lincvv/kicad_space/Projects/Design/nti/Pi-Zero_Relay/README.md

**Board with relay for Raspberry PI Zero. There is an installation place for the Arduino shield RS-485**

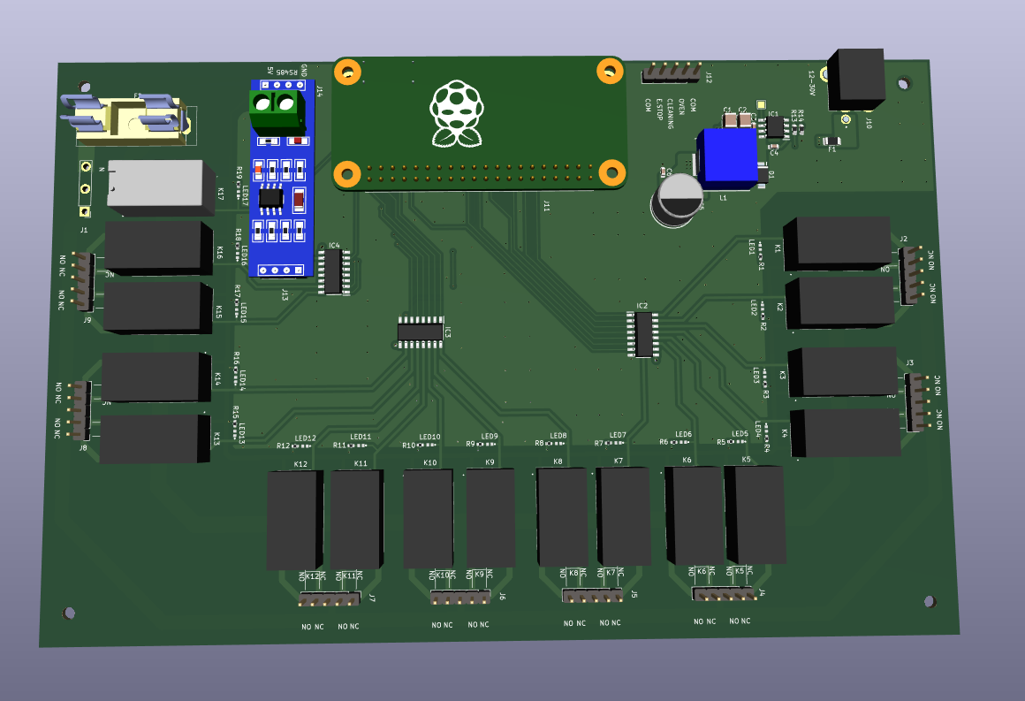
[picture p1: Projects/Design/nti/Pi-Zero_Relay/img/brd.bmp]
image info
