lincvv/kicad_space/Projects/Design/nti/dock_rs232/cfg_sel.png

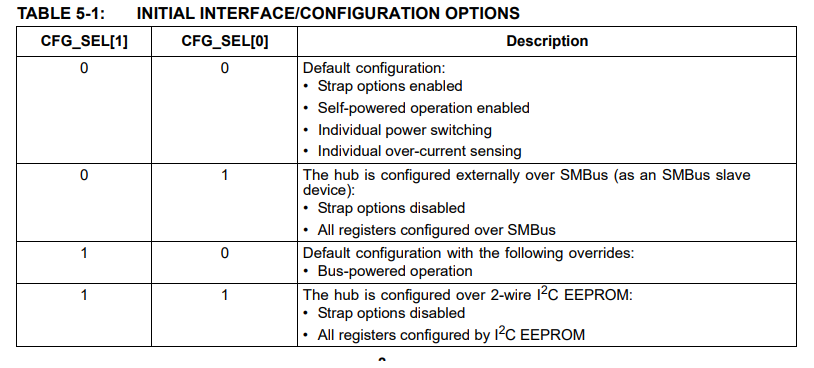
Projects/Design/nti/dock_rs232/cfg_sel.png
