lincvv/kicad_space/Projects/Design/nti/dock_rs232/3D/LAN9500AI-ABZJ.stp

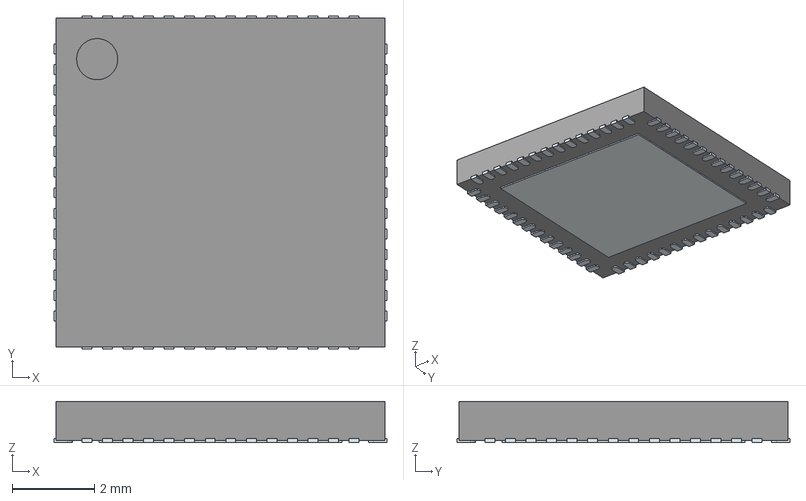
[picture p3: CAD file, 2024-06-23]
Projects/Design/nti/dock_rs232/3D/LAN9500AI-ABZJ.stp
8.10 x 8.10 x 1.00 mm
ThermalPin
PinsArrayLR
PinsArrayTB
