lincvv/kicad_space/Projects/Design/nti/dock_rs232/dock_rs232_v2.step

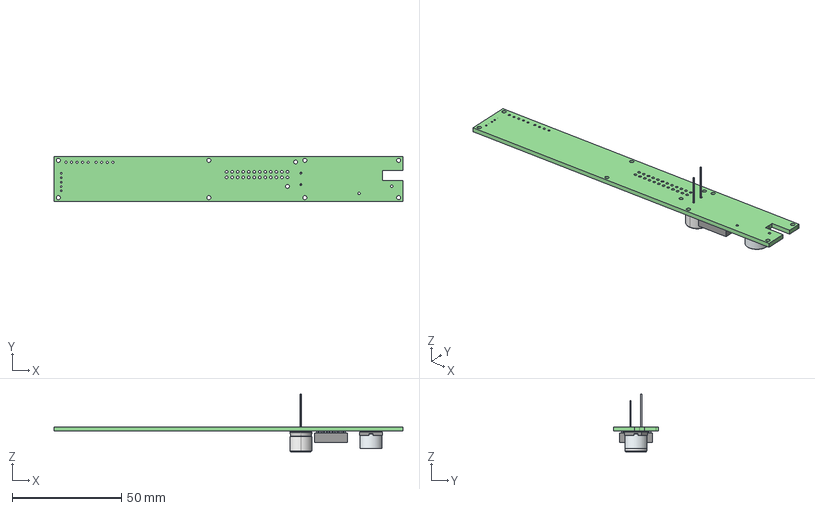
[picture p4: CAD file, 2024-06-23]
Projects/Design/nti/dock_rs232/dock_rs232_v2.step
160.0 x 20.7 x 26.5 mm
dock_rs232 PCB
