lincvv/kicad_space/Resources/lib_kicad/150R_0402_2-1879208-9/2-1879208-9 (# Name clash 2023-07-30 uy7o5mC #).step

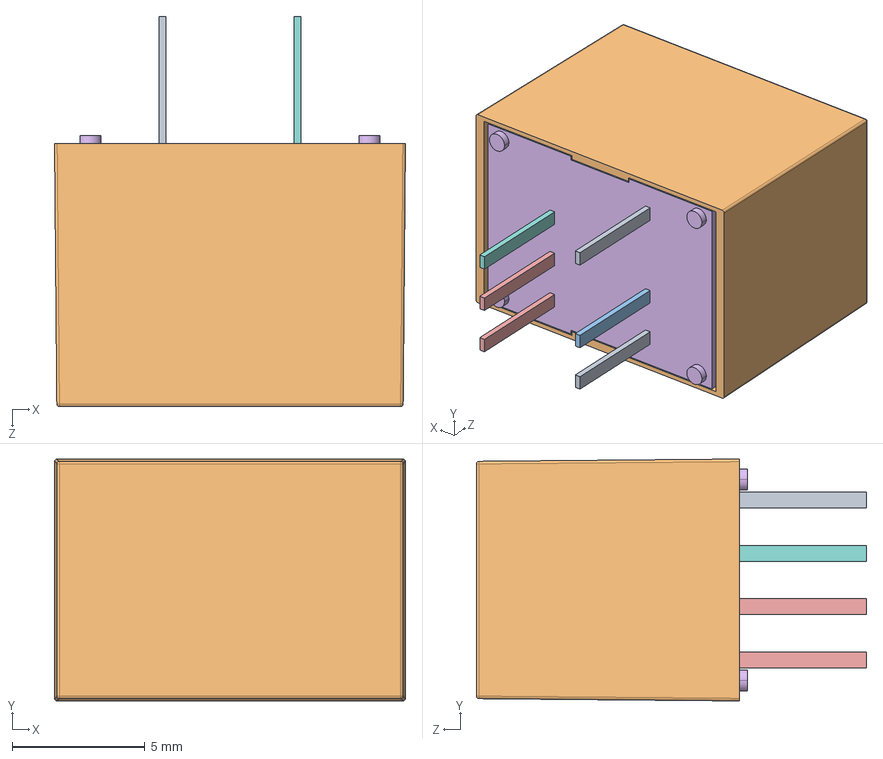
[picture p5: CAD file, 2024-06-23]
Resources/lib_kicad/150R_0402_2-1879208-9/2-1879208-9 (# Name clash 2023-07-30 uy7o5mC #).step
13.2 x 9.10 x 14.7 mm
