lincvv/kicad_space/Resources/lib_kicad/1K_0603_RP73PF1J1K0BTDF/RP73PF1J1K0BTDF (# Name clash 2023-07-30 4vshooC #).step

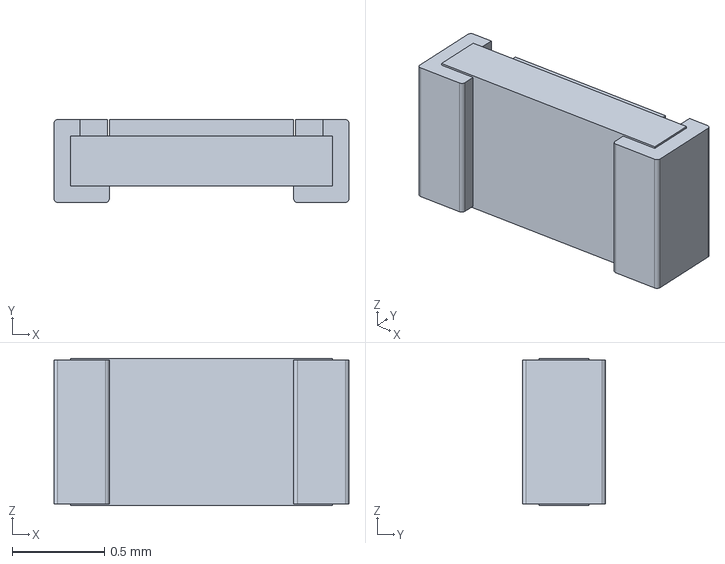
[picture p6: CAD file, 2024-06-23]
Resources/lib_kicad/1K_0603_RP73PF1J1K0BTDF/RP73PF1J1K0BTDF (# Name clash 2023-07-30 4vshooC #).step
1.60 x 0.45 x 0.8 mm
