lincvv/kicad_space/Resources/lib_kicad/3D/115864226-659-atmega328p-au/atmega328p-au (# Name clash 2023-07-30 7z2uxiC #).stp

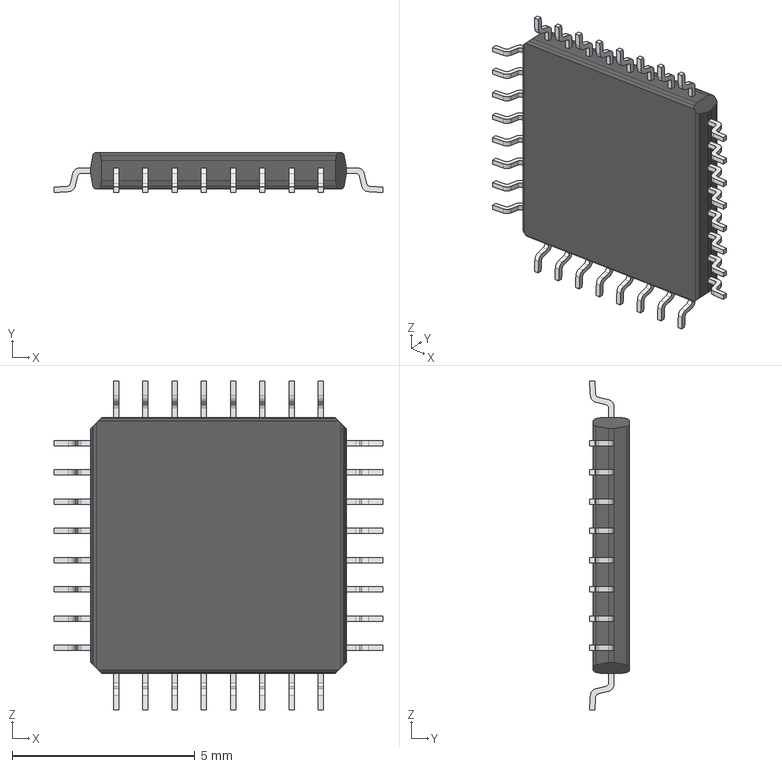
[picture p7: CAD file, 2024-06-23]
Resources/lib_kicad/3D/115864226-659-atmega328p-au/atmega328p-au (# Name clash 2023-07-30 7z2uxiC #).stp
9.00 x 1.10 x 9.00 mm
