lincvv/kicad_space/Resources/lib_kicad/3D/16MHz (# Name clash 2023-07-30 u8vxkbC #).STEP

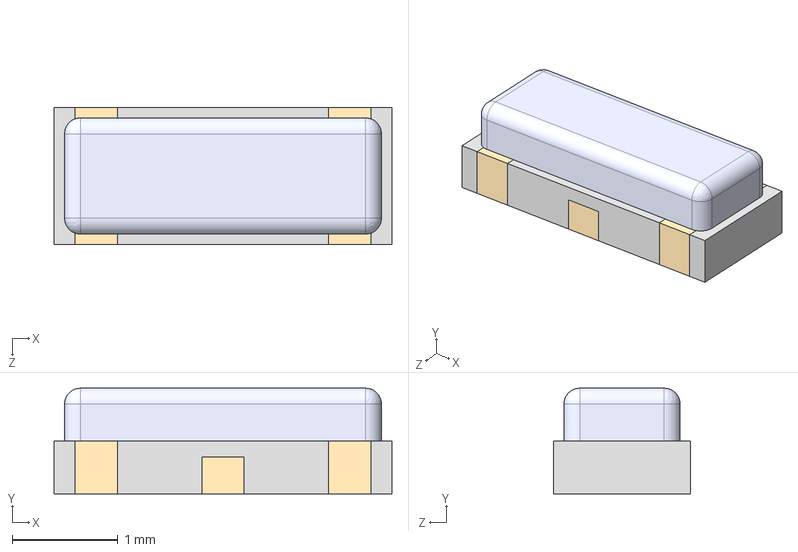
[picture p8: CAD file, 2024-06-23]
Resources/lib_kicad/3D/16MHz (# Name clash 2023-07-30 u8vxkbC #).STEP
3.20 x 1.00 x 1.30 mm
