lincvv/kicad_space/Resources/lib_kicad/3D/DC_POWER_CUI_DEVICES_PJ-079BH/CUI_DEVICES_PJ-079BH (# Name clash 2023-07-30 wrly1wC #).step

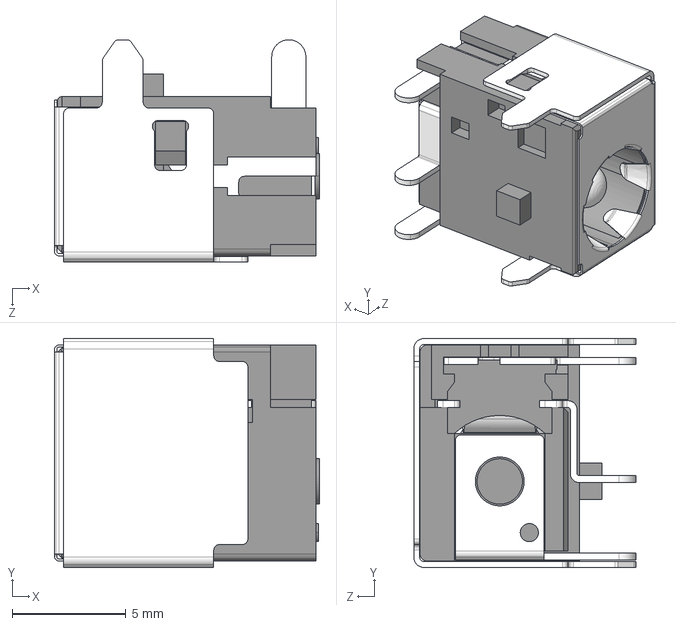
[picture p9: CAD file, 2024-06-23]
Resources/lib_kicad/3D/DC_POWER_CUI_DEVICES_PJ-079BH/CUI_DEVICES_PJ-079BH (# Name clash 2023-07-30 wrly1wC #).step
11.6 x 10.1 x 9.78 mm
