lincvv/kicad_space/Resources/lib_kicad/3D/ISP_6P/2-1761603-1 (# Name clash 2023-07-30 458dh9C #).stp

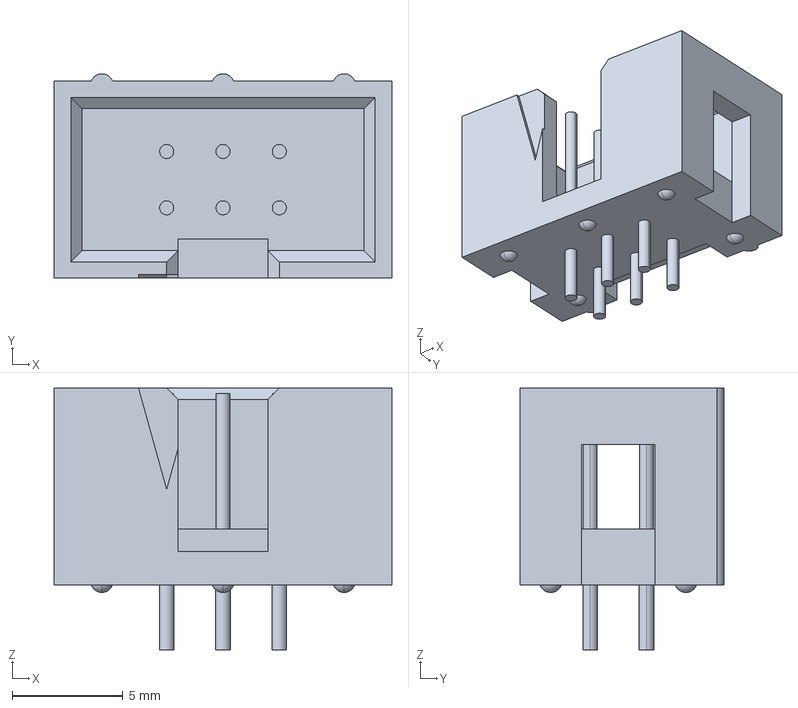
[picture p10: CAD file, 2024-06-23]
Resources/lib_kicad/3D/ISP_6P/2-1761603-1 (# Name clash 2023-07-30 458dh9C #).stp
15.2 x 9.22 x 11.8 mm
