lincvv/kicad_space/Resources/lib_kicad/62R_0402_RC0402FR-0762RL/RC0402FR-0762RL (# Name clash 2023-07-30 fygttrC #).step

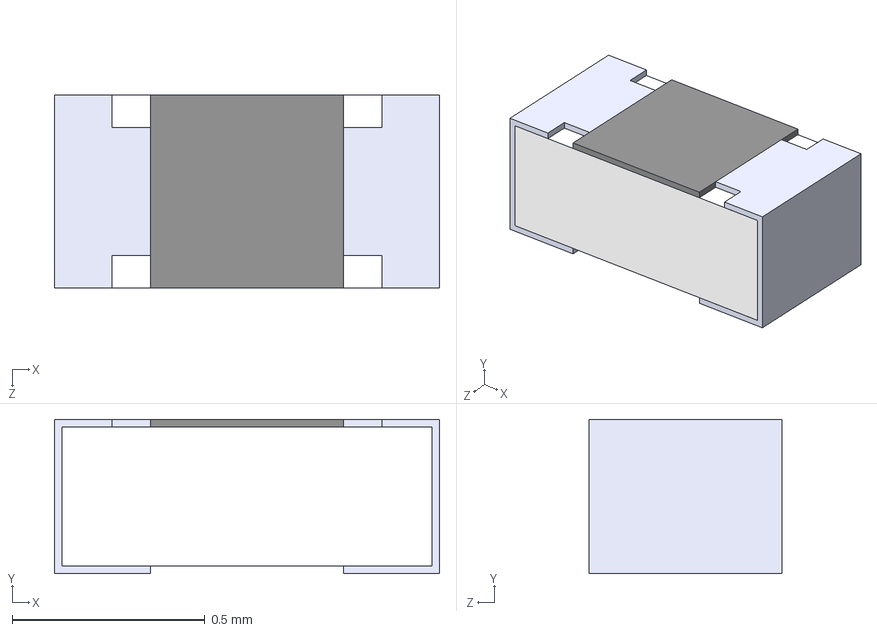
[picture p11: CAD file, 2024-06-23]
Resources/lib_kicad/62R_0402_RC0402FR-0762RL/RC0402FR-0762RL (# Name clash 2023-07-30 fygttrC #).step
1 x 0.4 x 0.5 mm
