lincvv/kicad_space/Resources/lib_kicad/FERRITE/FBead_Murata_BLM21PG221SN1D/eec.models/Murata_-_BLM21PG221SN1D (# Name clash 2023-07-30 t4pligC #).step

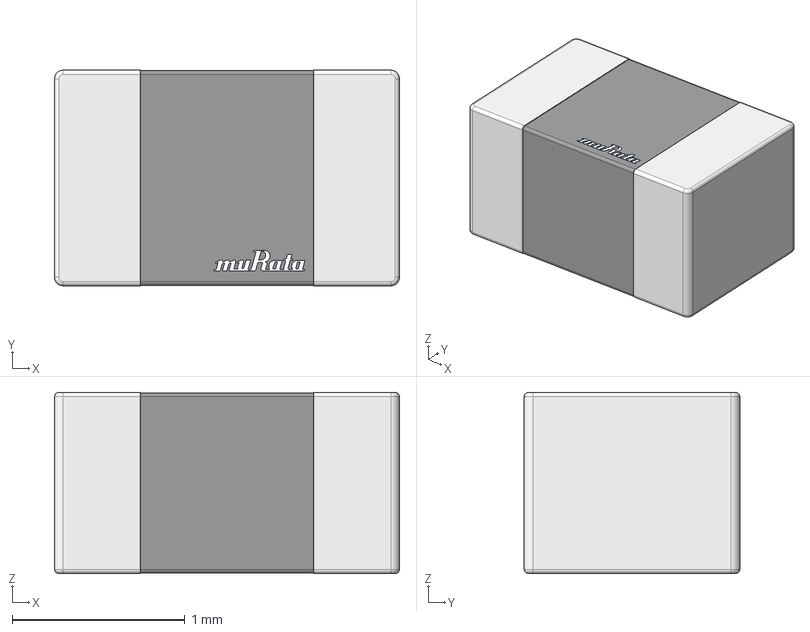
[picture p12: CAD file, 2024-06-23]
Resources/lib_kicad/FERRITE/FBead_Murata_BLM21PG221SN1D/eec.models/Murata_-_BLM21PG221SN1D (# Name clash 2023-07-30 t4pligC #).step
2.00 x 1.25 x 1.05 mm
Electrodes
Dielectric
Murata
