lincvv/kicad_space/Resources/lib_kicad/HJR-4102-L-05V/HJR-4102-L-05V (# Name clash 2023-07-30 9vtmwmC #).step

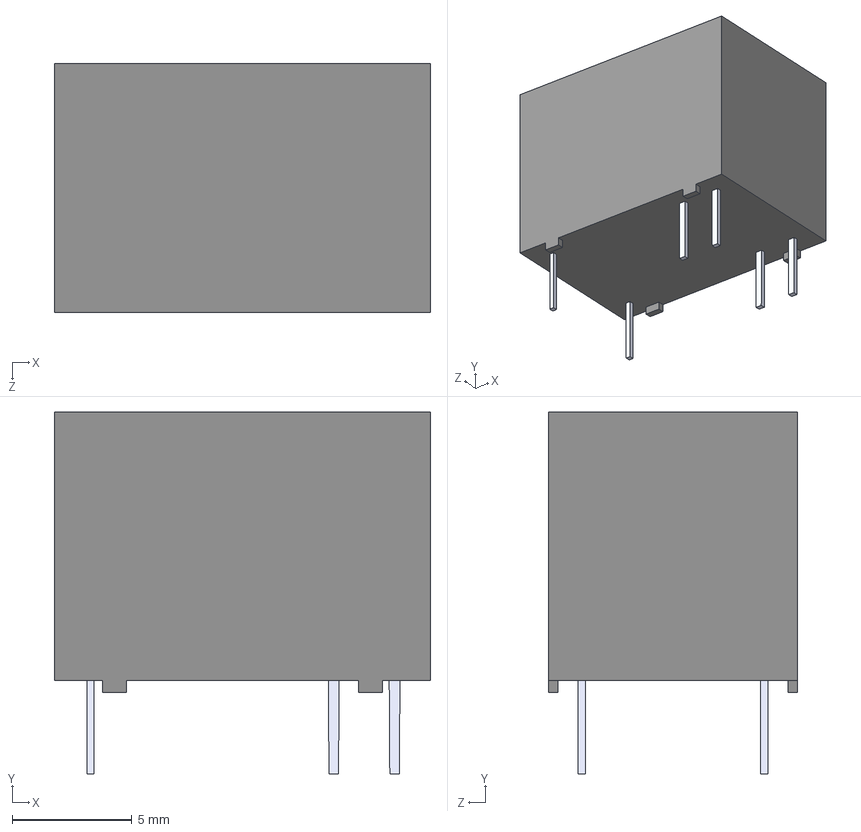
[picture p13: CAD file, 2024-06-23]
Resources/lib_kicad/HJR-4102-L-05V/HJR-4102-L-05V (# Name clash 2023-07-30 9vtmwmC #).step
15.7 x 15.1 x 10.4 mm
