lincvv/kicad_space/Resources/lib_kicad/LED/ul_IN-S42BT5G/LED_IN-S42_INL (# Name clash 2023-07-30 bcv8teC #).step

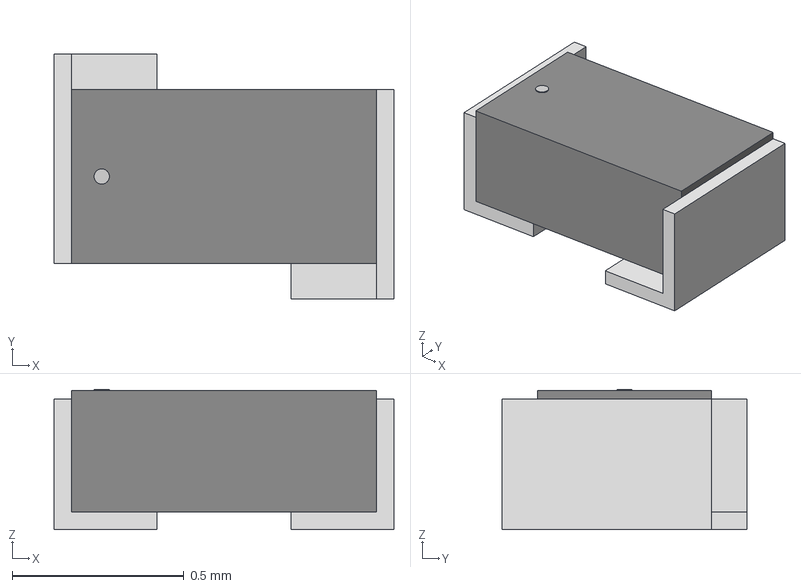
[picture p14: CAD file, 2024-06-23]
Resources/lib_kicad/LED/ul_IN-S42BT5G/LED_IN-S42_INL (# Name clash 2023-07-30 bcv8teC #).step
0.99 x 0.712 x 0.409 mm
