lincvv/kicad_space/Resources/lib_kicad/OSCIL/ABM8G-25.000MHZ-4Y-T3--3DModel-STEP-400430 (# Name clash 2023-07-30 odzbttC #).STEP

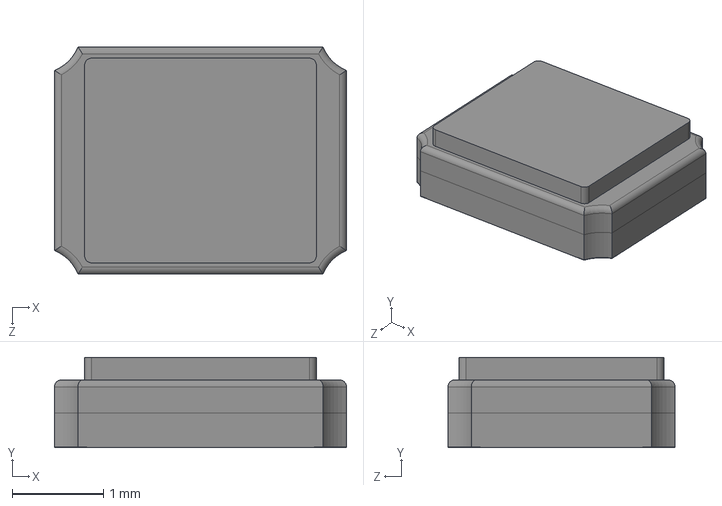
[picture p15: CAD file, 2024-06-23]
Resources/lib_kicad/OSCIL/ABM8G-25.000MHZ-4Y-T3--3DModel-STEP-400430 (# Name clash 2023-07-30 odzbttC #).STEP
3.20 x 0.991 x 2.49 mm
