lincvv/kicad_space/Resources/lib_kicad/RLS-126/RLS-126 (# Name clash 2023-07-30 chmixkC #).step

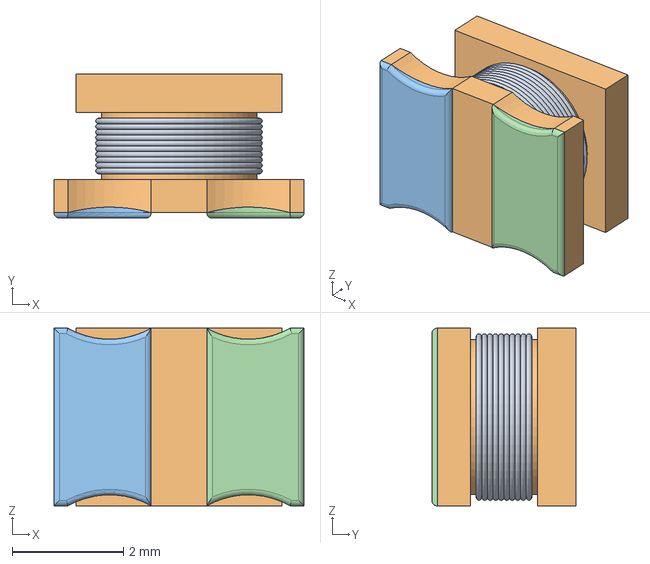
[picture p16: CAD file, 2024-06-23]
Resources/lib_kicad/RLS-126/RLS-126 (# Name clash 2023-07-30 chmixkC #).step
4.50 x 2.60 x 3.20 mm
