lincvv/kicad_space/Projects/Design/nti/dock_rs232/3D/EG1247.stp

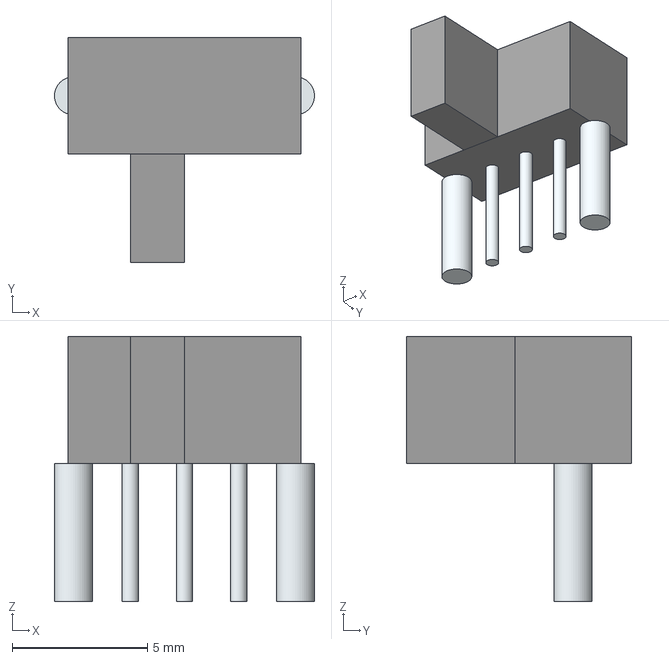
[picture p17: CAD file, 2024-06-23]
Projects/Design/nti/dock_rs232/3D/EG1247.stp
9.60 x 8.30 x 9.80 mm
Leads x 5
