lincvv/kicad_space/Projects/Design/nti/dock_rs232/dock_usb2.step

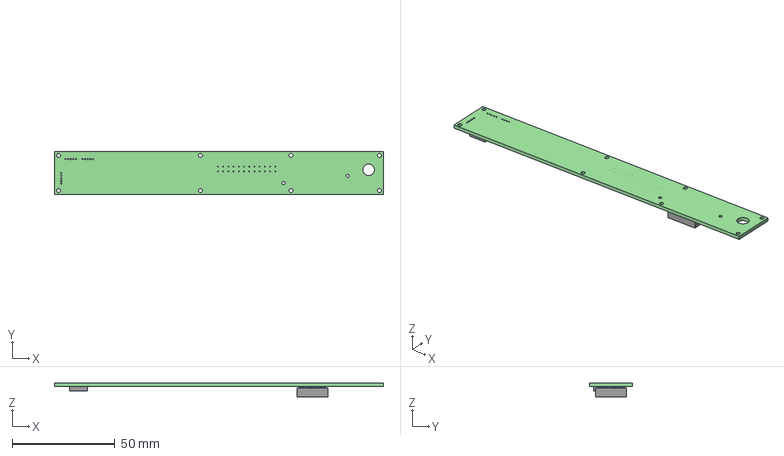
[picture p18: CAD file, 2024-06-23]
Projects/Design/nti/dock_rs232/dock_usb2.step
160.0 x 20.7 x 6.77 mm
dock_rs232 PCB
