lincvv/kicad_space/Projects/Design/nti/dock_rs232/3D/HX0068ANL.stp

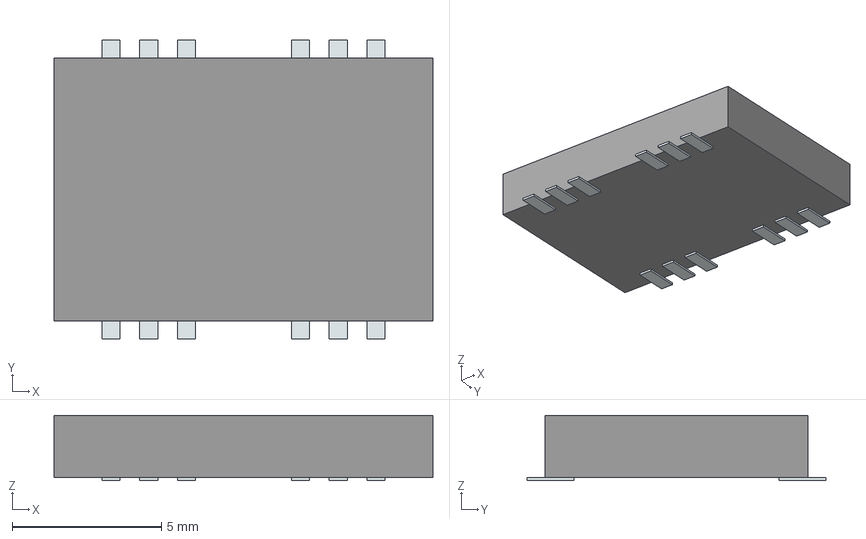
[picture p19: CAD file, 2024-06-23]
Projects/Design/nti/dock_rs232/3D/HX0068ANL.stp
12.7 x 10.0 x 2.18 mm
Pins
