lincvv/kicad_space/Projects/Design/nti/dock_rs232/dock_rs232.step

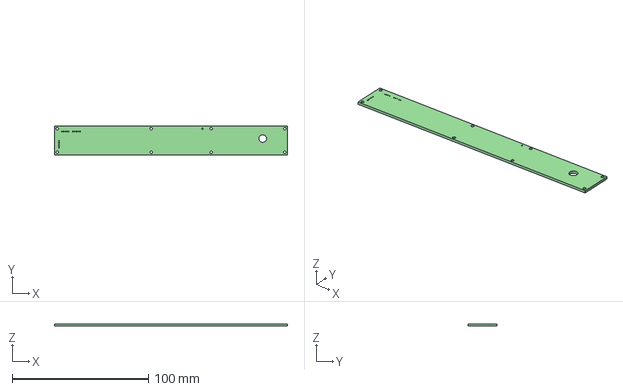
[picture p20: CAD file, 2024-06-23]
Projects/Design/nti/dock_rs232/dock_rs232.step
171.0 x 21.0 x 1.60 mm
