lincvv/kicad_space/Resources/lib_kicad/3D/C_1206_22uF (# Name clash 2023-07-30 kaz8xrC #).STEP

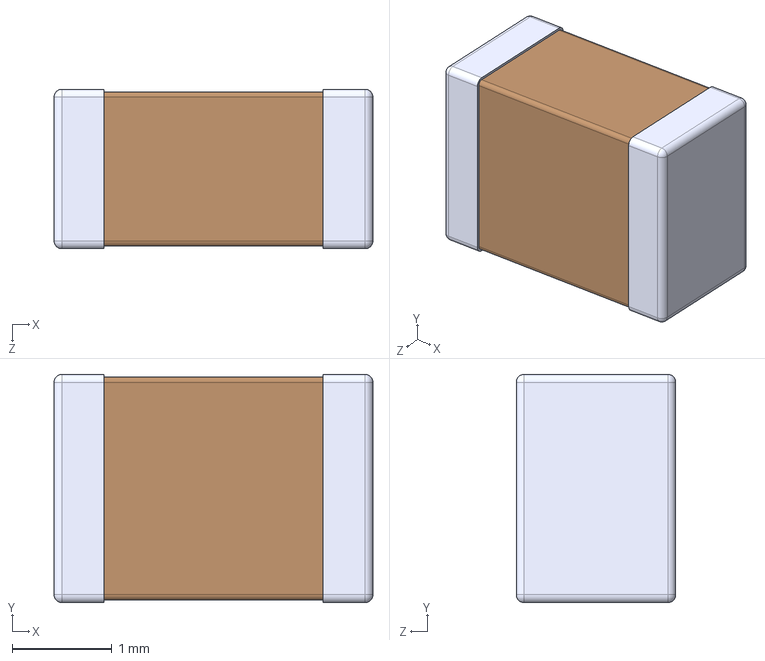
[picture p21: CAD file, 2024-06-23]
Resources/lib_kicad/3D/C_1206_22uF (# Name clash 2023-07-30 kaz8xrC #).STEP
3.20 x 2.29 x 1.60 mm
