lincvv/kicad_space/Projects/Design/nti/dock_rs232/3D/ECMF02-2AMX6.stp

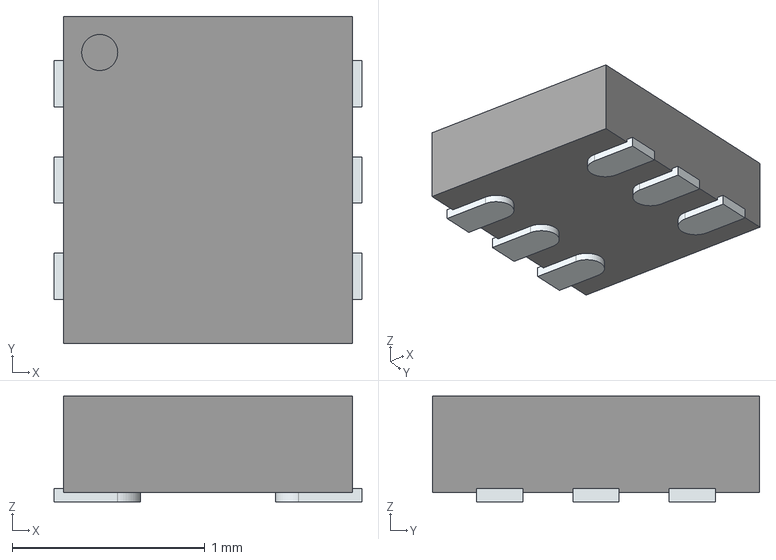
[picture p22: CAD file, 2024-06-23]
Projects/Design/nti/dock_rs232/3D/ECMF02-2AMX6.stp
1.60 x 1.70 x 0.55 mm
PinsArrayLR
