lincvv/kicad_space/Projects/Design/nti/dock_rs232/dock_rs232_fix.step

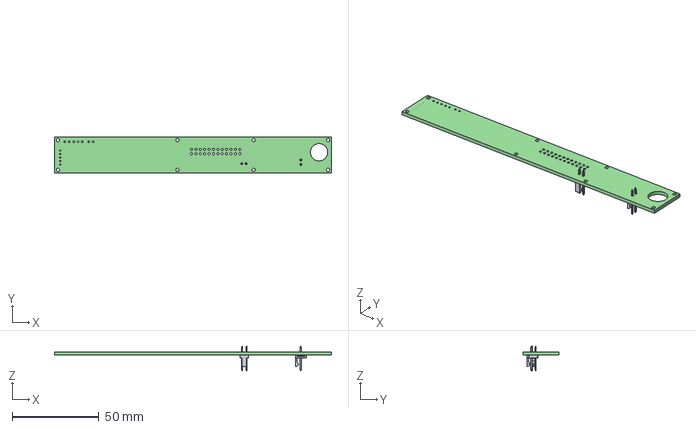
[picture p23: CAD file, 2024-06-23]
Projects/Design/nti/dock_rs232/dock_rs232_fix.step
160.0 x 20.7 x 14.2 mm
dock_rs232 PCB
