lincvv/kicad_space/Resources/lib_kicad/3D/10pF_+-1%_0603N100F101CT (# Name clash 2023-07-30 6atzm4C #).stp

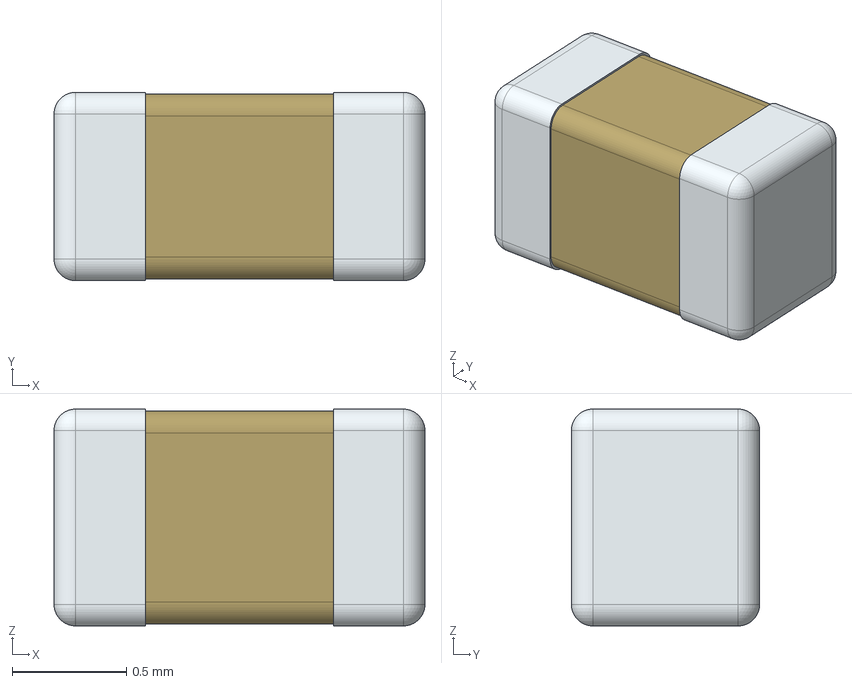
[picture p24: CAD file, 2024-06-23]
Resources/lib_kicad/3D/10pF_+-1%_0603N100F101CT (# Name clash 2023-07-30 6atzm4C #).stp
1.62 x 0.825 x 0.95 mm
