lincvv/kicad_space/Projects/Design/nti/dock_rs232/3D/CP2102N-A02-GQFN20.stp

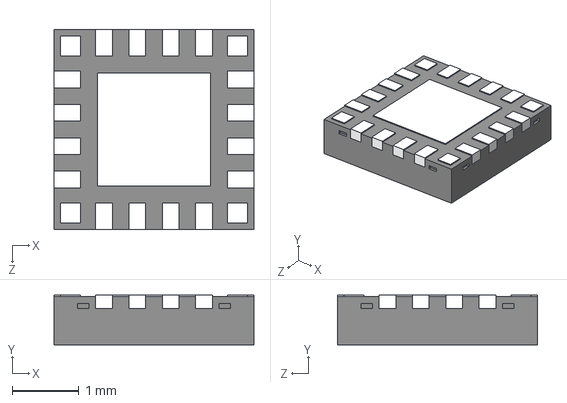
[picture p25: CAD file, 2024-06-23]
Projects/Design/nti/dock_rs232/3D/CP2102N-A02-GQFN20.stp
3.00 x 0.75 x 3.00 mm
