lincvv/kicad_space/Resources/lib_kicad/3D/ADUM1311ARWZ (# Name clash 2023-07-30 m2vc11C #).stp

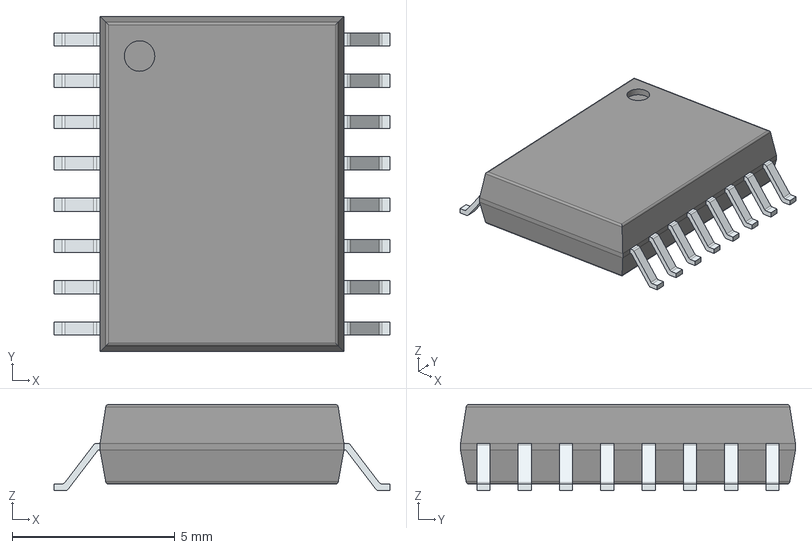
[picture p26: CAD file, 2024-06-23]
Resources/lib_kicad/3D/ADUM1311ARWZ (# Name clash 2023-07-30 m2vc11C #).stp
10.3 x 10.3 x 2.65 mm
PinsArrayLR
