lincvv/kicad_space/Projects/Design/nti/dock_rs232/3D/AP3441SHE-7B.stp

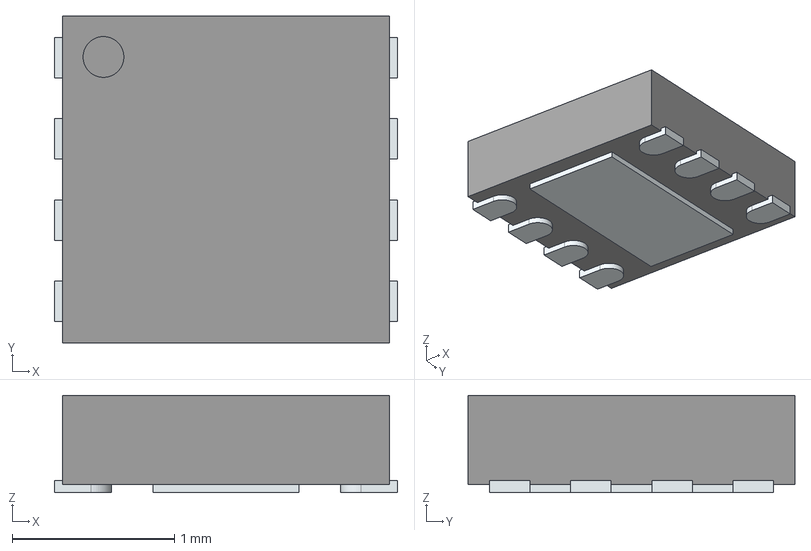
[picture p27: CAD file, 2024-06-23]
Projects/Design/nti/dock_rs232/3D/AP3441SHE-7B.stp
2.11 x 2.01 x 0.6 mm
ThermalPin
PinsArrayLR
