lincvv/kicad_space/Resources/lib_kicad/3D/10pF_+-0.25_CL10C100CB8NNNC (# Name clash 2023-07-30 huij25C #).stp

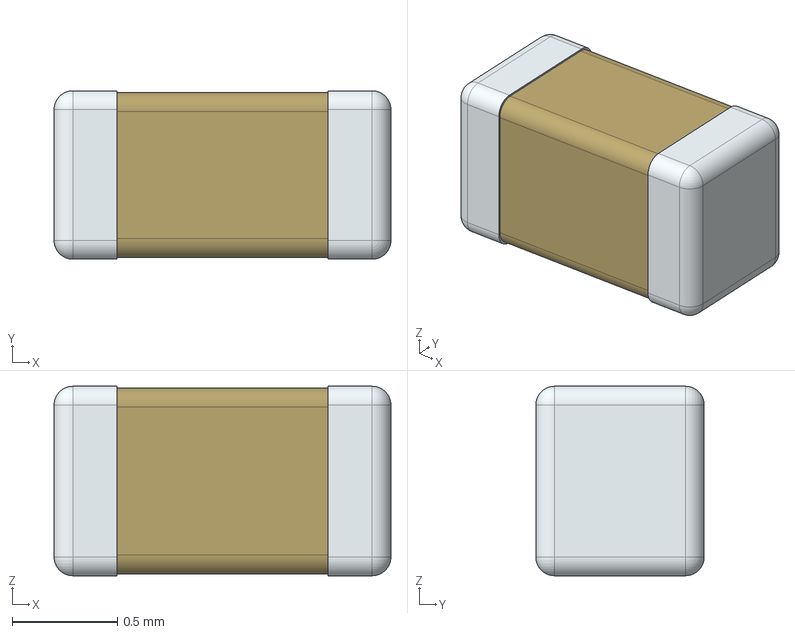
[picture p28: CAD file, 2024-06-23]
Resources/lib_kicad/3D/10pF_+-0.25_CL10C100CB8NNNC (# Name clash 2023-07-30 huij25C #).stp
1.60 x 0.8 x 0.9 mm
