lincvv/kicad_space/Projects/Design/nti/dock_rs232/3D/USB2514B_M2.stp

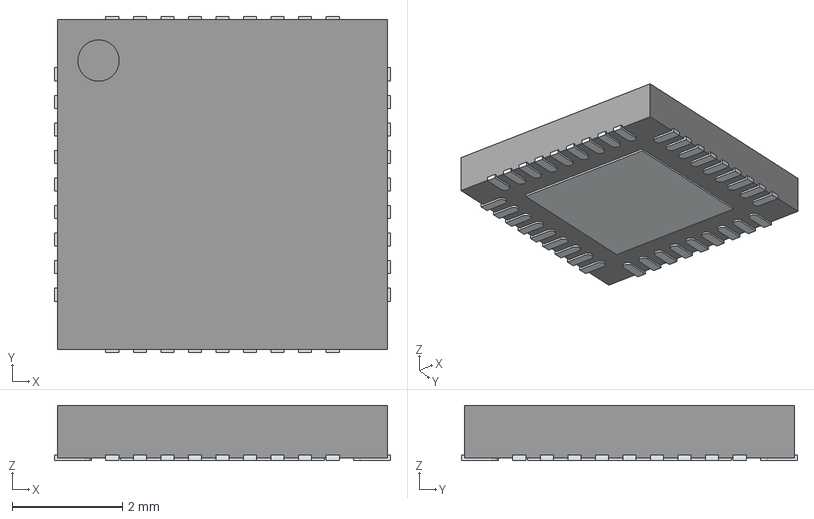
[picture p29: CAD file, 2024-06-23]
Projects/Design/nti/dock_rs232/3D/USB2514B_M2.stp
6.10 x 6.10 x 1.00 mm
ThermalPin
PinsArrayLR
PinsArrayTB
