lincvv/kicad_space/Resources/lib_kicad/3D/ENC28J60_SS (# Name clash 2023-07-30 c231e3C #).stp

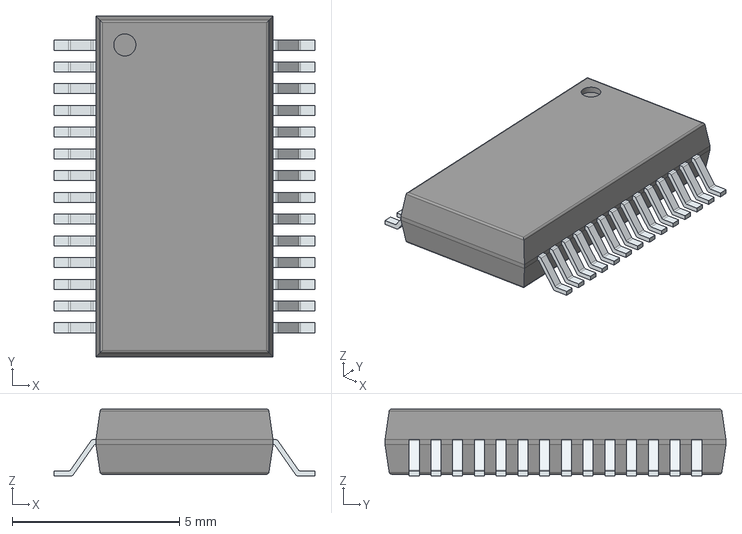
[picture p30: CAD file, 2024-06-23]
Resources/lib_kicad/3D/ENC28J60_SS (# Name clash 2023-07-30 c231e3C #).stp
7.80 x 10.2 x 2.00 mm
PinsArrayLR
