lincvv/kicad_space/Projects/Design/nti/dock_rs232/3D/XF2M-5015-1A.stp

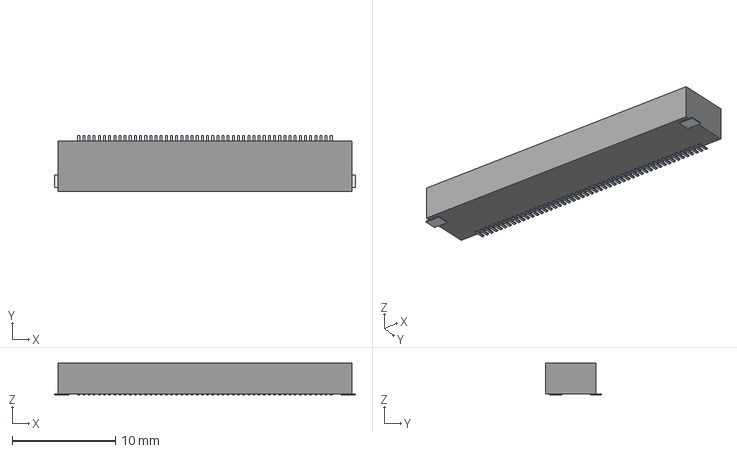
[picture p31: CAD file, 2024-06-23]
Projects/Design/nti/dock_rs232/3D/XF2M-5015-1A.stp
29.2 x 5.41 x 3.10 mm
Pins
