lincvv/kicad_space/Resources/lib_kicad/3D/RJ45_HR911105A (# Name clash 2023-07-30 cutkd2C #).stp

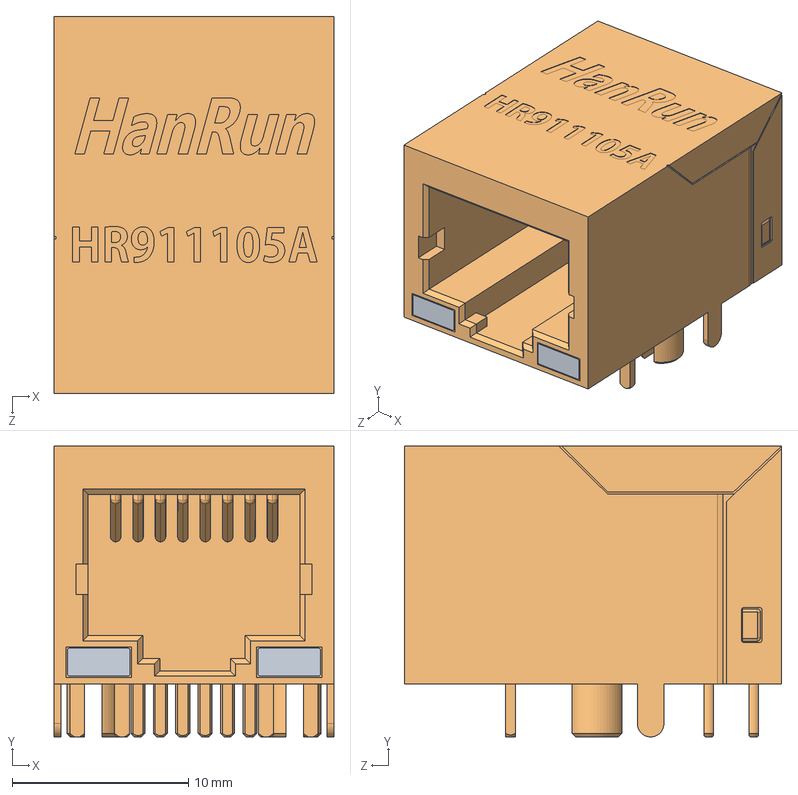
[picture p32: CAD file, 2024-06-23]
Resources/lib_kicad/3D/RJ45_HR911105A (# Name clash 2023-07-30 cutkd2C #).stp
15.9 x 16.5 x 21.4 mm
