lincvv/kicad_space/Projects/Design/nti/dock_rs232/3D/FFC2B29-50-G.stp

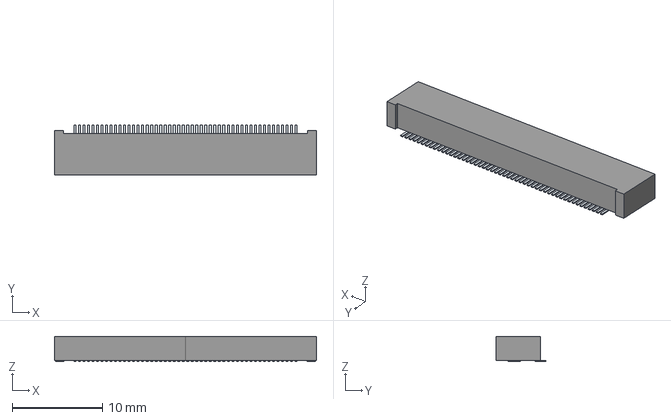
[picture p33: CAD file, 2024-06-23]
Projects/Design/nti/dock_rs232/3D/FFC2B29-50-G.stp
29.1 x 5.52 x 2.80 mm
Pins
