lincvv/kicad_space/Resources/lib_kicad/3D/10pF_0402_GCQ1555C1H100FB01D (# Name clash 2023-07-30 53fqluC #).stp

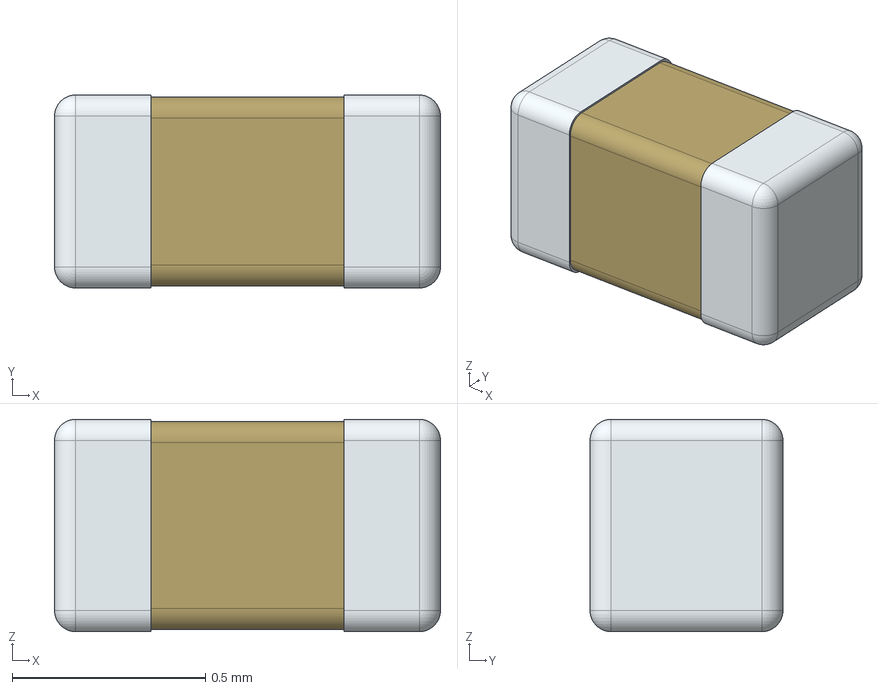
[picture p34: CAD file, 2024-06-23]
Resources/lib_kicad/3D/10pF_0402_GCQ1555C1H100FB01D (# Name clash 2023-07-30 53fqluC #).stp
1.00 x 0.5 x 0.55 mm
