lincvv/kicad_space/Resources/lib_kicad/3D/ADUM5241ARZ (# Name clash 2023-07-30 sx27uvC #).stp

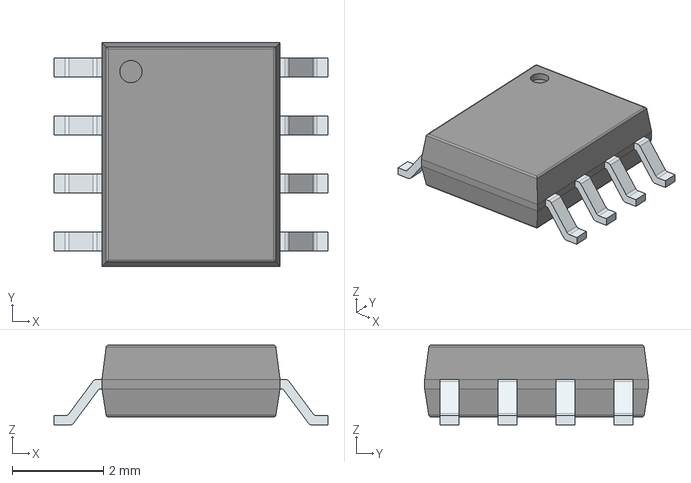
[picture p35: CAD file, 2024-06-23]
Resources/lib_kicad/3D/ADUM5241ARZ (# Name clash 2023-07-30 sx27uvC #).stp
6.00 x 4.90 x 1.75 mm
PinsArrayLR
