lincvv/kicad_space/Resources/lib_kicad/3D/L_1812 (# Name clash 2023-07-30 ckcu9pC #).STEP

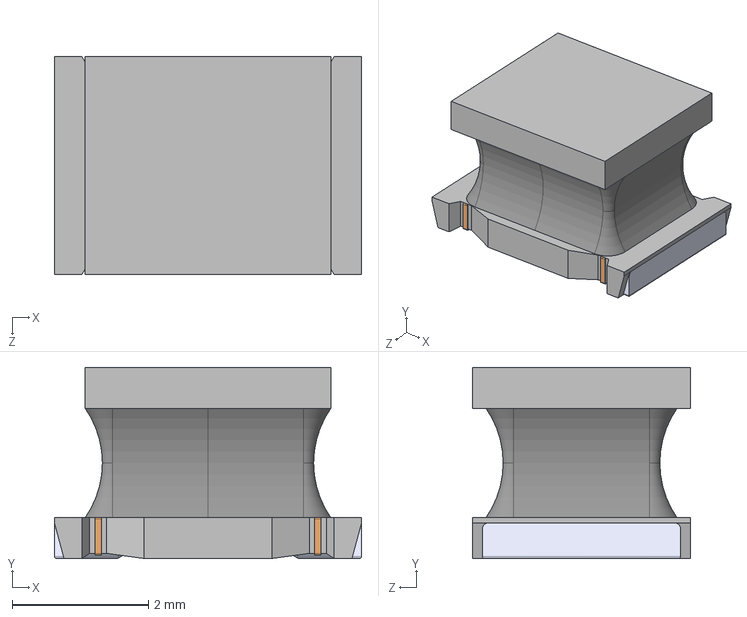
[picture p36: CAD file, 2024-06-23]
Resources/lib_kicad/3D/L_1812 (# Name clash 2023-07-30 ckcu9pC #).STEP
4.50 x 2.80 x 3.20 mm
