lincvv/kicad_space/Resources/lib_kicad/3D/10uF_1206 (# Name clash 2023-07-30 c13143C #).STEP

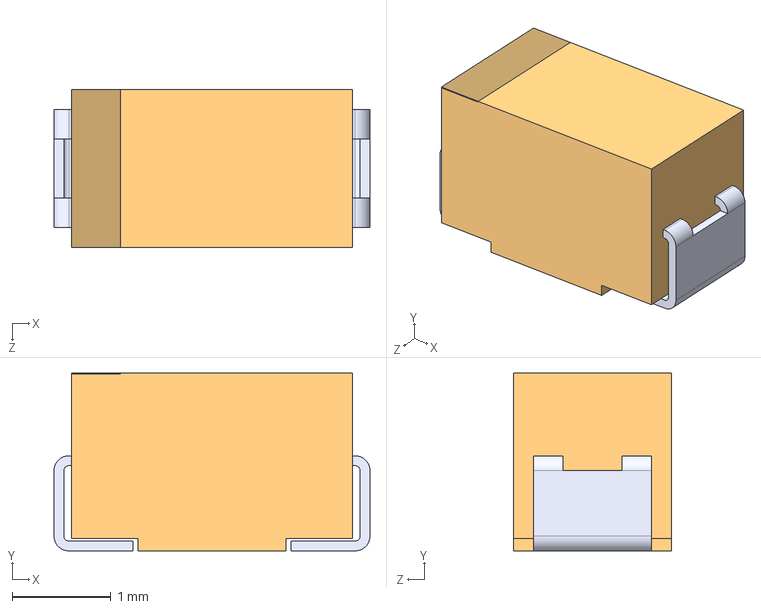
[picture p37: CAD file, 2024-06-23]
Resources/lib_kicad/3D/10uF_1206 (# Name clash 2023-07-30 c13143C #).STEP
3.20 x 1.80 x 1.60 mm
