lincvv/kicad_space/Resources/lib_kicad/3D/LM1086IS-5.0 (# Name clash 2023-07-30 idh75aC #).STEP

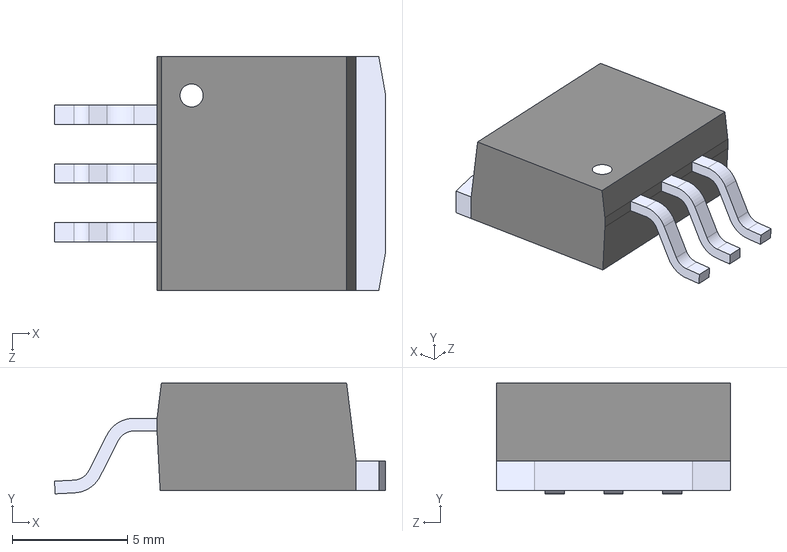
[picture p38: CAD file, 2024-06-23]
Resources/lib_kicad/3D/LM1086IS-5.0 (# Name clash 2023-07-30 idh75aC #).STEP
14.4 x 4.80 x 10.2 mm
