lincvv/kicad_space/Resources/lib_kicad/3D/25MHZ_ABM8G-25.000MHZ-B4Y-T (# Name clash 2023-07-30 5p8k1hC #).stp

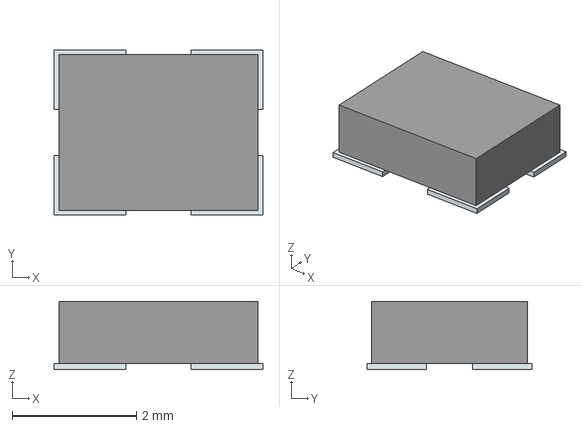
[picture p39: CAD file, 2024-06-23]
Resources/lib_kicad/3D/25MHZ_ABM8G-25.000MHZ-B4Y-T (# Name clash 2023-07-30 5p8k1hC #).stp
3.36 x 2.66 x 1.10 mm
Pins
