lincvv/kicad_space/Resources/lib_kicad/3D/10uF_25V_tantal (# Name clash 2023-07-30 8dxuweC #).STEP

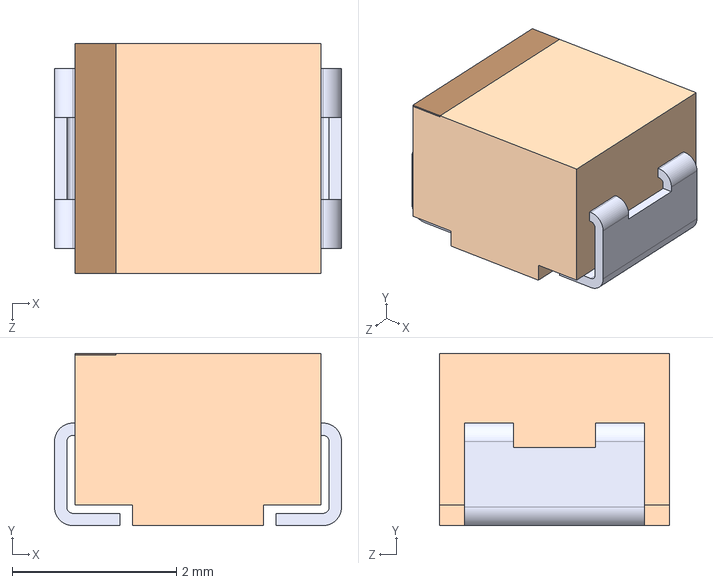
[picture p40: CAD file, 2024-06-23]
Resources/lib_kicad/3D/10uF_25V_tantal (# Name clash 2023-07-30 8dxuweC #).STEP
3.50 x 2.10 x 2.80 mm
