lincvv/kicad_space/Resources/lib_kicad/3D/R2_0805 (# Name clash 2023-07-30 clio78C #).STEP

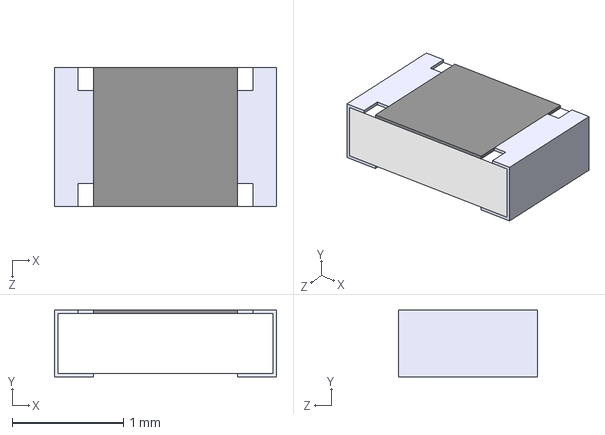
[picture p41: CAD file, 2024-06-23]
Resources/lib_kicad/3D/R2_0805 (# Name clash 2023-07-30 clio78C #).STEP
2.00 x 0.6 x 1.25 mm
