lincvv/kicad_space/Resources/lib_kicad/3D/C_0805 (# Name clash 2023-07-30 3z65rbC #).STEP

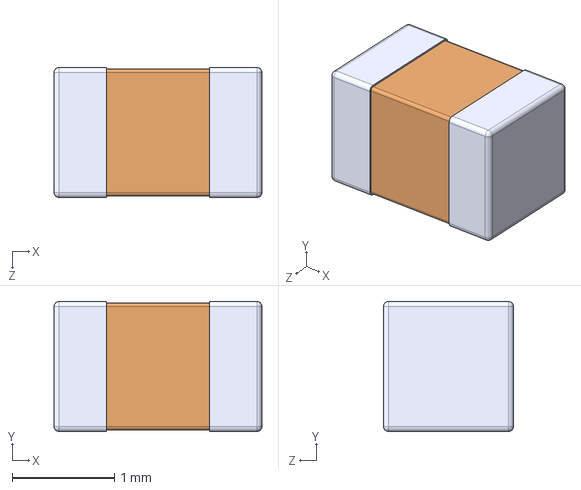
[picture p42: CAD file, 2024-06-23]
Resources/lib_kicad/3D/C_0805 (# Name clash 2023-07-30 3z65rbC #).STEP
2.03 x 1.27 x 1.27 mm
