lincvv/kicad_space/Resources/lib_kicad/3D/Optoisolator_PC81713NIP0X (# Name clash 2023-07-30 beo58lC #).STEP

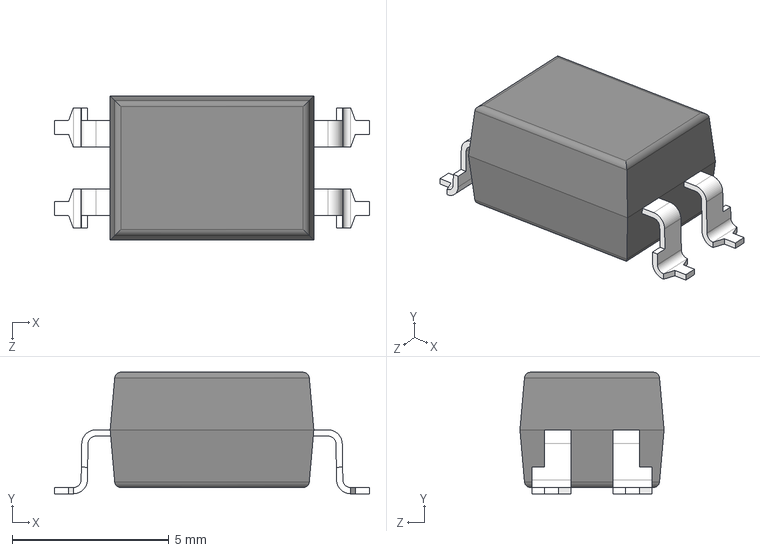
[picture p43: CAD file, 2024-06-23]
Resources/lib_kicad/3D/Optoisolator_PC81713NIP0X (# Name clash 2023-07-30 beo58lC #).STEP
10.1 x 3.88 x 4.60 mm
