lincvv/kicad_space/Resources/lib_kicad/3D/100nF_0402 (# Name clash 2023-07-30 k8wrhxC #).STEP

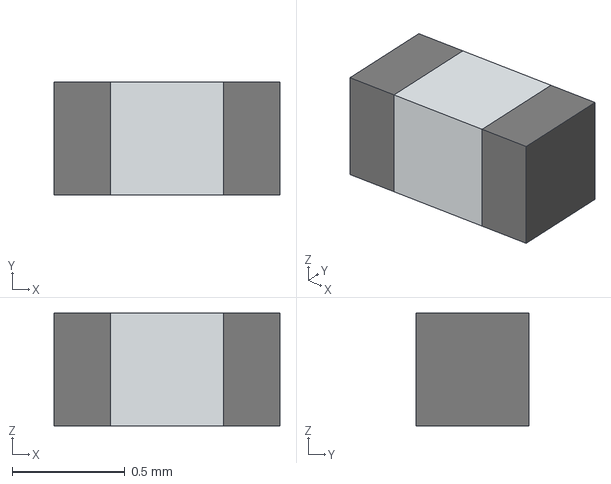
[picture p44: CAD file, 2024-06-23]
Resources/lib_kicad/3D/100nF_0402 (# Name clash 2023-07-30 k8wrhxC #).STEP
1.00 x 0.5 x 0.5 mm
Body_1.0x0.5x0.5x0.25
Contact_0.5x0.5x0.25 x 2
