lincvv/kicad_space/Resources/lib_kicad/3D/LED_0603--3DModel-STEP-56544 (# Name clash 2023-07-30 e95iosC #).STEP

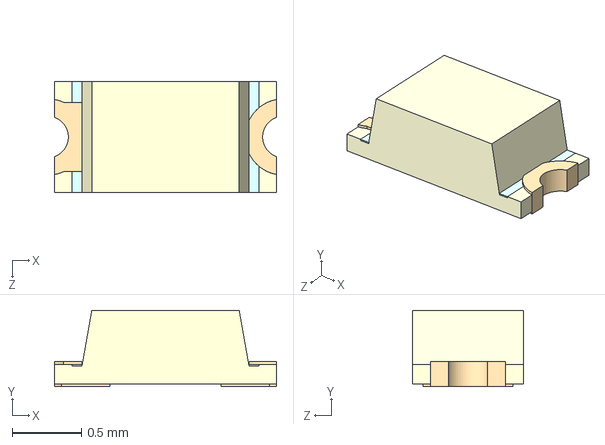
[picture p45: CAD file, 2024-06-23]
Resources/lib_kicad/3D/LED_0603--3DModel-STEP-56544 (# Name clash 2023-07-30 e95iosC #).STEP
1.60 x 0.55 x 0.8 mm
