lincvv/kicad_space/Resources/lib_kicad/3D/L_3131 (# Name clash 2023-07-30 mwrzmkC #).STEP

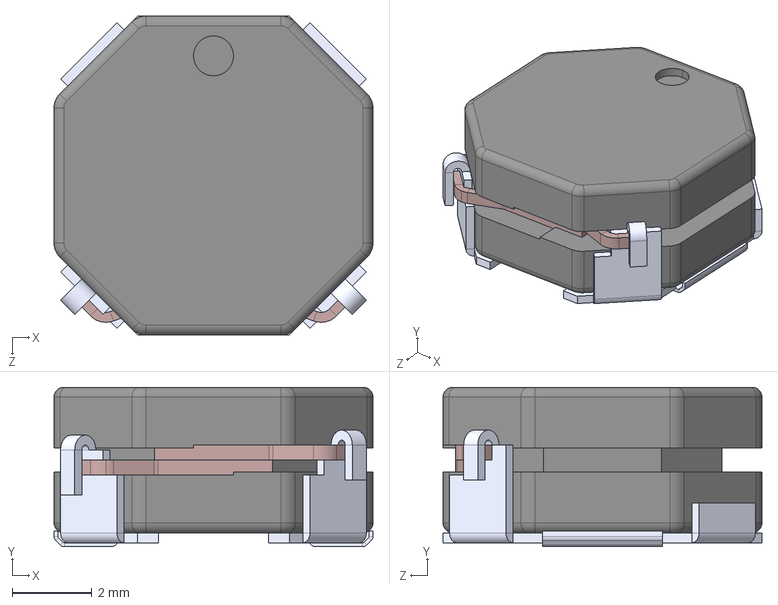
[picture p46: CAD file, 2024-06-23]
Resources/lib_kicad/3D/L_3131 (# Name clash 2023-07-30 mwrzmkC #).STEP
8.00 x 4.00 x 8.00 mm
