lincvv/kicad_space/Resources/lib_kicad/3D/R1SE-0505-R (# Name clash 2023-07-30 m4vhj5C #).STEP

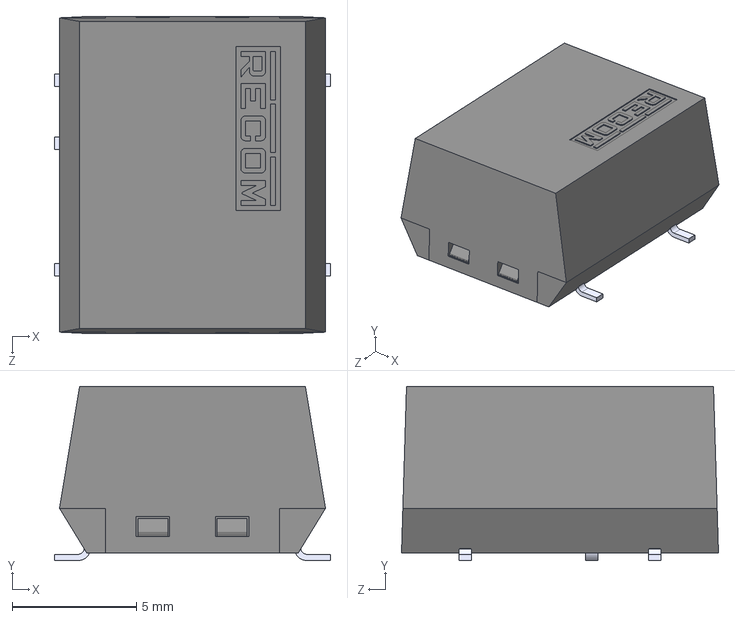
[picture p47: CAD file, 2024-06-23]
Resources/lib_kicad/3D/R1SE-0505-R (# Name clash 2023-07-30 m4vhj5C #).STEP
11.1 x 7.00 x 12.8 mm
