lincvv/kicad_space/Resources/lib_kicad/3D/FTSH-105-01-F-DV-K-A-TR (# Name clash 2023-07-30 jrbe6kC #).stp

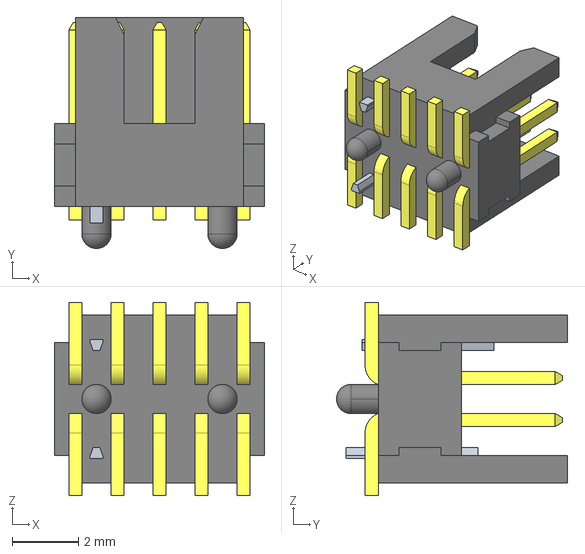
[picture p48: CAD file, 2024-06-23]
Resources/lib_kicad/3D/FTSH-105-01-F-DV-K-A-TR (# Name clash 2023-07-30 jrbe6kC #).stp
6.35 x 6.98 x 5.84 mm
