lincvv/kicad_space/Resources/lib_kicad/3D/MAX485ESA (# Name clash 2023-07-30 55kb8pC #).STEP

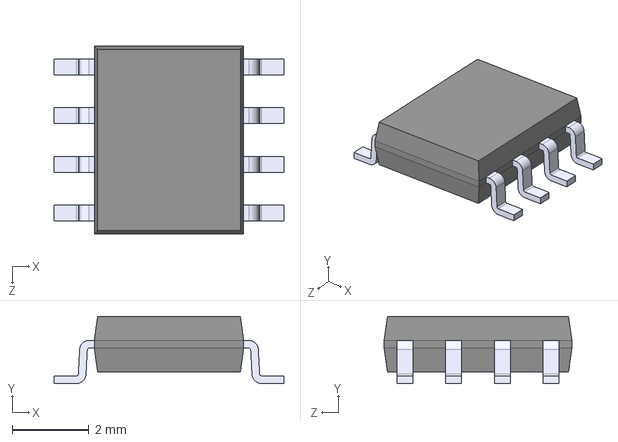
[picture p49: CAD file, 2024-06-23]
Resources/lib_kicad/3D/MAX485ESA (# Name clash 2023-07-30 55kb8pC #).STEP
6.00 x 1.75 x 4.90 mm
