lincvv/kicad_space/Resources/lib_kicad/3D/10pF_50V_GQM1885C1H100RB01D (# Name clash 2023-07-30 hl0d0eC #).STEP

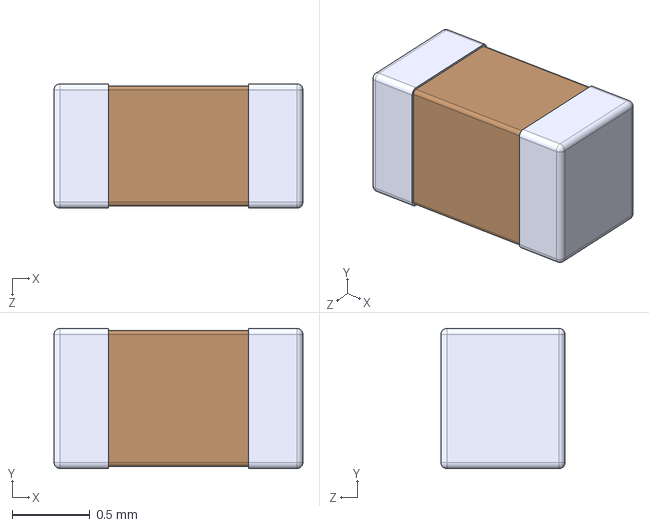
[picture p50: CAD file, 2024-06-23]
Resources/lib_kicad/3D/10pF_50V_GQM1885C1H100RB01D (# Name clash 2023-07-30 hl0d0eC #).STEP
1.60 x 0.9 x 0.8 mm
