lincvv/kicad_space/(list of files, cad)

Other CAD files:
Resources/lib_kicad/3D/RJE601885401T--3DModel-STEP-533217 (# Name clash 2023-07-30 bf1rx4C #).STEP
Resources/lib_kicad/3D/R_0805/1676371-2 (# Name clash 2023-07-30 ao7tsyC #).stp
Resources/lib_kicad/3D/SW_2P/147873-1 (# Name clash 2023-07-30 5tdch4C #).stp
Resources/lib_kicad/3D/terminal_2P/691210910002 (# Name clash 2023-07-30 d97wnkC #).stp
