lincvv/kicad_space/Projects/Design/nti/dock_rs232/Board2Pdf/dock_rs232-Assembly.pdf

1 | 2 | 3 | 4 | 5 | 6 | 7 | 8 | 9 | 10 | 11

A

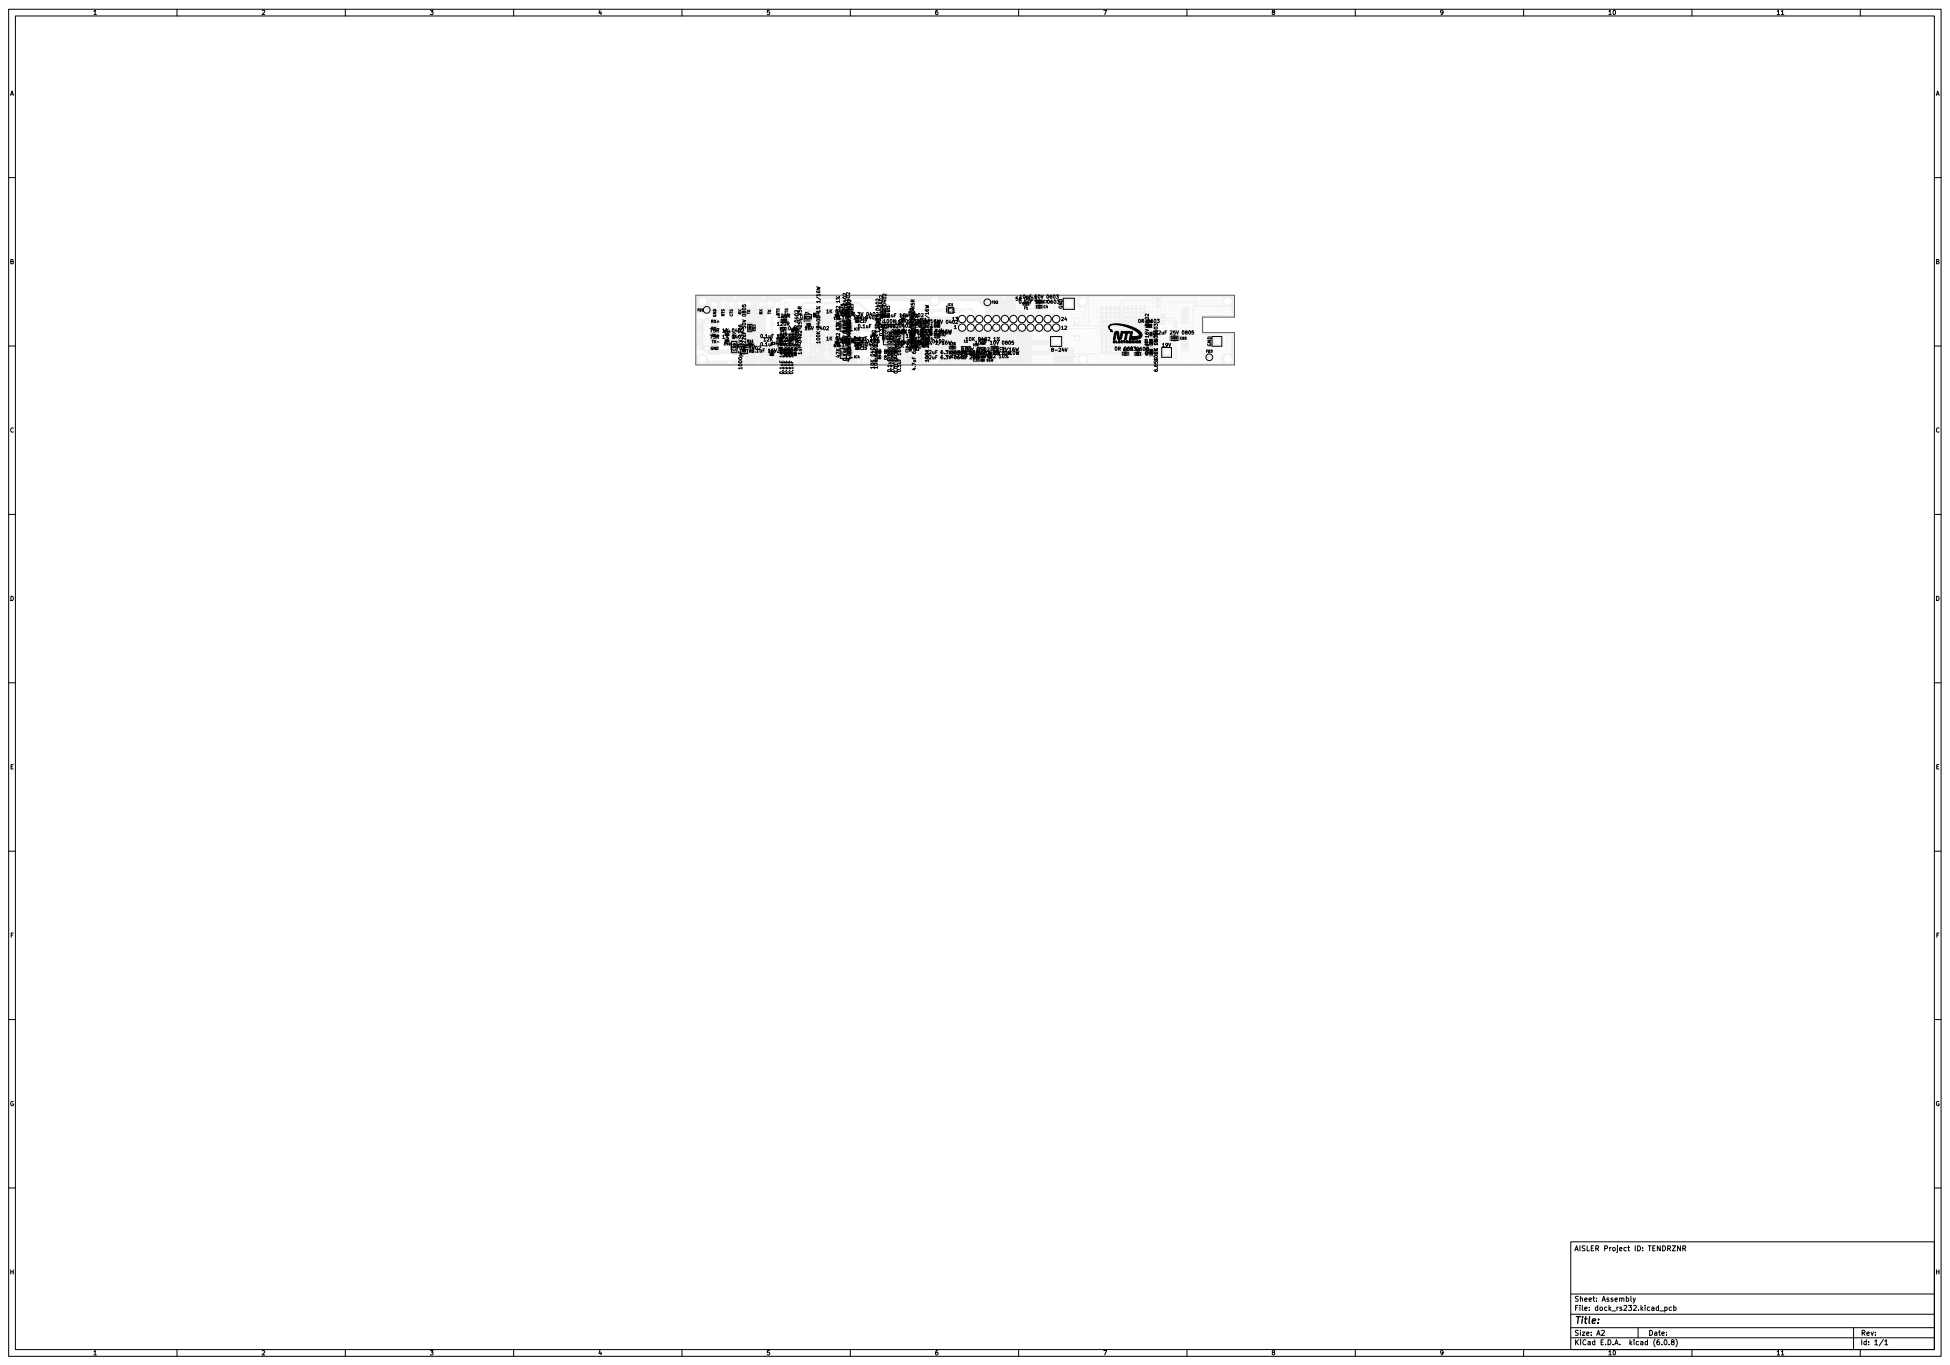
[picture p51: page 1]

C5 100K ⁰⁴⁰² ¹% ¹/16W R⁸ 0.1uF 16V ⁰⁴⁰² C⁸ 4.7uF 6.3V 0402

1 | 2 | 3 | 4 | 5 | 6 | 7 | 8 | 9 | 10 | 11

A

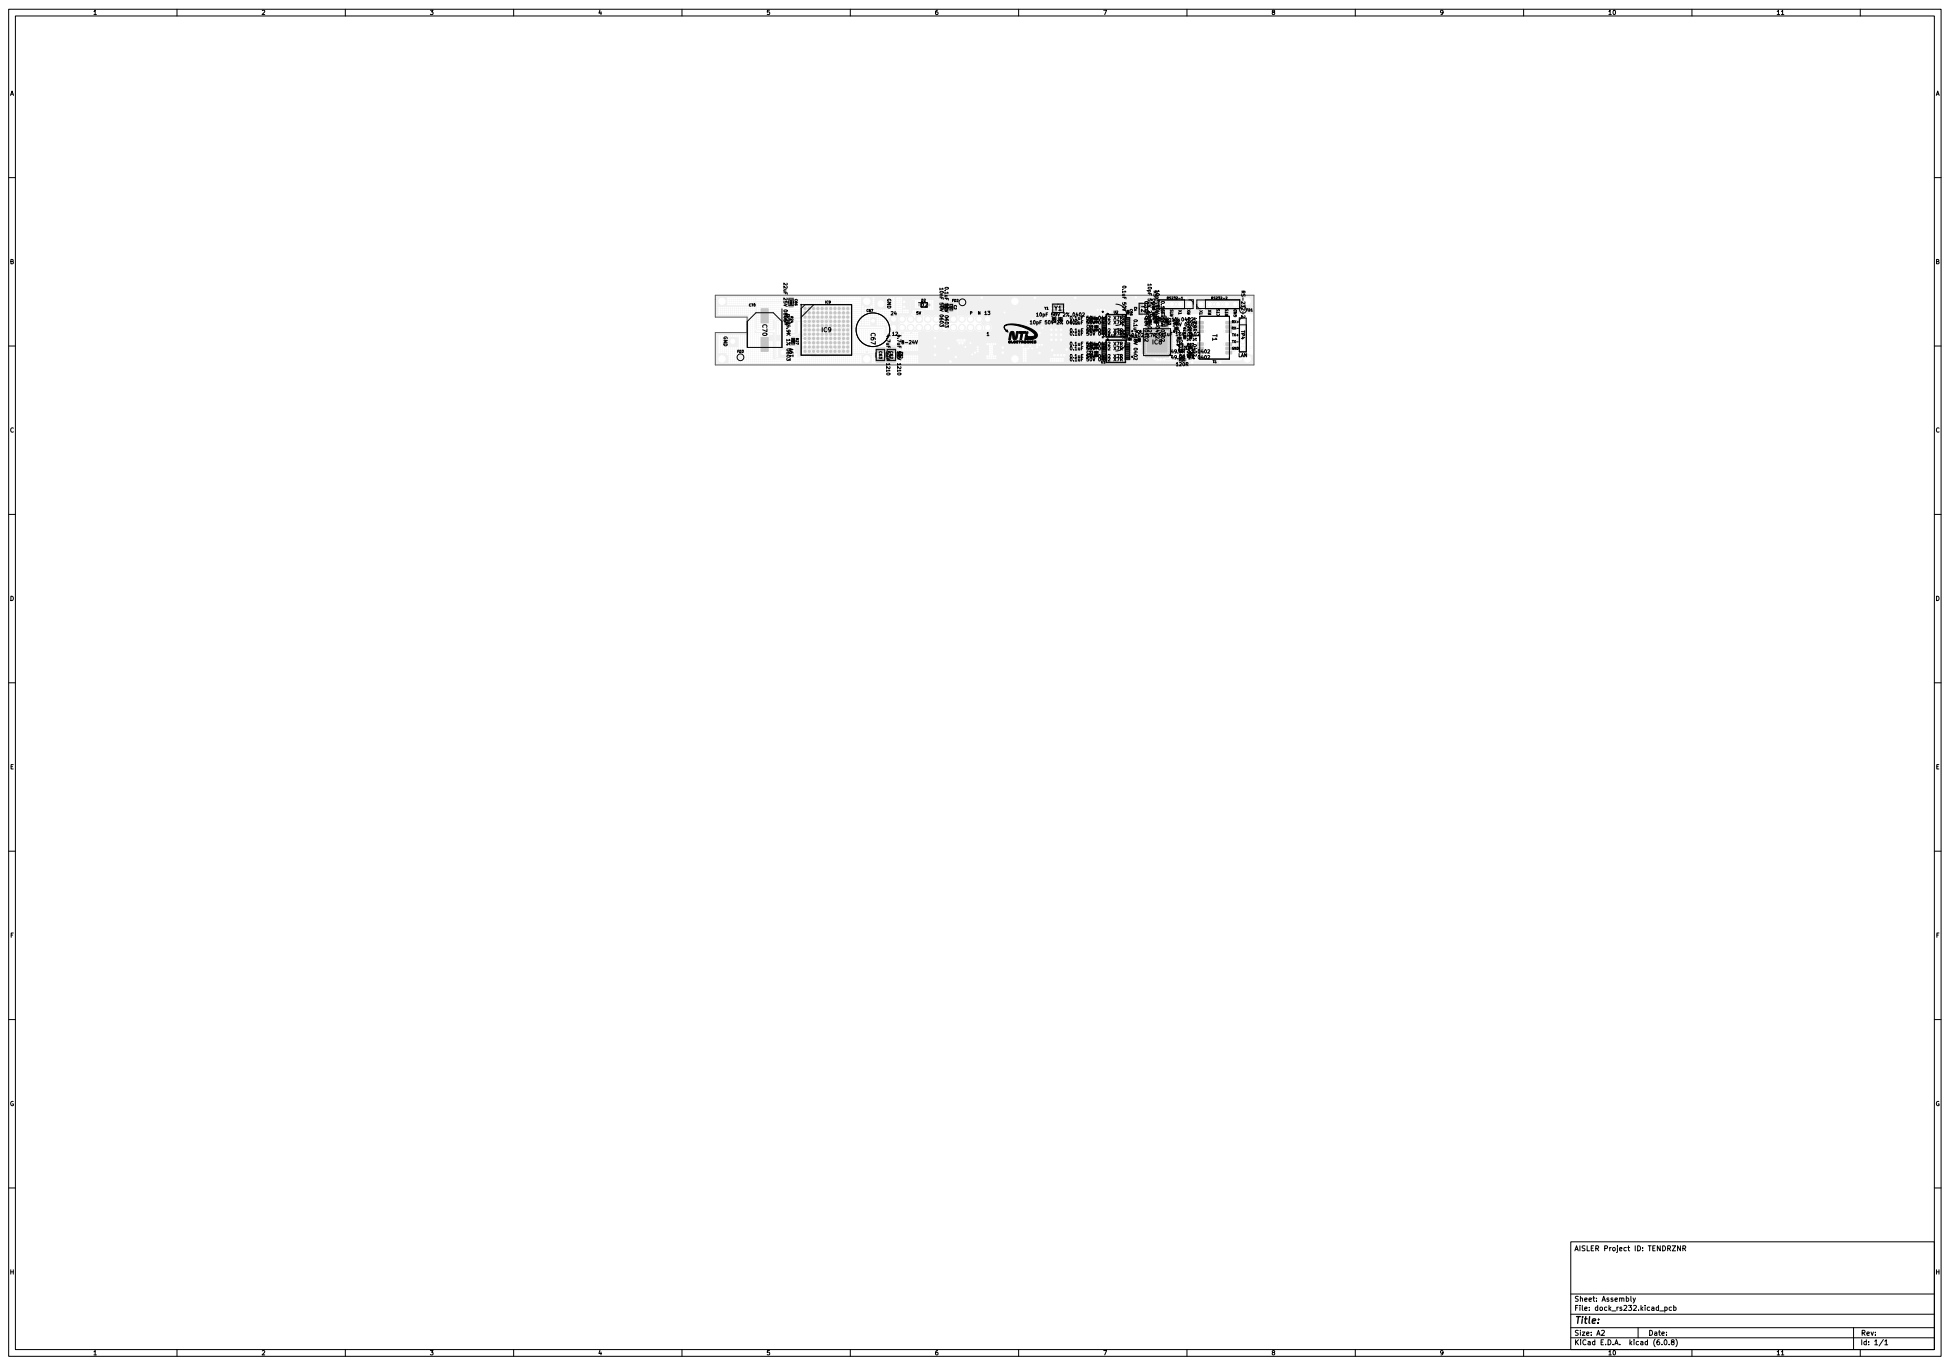
[picture p52: page 2]

CTS RTSP 13 RX GND

AISLER Project ID: TENDRZNR
