lincvv/kicad_space/Projects/Design/nti/dock_rs232/Board2Pdf/temp/dock_rs232-BlackAndWhiteBottom.pdf

N | TX | GND
5V 12


CTS RTSP 13 RX GND

AISLER Project ID: TENDRZNR
