lincvv/kicad_space/Projects/Design/nti/dock_rs232/Board2Pdf/temp/dock_rs232-BlackAndWhiteTop.pdf

1 | 2 | 3 | 4 | 5 | 6 | 7 | 8 | 9 | 10 | 11

A

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
