lincvv/kicad_space/Projects/Design/nti/dock_rs232/Board2Pdf/temp/dock_rs232-B_Fab.pdf

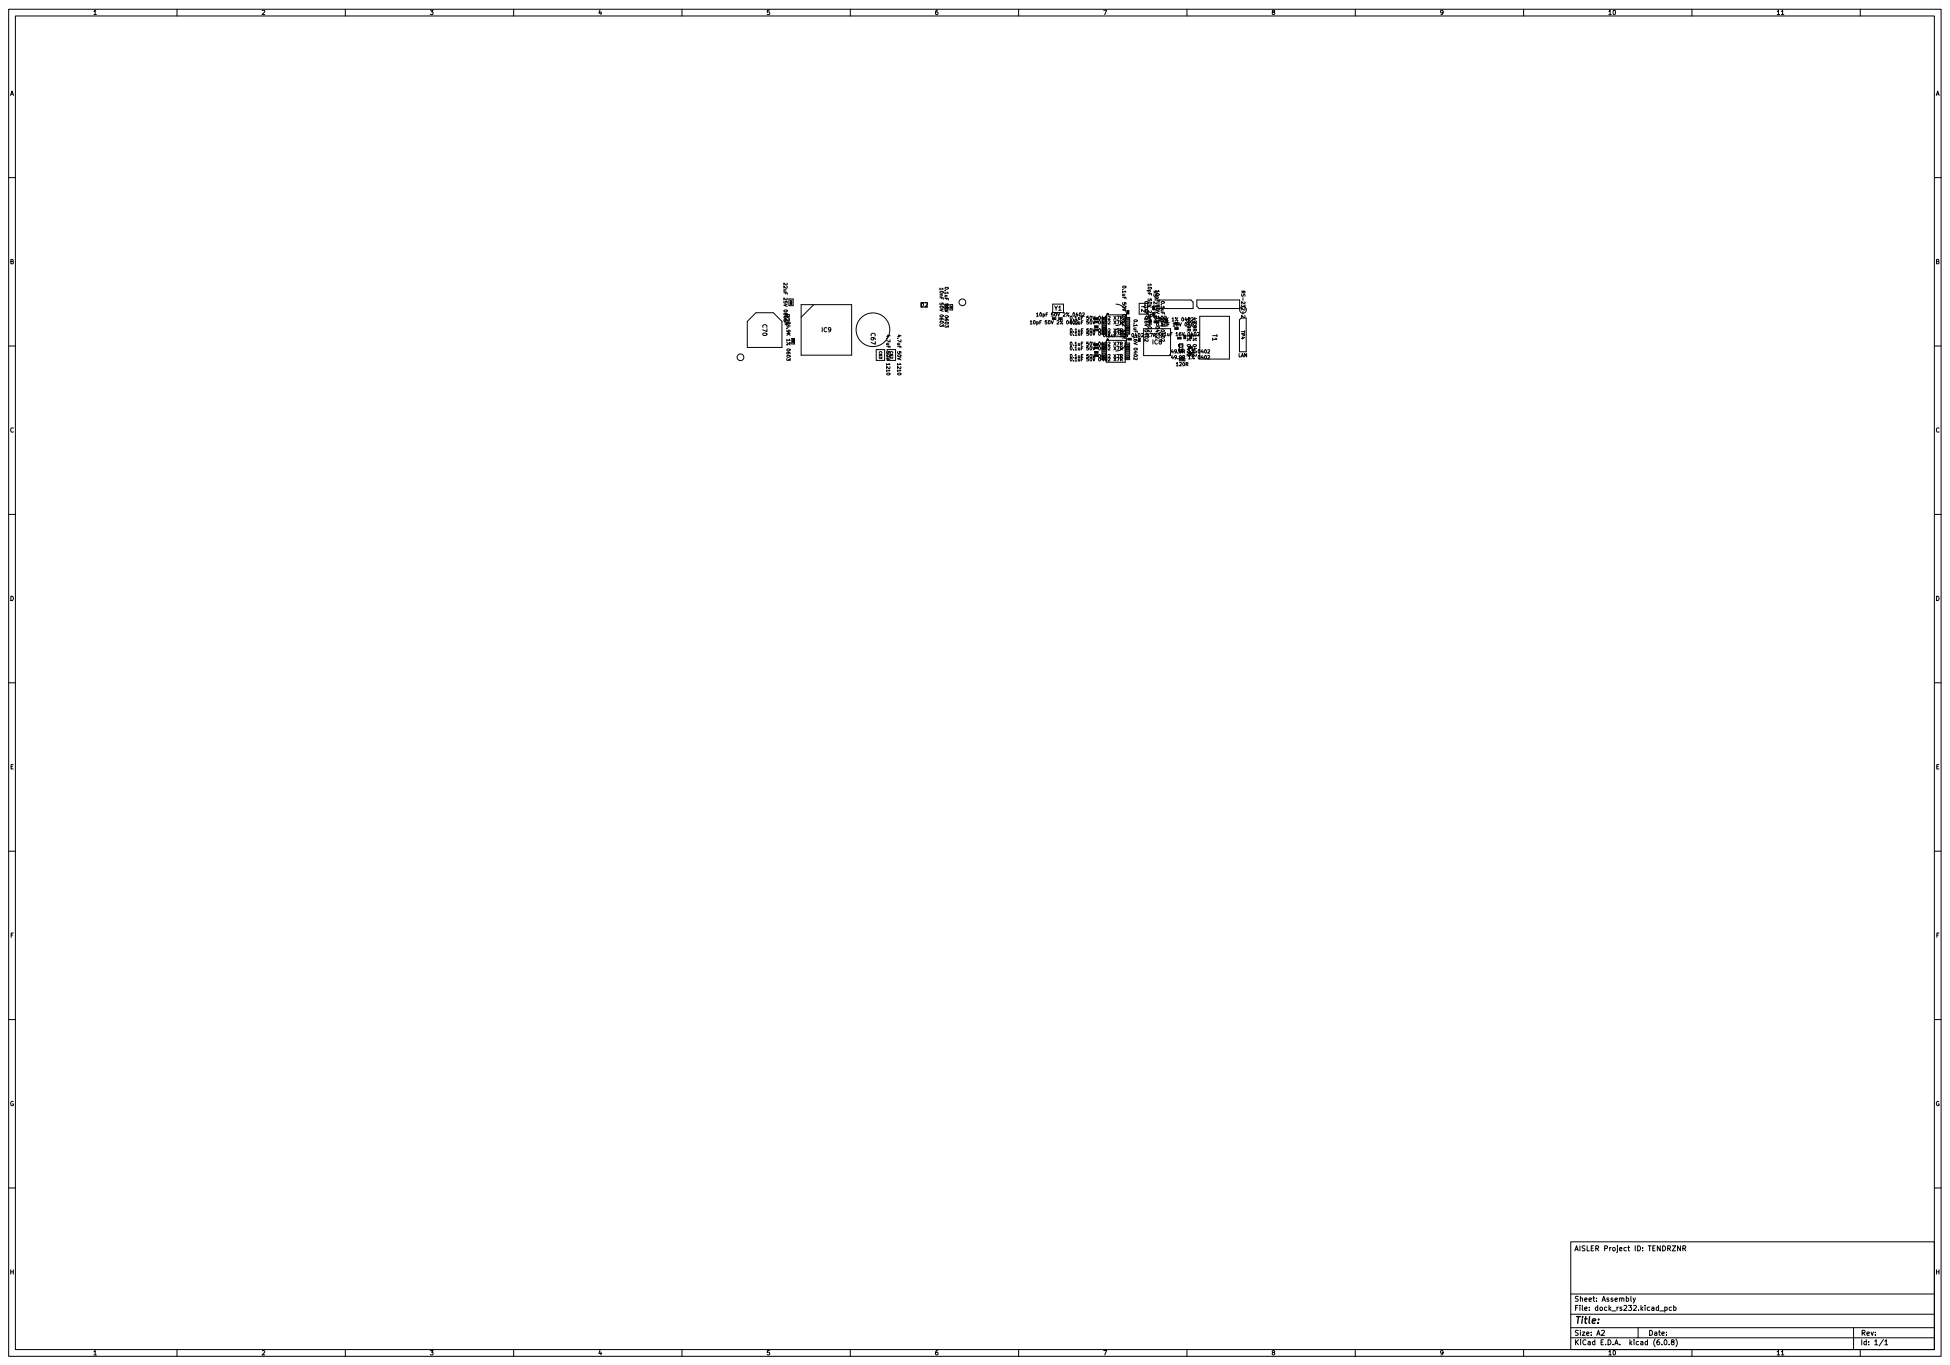
[picture p53: page 1]

AISLER Project ID: TENDRZNR
