lincvv/kicad_space/Projects/Design/nti/dock_rs232/Board2Pdf/temp/dock_rs232-F_Silkscreen.pdf

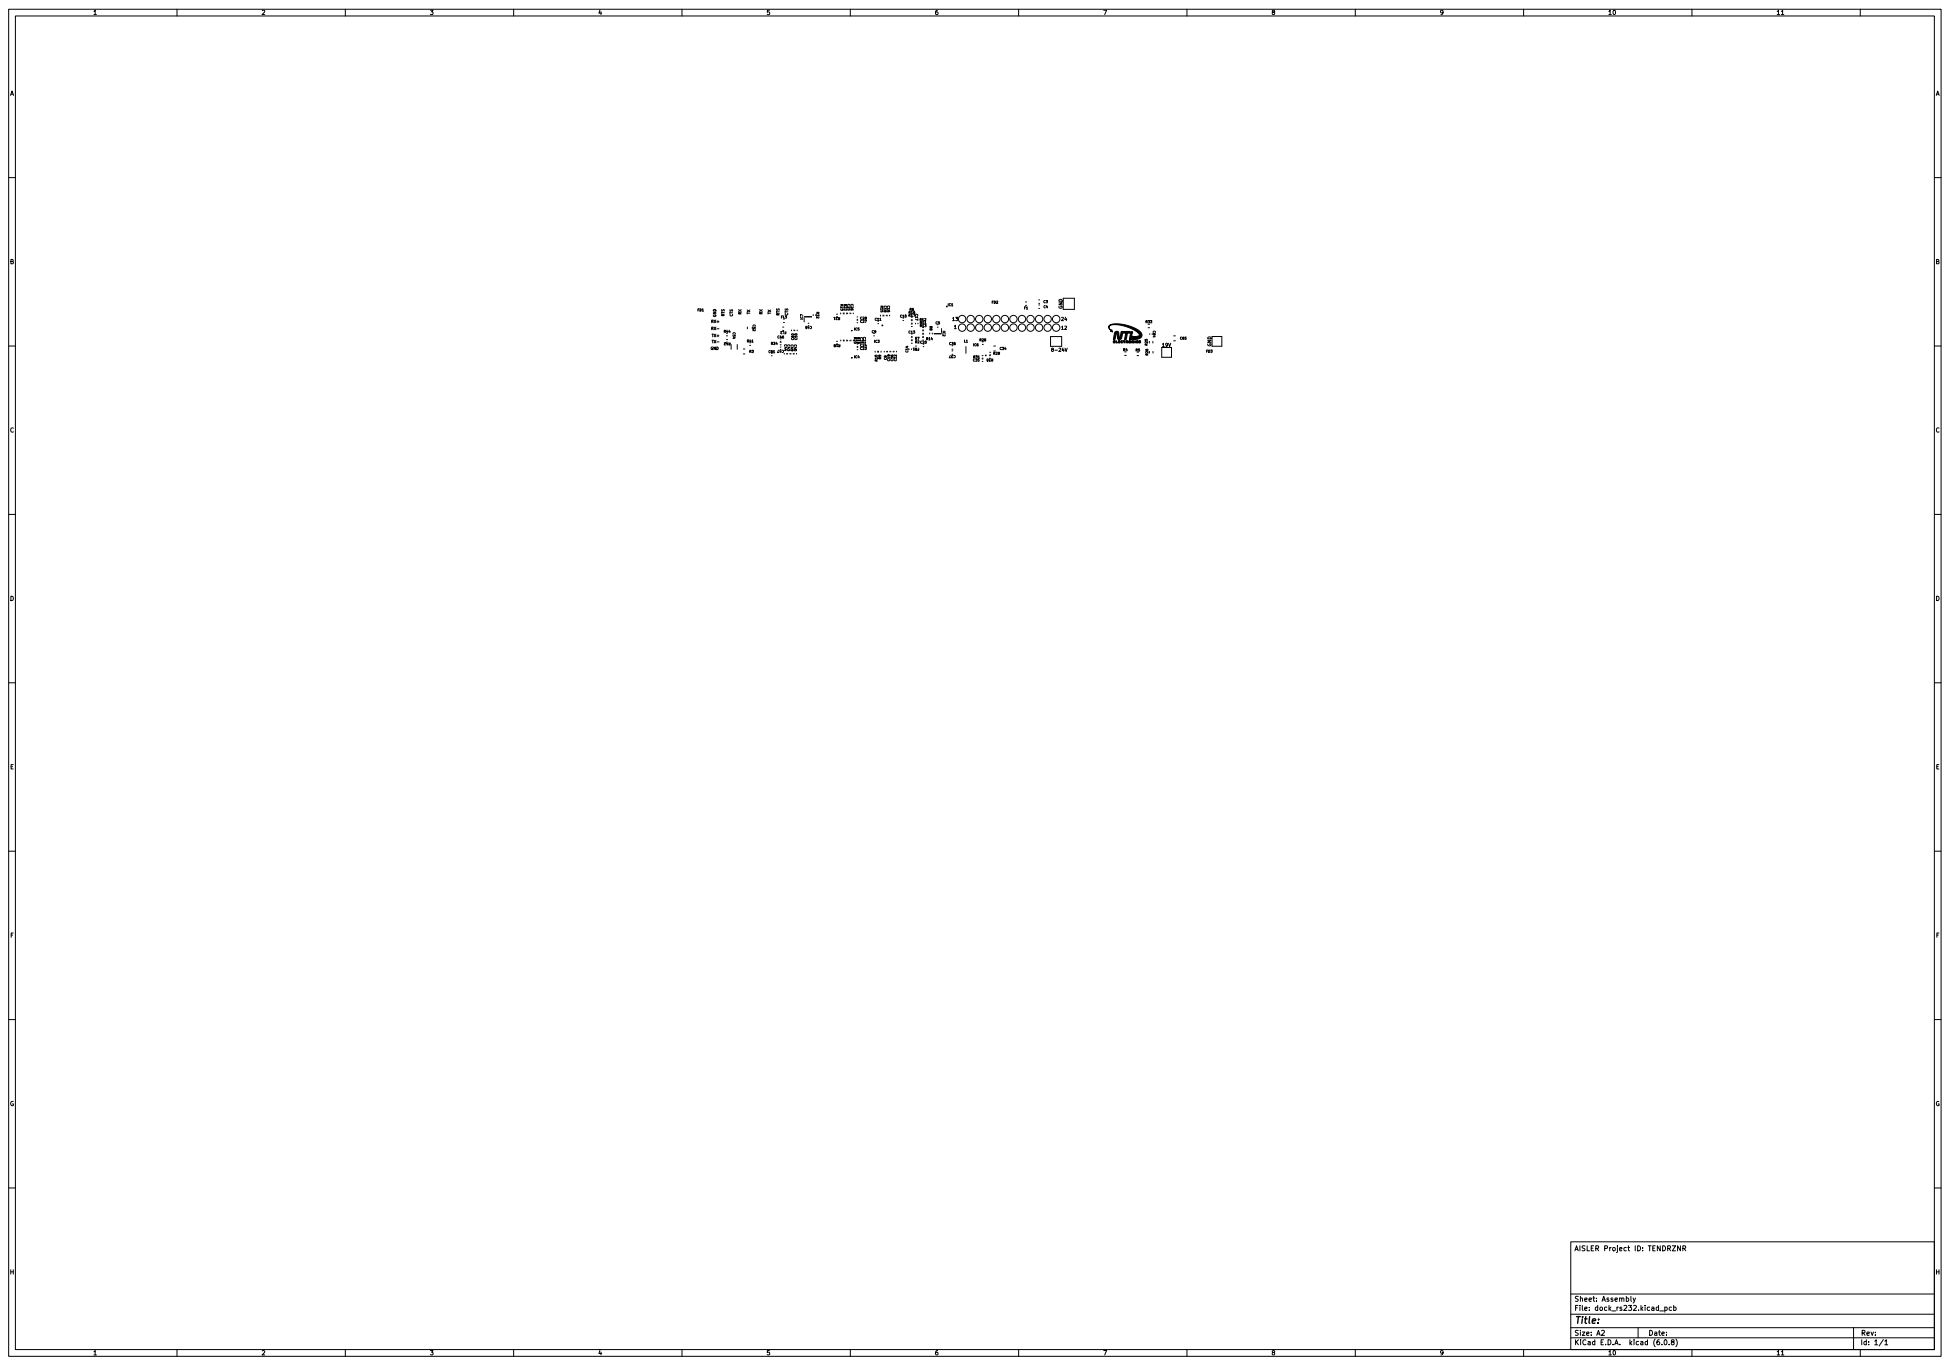
[picture p54: page 1]
