lincvv/kicad_space/Projects/Work/cti/A2D.pdf

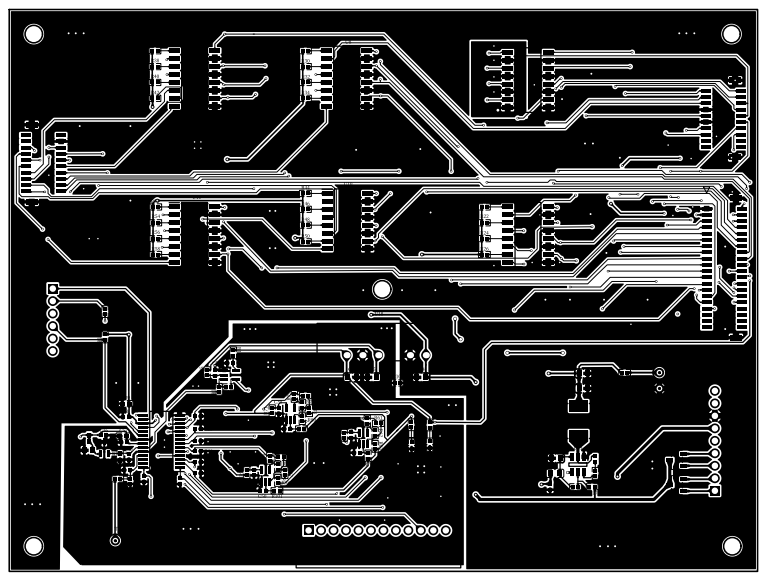
[picture p55: page 1]

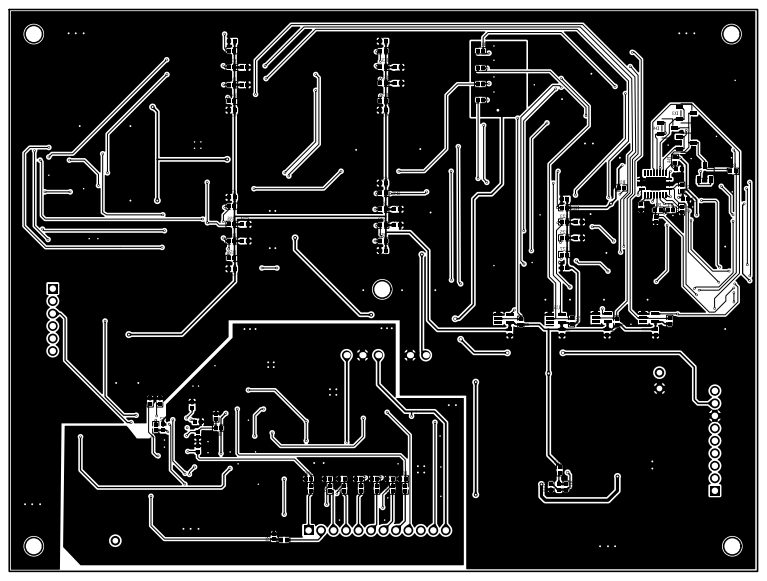
[picture p56: page 2]

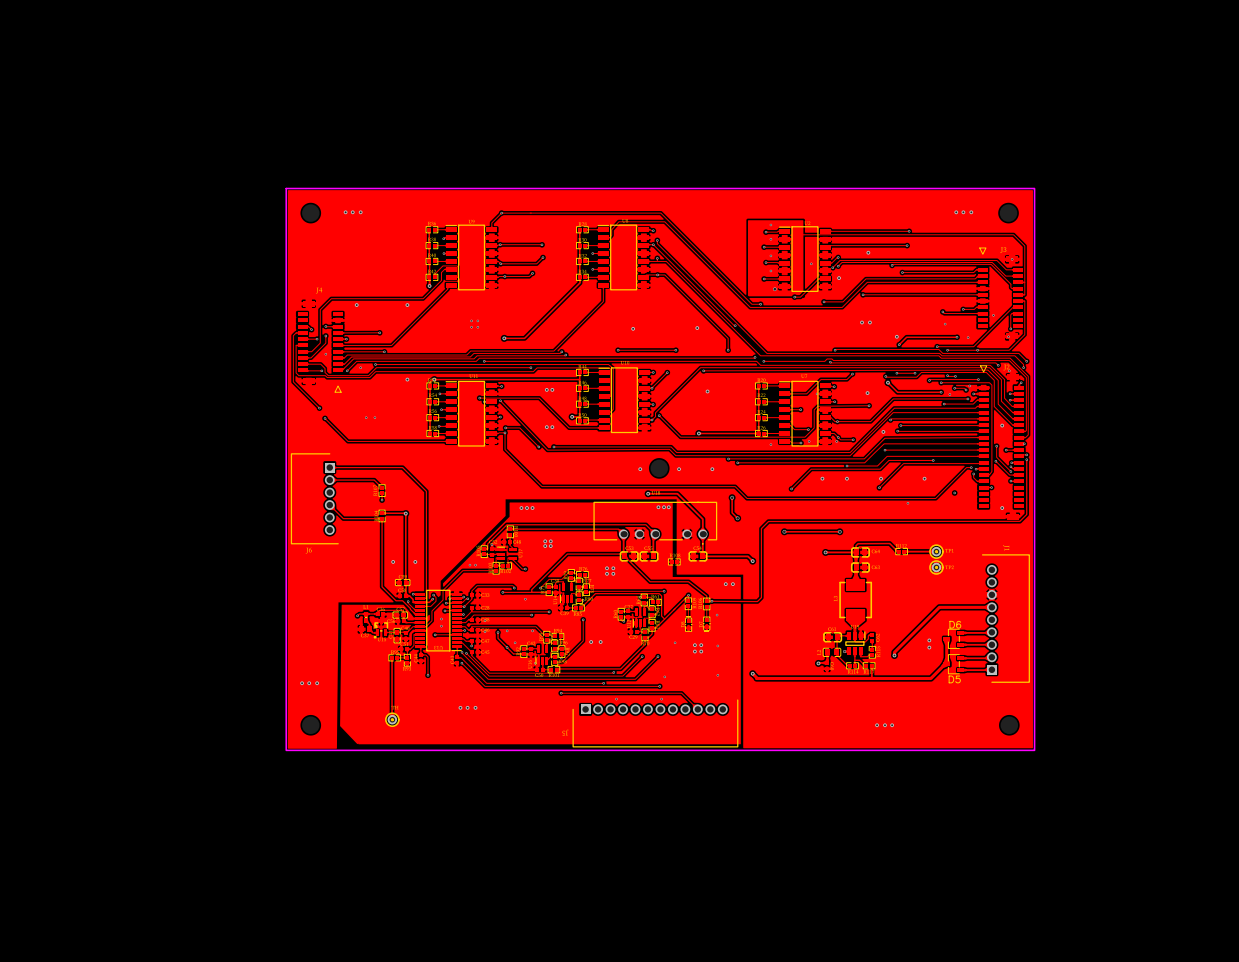
[picture p57: page 3]

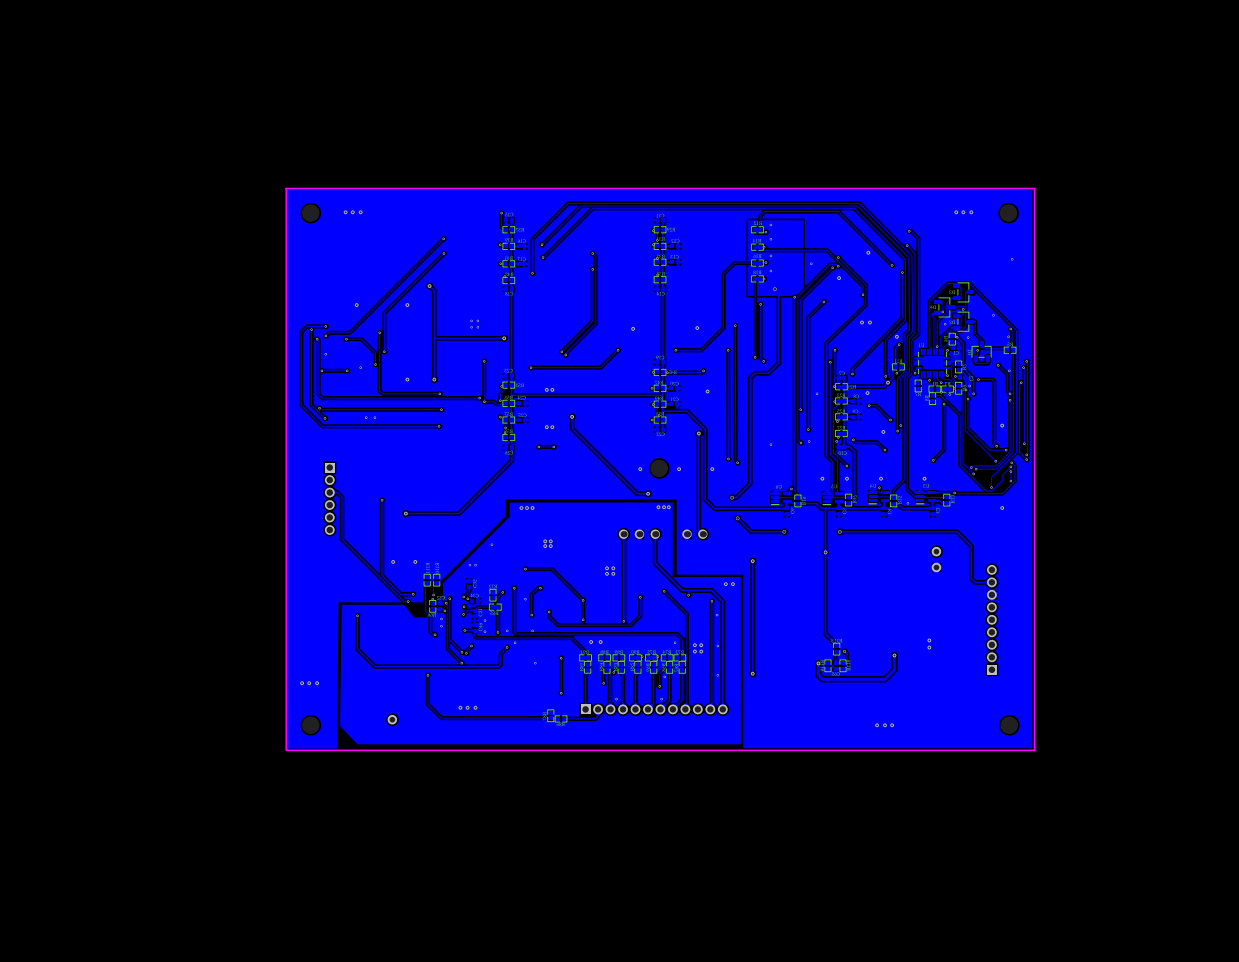
[picture p58: page 4]
