lincvv/kicad_space/Projects/Work/cti/PCB_PCB_A2D_v1.0_bottom.pdf

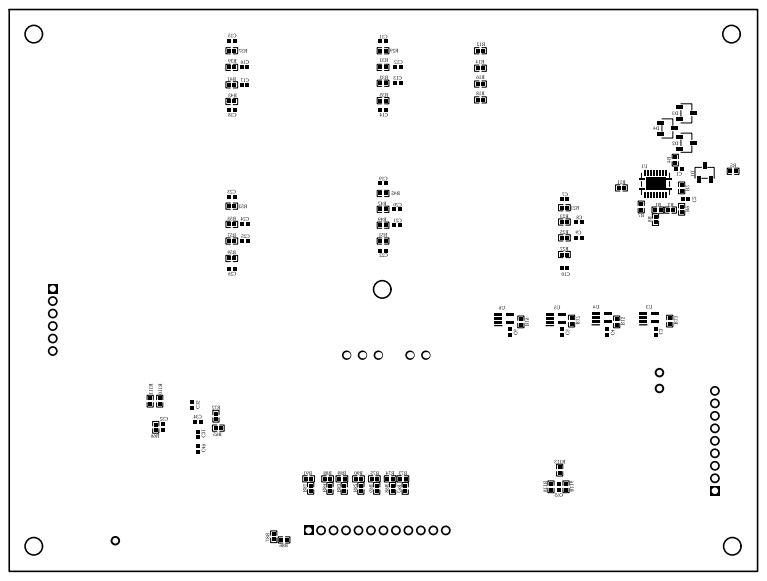
[picture p59: page 1]
