lincvv/kicad_space/Projects/Work/cti/PCB_PCB_A2D_v1.0_top.pdf

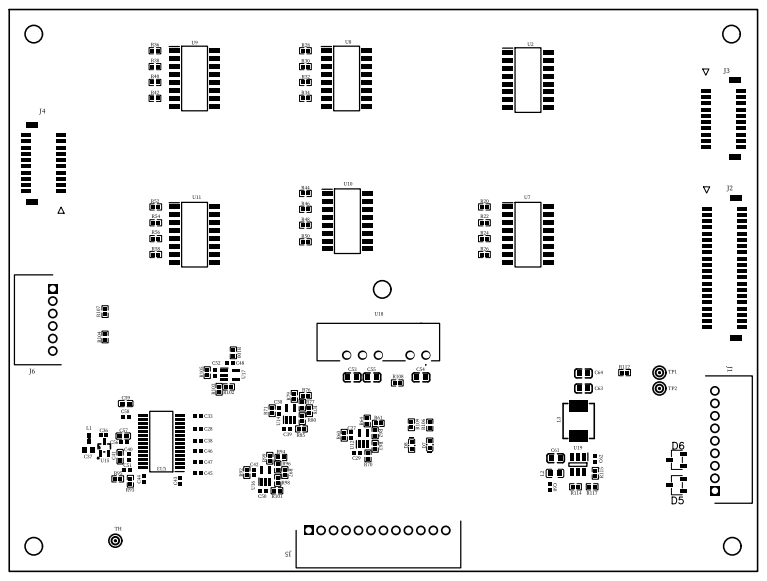
[picture p60: page 1]
