lincvv/kicad_space/(list of files, drawings)

Other design files:
Projects/Work/cti/A2D_ascii.SchDoc_2021-05-28/A2D.schdoc
Projects/Work/cti/A2D_ascii.SchDoc_2021-05-28/Main.schdoc
Projects/Work/cti/A2D_ascii.SchDoc_2021-05-28/Power.schdoc
Projects/Work/cti/A2D_ascii.SchDoc_2021-05-28/QuadOPTO.schdoc
Projects/Work/cti/Imported PROTOTYPE.PrjPcb/A2D.SchDoc
Projects/Work/cti/Imported PROTOTYPE.PrjPcb/A2D_ascii.SchDoc
Projects/Work/cti/Imported PROTOTYPE.PrjPcb/Main.SchDoc
Projects/Work/cti/Imported PROTOTYPE.PrjPcb/Main_ascii.SchDoc
Projects/Work/cti/Imported PROTOTYPE.PrjPcb/Power.SchDoc
Projects/Work/cti/Imported PROTOTYPE.PrjPcb/Power_ascii.SchDoc
Projects/Work/cti/Imported PROTOTYPE.PrjPcb/PROTOTYPE.PrjPcb
Projects/Work/cti/Imported PROTOTYPE.PrjPcb/PROTOTYPE_Library.SchLib
Projects/Work/cti/Imported PROTOTYPE.PrjPcb/QuadOPTO.SchDoc
Projects/Work/cti/Imported PROTOTYPE.PrjPcb/QuadOPTOascii.SchDoc
