lincvv/kicad_space/Projects/Design/vng/SoilSensor_cad_ki/esp32_moisture.kicad_pcb

## KiCad design Projects/Design/vng/SoilSensor_cad_ki/esp32_moisture.kicad_pcb (2024-06-23)

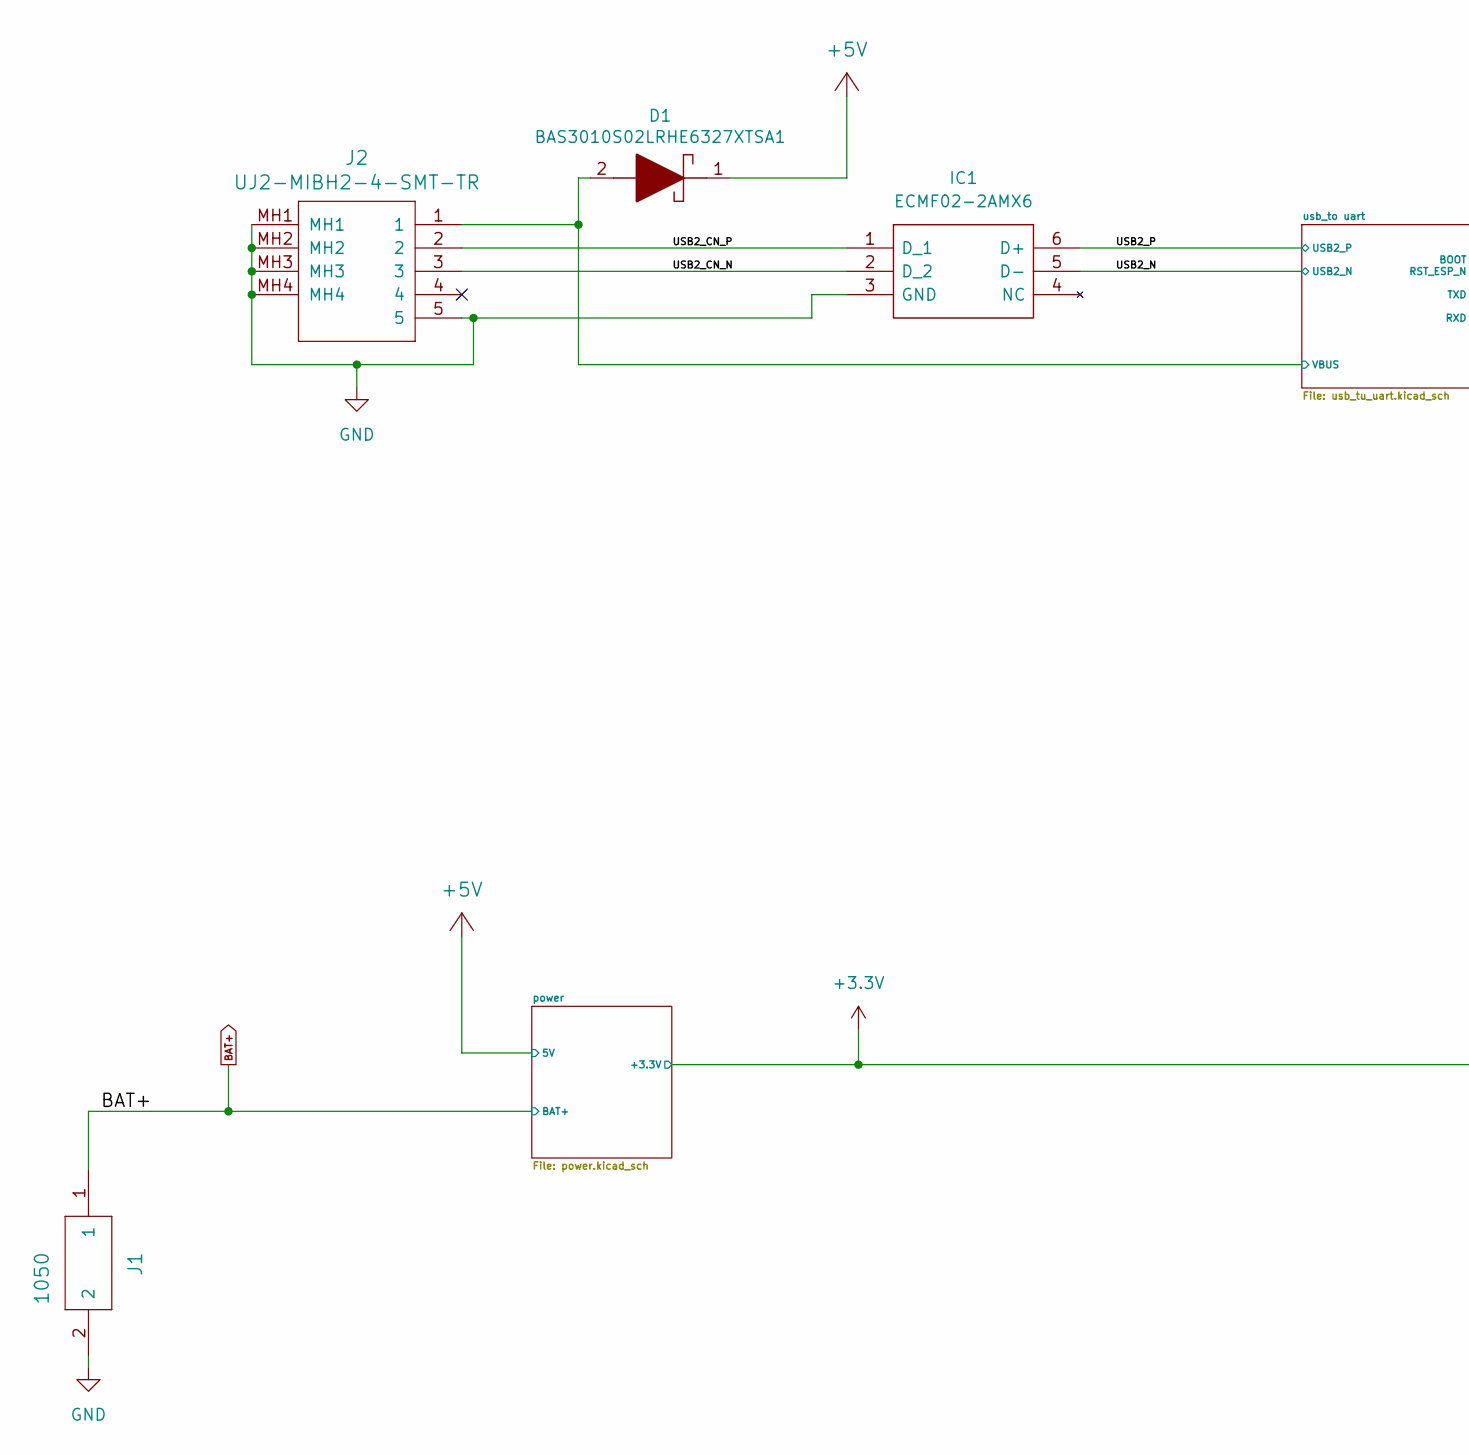
[picture p61: schematic esp32_moisture.kicad_sch, main, part in row 1, column 1]

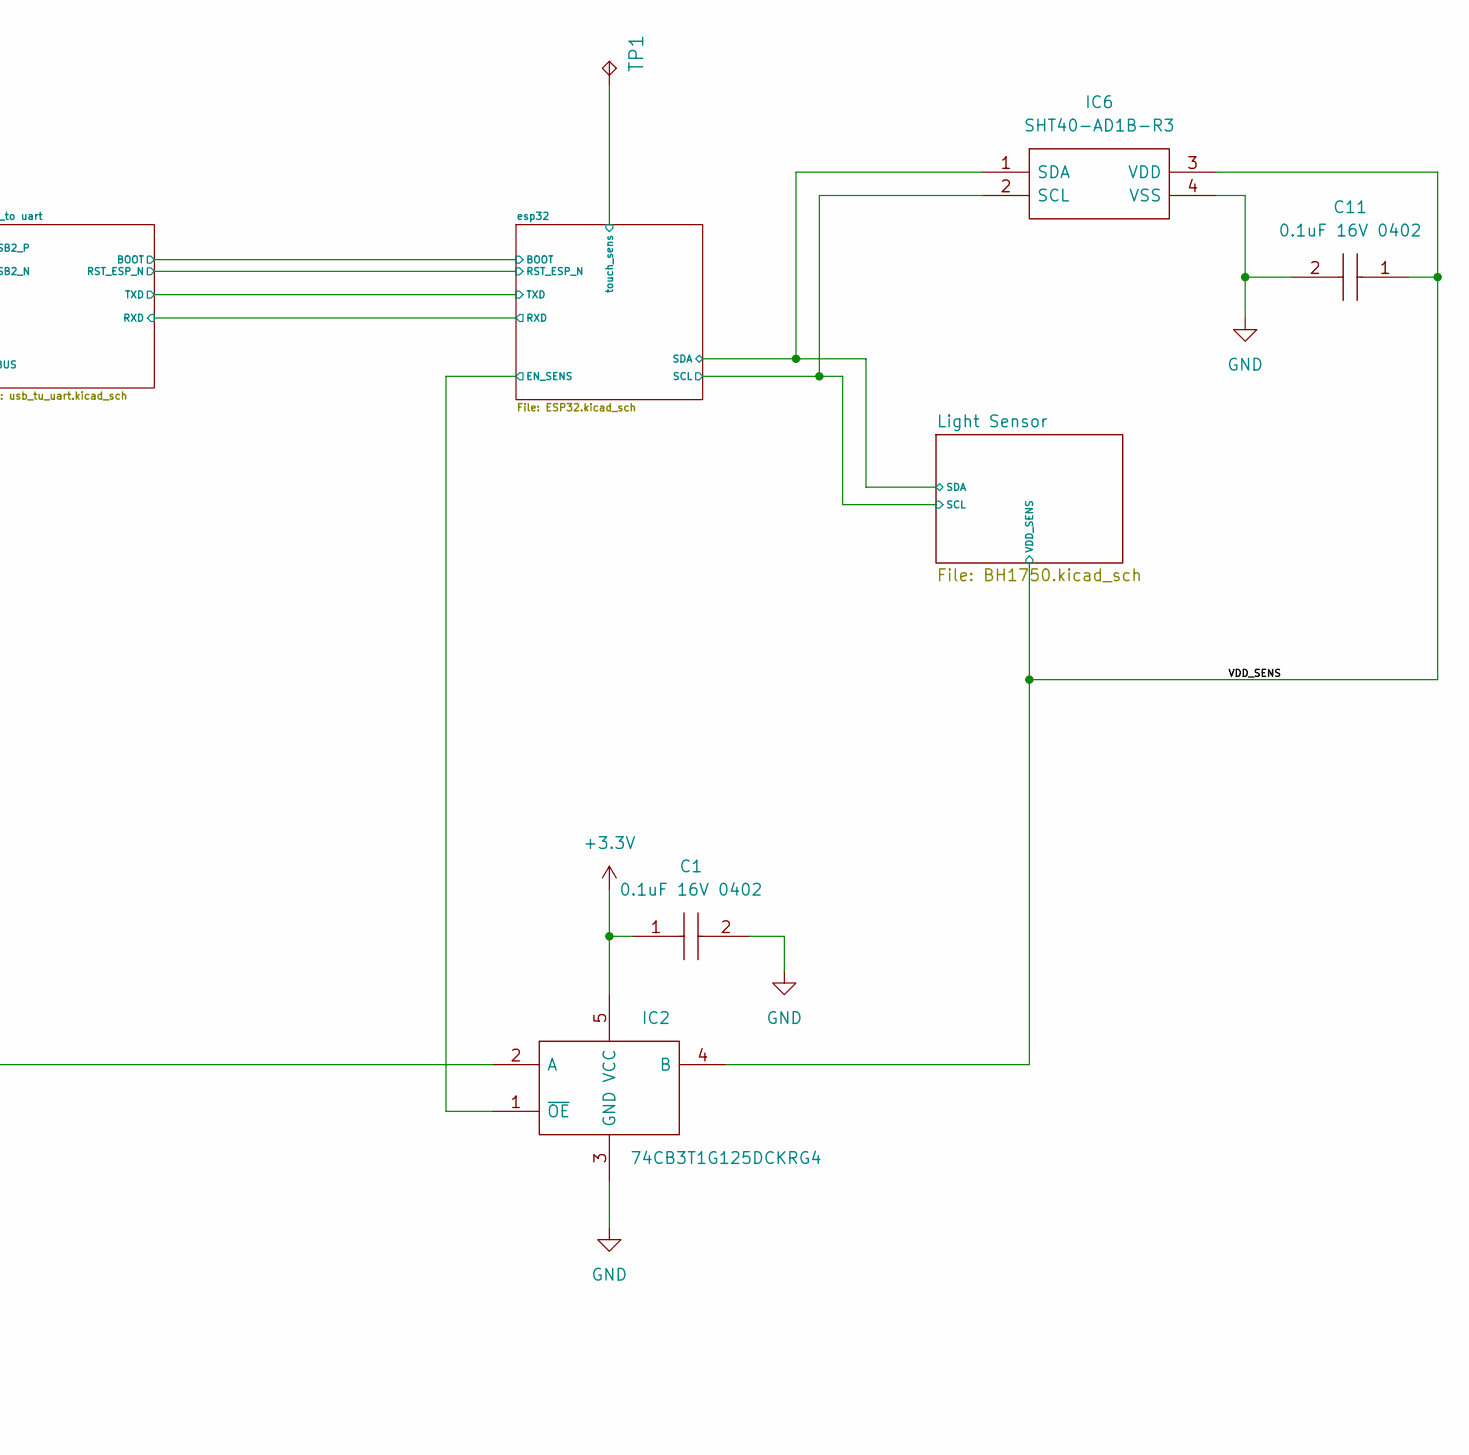
[picture p62: schematic esp32_moisture.kicad_sch, main, part in row 1, column 2]

Parts:
C1, C11: 0.1uF 16V 0402; C_0402_1005Metric; Manufacturer_Part_Number GRM155R71C104KA88D; Mouser Part Number N/A
D1: BAS3010S02LRHE6327XTSA1; Manufacturer_Part_Number BAS3010S02LRHE6327XTSA1; Mouser Part Number 726-3010S02LRHXTSA1
IC1: ECMF02-2AMX6; SON50P150X170X55-6N-D; Manufacturer_Part_Number ECMF02-2AMX6; Mouser Part Number 511-ECMF02-2AMX6
IC2: 74CB3T1G125DCKRG4; SOT65P210X110-5N; Manufacturer_Part_Number 74CB3T1G125DCKRG4; Mouser Part Number 595-CB3T1G125DCKRG4
IC6: SHT40-AD1B-R3; SHT40AD1BR3; Manufacturer_Part_Number SHT40-AD1B-R3; Mouser Part Number 403-SHT40-AD1B-R3
J1: 1050
J2: UJ2-MIBH2-4-SMT-TR; UJ2MIBH24SMTTR
TP1: TPTP15R; TP15R

Connections:
+3.3V: C1.1, IC2.2 (A), IC2.5 (VCC); also elsewhere on the board
+5V: D1.1; also elsewhere on the board
/USB2_CN_N: IC1.2 (D_2), J2.3
/USB2_CN_P: IC1.1 (D_1), J2.2
/USB2_N: IC1.5 (D-); also elsewhere on the board
/USB2_P: IC1.6 (D+); also elsewhere on the board
/VDD_SENS: C11.1, IC2.4 (B), IC6.3 (VDD); also elsewhere on the board
/esp32/EN_SENS: IC2.1 (~OE); also elsewhere on the board
/esp32/SCL: IC6.2 (SCL); also elsewhere on the board
/esp32/SDA: IC6.1 (SDA); also elsewhere on the board
/esp32/touch_sens: TP1.TP; also elsewhere on the board
/usb_to uart/VBUS: D1.2, J2.1; also elsewhere on the board
BAT+: J1.1; also elsewhere on the board
GND: C1.2, C11.2, IC1.3 (GND), IC2.3 (GND), IC6.4 (VSS), J1.2, J2.5, J2.MH1, J2.MH2, J2.MH3, J2.MH4; also elsewhere on the board

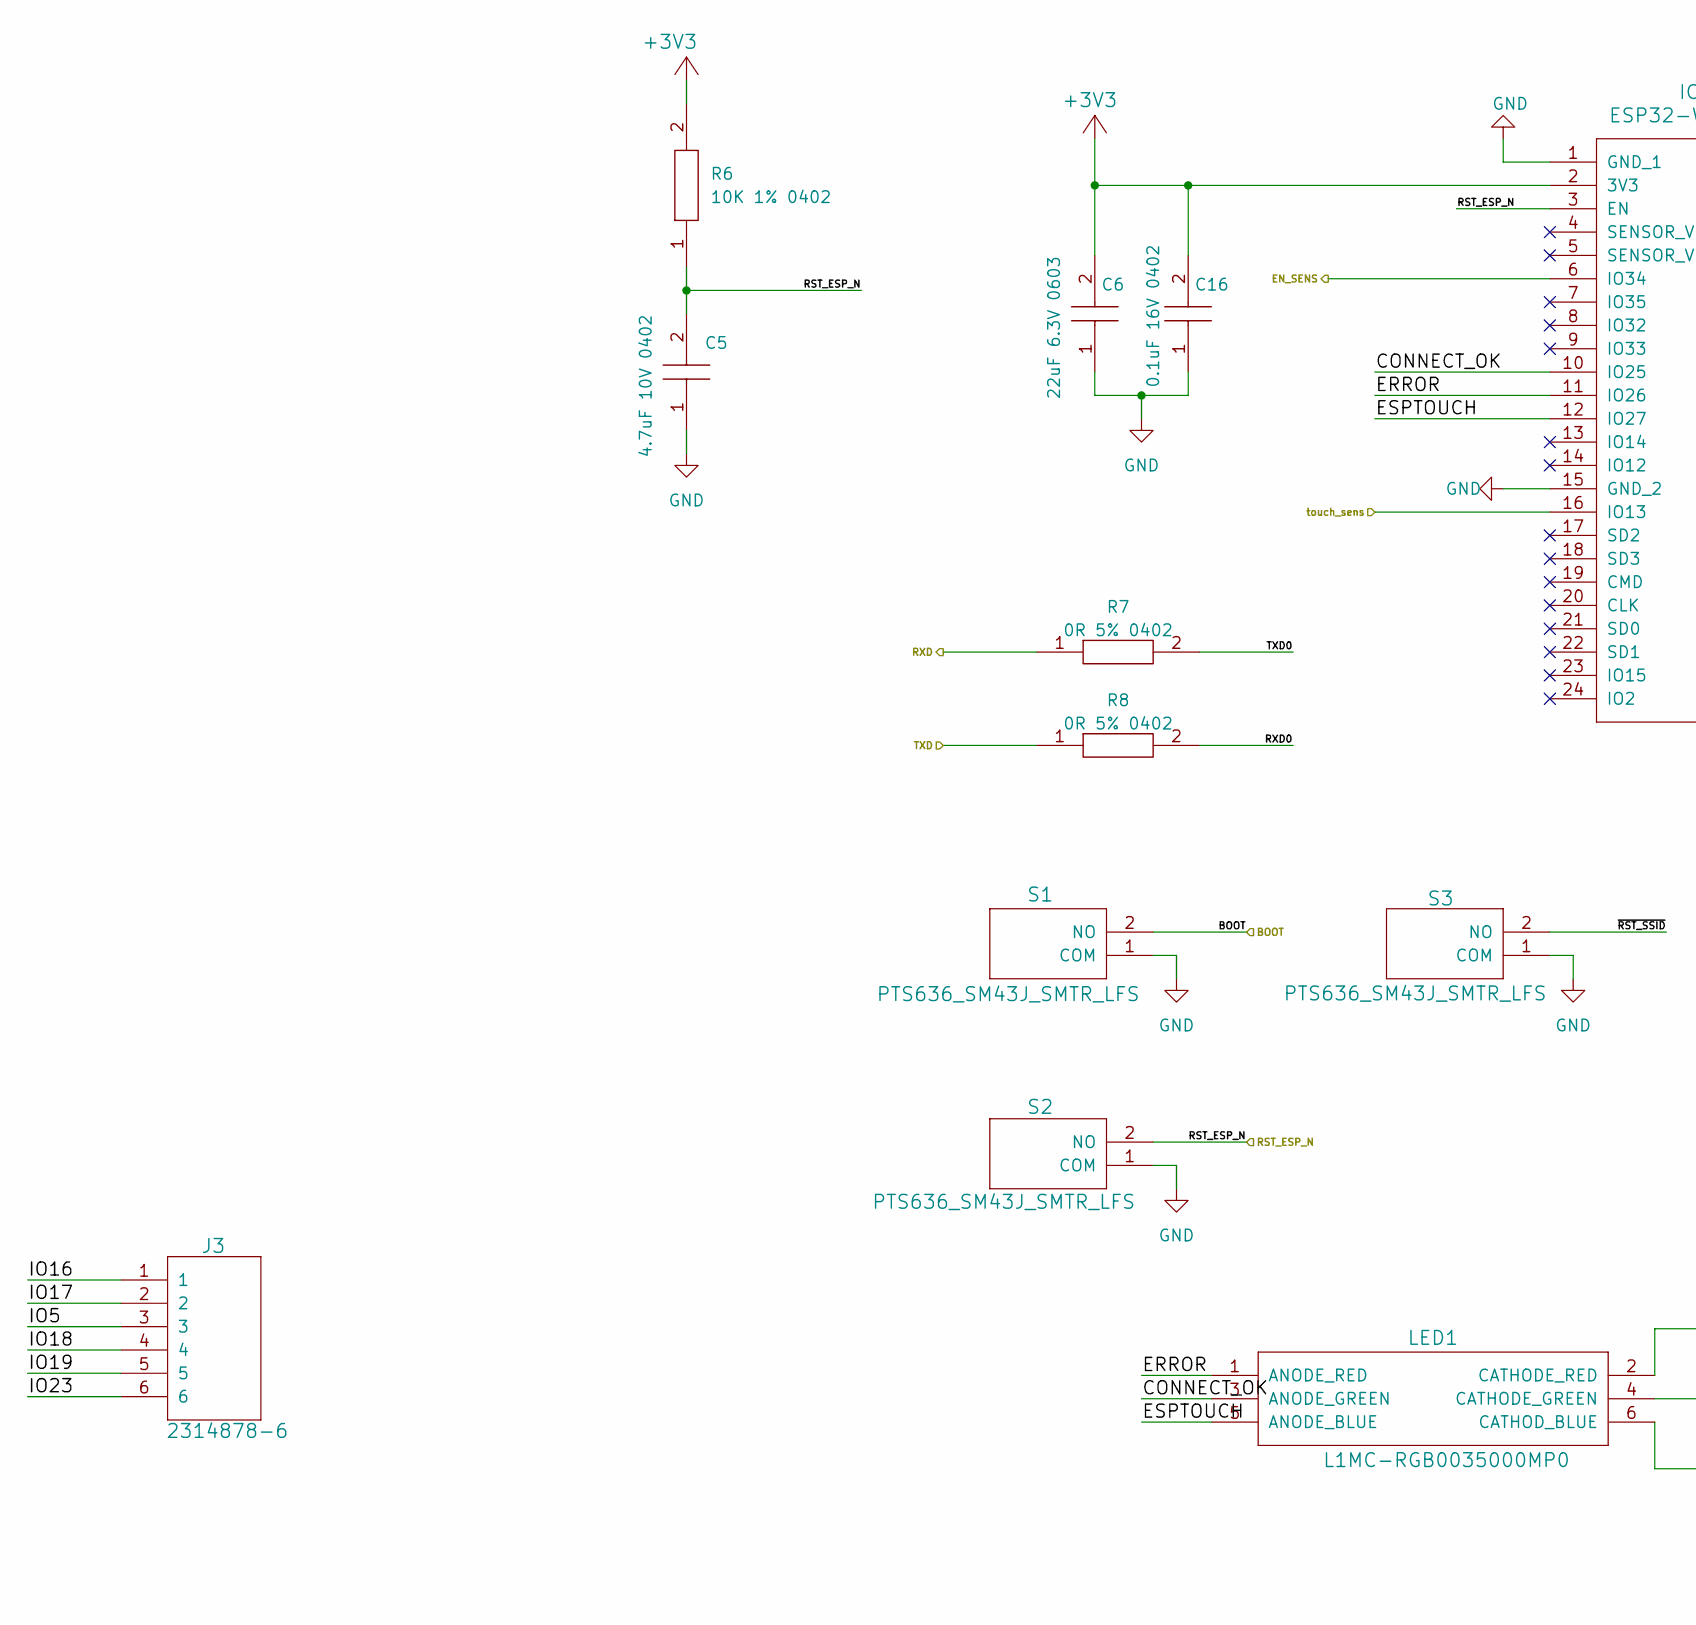
[picture p63: schematic ESP32.kicad_sch, part in row 1, column 1]

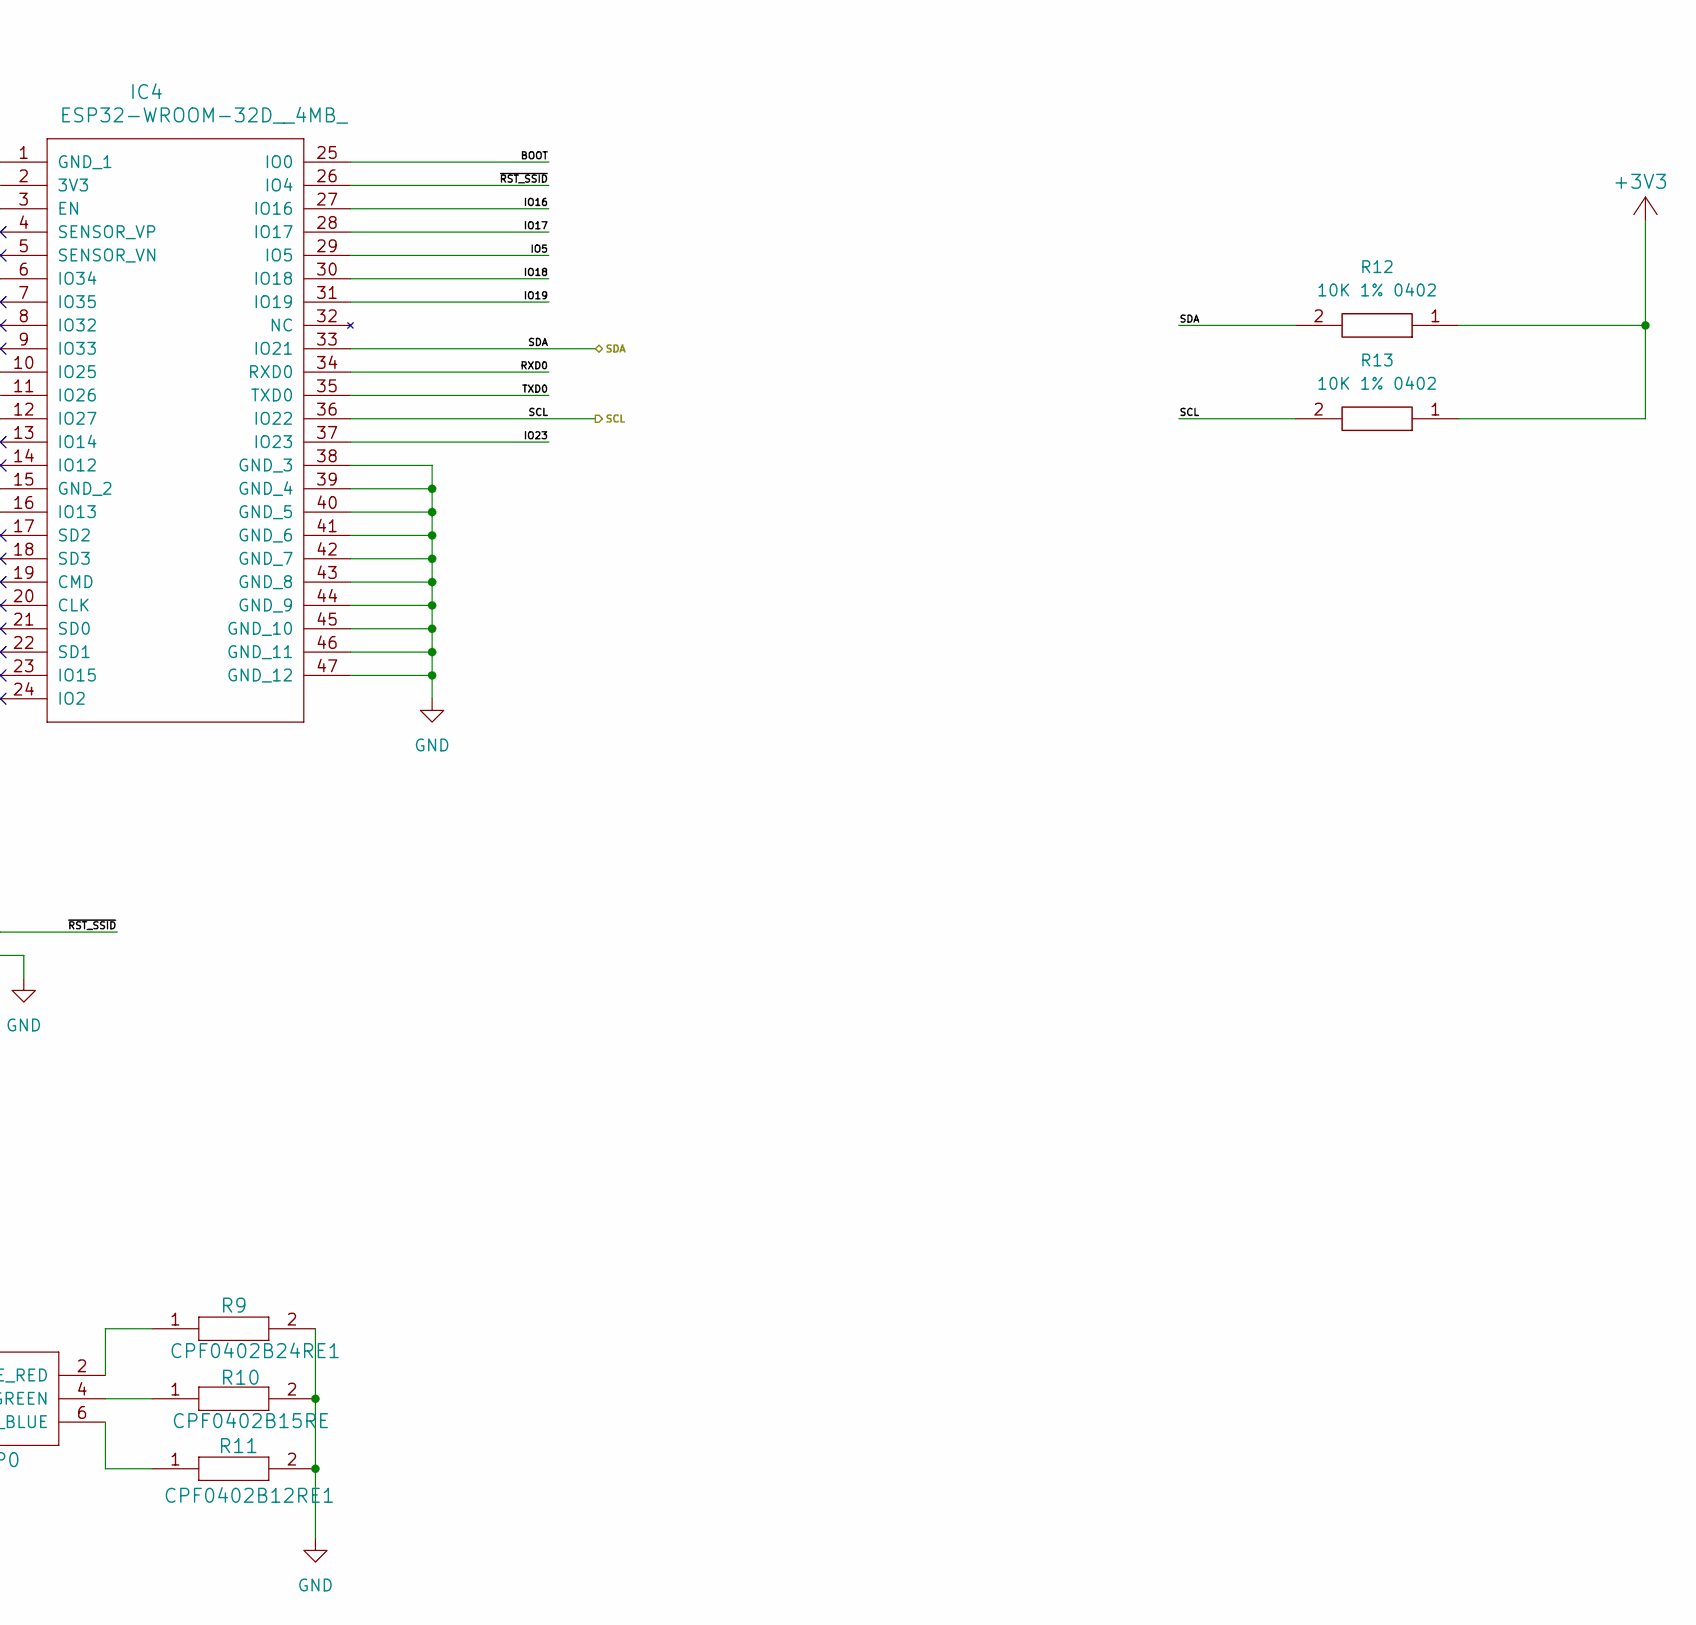
[picture p64: schematic ESP32.kicad_sch, part in row 1, column 2]

Parts:
C5: 4.7uF 10V 0402; C_0402_1005Metric; Manufacturer_Part_Number C1005X5R1A475K050BC; Mouser Part Number 810-C1005X5R1A475KBC
C6: 22uF 6.3V 0603; C_0603_1608Metric; Manufacturer_Part_Number GRM188R60J226MEA0D; Mouser Part Number 81-GRM188R60J226ME0D
C16: 0.1uF 16V 0402; C_0402_1005Metric; Manufacturer_Part_Number GRM155R71C104KA88D; Mouser Part Number N/A
IC4: ESP32-WROOM-32D__4MB_; ESP32WROOM32D4MB
J3: 2314878-6; RHDR6W40P0X200_1X6_1200X210X45
LED1: L1MC-RGB0035000MP0; L1MCRGB0035000MP0
R6, R12, R13: 10K 1% 0402; R_0402_1005Metric; Manufacturer_Part_Number AC0402FR-0710KL; Mouser Part Number 603-AC0402FR-0710KL
R7, R8: 0R 5% 0402; R_0402_1005Metric; Manufacturer_Part_Number CR0402-J/-000GLF; Mouser Part Number 652-CR0402-J/-000GLF
R9: CPF0402B24RE1; RESC1005X35N
R10: CPF0402B15RE; RESC1005X35N
R11: CPF0402B12RE1; RESC1005X35N
S1, S2, S3: PTS636_SM43J_SMTR_LFS; PTS636SM43JSMTRLFS

Connections:
+3V3: C6.2, C16.2, IC4.2 (3V3), R6.2, R12.1, R13.1
/esp32/BOOT: IC4.25 (IO0), S1.2 (NO); also elsewhere on the board
/esp32/CONNECT_OK: IC4.10 (IO25), LED1.3 (ANODE_GREEN)
/esp32/EN_SENS: IC4.6 (IO34); also elsewhere on the board
/esp32/ERROR: IC4.11 (IO26), LED1.1 (ANODE_RED)
/esp32/ESPTOUCH: IC4.12 (IO27), LED1.5 (ANODE_BLUE)
/esp32/IO5: IC4.29 (IO5), J3.3
/esp32/IO16: IC4.27 (IO16), J3.1
/esp32/IO17: IC4.28 (IO17), J3.2
/esp32/IO18: IC4.30 (IO18), J3.4
/esp32/IO19: IC4.31 (IO19), J3.5
/esp32/IO23: IC4.37 (IO23), J3.6
/esp32/RST_ESP_N: C5.2, IC4.3 (EN), R6.1, S2.2 (NO); also elsewhere on the board
/esp32/RXD: R7.1; also elsewhere on the board
/esp32/RXD0: IC4.34 (RXD0), R8.2
/esp32/SCL: IC4.36 (IO22), R13.2; also elsewhere on the board
/esp32/SDA: IC4.33 (IO21), R12.2; also elsewhere on the board
/esp32/TXD: R8.1; also elsewhere on the board
/esp32/TXD0: IC4.35 (TXD0), R7.2
/esp32/touch_sens: IC4.16 (IO13); also elsewhere on the board
/esp32/~RST_SSID: IC4.26 (IO4), S3.2 (NO)
GND: C5.1, C6.1, C16.1, IC4.1 (GND_1), IC4.15 (GND_2), IC4.38 (GND_3), IC4.39 (GND_4), IC4.40 (GND_5), IC4.41 (GND_6), IC4.42 (GND_7), IC4.43 (GND_8), IC4.44 (GND_9), IC4.45 (GND_10), IC4.46 (GND_11), IC4.47 (GND_12), R9.2, R10.2, R11.2, S1.1 (COM), S2.1 (COM), S3.1 (COM); also elsewhere on the board
unnamed: LED1.2 (CATHODE_RED), R9.1
unnamed: LED1.4 (CATHODE_GREEN), R10.1
unnamed: LED1.6 (CATHOD_BLUE), R11.1

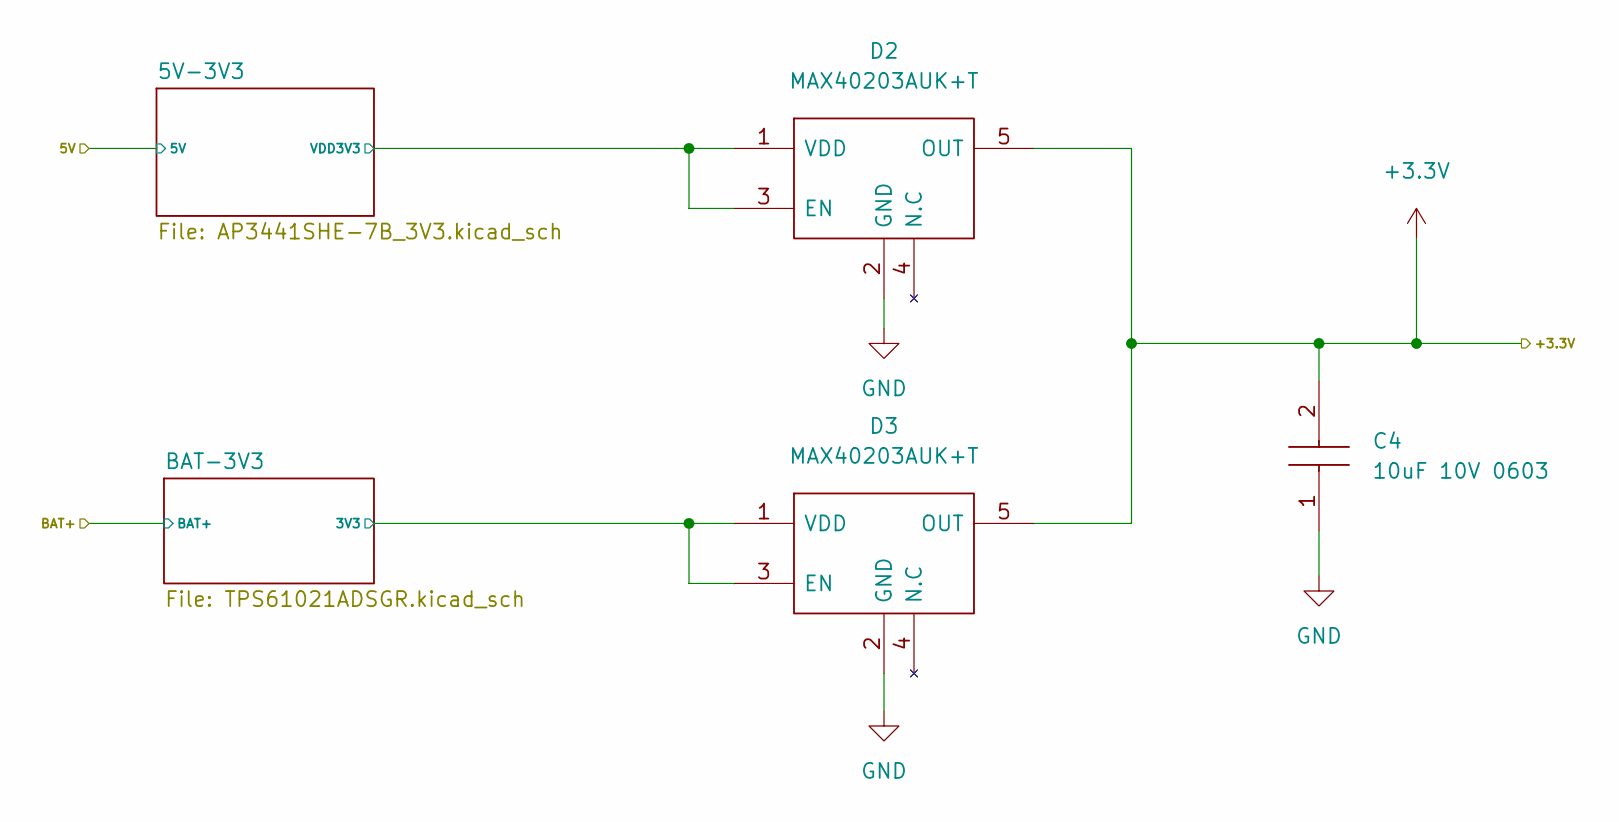
[picture p65: schematic power.kicad_sch]

Parts:
C4: 10uF 10V 0603; C_0603_1608Metric; Manufacturer_Part_Number GRM188Z71A106KA73D; Mouser Part Number 81-GRM188Z71A106KA3D
D2, D3: MAX40203AUK+T; SOT95P280X145-5N; Manufacturer_Part_Number MAX40203AUK+T; Mouser Part Number 700-MAX40203AUK+T

Connections:
+3.3V: C4.2, D2.5 (OUT), D3.5 (OUT); also elsewhere on the board
/power/5V-3V3/VDD3V3: D2.1 (VDD), D2.3 (EN); also elsewhere on the board
/power/BAT-3V3/VOUT_3V3: D3.1 (VDD), D3.3 (EN); also elsewhere on the board
GND: C4.1, D2.2 (GND), D3.2 (GND); also elsewhere on the board

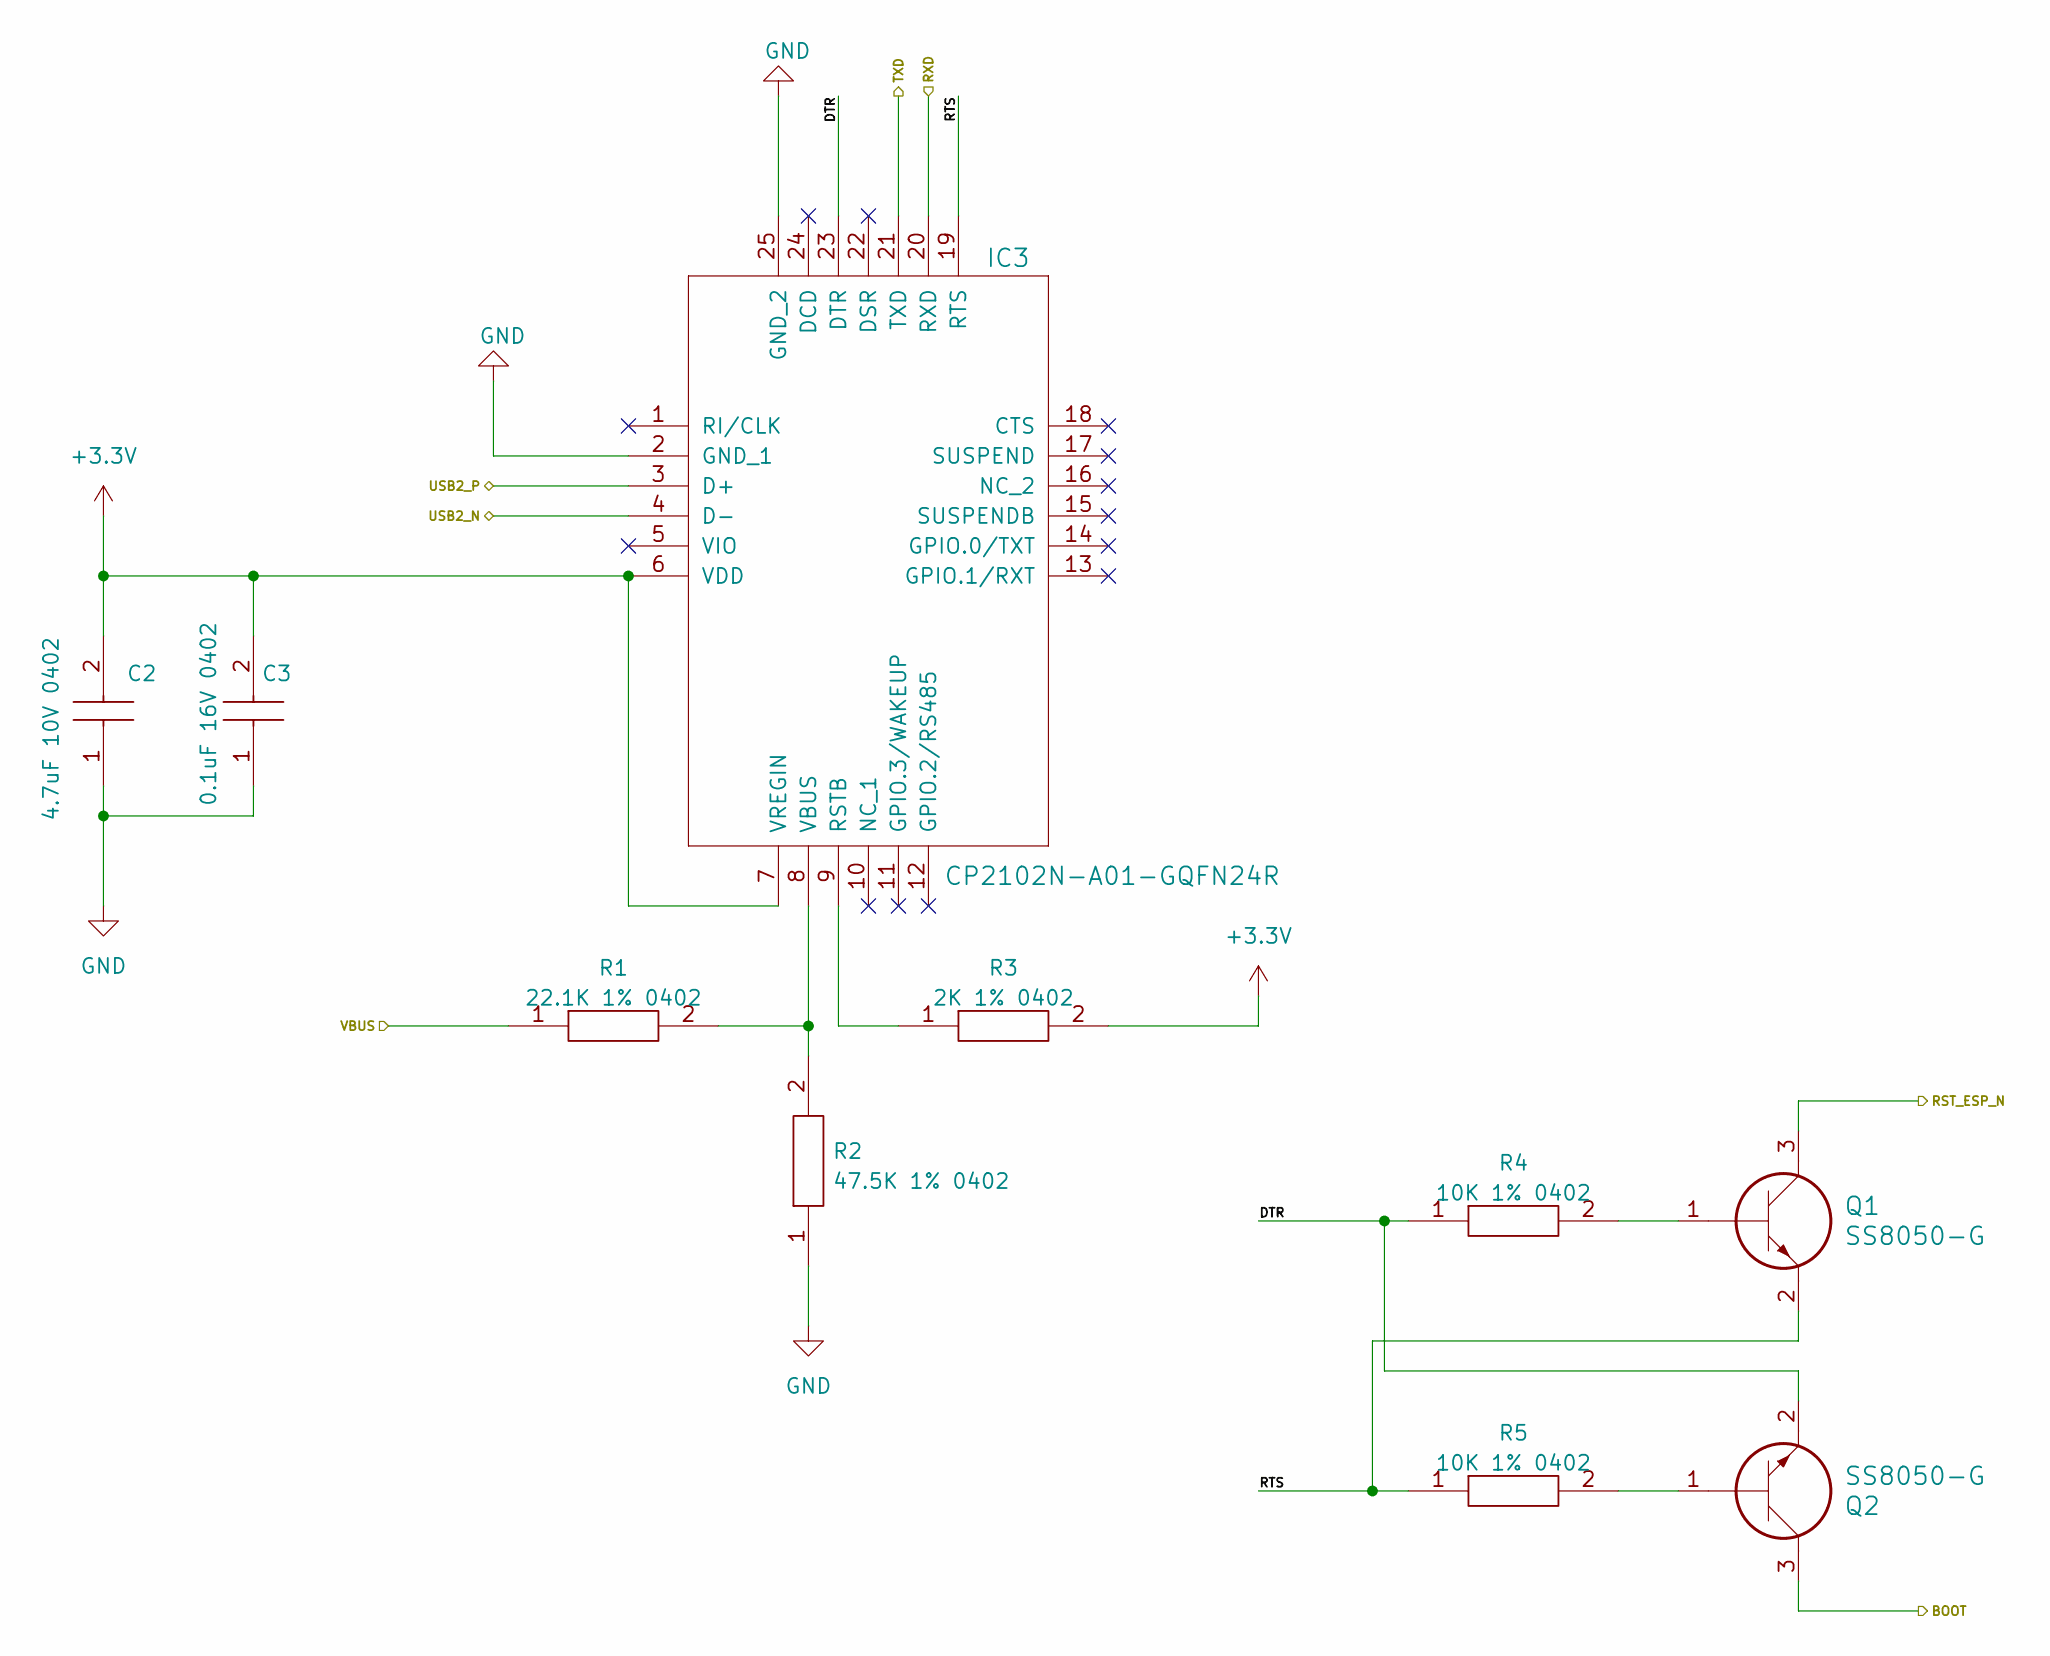
[picture p66: schematic usb_tu_uart.kicad_sch]

Parts:
C2: 4.7uF 10V 0402; C_0402_1005Metric; Manufacturer_Part_Number C1005X5R1A475K050BC; Mouser Part Number 810-C1005X5R1A475KBC
C3: 0.1uF 16V 0402; C_0402_1005Metric; Manufacturer_Part_Number GRM155R71C104KA88D; Mouser Part Number N/A
IC3: CP2102N-A01-GQFN24R; QFN50P400X400X80-25N
Q1, Q2: SS8050-G; SOT95P240X115-3N
R1: 22.1K 1% 0402; R_0402_1005Metric; Manufacturer_Part_Number CRCW040222K1FKED; Mouser Part Number 71-CRCW0402-22.1K-E3
R2: 47.5K 1% 0402; R_0402_1005Metric; Manufacturer_Part_Number RC0402FR-0747K5L; Mouser Part Number 603-RC0402FR-0747K5L
R3: 2K 1% 0402; R_0402_1005Metric; Manufacturer_Part_Number CR0402-FX-2001GLF; Mouser Part Number 652-CR0402FX-2001GLF
R4, R5: 10K 1% 0402; R_0402_1005Metric; Manufacturer_Part_Number AC0402FR-0710KL; Mouser Part Number 603-AC0402FR-0710KL

Connections:
+3.3V: C2.2, C3.2, IC3.6 (VDD), IC3.7 (VREGIN), R3.2; also elsewhere on the board
/USB2_N: IC3.4 (D-); also elsewhere on the board
/USB2_P: IC3.3 (D+); also elsewhere on the board
/esp32/BOOT: Q2.3 (C); also elsewhere on the board
/esp32/RST_ESP_N: Q1.3 (C); also elsewhere on the board
/esp32/RXD: IC3.20 (RXD); also elsewhere on the board
/esp32/TXD: IC3.21 (TXD); also elsewhere on the board
/usb_to uart/DTR: IC3.23 (DTR), Q2.2 (E), R4.1
/usb_to uart/RTS: IC3.19 (RTS), Q1.2 (E), R5.1
/usb_to uart/VBUS: R1.1; also elsewhere on the board
GND: C2.1, C3.1, IC3.2 (GND_1), IC3.25 (GND_2), R2.1; also elsewhere on the board
unnamed: IC3.8 (VBUS), R1.2, R2.2
unnamed: IC3.9 (RSTB), R3.1
unnamed: Q1.1 (B), R4.2
unnamed: Q2.1 (B), R5.2

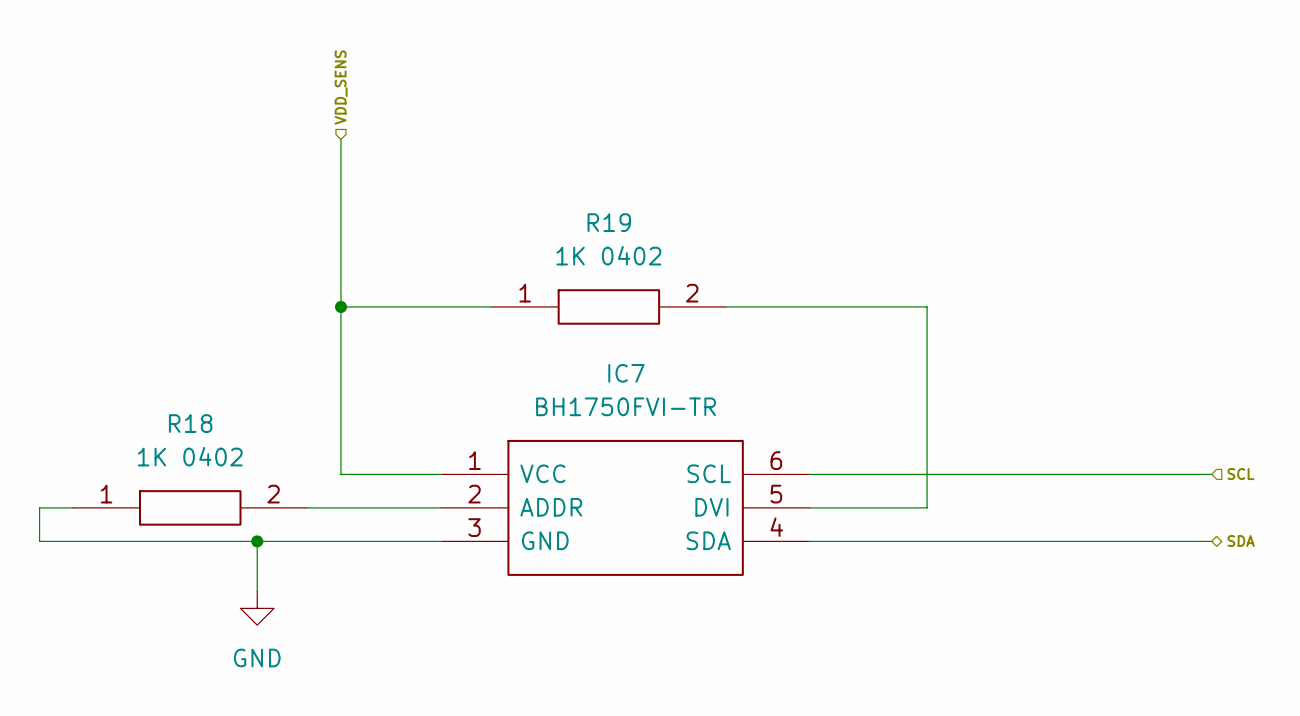
[picture p67: schematic BH1750.kicad_sch]

Parts:
IC7: BH1750FVI-TR; WSOF6; Manufacturer_Part_Number BH1750FVI-TR; Mouser Part Number 755-BH1750FVI-TR
R18, R19: 1K 0402; R_0402_1005Metric; Manufacturer_Part_Number RT0402FRE071KL; Mouser Part Number 603-RT0402FRE071KL

Connections:
/VDD_SENS: IC7.1 (VCC), R19.1; also elsewhere on the board
/esp32/SCL: IC7.6 (SCL); also elsewhere on the board
/esp32/SDA: IC7.4 (SDA); also elsewhere on the board
GND: IC7.3 (GND), R18.1; also elsewhere on the board
unnamed: IC7.2 (ADDR), R18.2
unnamed: IC7.5 (DVI), R19.2

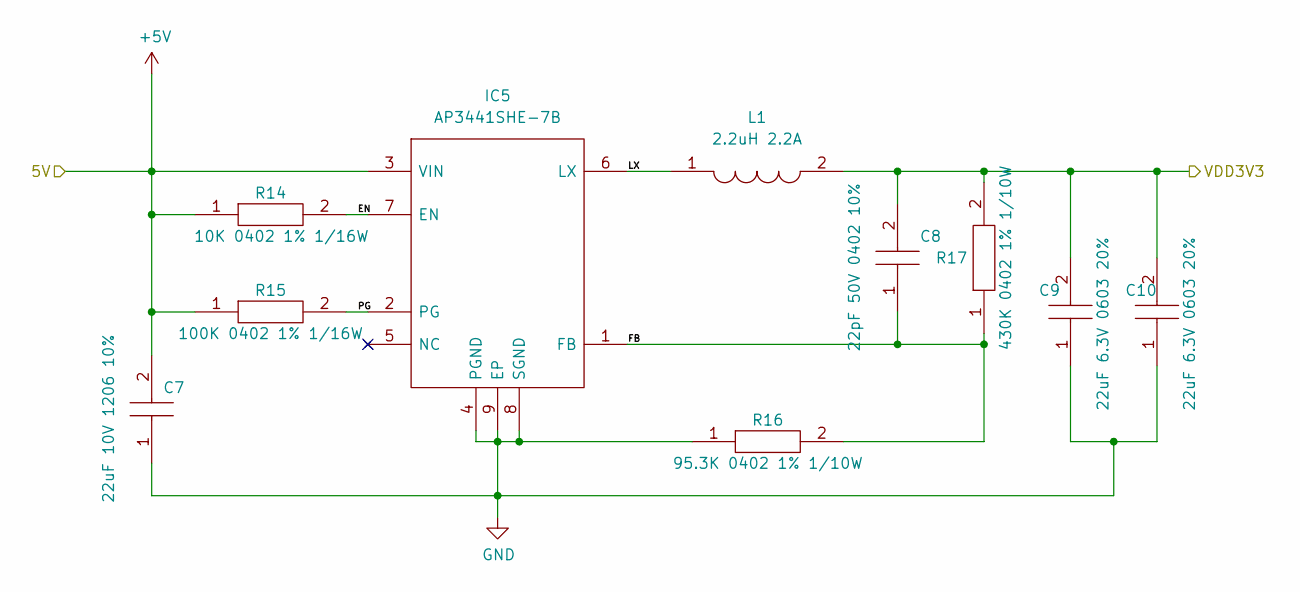
[picture p68: schematic AP3441SHE-7B_3V3.kicad_sch]

Parts:
C7: 22uF 10V 1206 10%; C_1206_3216Metric; Manufacturer_Part_Number GRM31CR71A226KE15L; Mouser Part Number 81-GRM31CR71A226K15L
C8: 22pF 50V 0402 10%; C_0402_1005Metric; Manufacturer_Part_Number C0402C220K5RACTU; Mouser Part Number 80-C0402C220K5RACTU
C9, C10: 22uF 6.3V 0603 20%; C_0603_1608Metric; Manufacturer_Part_Number GRM188R60J226MEA0D; Mouser Part Number 81-GRM188R60J226ME0D
IC5: AP3441SHE-7B; SON50P201X201X60-9N-D; Manufacturer_Part_Number AP3441SHE-7B; Mouser Part Number 621-AP3441SHE-7B
L1: 2.2uH 2.2A; DFE2HCAH1R0MJ0L; Manufacturer_Part_Number 1239AS-H-2R2M=P2; Mouser Part Number 81-1239AS-H-2R2MP2
R14: 10K 0402 1% 1/16W; R_0402_1005Metric; Manufacturer_Part_Number AC0402FR-0710KL; Mouser Part Number 603-AC0402FR-0710KL
R15: 100K 0402 1% 1/16W; R_0402_1005Metric; Manufacturer_Part_Number SFR01MZPF1003; Mouser Part Number 755-SFR01MZPF1003
R16: 95.3K 0402 1% 1/10W; R_0402_1005Metric; Manufacturer_Part_Number ERJ-U02F9532X; Mouser Part Number 667-ERJ-U02F9532X
R17: 430K 0402 1% 1/10W; R_0402_1005Metric; Manufacturer_Part_Number ERJ-U02F4303X

Connections:
+5V: C7.2, IC5.3 (VIN), R14.1, R15.1; also elsewhere on the board
/power/5V-3V3/EN: IC5.7 (EN), R14.2
/power/5V-3V3/FB: C8.1, IC5.1 (FB), R16.2, R17.1
/power/5V-3V3/LX: IC5.6 (LX), L1.1
/power/5V-3V3/PG: IC5.2 (PG), R15.2
/power/5V-3V3/VDD3V3: C8.2, C9.2, C10.2, L1.2, R17.2; also elsewhere on the board
GND: C7.1, C9.1, C10.1, IC5.4 (PGND), IC5.8 (SGND), IC5.9 (EP), R16.1; also elsewhere on the board

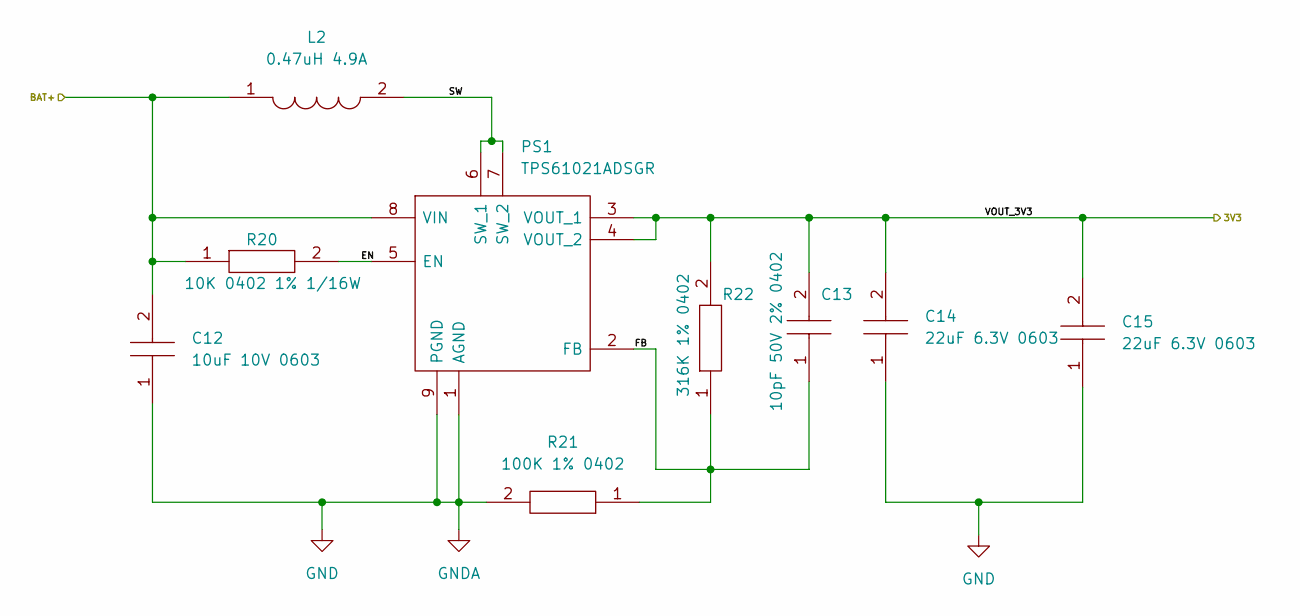
[picture p69: schematic TPS61021ADSGR.kicad_sch]

Parts:
C12: 10uF 10V 0603; C_0603_1608Metric; Manufacturer_Part_Number GRM188Z71A106KA73D; Mouser Part Number 81-GRM188Z71A106KA3D
C13: 10pF 50V 2% 0402; C_0402_1005Metric; Manufacturer_Part_Number GJM1555C1H100GB01D; Mouser Part Number 81-GJM1555C1H100GB01
C14, C15: 22uF 6.3V 0603; C_0603_1608Metric; Manufacturer_Part_Number GRM188R60J226MEA0D; Mouser Part Number 81-GRM188R60J226ME0D
L2: 0.47uH 4.9A; INDC2016X80N; Manufacturer_Part_Number TFM201610ALC-R47MTAA; Mouser Part Number 810-TFM201610ALCR47M
PS1: TPS61021ADSGR; SON50P200X200X80-9N; Manufacturer_Part_Number TPS61021ADSGR; Mouser Part Number 595-TPS61021ADSGR
R20: 10K 0402 1% 1/16W; R_0402_1005Metric; Manufacturer_Part_Number AC0402FR-0710KL; Mouser Part Number 603-AC0402FR-0710KL
R21: 100K 1% 0402; R_0402_1005Metric; Manufacturer_Part_Number SFR01MZPF1003; Mouser Part Number 755-SFR01MZPF1003
R22: 316K 1% 0402; R_0402_1005Metric; Manufacturer_Part_Number CR0402-FX-3163GLF; Mouser Part Number 652-CR0402FX3163GLF

Connections:
/power/BAT-3V3/EN: PS1.5 (EN), R20.2
/power/BAT-3V3/FB: C13.1, PS1.2 (FB), R21.1, R22.1
/power/BAT-3V3/SW: L2.2, PS1.6 (SW_1), PS1.7 (SW_2)
/power/BAT-3V3/VOUT_3V3: C13.2, C14.2, C15.2, PS1.3 (VOUT_1), PS1.4 (VOUT_2), R22.2; also elsewhere on the board
BAT+: C12.2, L2.1, PS1.8 (VIN), R20.1; also elsewhere on the board
GND: C12.1, C14.1, C15.1, PS1.1 (AGND), PS1.9 (PGND), R21.2; also elsewhere on the board
