lincvv/kicad_space/Projects/Design/vng/SoilSensor_cad_ki/esp32_moisture.kicad_pcb

## KiCad design Projects/Design/vng/SoilSensor_cad_ki/esp32_moisture.kicad_pcb (continued)

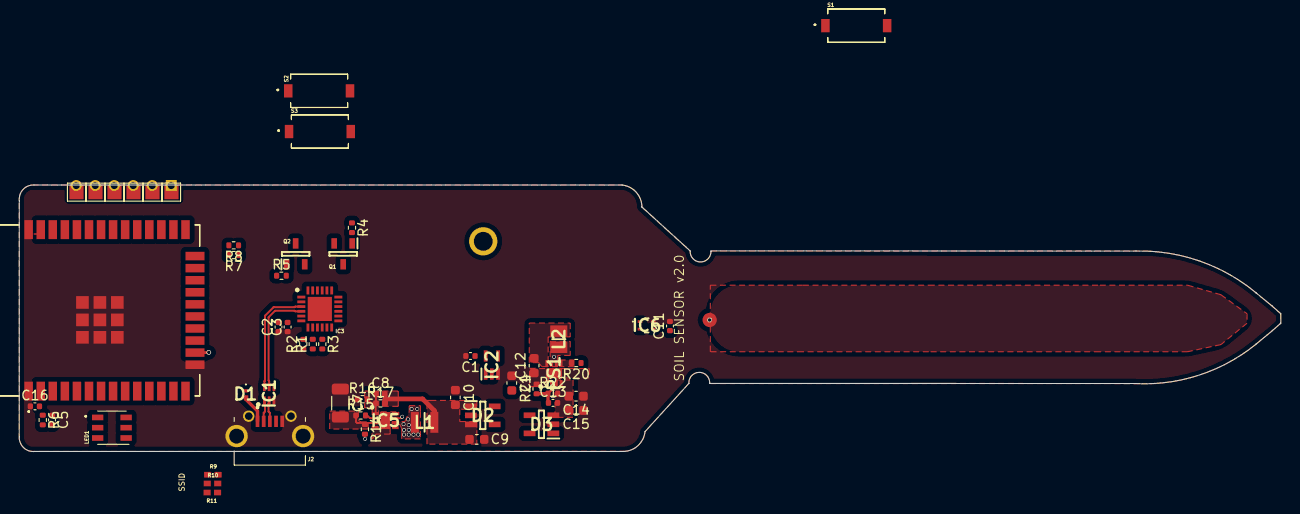
[picture p70: board esp32_moisture.kicad_pcb from above]

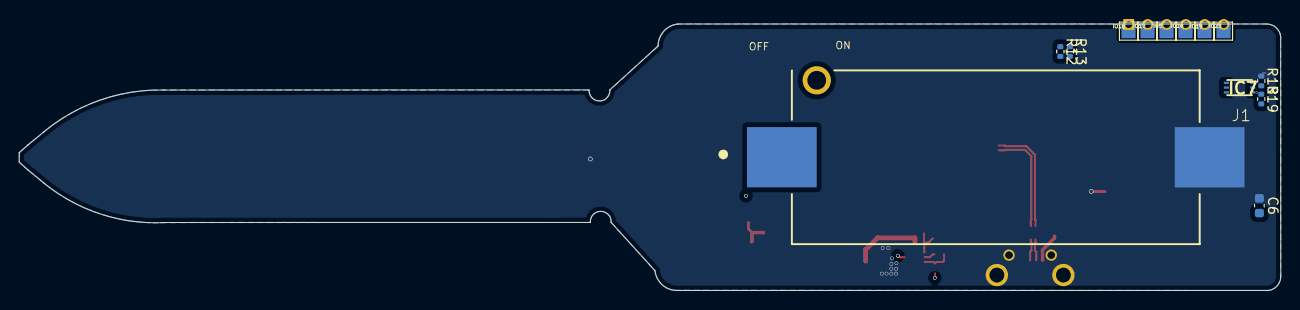
[picture p71: board esp32_moisture.kicad_pcb from below]

Board: 4 copper layers, 132.8 x 28.1 mm, 61 parts (7 on the bottom side), 51 nets.
