lincvv/kicad_space/Projects/Design/nti/dock_rs232/dock_rs232.kicad_pcb

## KiCad design Projects/Design/nti/dock_rs232/dock_rs232.kicad_pcb (2024-06-23)

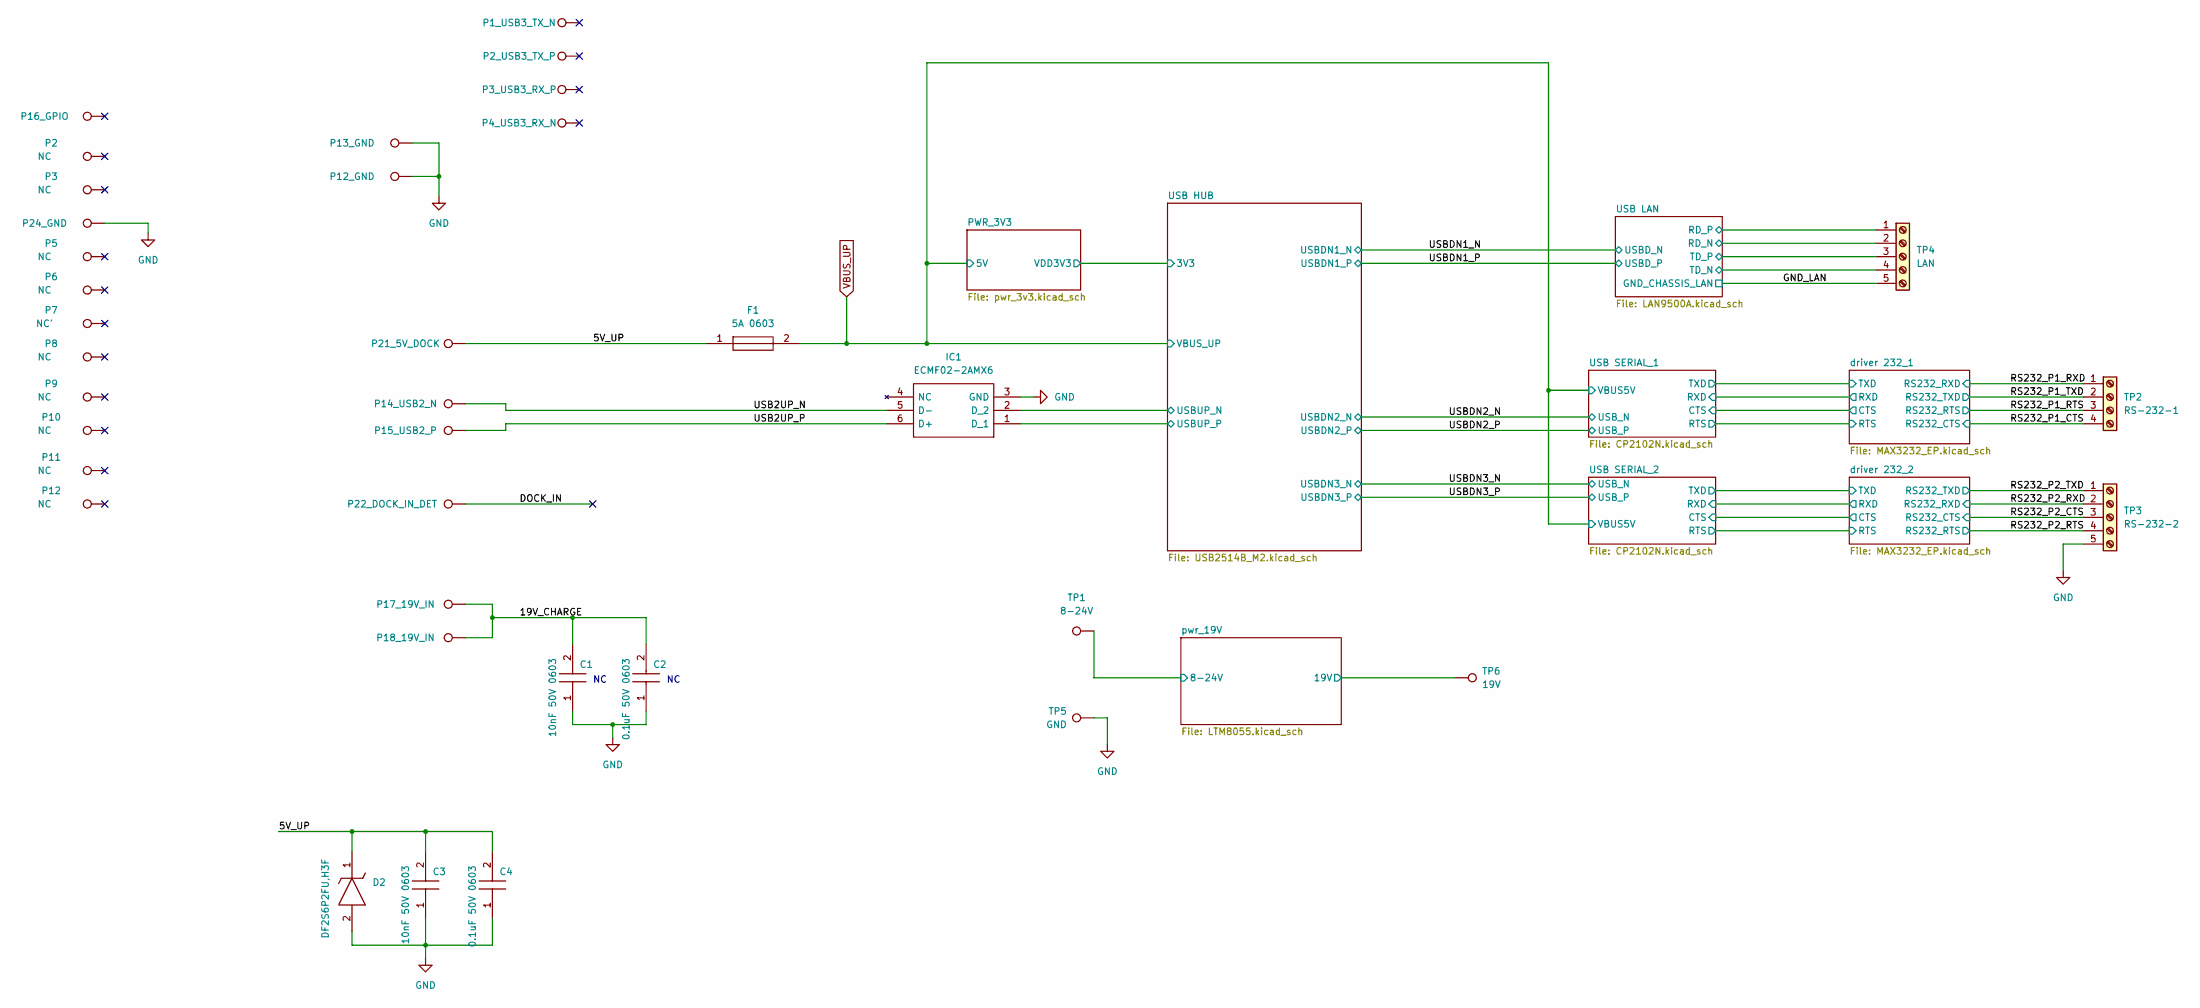
[picture p72: schematic dock_rs232.kicad_sch, DOCK USB]

Parts:
C1, C3: 10nF 50V 0603; C_0603_1608Metric; Manufacturer_Part_Number 885012206089; Mouser Part Number 710-885012206089
C2, C4: 0.1uF 50V 0603; C_0603_1608Metric; Manufacturer_Part_Number 06035C104MAT2A; Mouser Part Number 581-06035C104MAT2A
D2: DF2S6P2FU,H3F; SOD2513X115N; Mouser Part Number 757-DF2S6P2FUH3F
F1: 5A 0603; Fuse_0603_1608Metric; Manufacturer_Part_Number 0ABB-5000-TM; Mouser Part Number 530-0ABB-5000-TM
IC1: ECMF02-2AMX6; SON50P150X170X55-6N-D; Manufacturer_Part_Number ECMF02-2AMX6; Mouser Part Number 511-ECMF02-2AMX6
P1: P16_GPIO; TestPoint_THTPad_D1.0mm_Drill0.5mm
P2, P3, P5, P6, P8, P9, P10, P11, P12: NC; TestPoint_THTPad_D1.0mm_Drill0.5mm
P4: P24_GND; TestPoint_THTPad_D1.0mm_Drill0.5mm
P7: NC'; TestPoint_THTPad_D1.0mm_Drill0.5mm
P13: P13_GND; TestPoint_THTPad_D1.0mm_Drill0.5mm
P14: P12_GND; TestPoint_THTPad_D1.0mm_Drill0.5mm
P15: P21_5V_DOCK; TestPoint_THTPad_D1.0mm_Drill0.5mm
P16: P14_USB2_N; TestPoint_THTPad_D1.0mm_Drill0.5mm
P17: P15_USB2_P; TestPoint_THTPad_D1.0mm_Drill0.5mm
P18: P22_DOCK_IN_DET; TestPoint_THTPad_D1.0mm_Drill0.5mm
P19: P17_19V_IN; TestPoint_THTPad_D1.0mm_Drill0.5mm
P20: P18_19V_IN; TestPoint_THTPad_D1.0mm_Drill0.5mm
P21: P1_USB3_TX_N; TestPoint_THTPad_D1.0mm_Drill0.5mm
P22: P2_USB3_TX_P; TestPoint_THTPad_D1.0mm_Drill0.5mm
P23: P3_USB3_RX_P; TestPoint_THTPad_D1.0mm_Drill0.5mm
P24: P4_USB3_RX_N; TestPoint_THTPad_D1.0mm_Drill0.5mm
TP1: 8-24V; TestPoint_THTPad_2.5x2.5mm_Drill1.2mm
TP2: RS-232-1; PinHeader_1x04_P2.54mm_Vertical
TP3: RS-232-2; PinHeader_1x05_P2.54mm_Vertical
TP4: LAN; PinHeader_1x05_P2.00mm_Vertical
TP5: GND; TestPoint_THTPad_2.5x2.5mm_Drill1.2mm
TP6: 19V; TestPoint_THTPad_2.5x2.5mm_Drill1.2mm

Connections:
/5V_UP: C3.2, C4.2, D2.1, F1.1, P15.1
/19V_CHARGE: C1.2, C2.2, P19.1, P20.1
/DOCK_IN: P18.1
/RS232_P1_CTS: TP2.4; also elsewhere on the board
/RS232_P1_RTS: TP2.3; also elsewhere on the board
/RS232_P1_RXD: TP2.1; also elsewhere on the board
/RS232_P1_TXD: TP2.2; also elsewhere on the board
/RS232_P2_CTS: TP3.3; also elsewhere on the board
/RS232_P2_RTS: TP3.4; also elsewhere on the board
/RS232_P2_RXD: TP3.2; also elsewhere on the board
/RS232_P2_TXD: TP3.1; also elsewhere on the board
/USB2UP_N: IC1.5 (D-), P16.1
/USB2UP_P: IC1.6 (D+), P17.1
/USB HUB/USBUP_N: IC1.2 (D_2); also elsewhere on the board
/USB HUB/USBUP_P: IC1.1 (D_1); also elsewhere on the board
/USB LAN/RD_N: TP4.2; also elsewhere on the board
/USB LAN/RD_P: TP4.1; also elsewhere on the board
/USB LAN/TD_N: TP4.4; also elsewhere on the board
/USB LAN/TD_P: TP4.3; also elsewhere on the board
/pwr_19V/8-24V: TP1.1; also elsewhere on the board
/pwr_19V/19V: TP6.1; also elsewhere on the board
GND: C1.1, C2.1, C3.1, C4.1, D2.2, IC1.3 (GND), P4.1, P13.1, P14.1, TP3.5, TP5.1; also elsewhere on the board
GNDPWR: TP4.5; also elsewhere on the board
VBUS_UP: F1.2; also elsewhere on the board

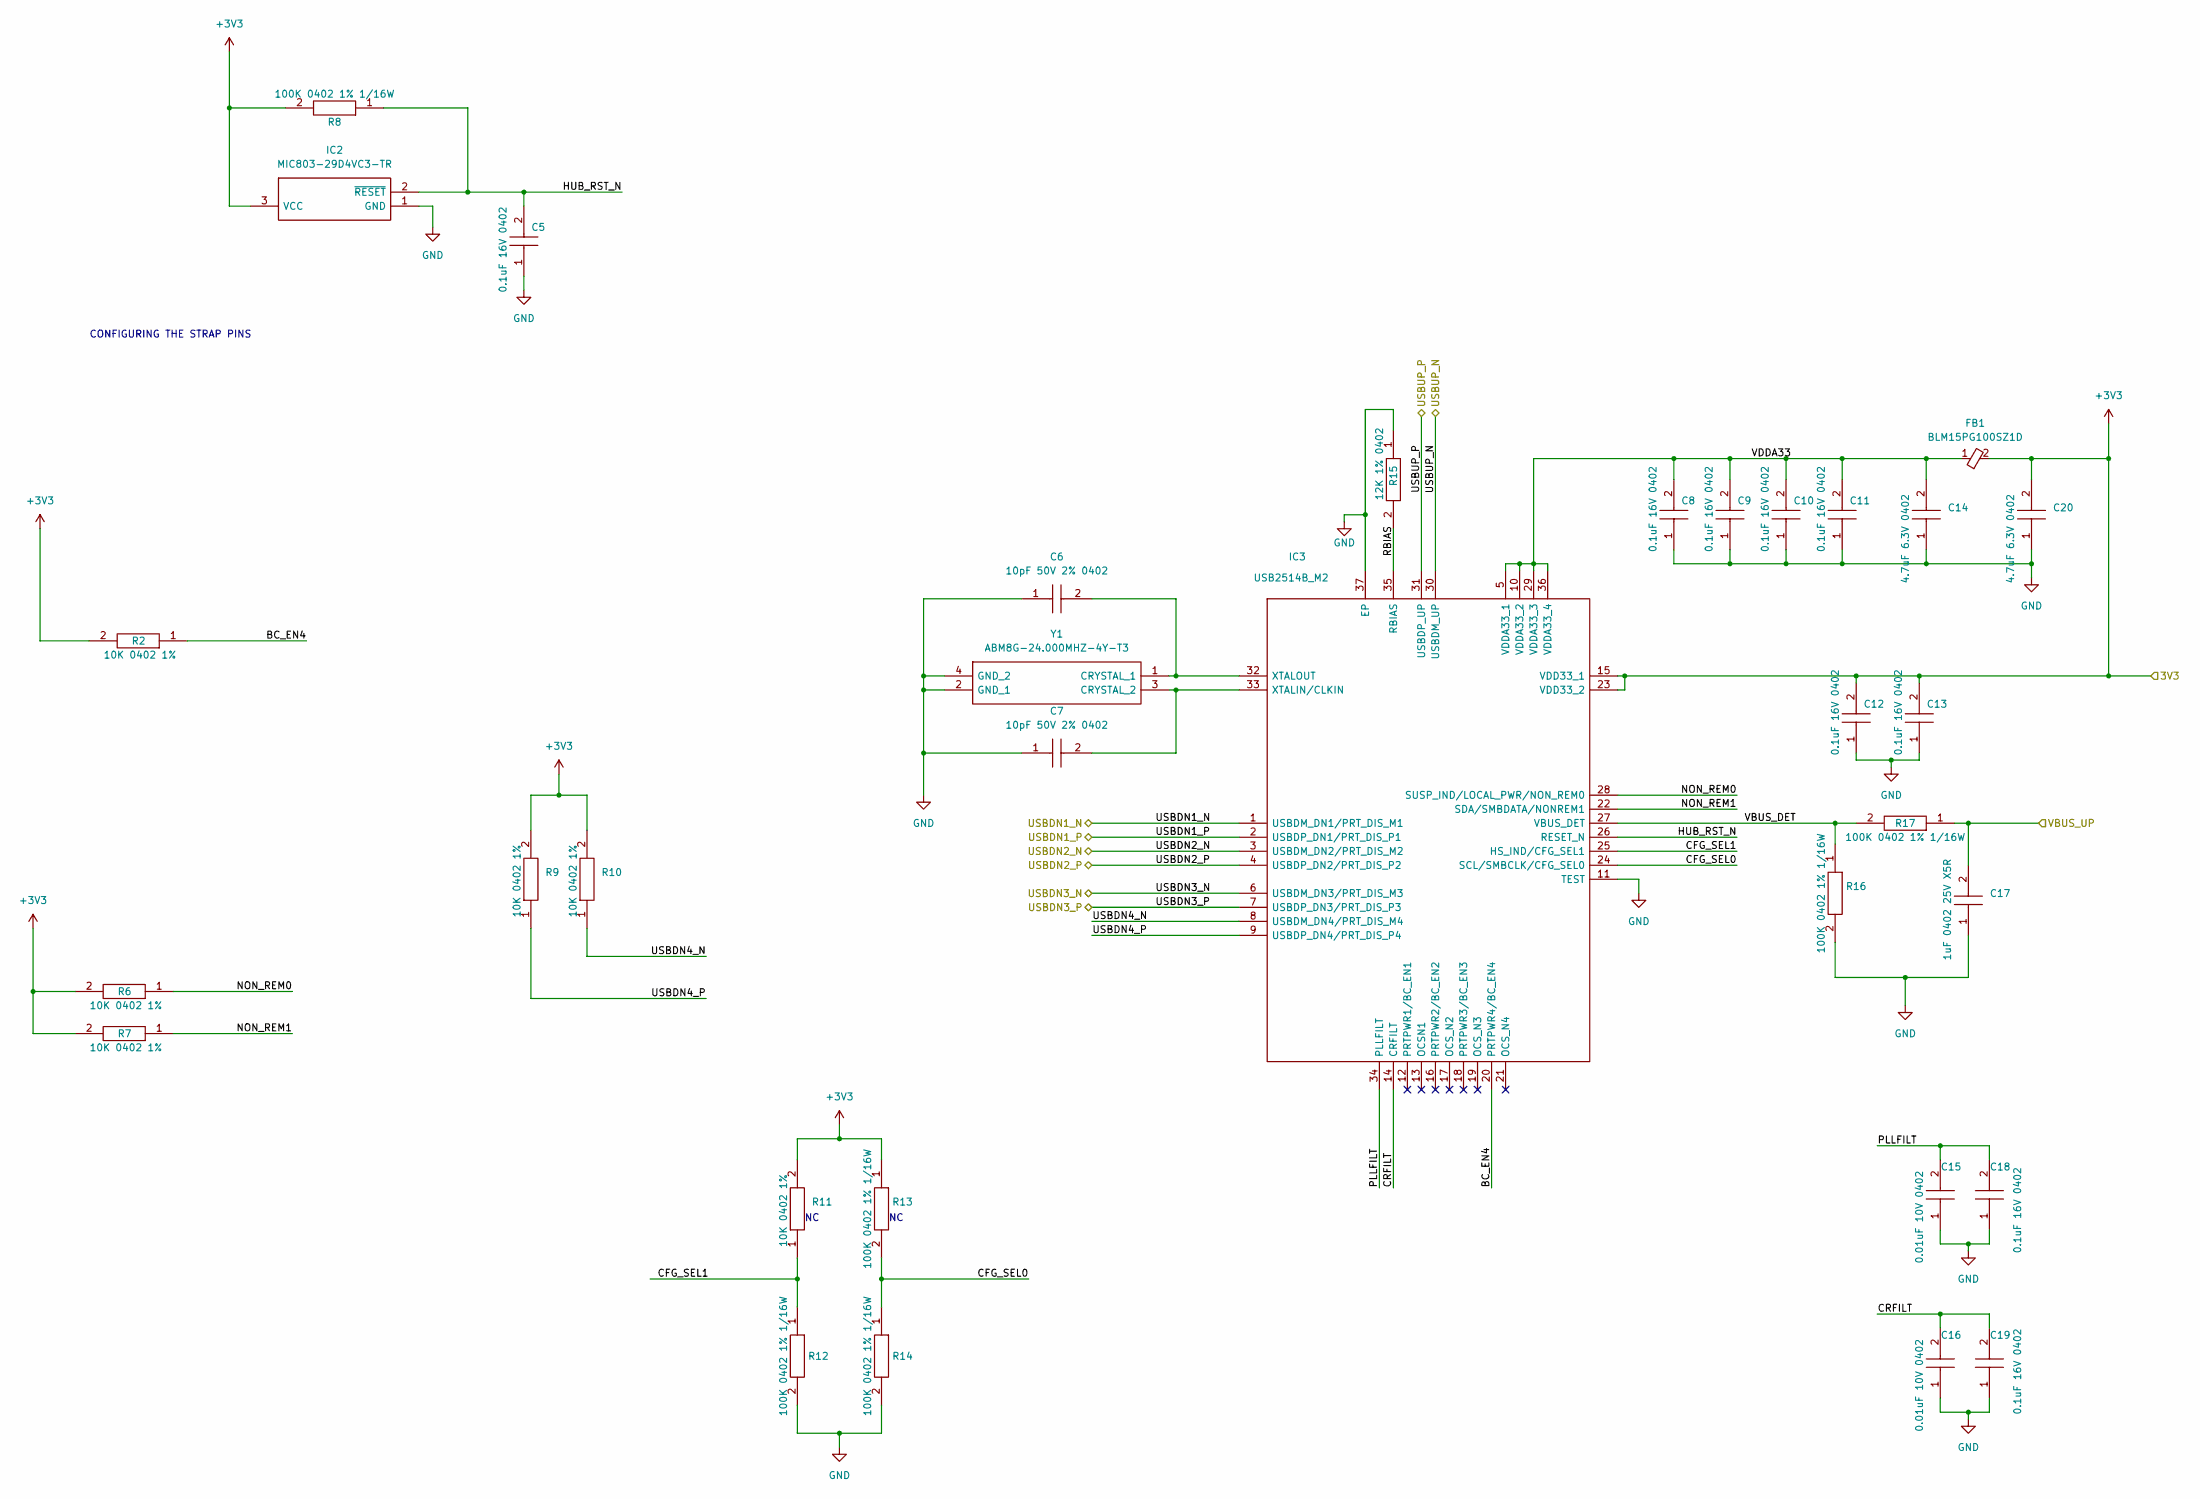
[picture p73: schematic USB2514B_M2.kicad_sch, HUB]

Parts:
C5, C8, C9, C10, C11, C12, C13, C18, C19: 0.1uF 16V 0402; C_0402_1005Metric; Manufacturer_Part_Number GRM155R71C104KA88D; Mouser Part Number N/A
C6, C7: 10pF 50V 2% 0402; C_0402_1005Metric; Manufacturer_Part_Number GJM1555C1H100GB01D; Mouser Part Number 81-GJM1555C1H100GB01
C14, C20: 4.7uF 6.3V 0402; C_0402_1005Metric; Manufacturer_Part_Number GRM155R60J475ME47D; Mouser Part Number 81-GRM155R60J475ME7D
C15, C16: 0.01uF 10V 0402; C_0402_1005Metric; Manufacturer_Part_Number 0402ZC103MAT2A; Mouser Part Number 581-0402ZC103MAT2A
C17: 1uF 0402 25V X5R; C_0402_1005Metric; Manufacturer_Part_Number GRM155R61E105KA12D; Mouser Part Number 81-GRM155R61E105KA2D
FB1: BLM15PG100SZ1D; NFZ15SG152SN10B; Manufacturer_Part_Number BLM15PG100SZ1D; Mouser Part Number 81-BLM15PG100SZ1D
IC2: MIC803-29D4VC3-TR; SOT65P210X100-3N; Manufacturer_Part_Number MIC803-29D4VC3-TR; Mouser Part Number 998-MIC803-29D4VC3TR
IC3: USB2514B_M2; QFN50P600X600X100-37N-D; Manufacturer_Part_Number USB2514B/M2; Mouser Part Number 579-USB2514B/M2
R2, R6, R7, R9, R10, R11: 10K 0402 1%; R_0402_1005Metric; Manufacturer_Part_Number AC0402FR-0710KL; Mouser Part Number 603-AC0402FR-0710KL
R8, R12, R13, R14, R16, R17: 100K 0402 1% 1/16W; R_0402_1005Metric; Manufacturer_Part_Number SFR01MZPF1003; Mouser Part Number 755-SFR01MZPF1003
R15: 12K 1% 0402; R_0402_1005Metric; Manufacturer_Part_Number ERJ-U02F1202X
Y1: ABM8G-24.000MHZ-4Y-T3; ABM8G48000MHZ18D2YT; Manufacturer_Part_Number ABM8G-24.000MHZ-4Y-T3; Mouser Part Number 815-ABM8G-24-4YT3

Connections:
+3V3: C12.2, C13.2, C20.2, FB1.2, IC2.3 (VCC), IC3.15 (VDD33_1), IC3.23 (VDD33_2), R2.2, R6.2, R7.2, R8.2, R9.2, R10.2, R11.2, R13.1; also elsewhere on the board
/USB HUB/BC_EN4: IC3.20 (PRTPWR4/BC_EN4), R2.1
/USB HUB/CFG_SEL0: IC3.24 (SCL/SMBCLK/CFG_SEL0), R13.2, R14.1
/USB HUB/CFG_SEL1: IC3.25 (HS_IND/CFG_SEL1), R11.1, R12.1
/USB HUB/CRFILT: C16.2, C19.2, IC3.14 (CRFILT)
/USB HUB/HUB_RST_N: C5.2, IC2.2 (~RESET), IC3.26 (RESET_N), R8.1
/USB HUB/NON_REM0: IC3.28 (SUSP_IND/LOCAL_PWR/NON_REM0), R6.1
/USB HUB/NON_REM1: IC3.22 (SDA/SMBDATA/NONREM1), R7.1
/USB HUB/PLLFILT: C15.2, C18.2, IC3.34 (PLLFILT)
/USB HUB/RBIAS: IC3.35 (RBIAS), R15.2
/USB HUB/USBDN4_N: IC3.8 (USBDM_DN4/PRT_DIS_M4), R10.1
/USB HUB/USBDN4_P: IC3.9 (USBDP_DN4/PRT_DIS_P4), R9.1
/USB HUB/USBUP_N: IC3.30 (USBDM_UP); also elsewhere on the board
/USB HUB/USBUP_P: IC3.31 (USBDP_UP); also elsewhere on the board
/USB HUB/VBUS_DET: IC3.27 (VBUS_DET), R16.1, R17.2
/USB HUB/VDDA33: C8.2, C9.2, C10.2, C11.2, C14.2, FB1.1, IC3.5 (VDDA33_1), IC3.10 (VDDA33_2), IC3.29 (VDDA33_3), IC3.36 (VDDA33_4)
/USBDN1_N: IC3.1 (USBDM_DN1/PRT_DIS_M1); also elsewhere on the board
/USBDN1_P: IC3.2 (USBDP_DN1/PRT_DIS_P1); also elsewhere on the board
/USBDN2_N: IC3.3 (USBDM_DN2/PRT_DIS_M2); also elsewhere on the board
/USBDN2_P: IC3.4 (USBDP_DN2/PRT_DIS_P2); also elsewhere on the board
/USBDN3_N: IC3.6 (USBDM_DN3/PRT_DIS_M3); also elsewhere on the board
/USBDN3_P: IC3.7 (USBDP_DN3/PRT_DIS_P3); also elsewhere on the board
GND: C5.1, C6.1, C7.1, C8.1, C9.1, C10.1, C11.1, C12.1, C13.1, C14.1, C15.1, C16.1, C17.1, C18.1, C19.1, C20.1, IC2.1 (GND), IC3.11 (TEST), IC3.37 (EP), R12.2, R14.2, R15.1, R16.2, Y1.2 (GND_1), Y1.4 (GND_2); also elsewhere on the board
unnamed: C6.2, IC3.32 (XTALOUT), Y1.1 (CRYSTAL_1)
unnamed: C7.2, IC3.33 (XTALIN/CLKIN), Y1.3 (CRYSTAL_2)
VBUS_UP: C17.2, R17.1; also elsewhere on the board

Notes on the sheet:
CONFIGURING THE STRAP PINS

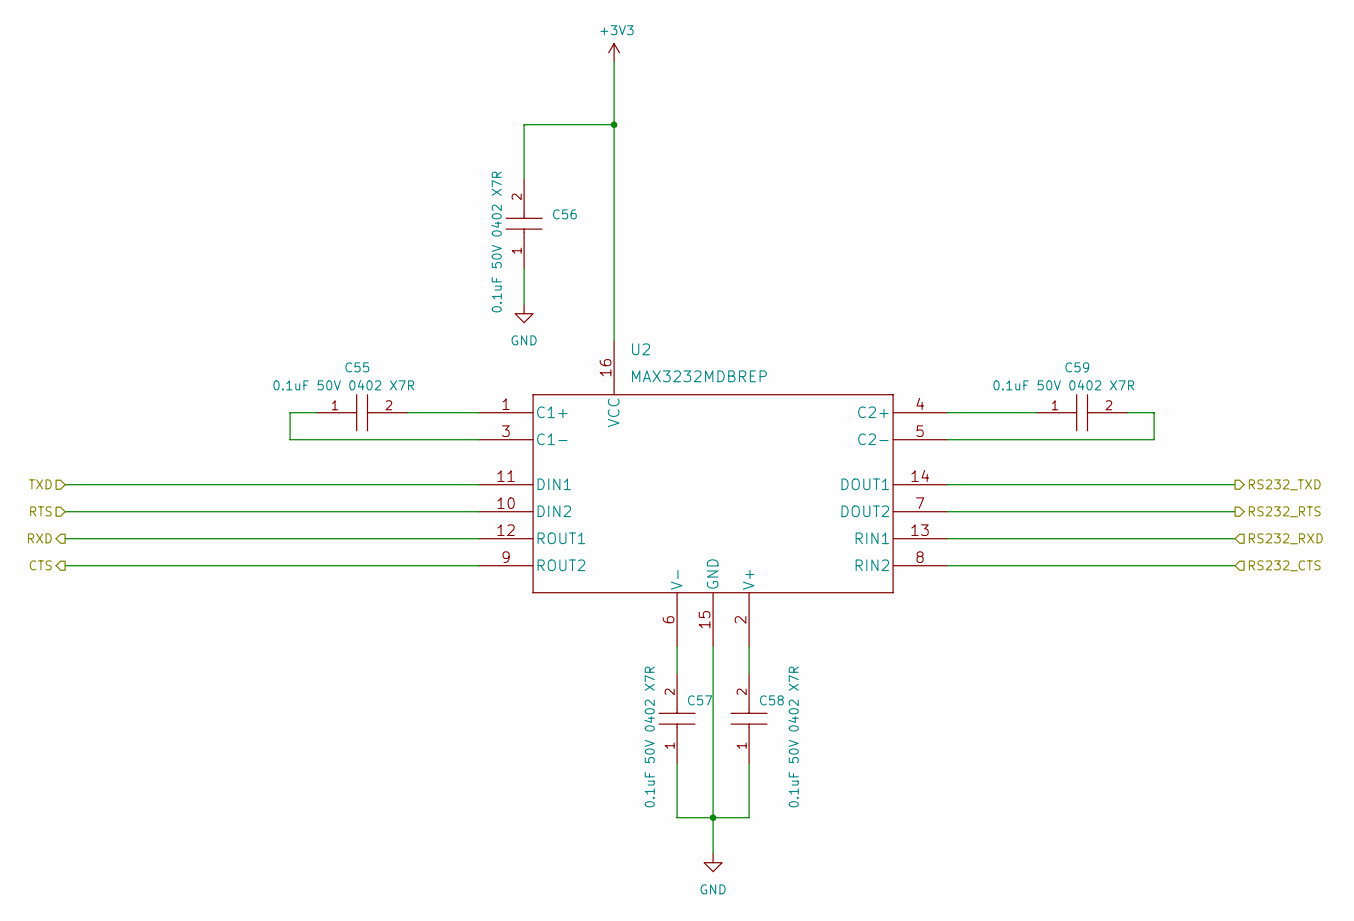
[picture p74: schematic MAX3232_EP.kicad_sch]

Parts:
C55, C56, C57, C58, C59: 0.1uF 50V 0402 X7R; C_0402_1005Metric; Manufacturer_Part_Number GRM155R71H104KE14D; Mouser Part Number 81-GRM155R71H104KE4D
U2: MAX3232MDBREP

Connections:
+3V3: C56.2, U2.16 (VCC); also elsewhere on the board
/RS232_P1_CTS: U2.8 (RIN2); also elsewhere on the board
/RS232_P1_RTS: U2.7 (DOUT2); also elsewhere on the board
/RS232_P1_RXD: U2.13 (RIN1); also elsewhere on the board
/RS232_P1_TXD: U2.14 (DOUT1); also elsewhere on the board
/USB SERIAL_1/CTS: U2.9 (ROUT2); also elsewhere on the board
/USB SERIAL_1/RTS: U2.10 (DIN2); also elsewhere on the board
/USB SERIAL_1/RXD: U2.12 (ROUT1); also elsewhere on the board
/USB SERIAL_1/TXD: U2.11 (DIN1); also elsewhere on the board
GND: C56.1, C57.1, C58.1, U2.15 (GND); also elsewhere on the board
unnamed: C55.1, U2.3 (C1-)
unnamed: C55.2, U2.1 (C1+)
unnamed: C57.2, U2.6 (V-)
unnamed: C58.2, U2.2 (V+)
unnamed: C59.1, U2.4 (C2+)
unnamed: C59.2, U2.5 (C2-)

Parts of its further copies:
C29, C30, C31, C32, C33: 0.1uF 50V 0402 X7R; C_0402_1005Metric; Manufacturer_Part_Number GRM155R71H104KE14D; Mouser Part Number 81-GRM155R71H104KE4D
U1: MAX3232MDBREP

Connections of its further copies:
+3V3: C30.2, U1.16 (VCC); also elsewhere on the board
/RS232_P2_CTS: U1.8 (RIN2); also elsewhere on the board
/RS232_P2_RTS: U1.7 (DOUT2); also elsewhere on the board
/RS232_P2_RXD: U1.13 (RIN1); also elsewhere on the board
/RS232_P2_TXD: U1.14 (DOUT1); also elsewhere on the board
/USB SERIAL_2/CTS: U1.9 (ROUT2); also elsewhere on the board
/USB SERIAL_2/RTS: U1.10 (DIN2); also elsewhere on the board
/USB SERIAL_2/RXD: U1.12 (ROUT1); also elsewhere on the board
/USB SERIAL_2/TXD: U1.11 (DIN1); also elsewhere on the board
GND: C30.1, C31.1, C32.1, U1.15 (GND); also elsewhere on the board
unnamed: C29.1, U1.3 (C1-)
unnamed: C29.2, U1.1 (C1+)
unnamed: C31.2, U1.6 (V-)
unnamed: C32.2, U1.2 (V+)
unnamed: C33.1, U1.4 (C2+)
unnamed: C33.2, U1.5 (C2-)

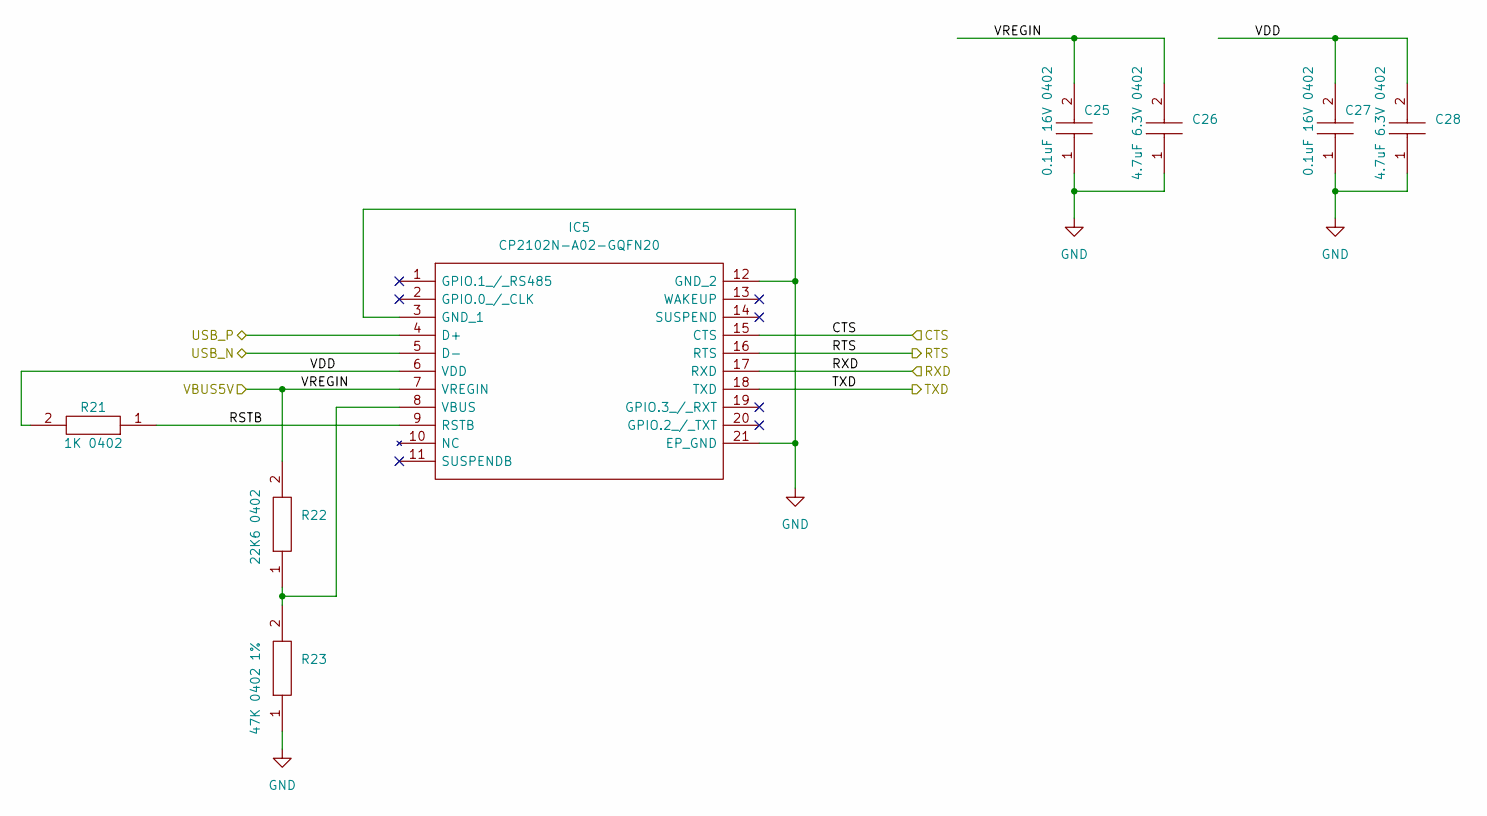
[picture p75: schematic CP2102N.kicad_sch, USB SERIAL]

Parts:
C25, C27: 0.1uF 16V 0402; C_0402_1005Metric; Manufacturer_Part_Number GRM155R71C104KA88D; Mouser Part Number N/A
C26, C28: 4.7uF 6.3V 0402; C_0402_1005Metric; Manufacturer_Part_Number GRM155R60J475ME47D; Mouser Part Number 81-GRM155R60J475ME7D
IC5: CP2102N-A02-GQFN20; CP2102NA02GQFN20; Manufacturer_Part_Number CP2102N-A02-GQFN20; Mouser Part Number 634-CP2102NA02GQFN20
R21: 1K 0402; R_0402_1005Metric; Manufacturer_Part_Number RT0402FRE071KL; Mouser Part Number 603-RT0402FRE071KL
R22: 22K6 0402; R_0402_1005Metric; Manufacturer_Part_Number CPF0402B22K6E1; Mouser Part Number 279-CPF0402B22K6E1
R23: 47K 0402 1%; R_0402_1005Metric; Manufacturer_Part_Number AT0402FRE0747KL

Connections:
/USB SERIAL_1/CTS: IC5.15 (CTS); also elsewhere on the board
/USB SERIAL_1/RSTB: IC5.9 (RSTB), R21.1
/USB SERIAL_1/RTS: IC5.16 (RTS); also elsewhere on the board
/USB SERIAL_1/RXD: IC5.17 (RXD); also elsewhere on the board
/USB SERIAL_1/TXD: IC5.18 (TXD); also elsewhere on the board
/USB SERIAL_1/VDD: C27.2, C28.2, IC5.6 (VDD), R21.2
/USBDN2_N: IC5.5 (D-); also elsewhere on the board
/USBDN2_P: IC5.4 (D+); also elsewhere on the board
GND: C25.1, C26.1, C27.1, C28.1, IC5.3 (GND_1), IC5.12 (GND_2), IC5.21 (EP_GND), R23.1; also elsewhere on the board
unnamed: IC5.8 (VBUS), R22.1, R23.2
VBUS_UP: C25.2, C26.2, IC5.7 (VREGIN), R22.2; also elsewhere on the board

Parts of its further copies:
C21, C23: 0.1uF 16V 0402; C_0402_1005Metric; Manufacturer_Part_Number GRM155R71C104KA88D; Mouser Part Number N/A
C22, C24: 4.7uF 6.3V 0402; C_0402_1005Metric; Manufacturer_Part_Number GRM155R60J475ME47D; Mouser Part Number 81-GRM155R60J475ME7D
IC4: CP2102N-A02-GQFN20; CP2102NA02GQFN20; Manufacturer_Part_Number CP2102N-A02-GQFN20; Mouser Part Number 634-CP2102NA02GQFN20
R18: 1K 0402; R_0402_1005Metric; Manufacturer_Part_Number RT0402FRE071KL; Mouser Part Number 603-RT0402FRE071KL
R19: 22K6 0402; R_0402_1005Metric; Manufacturer_Part_Number CPF0402B22K6E1; Mouser Part Number 279-CPF0402B22K6E1
R20: 47K 0402 1%; R_0402_1005Metric; Manufacturer_Part_Number AT0402FRE0747KL

Connections of its further copies:
/USB SERIAL_2/CTS: IC4.15 (CTS); also elsewhere on the board
/USB SERIAL_2/RSTB: IC4.9 (RSTB), R18.1
/USB SERIAL_2/RTS: IC4.16 (RTS); also elsewhere on the board
/USB SERIAL_2/RXD: IC4.17 (RXD); also elsewhere on the board
/USB SERIAL_2/TXD: IC4.18 (TXD); also elsewhere on the board
/USB SERIAL_2/VDD: C23.2, C24.2, IC4.6 (VDD), R18.2
/USBDN3_N: IC4.5 (D-); also elsewhere on the board
/USBDN3_P: IC4.4 (D+); also elsewhere on the board
GND: C21.1, C22.1, C23.1, C24.1, IC4.3 (GND_1), IC4.12 (GND_2), IC4.21 (EP_GND), R20.1; also elsewhere on the board
unnamed: IC4.8 (VBUS), R19.1, R20.2
VBUS_UP: C21.2, C22.2, IC4.7 (VREGIN), R19.2; also elsewhere on the board

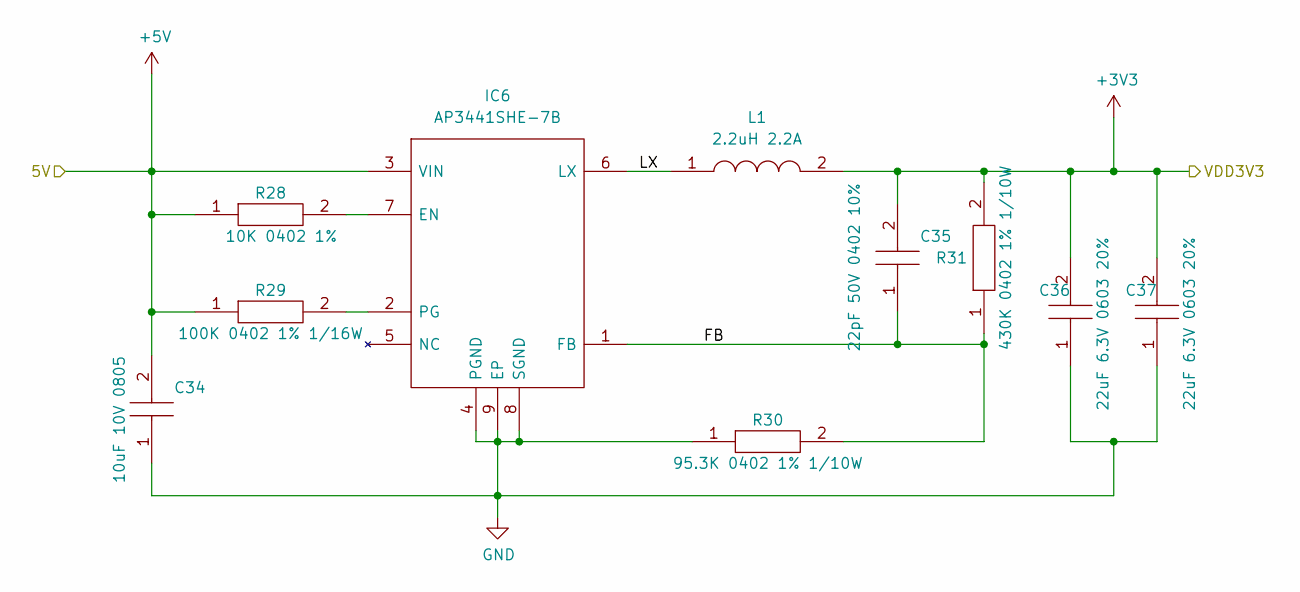
[picture p76: schematic pwr_3v3.kicad_sch]

Parts:
C34: 10uF 10V 0805; C_0805_2012Metric; Manufacturer_Part_Number LMK212ABJ106KG8T; Mouser Part Number 963-LMK212ABJ106KG8T
C35: 22pF 50V 0402 10%; C_0402_1005Metric; Manufacturer_Part_Number C0402C220K5RACTU; Mouser Part Number 80-C0402C220K5RACTU
C36, C37: 22uF 6.3V 0603 20%; C_0603_1608Metric; Manufacturer_Part_Number GRM188R60J226MEA0D; Mouser Part Number 81-GRM188R60J226ME0D
IC6: AP3441SHE-7B; SON50P201X201X60-9N-D; Manufacturer_Part_Number AP3441SHE-7B; Mouser Part Number 621-AP3441SHE-7B
L1: 2.2uH 2.2A; DFE2HCAH1R0MJ0L; Manufacturer_Part_Number 1239AS-H-2R2M=P2; Mouser Part Number 81-1239AS-H-2R2MP2
R28: 10K 0402 1%; R_0402_1005Metric; Manufacturer_Part_Number AC0402FR-0710KL; Mouser Part Number 603-AC0402FR-0710KL
R29: 100K 0402 1% 1/16W; R_0402_1005Metric; Manufacturer_Part_Number SFR01MZPF1003; Mouser Part Number 755-SFR01MZPF1003
R30: 95.3K 0402 1% 1/10W; R_0402_1005Metric; Manufacturer_Part_Number ERJ-U02F9532X; Mouser Part Number 667-ERJ-U02F9532X
R31: 430K 0402 1% 1/10W; R_0402_1005Metric; Manufacturer_Part_Number ERJ-U02F4303X

Connections:
+3V3: C35.2, C36.2, C37.2, L1.2, R31.2; also elsewhere on the board
/PWR_3V3/FB: C35.1, IC6.1 (FB), R30.2, R31.1
/PWR_3V3/LX: IC6.6 (LX), L1.1
GND: C34.1, C36.1, C37.1, IC6.4 (PGND), IC6.8 (SGND), IC6.9 (EP), R30.1; also elsewhere on the board
unnamed: IC6.2 (PG), R29.2
unnamed: IC6.7 (EN), R28.2
VBUS_UP: C34.2, IC6.3 (VIN), R28.1, R29.1; also elsewhere on the board

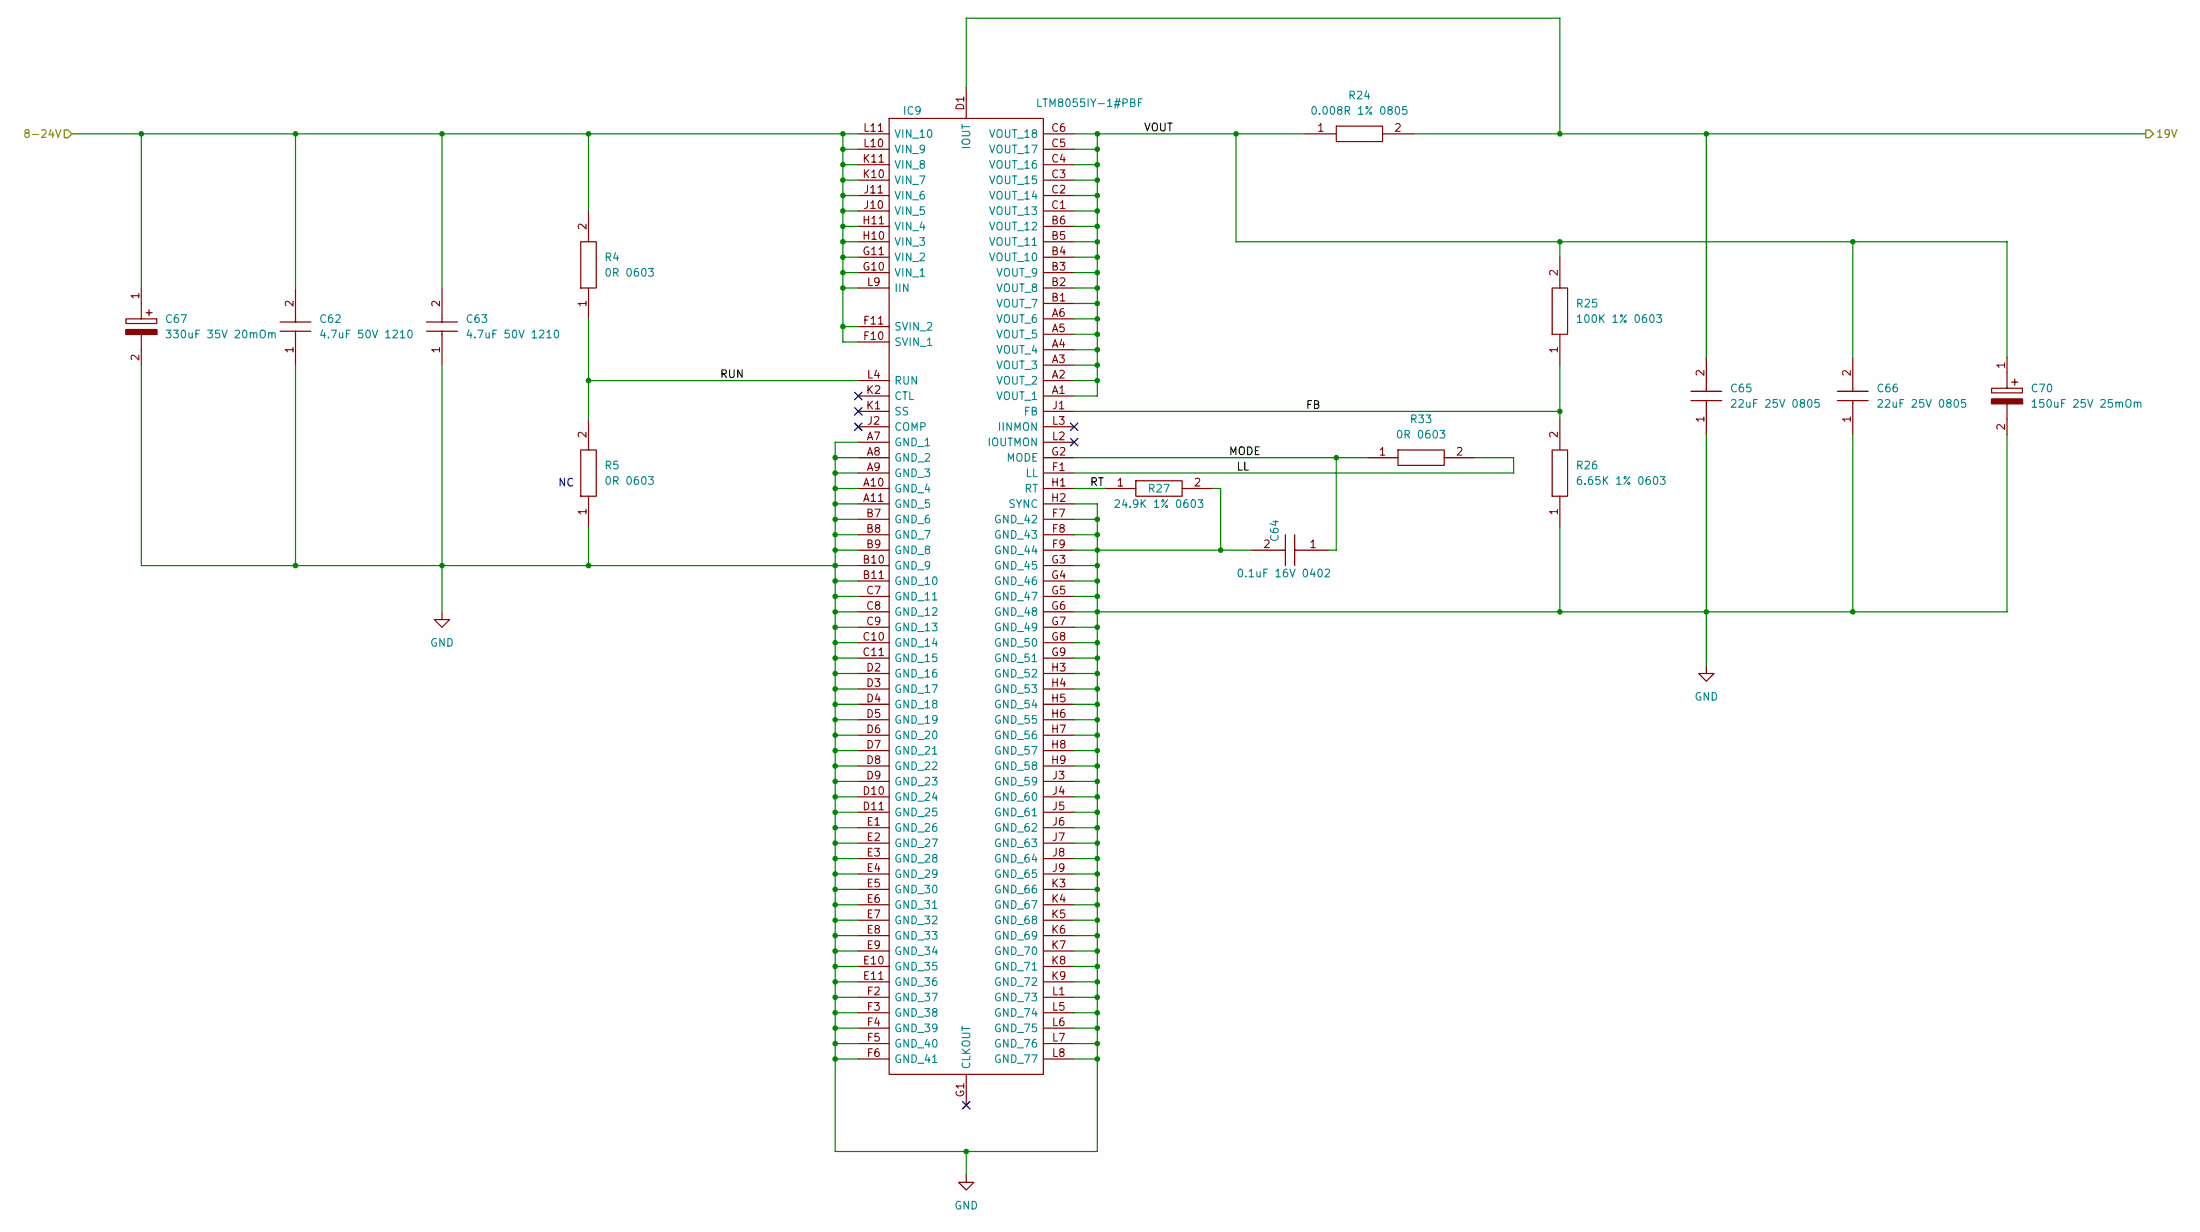
[picture p77: schematic LTM8055.kicad_sch]

Parts:
C62, C63: 4.7uF 50V 1210; C_1210_3225Metric; Manufacturer_Part_Number CC1210KFX7R9BB475; Mouser Part Number 603-CC1210KFX7R9B475
C64: 0.1uF 16V 0402; C_0402_1005Metric; Manufacturer_Part_Number GRM155R71C104KA88D; Mouser Part Number N/A
C65, C66: 22uF 25V 0805; C_0805_2012Metric; Manufacturer_Part_Number GRT21BR61E226ME13L; Mouser Part Number 81-GRT21BR61E226ME3L
C67: 330uF 35V 20mOm; CAPPRD530W65D1000H1050; Manufacturer_Part_Number EEH-AZK1V331B; Mouser Part Number 667-EEH-AZK1V331B
C70: 150uF 25V 25mOm; CAPAE1030X800N; Mouser Part Number 661-APXG250A151MJ80G
IC9: LTM8055IY-1#PBF; BGA121C127P11X11_1500X1500X512; Manufacturer_Part_Number LTM8055IY-1#PBF; Mouser Part Number 584-LTM8055IY-1#PBF
R4, R5, R33: 0R 0603; R_0603_1608Metric; Manufacturer_Part_Number ERJ-U030R00V; Mouser Part Number 667-ERJ-U030R00V
R24: 0.008R 1% 0805; RESC2012X47N; Manufacturer_Part_Number PMR10EZPFU8L00; Mouser Part Number 755-PMR10EZPFU8L00
R25: 100K 1% 0603; R_0603_1608Metric; Manufacturer_Part_Number ERJ-PA3F1003V; Mouser Part Number 667-ERJ-PA3F1003V
R26: 6.65K 1% 0603; R_0603_1608Metric; Manufacturer_Part_Number ERJ-PA3F6651V
R27: 24.9K 1% 0603; R_0603_1608Metric; Manufacturer_Part_Number CR0603-FX-2492ELF; Mouser Part Number 652-CR0603FX-2492ELF

Connections:
/pwr_19V/8-24V: C62.2, C63.2, C67.1, IC9.F10 (SVIN_1), IC9.F11 (SVIN_2), IC9.G10 (VIN_1), IC9.G11 (VIN_2), IC9.H10 (VIN_3), IC9.H11 (VIN_4), IC9.J10 (VIN_5), IC9.J11 (VIN_6), IC9.K10 (VIN_7), IC9.K11 (VIN_8), IC9.L9 (IIN), IC9.L10 (VIN_9), IC9.L11 (VIN_10), R4.2; also elsewhere on the board
/pwr_19V/19V: C65.2, IC9.D1 (IOUT), R24.2; also elsewhere on the board
/pwr_19V/FB: IC9.J1 (FB), R25.1, R26.2
/pwr_19V/LL: IC9.F1 (LL), R33.2
/pwr_19V/MODE: C64.1, IC9.G2 (MODE), R33.1
/pwr_19V/RT: IC9.H1 (RT), R27.1
/pwr_19V/RUN: IC9.L4 (RUN), R4.1, R5.2
/pwr_19V/VOUT: C66.2, C70.1, IC9.A1 (VOUT_1), IC9.A2 (VOUT_2), IC9.A3 (VOUT_3), IC9.A4 (VOUT_4), IC9.A5 (VOUT_5), IC9.A6 (VOUT_6), IC9.B1 (VOUT_7), IC9.B2 (VOUT_8), IC9.B3 (VOUT_9), IC9.B4 (VOUT_10), IC9.B5 (VOUT_11), IC9.B6 (VOUT_12), IC9.C1 (VOUT_13), IC9.C2 (VOUT_14), IC9.C3 (VOUT_15), IC9.C4 (VOUT_16), IC9.C5 (VOUT_17), IC9.C6 (VOUT_18), R24.1, R25.2
GND: C62.1, C63.1, C64.2, C65.1, C66.1, C67.2, C70.2, IC9.A7 (GND_1), IC9.A8 (GND_2), IC9.A9 (GND_3), IC9.A10 (GND_4), IC9.A11 (GND_5), IC9.B7 (GND_6), IC9.B8 (GND_7), IC9.B9 (GND_8), IC9.B10 (GND_9), IC9.B11 (GND_10), IC9.C7 (GND_11), IC9.C8 (GND_12), IC9.C9 (GND_13), IC9.C10 (GND_14), IC9.C11 (GND_15), IC9.D2 (GND_16), IC9.D3 (GND_17), IC9.D4 (GND_18), IC9.D5 (GND_19), IC9.D6 (GND_20), IC9.D7 (GND_21), IC9.D8 (GND_22), IC9.D9 (GND_23), IC9.D10 (GND_24), IC9.D11 (GND_25), IC9.E1 (GND_26), IC9.E2 (GND_27), IC9.E3 (GND_28), IC9.E4 (GND_29), IC9.E5 (GND_30), IC9.E6 (GND_31), IC9.E7 (GND_32), IC9.E8 (GND_33), IC9.E9 (GND_34), IC9.E10 (GND_35), IC9.E11 (GND_36), IC9.F2 (GND_37), IC9.F3 (GND_38), IC9.F4 (GND_39), IC9.F5 (GND_40), IC9.F6 (GND_41), IC9.F7 (GND_42), IC9.F8 (GND_43), IC9.F9 (GND_44), IC9.G3 (GND_45), IC9.G4 (GND_46), IC9.G5 (GND_47), IC9.G6 (GND_48), IC9.G7 (GND_49), IC9.G8 (GND_50), IC9.G9 (GND_51), IC9.H2 (SYNC), IC9.H3 (GND_52), IC9.H4 (GND_53), IC9.H5 (GND_54), IC9.H6 (GND_55), IC9.H7 (GND_56), IC9.H8 (GND_57), IC9.H9 (GND_58), IC9.J3 (GND_59), IC9.J4 (GND_60), IC9.J5 (GND_61), IC9.J6 (GND_62), IC9.J7 (GND_63), IC9.J8 (GND_64), IC9.J9 (GND_65), IC9.K3 (GND_66), IC9.K4 (GND_67), IC9.K5 (GND_68), IC9.K6 (GND_69), IC9.K7 (GND_70), IC9.K8 (GND_71), IC9.K9 (GND_72), IC9.L1 (GND_73), IC9.L5 (GND_74), IC9.L6 (GND_75), IC9.L7 (GND_76), IC9.L8 (GND_77), R5.1, R26.1, R27.2; also elsewhere on the board
