lincvv/kicad_space/Projects/Design/nti/dock_rs232/dock_rs232_prt.kicad_pcb

## KiCad design Projects/Design/nti/dock_rs232/dock_rs232_prt.kicad_pcb (2024-06-23)

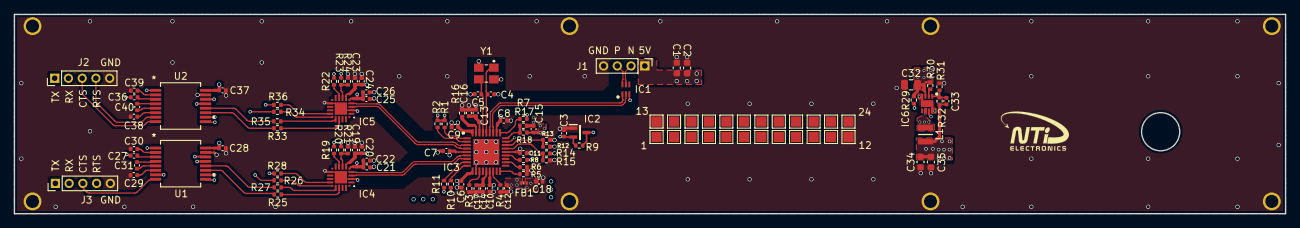
[picture p81: board dock_rs232_prt.kicad_pcb from above]

Board: 4 copper layers, 185.0 x 29.0 mm, 114 parts (0 on the bottom side), 77 nets.

Parts:
C1: 10nF 50V; C_0603_1608Metric
C2: 0.1uF 50V; C_0603_1608Metric
C3, C6, C7, C8, C9, C10, C11, C19, C21, C23, C25: 0.1uF 16V 0402; C_0402_1005Metric
C4, C5: 10pF 2%; C_0402_1005Metric
C12, C18: 4.7uF 6.3V; C_0402_1005Metric
C13, C14: 0.01uF 10V; C_0402_1005Metric
C15: 1uF 0402 25V X5R; C_0402_1005Metric
C16, C17: 0.1uF 16V; C_0402_1005Metric
C20, C22, C24, C26: 4.7uF 6V3 0402; C_0402_1005Metric
C27, C28, C29, C30, C31, C36, C37, C38, C39, C40: 0.1uF 0402 X7R; C_0402_1005Metric
C32: 10uF 10V 0805; C_0805_2012Metric
C33: 22pF 50V 0402 10%; C_0402_1005Metric
C34, C35: 22uF 6.3V 0603 20%; C_0603_1608Metric
FB1: BLM15PG100SZ1D; NFZ15SG152SN10B
IC1: ECMF02-2AMX6; SON50P150X170X55-6N-D
IC2: MIC803-29D2VC3-TR; SOT65P210X100-3N
IC3: USB2514B_M2; QFN50P600X600X100-37N-D
IC4, IC5: CP2102N-A02-GQFN20; CP2102NA02GQFN20
IC6: AP3441SHE-7B; SON50P201X201X60-9N-D
J1: Screw_Terminal_01x04; PinHeader_1x04_P2.00mm_Vertical
J2, J3: Screw_Terminal_01x05; PinHeader_1x05_P2.00mm_Vertical
L1: 2.2uH 2.2A; DFE2HCAH1R0MJ0L
P1, P2, P3, P4, P5, P6, P7, P8, P9, P11: NC; TestPoint_Pad_1.5x1.5mm
P10: NC'; TestPoint_Pad_1.5x1.5mm
P12: GPIO; TestPoint_Pad_1.5x1.5mm
P13: USB3_TX_N; TestPoint_Pad_1.5x1.5mm
P14: USB3_TX_P; TestPoint_Pad_1.5x1.5mm
P15: USB3_RX_P; TestPoint_Pad_1.5x1.5mm
P16: USB3_RX_N; TestPoint_Pad_1.5x1.5mm
P17, P18: GND; TestPoint_Pad_1.5x1.5mm
P19, P20: GHARGE_19V; TestPoint_Pad_1.5x1.5mm
P21: +5V_DOCK; TestPoint_Pad_1.5x1.5mm
P22: USB2__N; TestPoint_Pad_1.5x1.5mm
P23: USB2_P; TestPoint_Pad_1.5x1.5mm
P24: DOCK_IN_DET; TestPoint_Pad_1.5x1.5mm
R1, R2, R7, R8, R10, R11, R12: 10K 0402 1%; R_0402_1005Metric
R3, R4, R5, R6, R9, R13, R14, R15, R17, R18, R30: 100K 0402 1% 1/16W; R_0402_1005Metric
R16: 12K 1%; R_0402_1005Metric
R19, R22: 1K 0402; R_0402_1005Metric
R20, R23: 22K6 0402; R_0402_1005Metric
R21, R24: 47K 0402; R_0402_1005Metric
R25, R26, R27, R28, R33, R34, R35, R36: 0R 0402; R_0402_1005Metric
R29: 10K 0402 1% 1/16W; R_0402_1005Metric
R31: 95.3K 0402 1% 1/10W; R_0402_1005Metric
R32: 430K 0402 1% 1/10W; R_0402_1005Metric
U1, U2: MAX3232MDBREP
Y1: ABM8G-24.000MHZ-4Y-T3; ABM8G48000MHZ18D2YT

Connections:
+3V3: C10.2, C11.2, C18.2, C28.2, C33.2, C34.2, C35.2, C37.2, FB1.2, IC2.3 (VCC), IC3.15 (VDD33_1), IC3.23 (VDD33_2), L1.2, R1.2, R2.2, R7.2, R8.2, R9.2, R10.2, R11.2, R12.2, R14.1, R32.2, U1.16 (VCC), U2.16 (VCC)
/PWR_3V3/FB: C33.1, IC6.1 (FB), R31.2, R32.1
/PWR_3V3/LX: IC6.6 (LX), L1.1
/RS232_P1_CTS: J2.3, U2.8 (RIN2)
/RS232_P1_RTS: J2.4, U2.7 (DOUT2)
/RS232_P1_RXD: J2.2, U2.13 (RIN1)
/RS232_P1_TXD: J2.1, U2.14 (DOUT1)
/RS232_P2_CTS: J3.3, U1.8 (RIN2)
/RS232_P2_RTS: J3.4, U1.7 (DOUT2)
/RS232_P2_RXD: J3.2, U1.13 (RIN1)
/RS232_P2_TXD: J3.1, U1.14 (DOUT1)
/USB2UP_N: IC1.5 (D-), J1.2
/USB2UP_P: IC1.6 (D+), J1.3
/USB HUB/BC_EN1: IC3.12 (PRTPWR1/BC_EN1), R3.2
/USB HUB/BC_EN2: IC3.16 (PRTPWR2/BC_EN2), R4.2
/USB HUB/BC_EN3: IC3.18 (PRTPWR3/BC_EN3), R5.2
/USB HUB/BC_EN4: IC3.20 (PRTPWR4/BC_EN4), R6.2
/USB HUB/CFG_SEL0: IC3.24 (SCL/SMBCLK/CFG_SEL0), R14.2, R15.1
/USB HUB/CFG_SEL1: IC3.25 (HS_IND/CFG_SEL1), R12.1, R13.1
/USB HUB/CRFILT: C14.2, C17.2, IC3.14 (CRFILT)
/USB HUB/HUB_RST_N: C3.2, IC2.2 (~RESET), IC3.26 (RESET_N), R9.1
/USB HUB/NON_REM0: IC3.28 (SUSP_IND/LOCAL_PWR/NON_REM0), R7.1
/USB HUB/NON_REM1: IC3.22 (SDA/SMBDATA/NONREM1), R8.1
/USB HUB/PLLFILT: C13.2, C16.2, IC3.34 (PLLFILT)
/USB HUB/USBDN4_N: IC3.8 (USBDM_DN4/PRT_DIS_M4), R11.1
/USB HUB/USBDN4_P: IC3.9 (USBDP_DN4/PRT_DIS_P4), R10.1
/USB HUB/USBUP_N: IC1.2 (D_2), IC3.30 (USBDM_UP)
/USB HUB/USBUP_P: IC1.1 (D_1), IC3.31 (USBDP_UP)
/USB HUB/VBUS_DET: IC3.27 (VBUS_DET), R17.1, R18.2
/USB HUB/VDDA33: C6.2, C7.2, C8.2, C9.2, C12.2, FB1.1, IC3.5 (VDDA33_1), IC3.10 (VDDA33_2), IC3.29 (VDDA33_3), IC3.36 (VDDA33_4)
/USB SERIAL_1/CTS: IC5.15 (CTS), R36.1
/USB SERIAL_1/RTS: IC5.16 (RTS), R34.1
/USB SERIAL_1/RXD: IC5.17 (RXD), R35.1
/USB SERIAL_1/TXD: IC5.18 (TXD), R33.1
/USB SERIAL_1/VDD: C25.2, C26.2, IC5.6 (VDD), R22.2
/USB SERIAL_2/CTS: IC4.15 (CTS), R28.1
/USB SERIAL_2/RTS: IC4.16 (RTS), R26.1
/USB SERIAL_2/RXD: IC4.17 (RXD), R27.1
/USB SERIAL_2/TXD: IC4.18 (TXD), R25.1
/USB SERIAL_2/VDD: C21.2, C22.2, IC4.6 (VDD), R19.2
/USBDN1_N: IC3.1 (USBDM_DN1/PRT_DIS_M1), R1.1
/USBDN1_P: IC3.2 (USBDP_DN1/PRT_DIS_P1), R2.1
/USBDN2_N: IC3.3 (USBDM_DN2/PRT_DIS_M2), IC5.5 (D-)
/USBDN2_P: IC3.4 (USBDP_DN2/PRT_DIS_P2), IC5.4 (D+)
/USBDN3_N: IC3.6 (USBDM_DN3/PRT_DIS_M3), IC4.5 (D-)
/USBDN3_P: IC3.7 (USBDP_DN3/PRT_DIS_P3), IC4.4 (D+)
/driver 232_1/DIN1: R33.2, U2.11 (DIN1)
/driver 232_1/DIN2: R34.2, U2.10 (DIN2)
/driver 232_1/ROUT1: R35.2, U2.12 (ROUT1)
/driver 232_1/ROUT2: R36.2, U2.9 (ROUT2)
/driver 232_2/DIN1: R25.2, U1.11 (DIN1)
/driver 232_2/DIN2: R26.2, U1.10 (DIN2)
/driver 232_2/ROUT1: R27.2, U1.12 (ROUT1)
/driver 232_2/ROUT2: R28.2, U1.9 (ROUT2)
GND: C1.1, C2.1, C3.1, C4.1, C5.1, C6.1, C7.1, C8.1, C9.1, C10.1, C11.1, C12.1, C13.1, C14.1, C15.1, C16.1, C17.1, C18.1, C19.1, C20.1, C21.1, C22.1, C23.1, C24.1, C25.1, C26.1, C28.1, C29.1, C30.1, C32.1, C34.1, C35.1, C37.1, C38.1, C39.1, IC1.3 (GND), IC2.1 (GND), IC3.11 (TEST), IC3.37 (EP), IC4.3 (GND_1), IC4.12 (GND_2), IC4.21 (EP_GND), IC5.3 (GND_1), IC5.12 (GND_2), IC5.21 (EP_GND), IC6.4 (PGND), IC6.8 (SGND), IC6.9 (EP), J1.4, J2.5, J3.5, P17.1, P18.1, R3.1, R4.1, R5.1, R6.1, R13.2, R15.2, R16.1, R17.2, R21.1, R24.1, R31.1, U1.15 (GND), U2.15 (GND), Y1.2 (GND_1), Y1.4 (GND_2)
unnamed: C4.2, IC3.32 (XTALOUT), Y1.1 (CRYSTAL_1)
unnamed: C5.2, IC3.33 (XTALIN/CLKIN), Y1.3 (CRYSTAL_2)
unnamed: C27.1, U1.3 (C1-)
unnamed: C27.2, U1.1 (C1+)
unnamed: C29.2, U1.6 (V-)
unnamed: C30.2, U1.2 (V+)
unnamed: C31.1, U1.4 (C2+)
unnamed: C31.2, U1.5 (C2-)
unnamed: C36.1, U2.3 (C1-)
unnamed: C36.2, U2.1 (C1+)
unnamed: C38.2, U2.6 (V-)
unnamed: C39.2, U2.2 (V+)
unnamed: C40.1, U2.4 (C2+)
unnamed: C40.2, U2.5 (C2-)
unnamed: IC3.35 (RBIAS), R16.2
unnamed: IC4.8 (VBUS), R20.1, R21.2
unnamed: IC4.9 (RSTB), R19.1
unnamed: IC5.8 (VBUS), R23.1, R24.2
unnamed: IC5.9 (RSTB), R22.1
unnamed: IC6.2 (PG), R30.2
unnamed: IC6.7 (EN), R29.2
VBUS_UP: C1.2, C2.2, C15.2, C19.2, C20.2, C23.2, C24.2, C32.2, IC4.7 (VREGIN), IC5.7 (VREGIN), IC6.3 (VIN), J1.1, R18.1, R20.2, R23.2, R29.1, R30.1
