lincvv/kicad_space/Projects/Design/nti/Pi-Zero_Relay/Pi Zero_Relay.kicad_pcb

## KiCad design Projects/Design/nti/Pi-Zero_Relay/Pi Zero_Relay.kicad_pcb (2024-06-23)

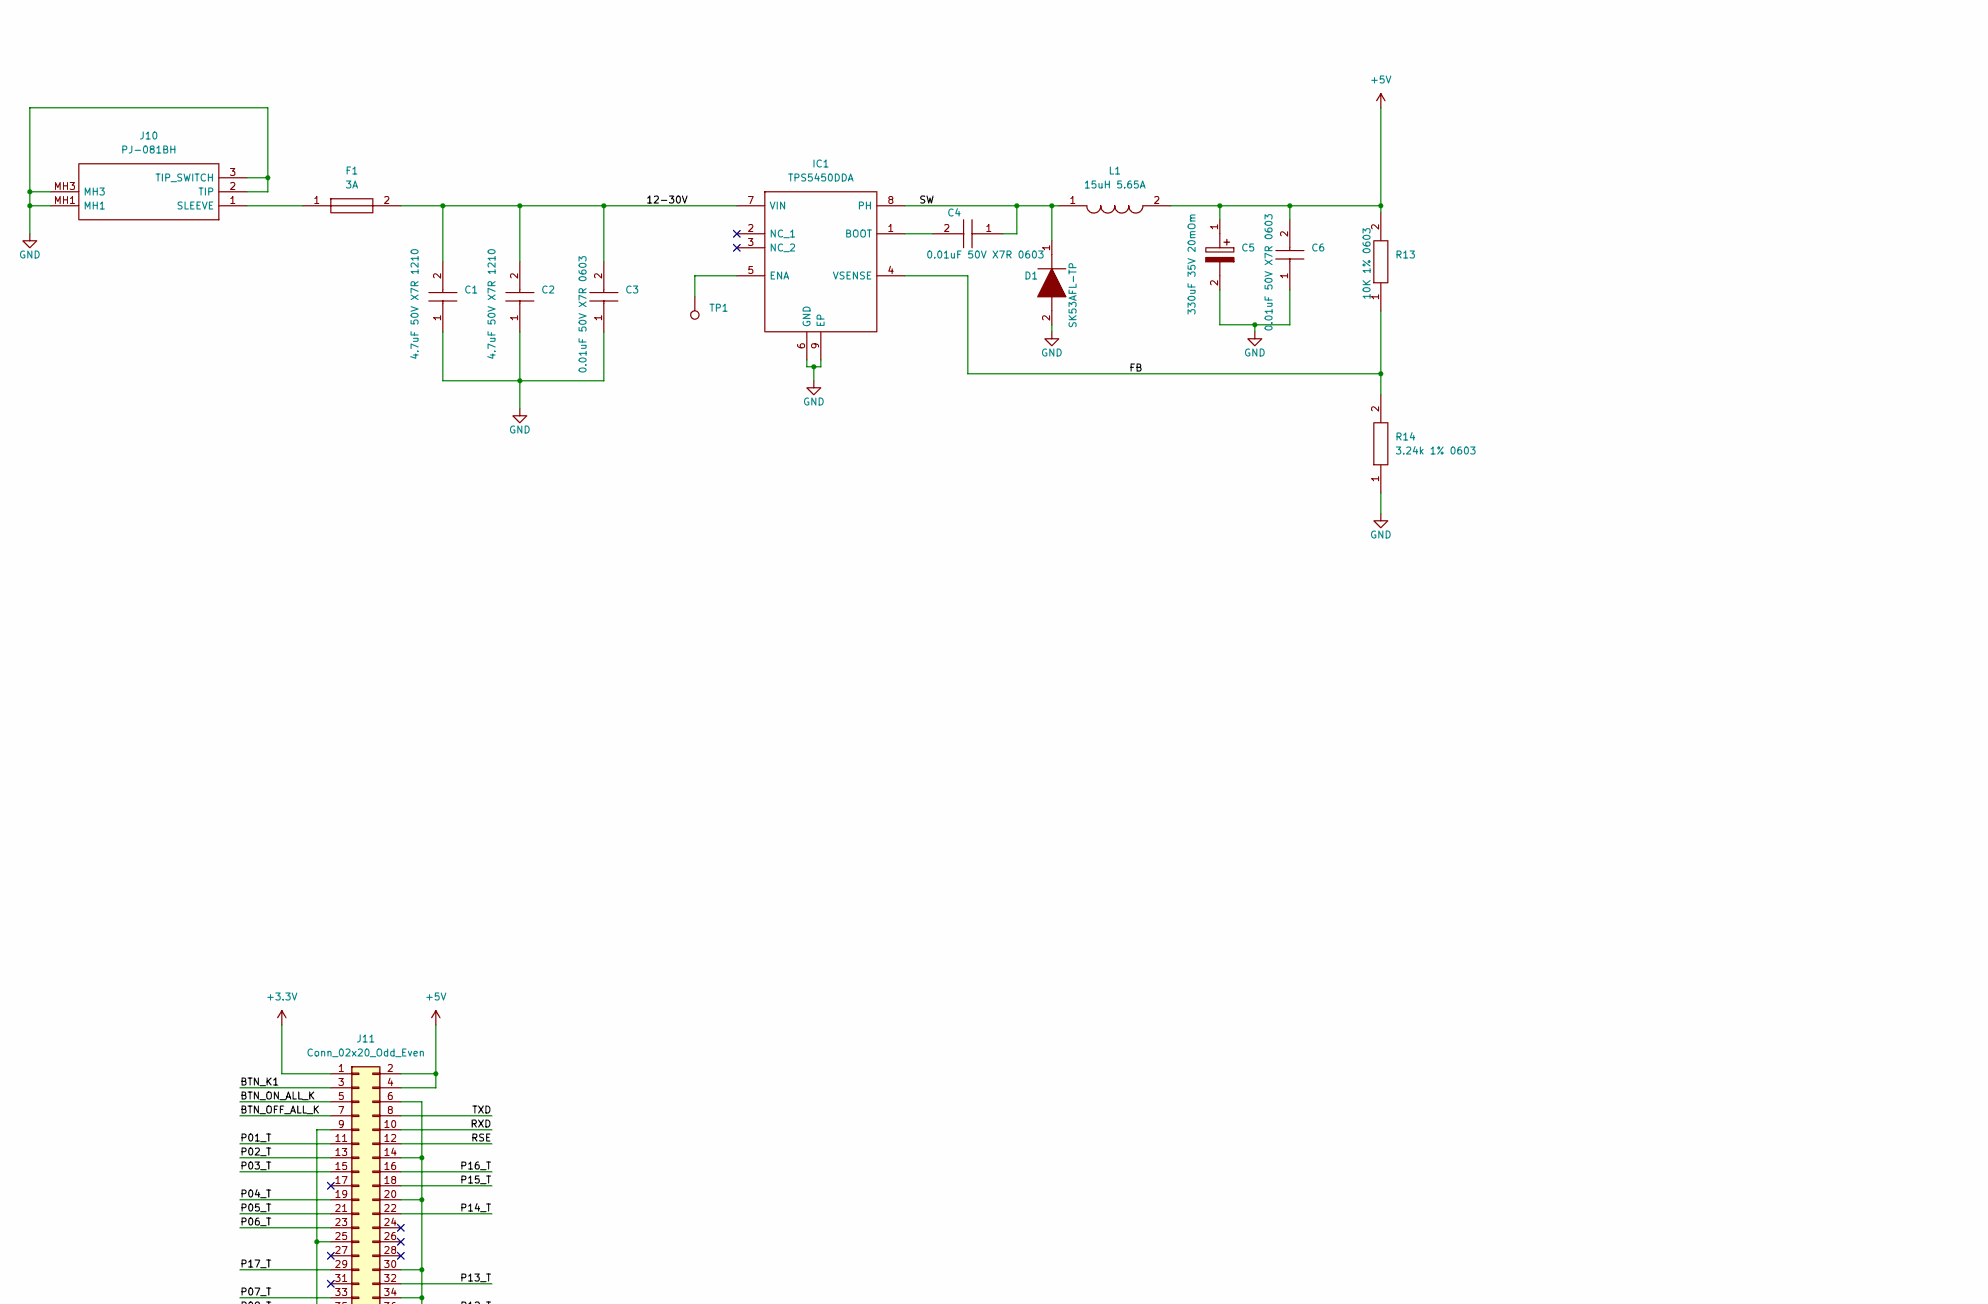
[picture p82: schematic Pi Zero_Relay.kicad_sch, part in row 1, column 1]

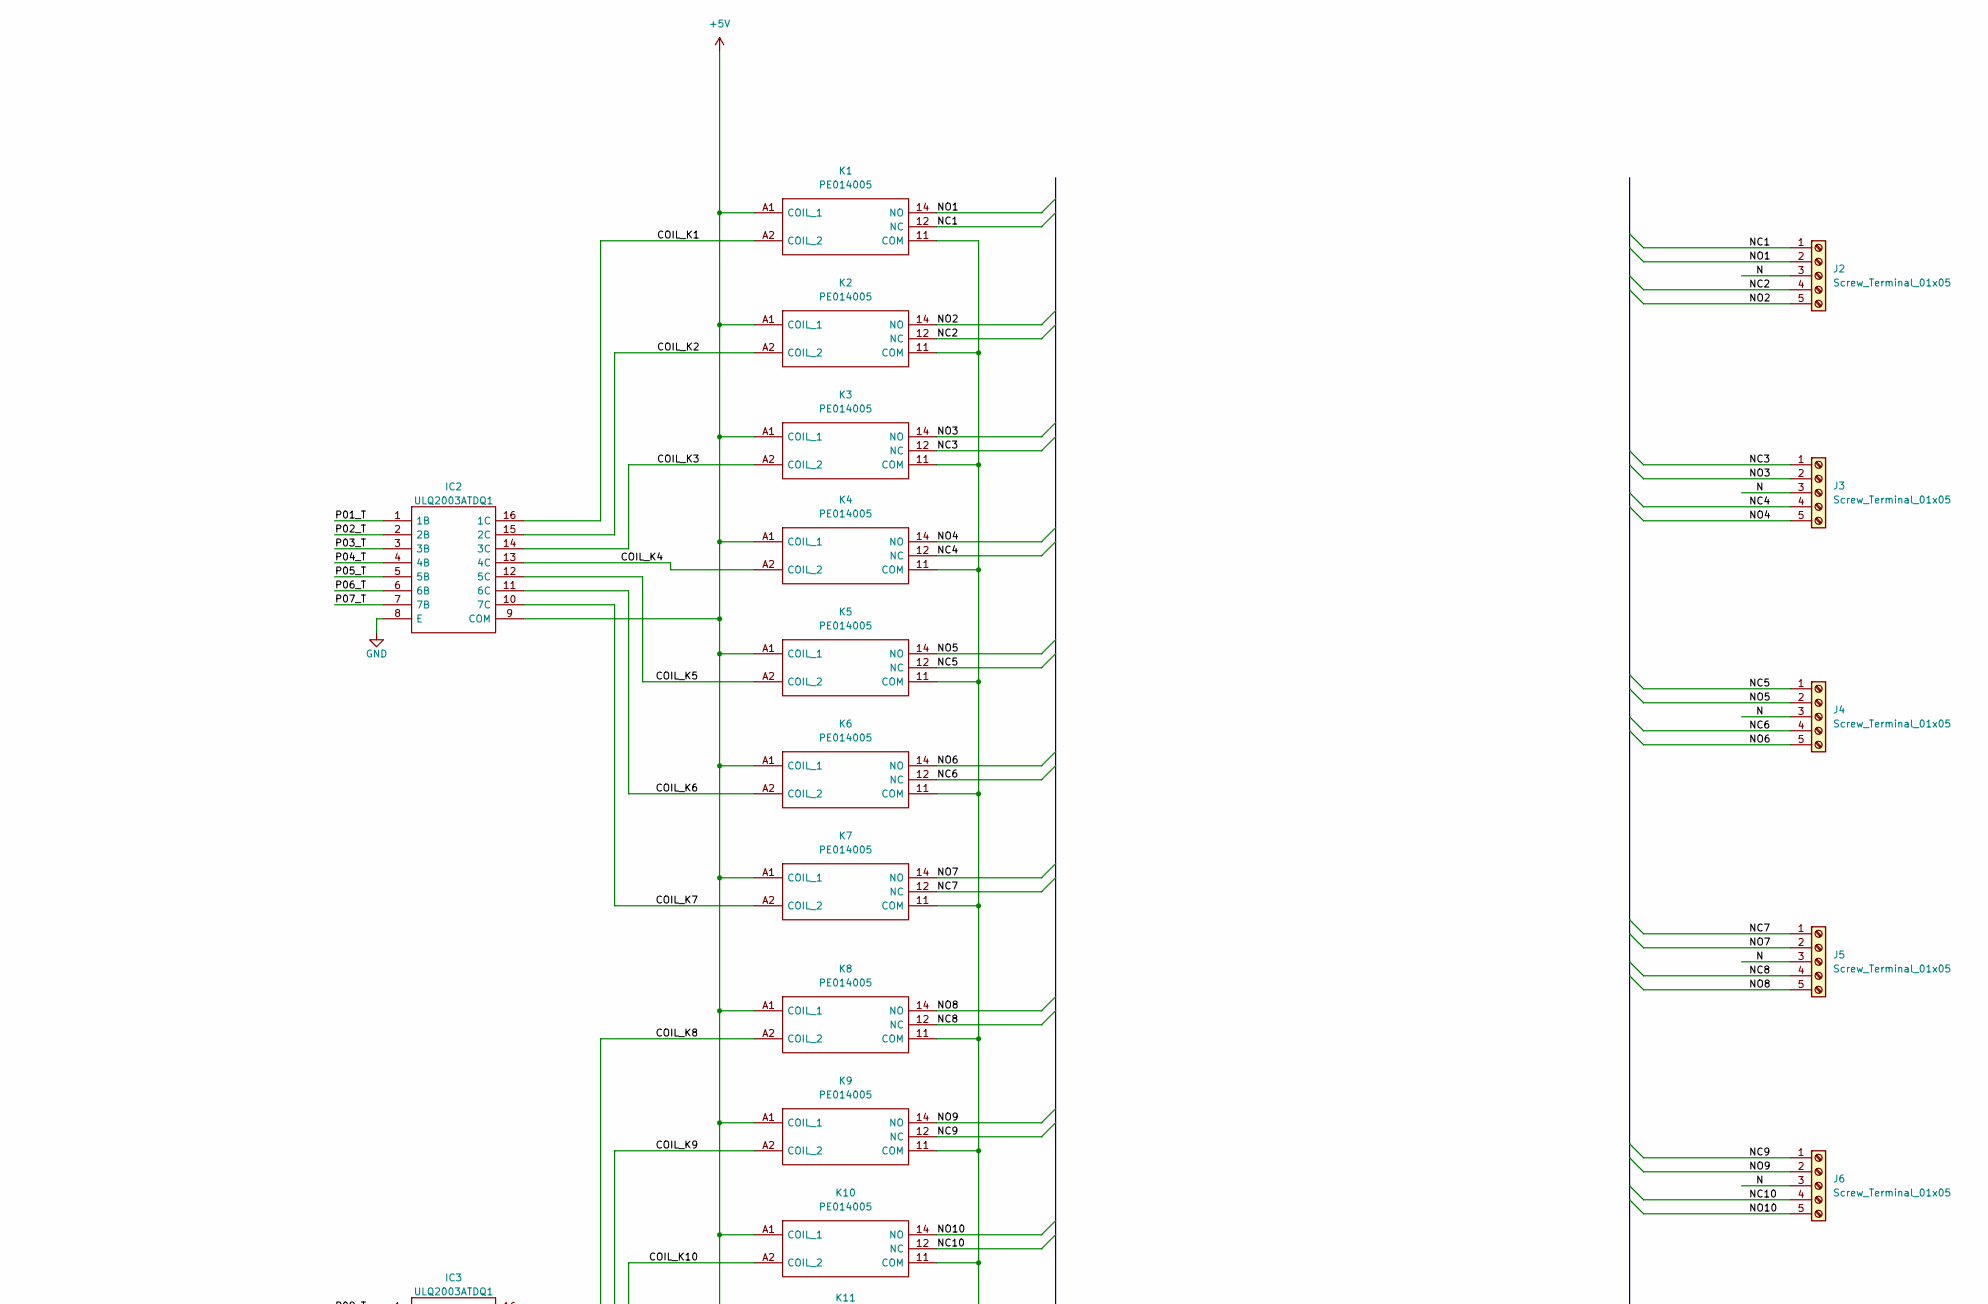
[picture p83: schematic Pi Zero_Relay.kicad_sch, part in row 1, column 2]

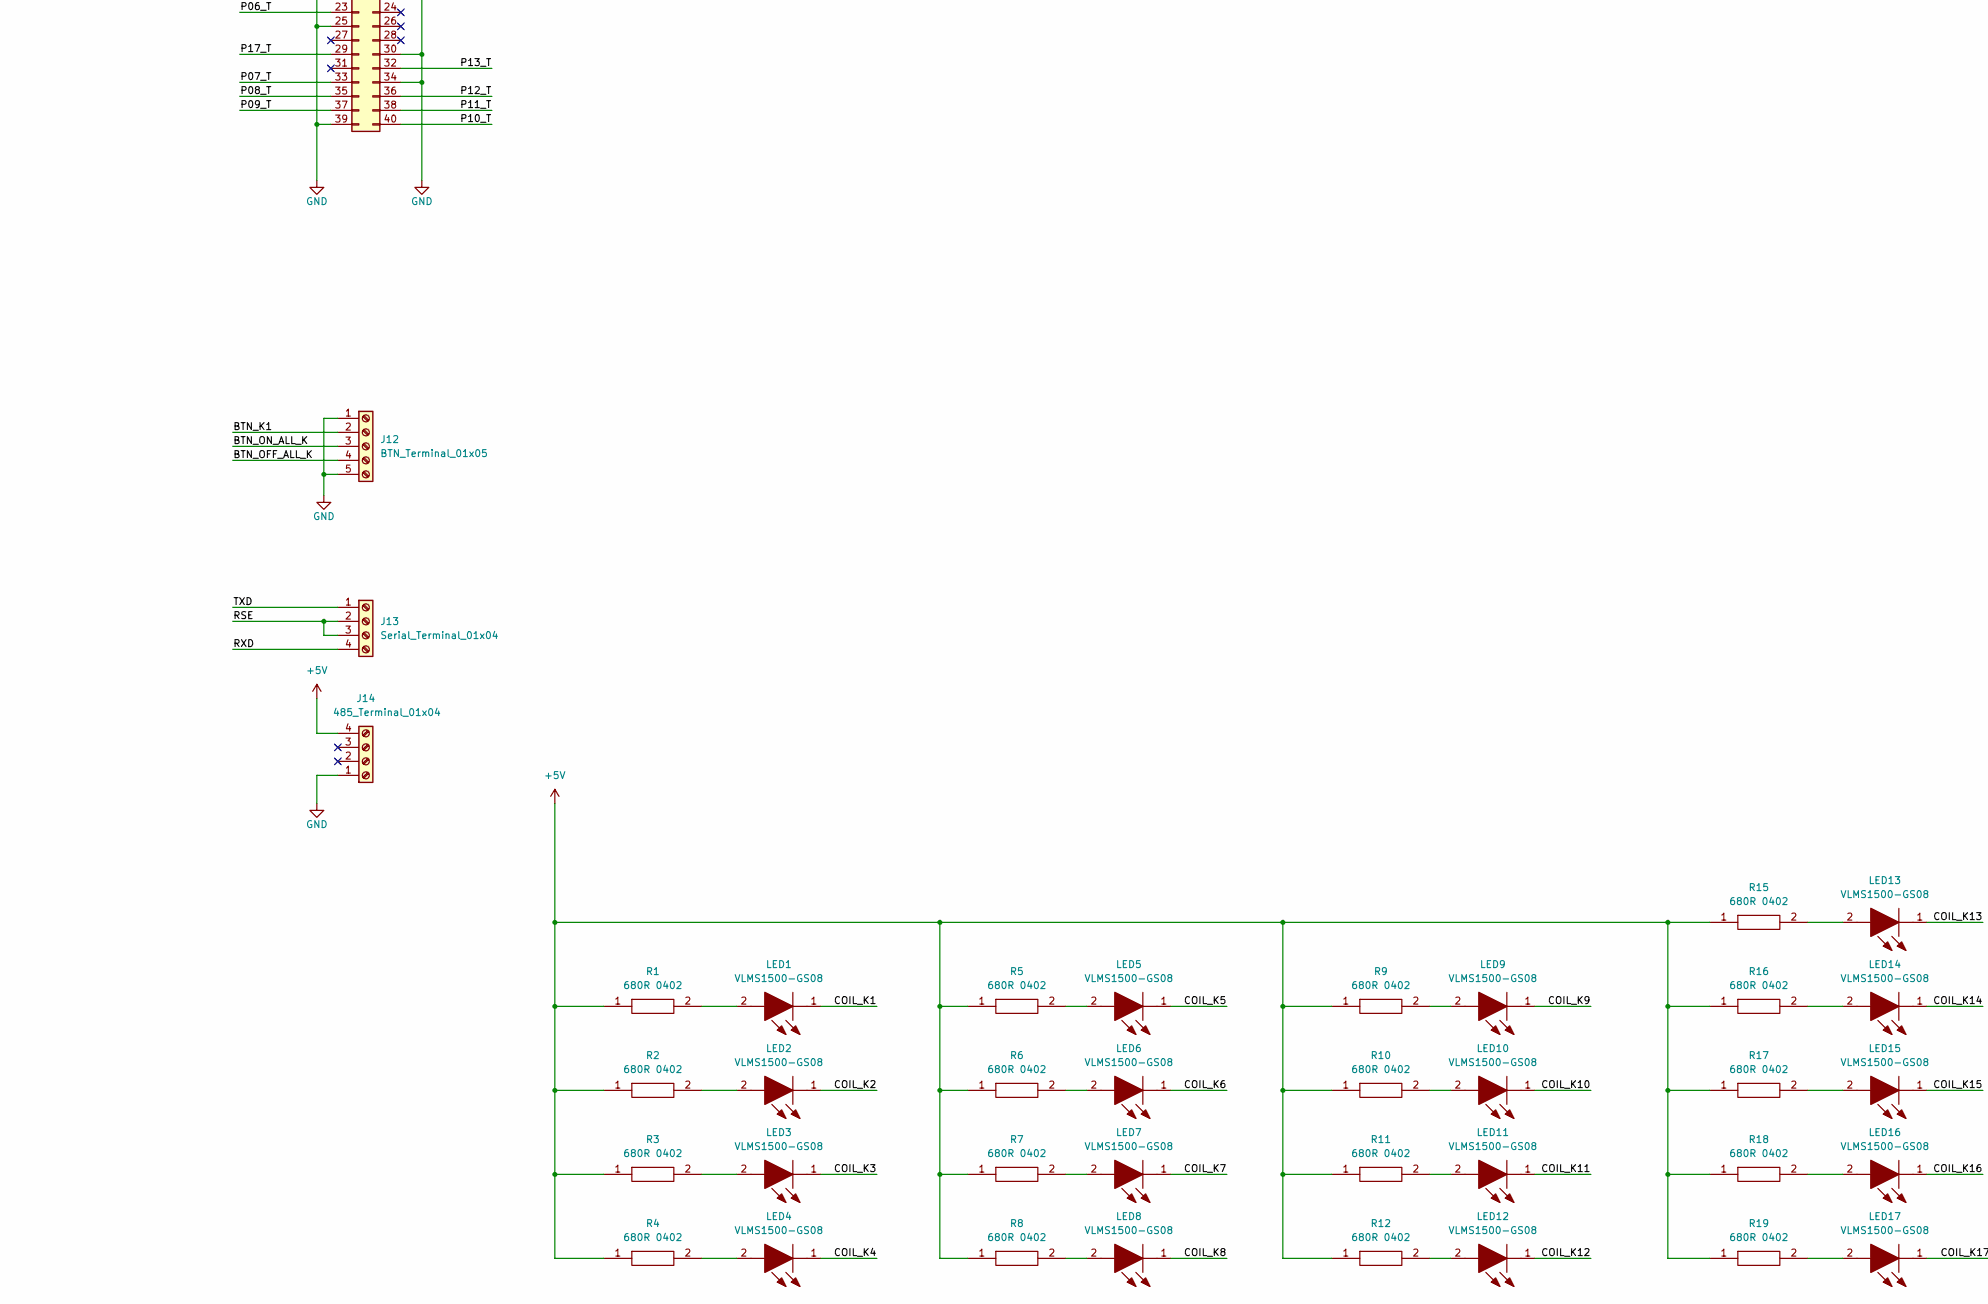
[picture p84: schematic Pi Zero_Relay.kicad_sch, part in row 2, column 1]

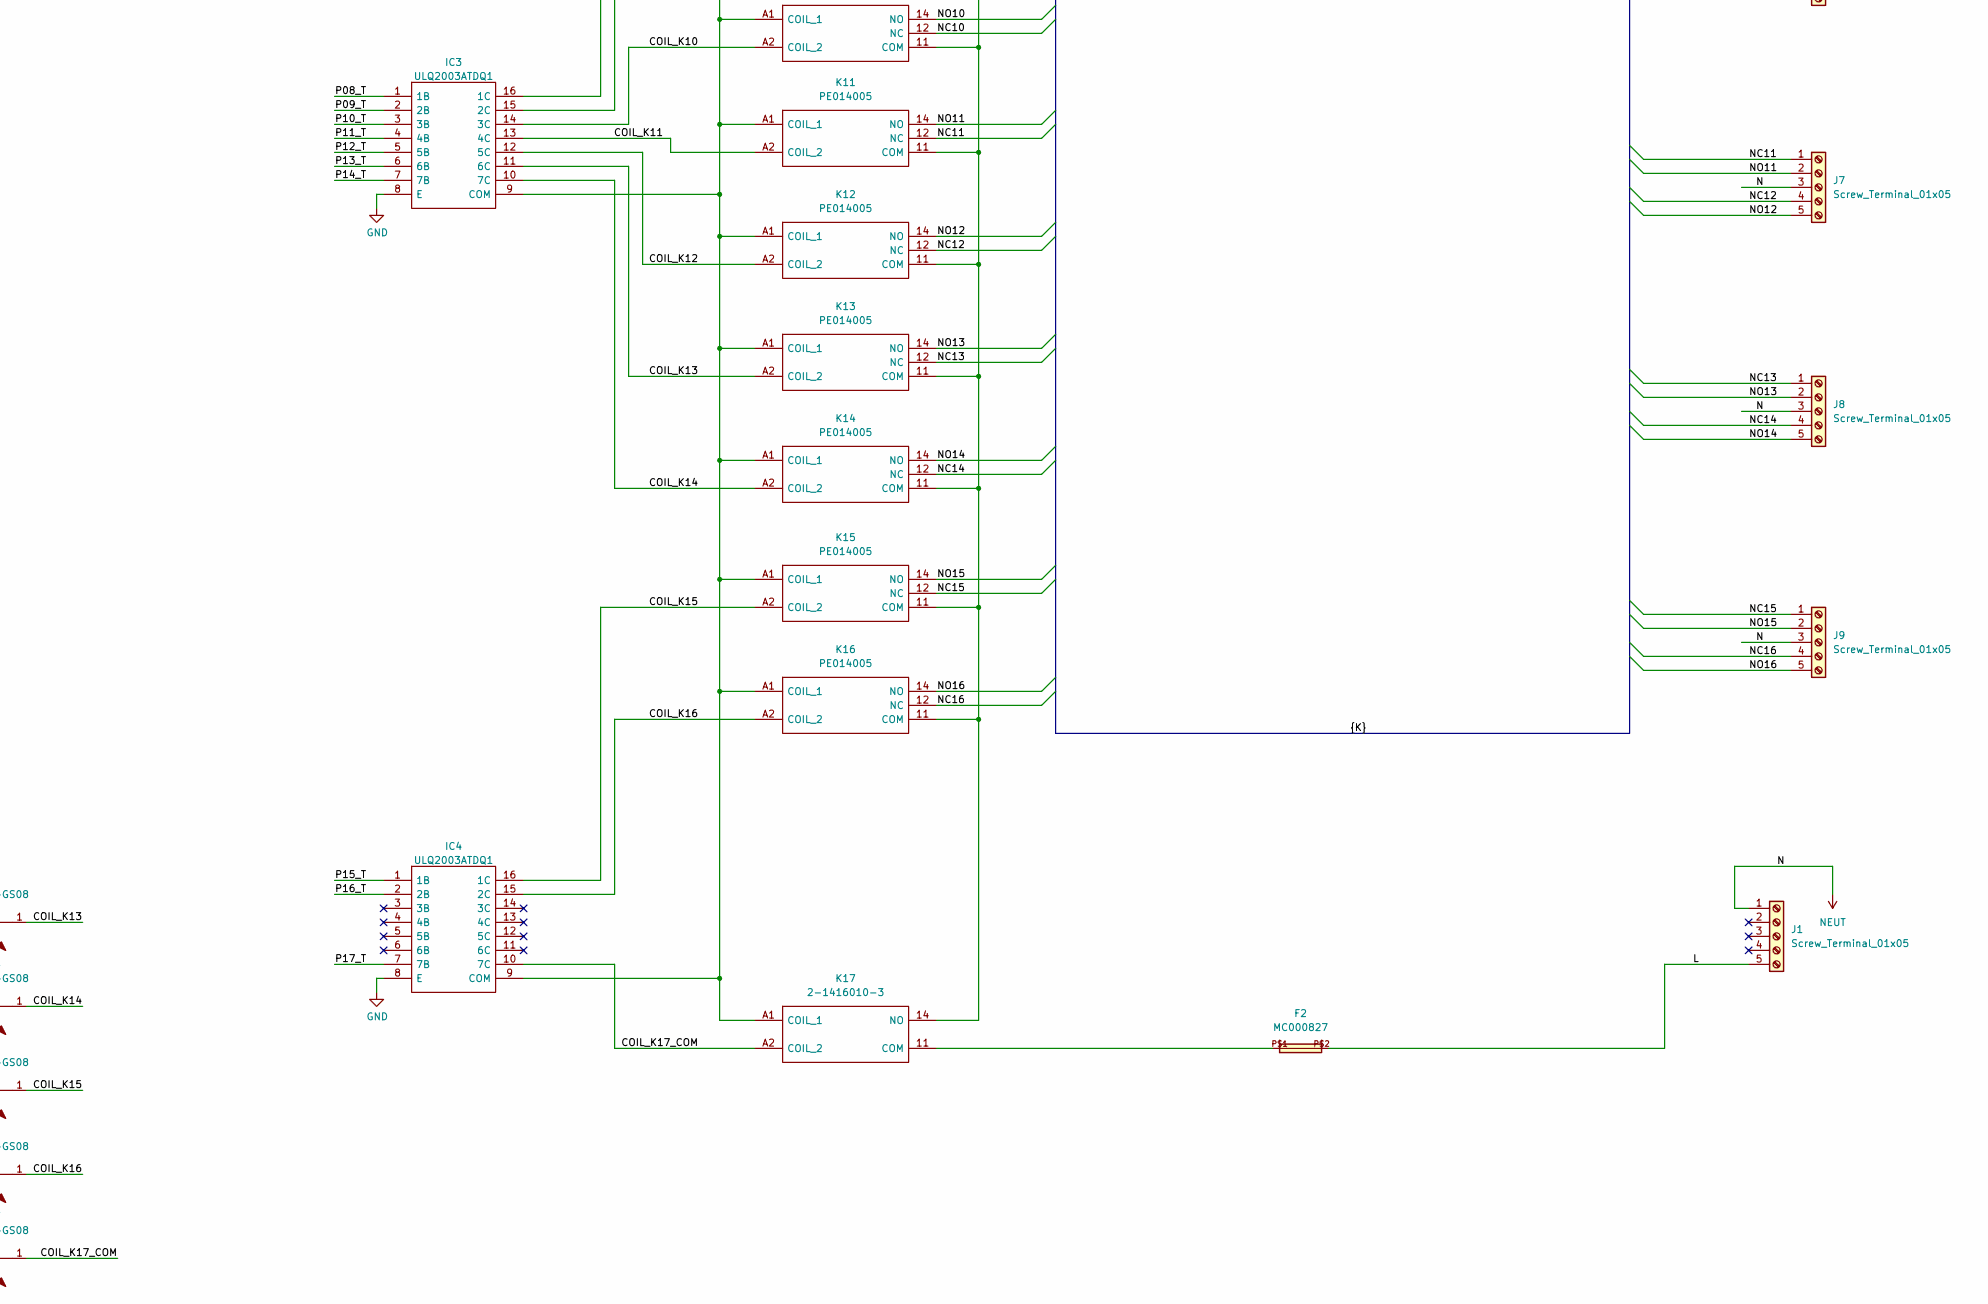
[picture p85: schematic Pi Zero_Relay.kicad_sch, part in row 2, column 2]

Parts:
C1, C2: 4.7uF 50V X7R 1210; C_1210_3225Metric; Manufacturer_Part_Number CC1210KFX7R9BB475; Mouser Part Number 603-CC1210KFX7R9B475
C3, C4, C6: 0.01uF 50V X7R 0603; C_0603_1608Metric; Mouser Part Number 80-C0603C103K5RAUTO
C5: 330uF 35V 20mOm; CAPPRD530W65D1000H1050; Manufacturer_Part_Number EEH-AZK1V331B; Mouser Part Number 667-EEH-AZK1V331B
D1: SK53AFL-TP; SODFL5026X120N; Mouser Part Number 833-SK53AFL-TP
F1: 3A; Fuse_1206_3216Metric; Manufacturer_Part_Number SF-1206F300M-2
F2: MC000827
IC1: TPS5450DDA; SOIC127P600X170-9N; Mouser Part Number 595-TPS5450DDA
IC2, IC3, IC4: ULQ2003ATDQ1; SOIC127P600X175-16N; Mouser Part Number 595-ULQ2003ATDQ1
J1, J2, J3, J4, J5, J6, J7, J8, J9: Screw_Terminal_01x05; PinHeader_1x05_P2.54mm_Vertical
J10: PJ-081BH; PJ081BH; Manufacturer_Part_Number PJ-081BH; Mouser Part Number 490-PJ-081BH
J11: Conn_02x20_Odd_Even; PinHeader_2x20_P2.54mm_Vertical
J12: BTN_Terminal_01x05; PinHeader_1x05_P2.54mm_Vertical
J13: Serial_Terminal_01x04; PinHeader_1x04_P2.54mm_Vertical
J14: 485_Terminal_01x04; PinHeader_1x04_P2.54mm_Vertical
K1, K2, K3, K4, K5, K6, K7, K8, K9, K10, K11, K12, K13, K14, K15, K16: PE014005; Mouser Part Number 655-PE014005
K17: 2-1416010-3; 214160103; Mouser Part Number 655-2-1416010-3
L1: 15uH 5.65A; INDPM120120X800N; Mouser Part Number 851-CDRH127LDNP150MC
LED1, LED2, LED3, LED4, LED5, LED6, LED7, LED8, LED9, LED10, LED11, LED12, LED13, LED14, LED15, LED16, LED17: VLMS1500-GS08; VLMG1500GS08; Mouser Part Number 78-VLMS1500-GS08
R1, R2, R3, R4, R5, R6, R7, R8, R9, R10, R11, R12, R15, R16, R17, R18, R19: 680R 0402; R_0402_1005Metric; Mouser Part Number 667-ERJ-2GEJ621X
R13: 10K 1% 0603; R_0603_1608Metric; Manufacturer_Part_Number CRCW060310K0FKEAC; Mouser Part Number 71-CRCW060310K0FKEAC
R14: 3.24k 1% 0603; R_0603_1608Metric; Manufacturer_Part_Number ERJ-P03F3241V
TP1: TestPoint; TestPoint_Pad_1.5x1.5mm

Connections:
+3.3V: J11.1
+5V: C5.1, C6.2, IC2.9 (COM), IC3.9 (COM), IC4.9 (COM), J11.2, J11.4, J14.4, K1.A1 (COIL_1), K2.A1 (COIL_1), K3.A1 (COIL_1), K4.A1 (COIL_1), K5.A1 (COIL_1), K6.A1 (COIL_1), K7.A1 (COIL_1), K8.A1 (COIL_1), K9.A1 (COIL_1), K10.A1 (COIL_1), K11.A1 (COIL_1), K12.A1 (COIL_1), K13.A1 (COIL_1), K14.A1 (COIL_1), K15.A1 (COIL_1), K16.A1 (COIL_1), K17.A1 (COIL_1), L1.2, R1.1, R2.1, R3.1, R4.1, R5.1, R6.1, R7.1, R8.1, R9.1, R10.1, R11.1, R12.1, R13.2, R15.1, R16.1, R17.1, R18.1, R19.1
/12-30V: C1.2, C2.2, C3.2, F1.2, IC1.7 (VIN)
/BTN_K1: J11.3, J12.2
/BTN_OFF_ALL_K: J11.7, J12.4
/BTN_ON_ALL_K: J11.5, J12.3
/COIL_K1: IC2.16 (1C), K1.A2 (COIL_2), LED1.1
/COIL_K2: IC2.15 (2C), K2.A2 (COIL_2), LED2.1
/COIL_K3: IC2.14 (3C), K3.A2 (COIL_2), LED3.1
/COIL_K4: IC2.13 (4C), K4.A2 (COIL_2), LED4.1
/COIL_K5: IC2.12 (5C), K5.A2 (COIL_2), LED5.1
/COIL_K6: IC2.11 (6C), K6.A2 (COIL_2), LED6.1
/COIL_K7: IC2.10 (7C), K7.A2 (COIL_2), LED7.1
/COIL_K8: IC3.16 (1C), K8.A2 (COIL_2), LED8.1
/COIL_K9: IC3.15 (2C), K9.A2 (COIL_2), LED9.1
/COIL_K10: IC3.14 (3C), K10.A2 (COIL_2), LED10.1
/COIL_K11: IC3.13 (4C), K11.A2 (COIL_2), LED11.1
/COIL_K12: IC3.12 (5C), K12.A2 (COIL_2), LED12.1
/COIL_K13: IC3.11 (6C), K13.A2 (COIL_2), LED13.1
/COIL_K14: IC3.10 (7C), K14.A2 (COIL_2), LED14.1
/COIL_K15: IC4.16 (1C), K15.A2 (COIL_2), LED15.1
/COIL_K16: IC4.15 (2C), K16.A2 (COIL_2), LED16.1
/COIL_K17_COM: IC4.10 (7C), K17.A2 (COIL_2), LED17.1
/FB: IC1.4 (VSENSE), R13.1, R14.2
/L: F2.P$2, J1.5
/NC1: J2.1, K1.12 (NC)
/NC2: J2.4, K2.12 (NC)
/NC3: J3.1, K3.12 (NC)
/NC4: J3.4, K4.12 (NC)
/NC5: J4.1, K5.12 (NC)
/NC6: J4.4, K6.12 (NC)
/NC7: J5.1, K7.12 (NC)
/NC8: J5.4, K8.12 (NC)
/NC9: J6.1, K9.12 (NC)
/NC10: J6.4, K10.12 (NC)
/NC11: J7.1, K11.12 (NC)
/NC12: J7.4, K12.12 (NC)
/NC13: J8.1, K13.12 (NC)
/NC14: J8.4, K14.12 (NC)
/NC15: J9.1, K15.12 (NC)
/NC16: J9.4, K16.12 (NC)
/NO1: J2.2, K1.14 (NO)
/NO2: J2.5, K2.14 (NO)
/NO3: J3.2, K3.14 (NO)
/NO4: J3.5, K4.14 (NO)
/NO5: J4.2, K5.14 (NO)
/NO6: J4.5, K6.14 (NO)
/NO7: J5.2, K7.14 (NO)
/NO8: J5.5, K8.14 (NO)
/NO9: J6.2, K9.14 (NO)
/NO10: J6.5, K10.14 (NO)
/NO11: J7.2, K11.14 (NO)
/NO12: J7.5, K12.14 (NO)
/NO13: J8.2, K13.14 (NO)
/NO14: J8.5, K14.14 (NO)
/NO15: J9.2, K15.14 (NO)
/NO16: J9.5, K16.14 (NO)
/P01_T: IC2.1 (1B), J11.11
/P02_T: IC2.2 (2B), J11.13
/P03_T: IC2.3 (3B), J11.15
/P04_T: IC2.4 (4B), J11.19
/P05_T: IC2.5 (5B), J11.21
/P06_T: IC2.6 (6B), J11.23
/P07_T: IC2.7 (7B), J11.33
/P08_T: IC3.1 (1B), J11.35
/P09_T: IC3.2 (2B), J11.37
/P10_T: IC3.3 (3B), J11.40
/P11_T: IC3.4 (4B), J11.38
/P12_T: IC3.5 (5B), J11.36
/P13_T: IC3.6 (6B), J11.32
/P14_T: IC3.7 (7B), J11.22
/P15_T: IC4.1 (1B), J11.18
/P16_T: IC4.2 (2B), J11.16
/P17_T: IC4.7 (7B), J11.29
/RSE: J11.12, J13.2, J13.3
/RXD: J11.10, J13.4
/SW: C4.1, D1.1, IC1.8 (PH), L1.1
/TXD: J11.8, J13.1
GND: C1.1, C2.1, C3.1, C5.2, C6.1, D1.2, IC1.6 (GND), IC1.9 (EP), IC2.8 (E), IC3.8 (E), IC4.8 (E), J10.2 (TIP), J10.3 (TIP_SWITCH), J10.MH1, J10.MH3, J11.6, J11.9, J11.14, J11.20, J11.25, J11.30, J11.34, J11.39, J12.1, J12.5, J14.1, R14.1
NEUT: J1.1, J2.3, J3.3, J4.3, J5.3, J6.3, J7.3, J8.3, J9.3
unnamed: C4.2, IC1.1 (BOOT)
unnamed: F1.1, J10.1 (SLEEVE)
unnamed: IC1.5 (ENA), TP1.1
unnamed: K1.11 (COM), K2.11 (COM), K3.11 (COM), K4.11 (COM), K5.11 (COM), K6.11 (COM), K7.11 (COM), K8.11 (COM), K9.11 (COM), K10.11 (COM), K11.11 (COM), K12.11 (COM), K13.11 (COM), K14.11 (COM), K15.11 (COM), K16.11 (COM), K17.14 (NO)
unnamed: F2.P$1, K17.11 (COM)
unnamed: LED1.2, R1.2
unnamed: LED2.2, R2.2
unnamed: LED3.2, R3.2
unnamed: LED4.2, R4.2
unnamed: LED5.2, R5.2
unnamed: LED6.2, R6.2
unnamed: LED7.2, R7.2
unnamed: LED8.2, R8.2
unnamed: LED9.2, R9.2
unnamed: LED10.2, R10.2
unnamed: LED11.2, R11.2
unnamed: LED12.2, R12.2
unnamed: LED13.2, R15.2
unnamed: LED14.2, R16.2
unnamed: LED15.2, R17.2
unnamed: LED16.2, R18.2
unnamed: LED17.2, R19.2

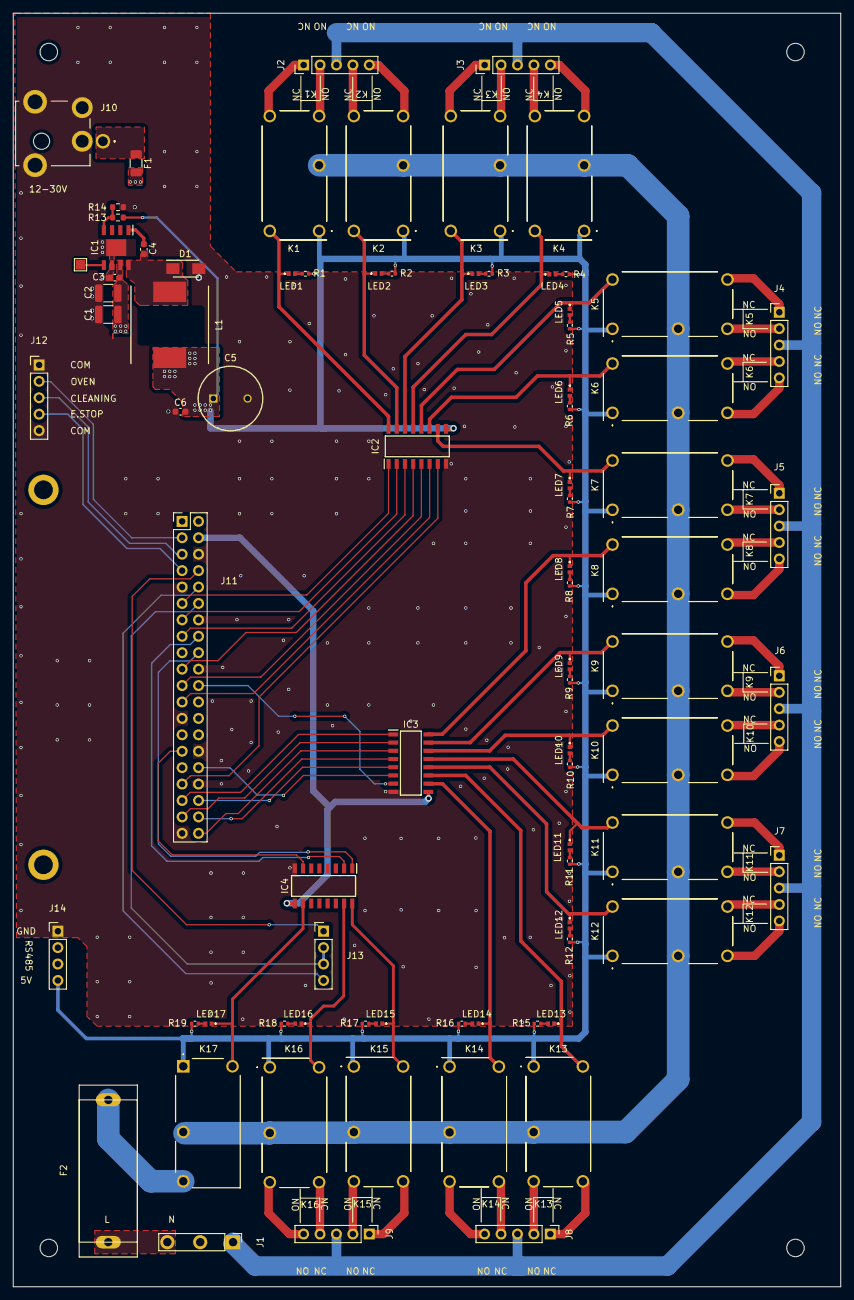
[picture p86: board Pi Zero_Relay.kicad_pcb from above]

Board: 2 copper layers, 128.0 x 197.0 mm, 88 parts (0 on the bottom side), 101 nets.

Other parts of the board:
5, 6: MountingHole_2.7mm_M2.5_DIN965_Pad
M1, M2, M3, M4: MountingHole_2.7mm_M2.5
