lincvv/kicad_space/Projects/Design/vng/esp_mini_open_brd/esp_mini_open_brd.kicad_pcb

## KiCad design Projects/Design/vng/esp_mini_open_brd/esp_mini_open_brd.kicad_pcb (2024-06-23)

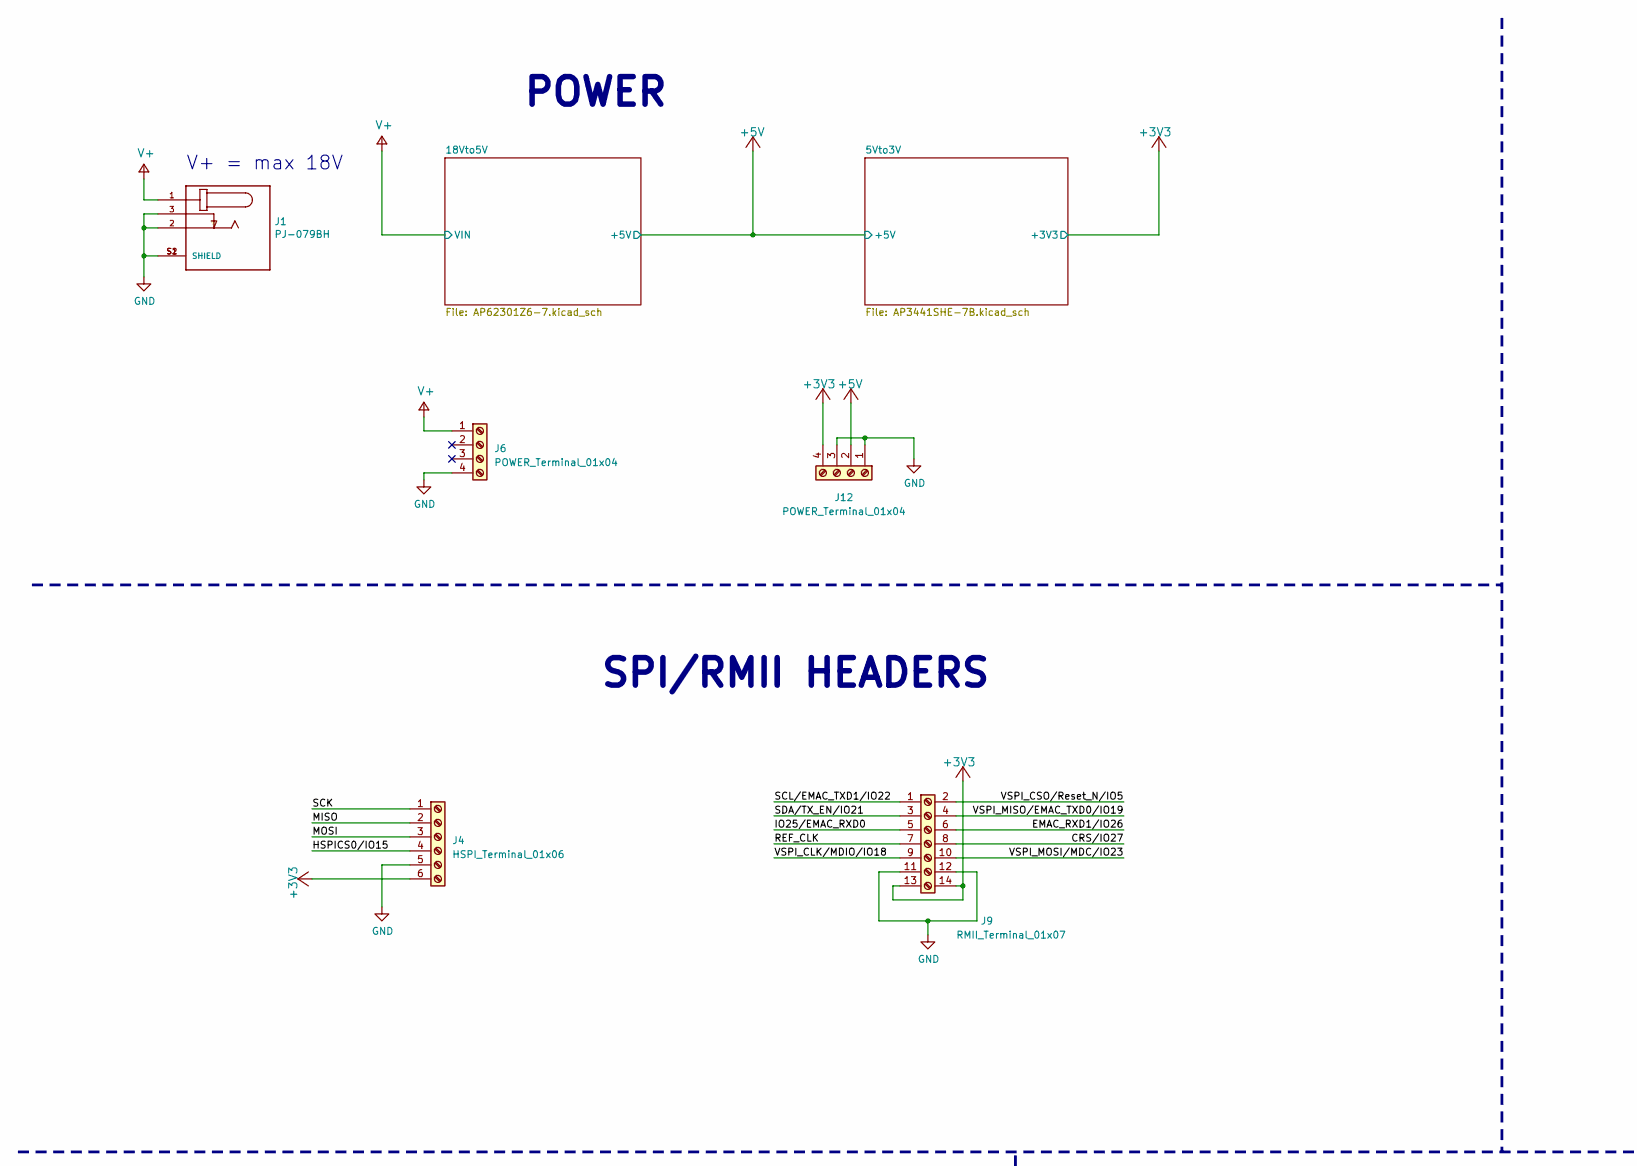
[picture p87: schematic esp_mini_open_brd.kicad_sch, ESP Open Board, part in row 1, column 1]

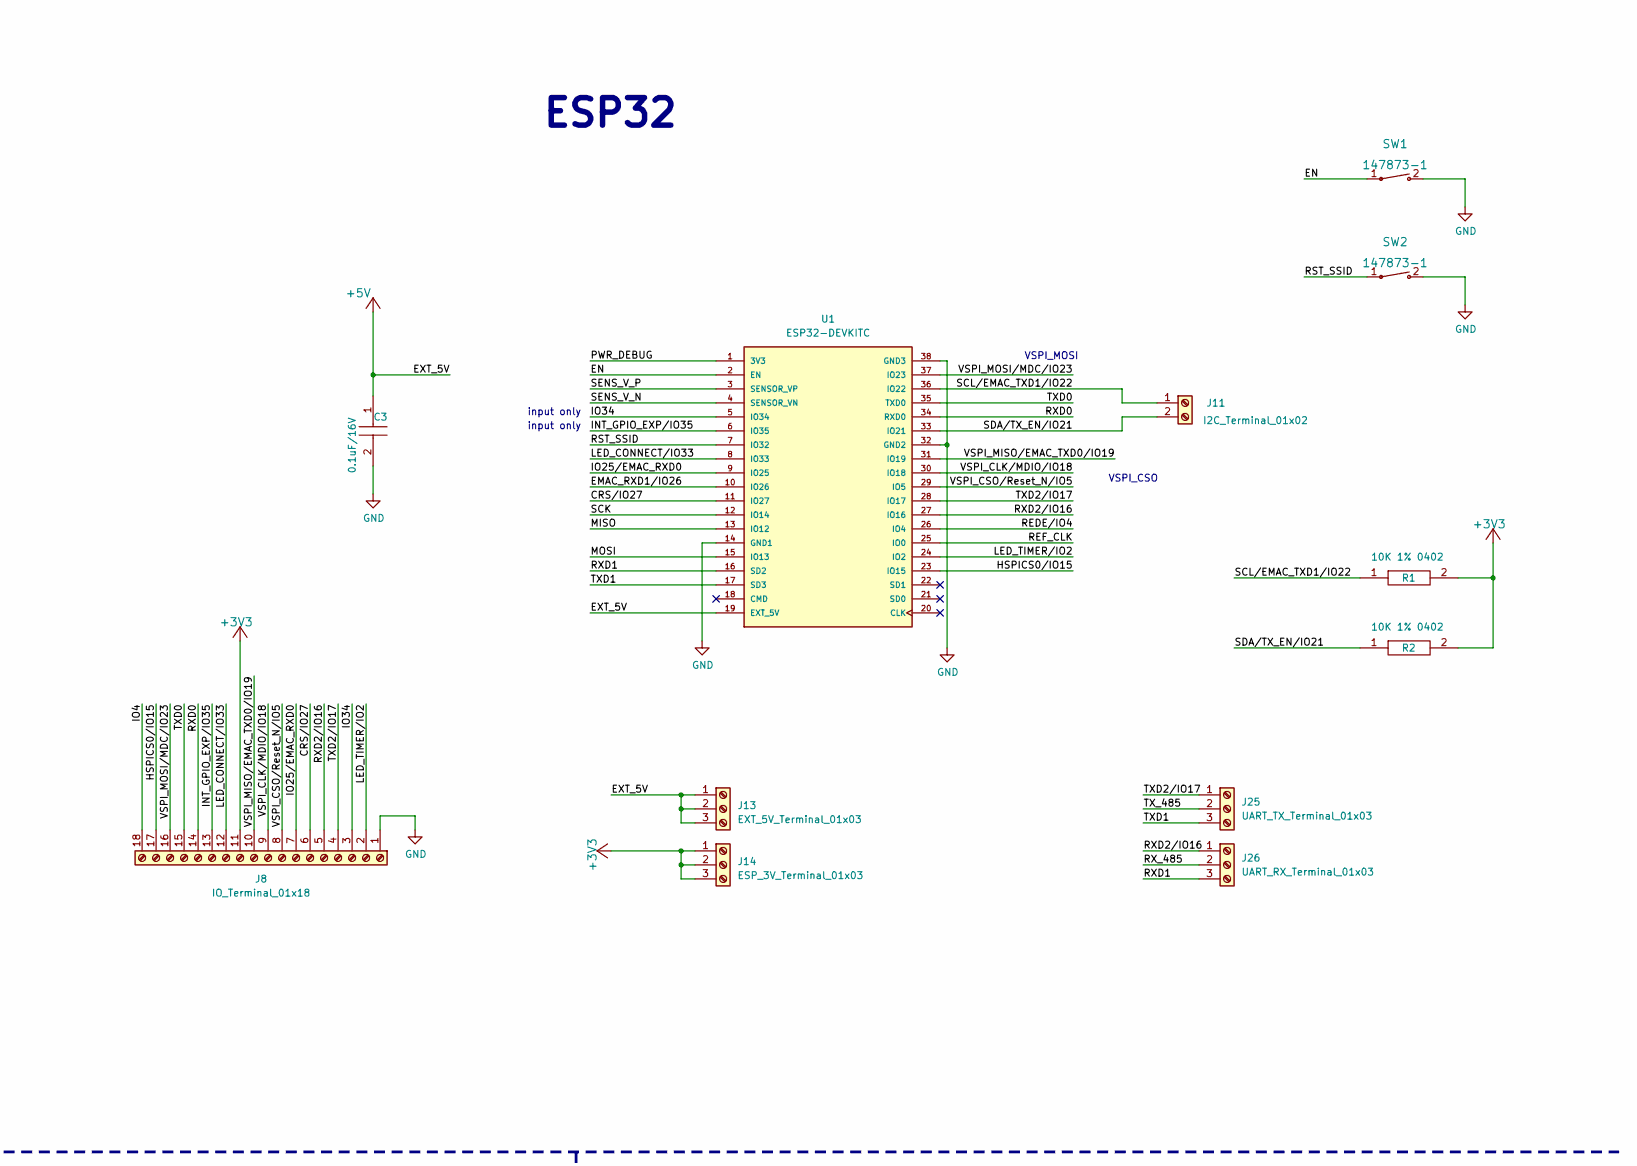
[picture p88: schematic esp_mini_open_brd.kicad_sch, ESP Open Board, part in row 1, column 2]

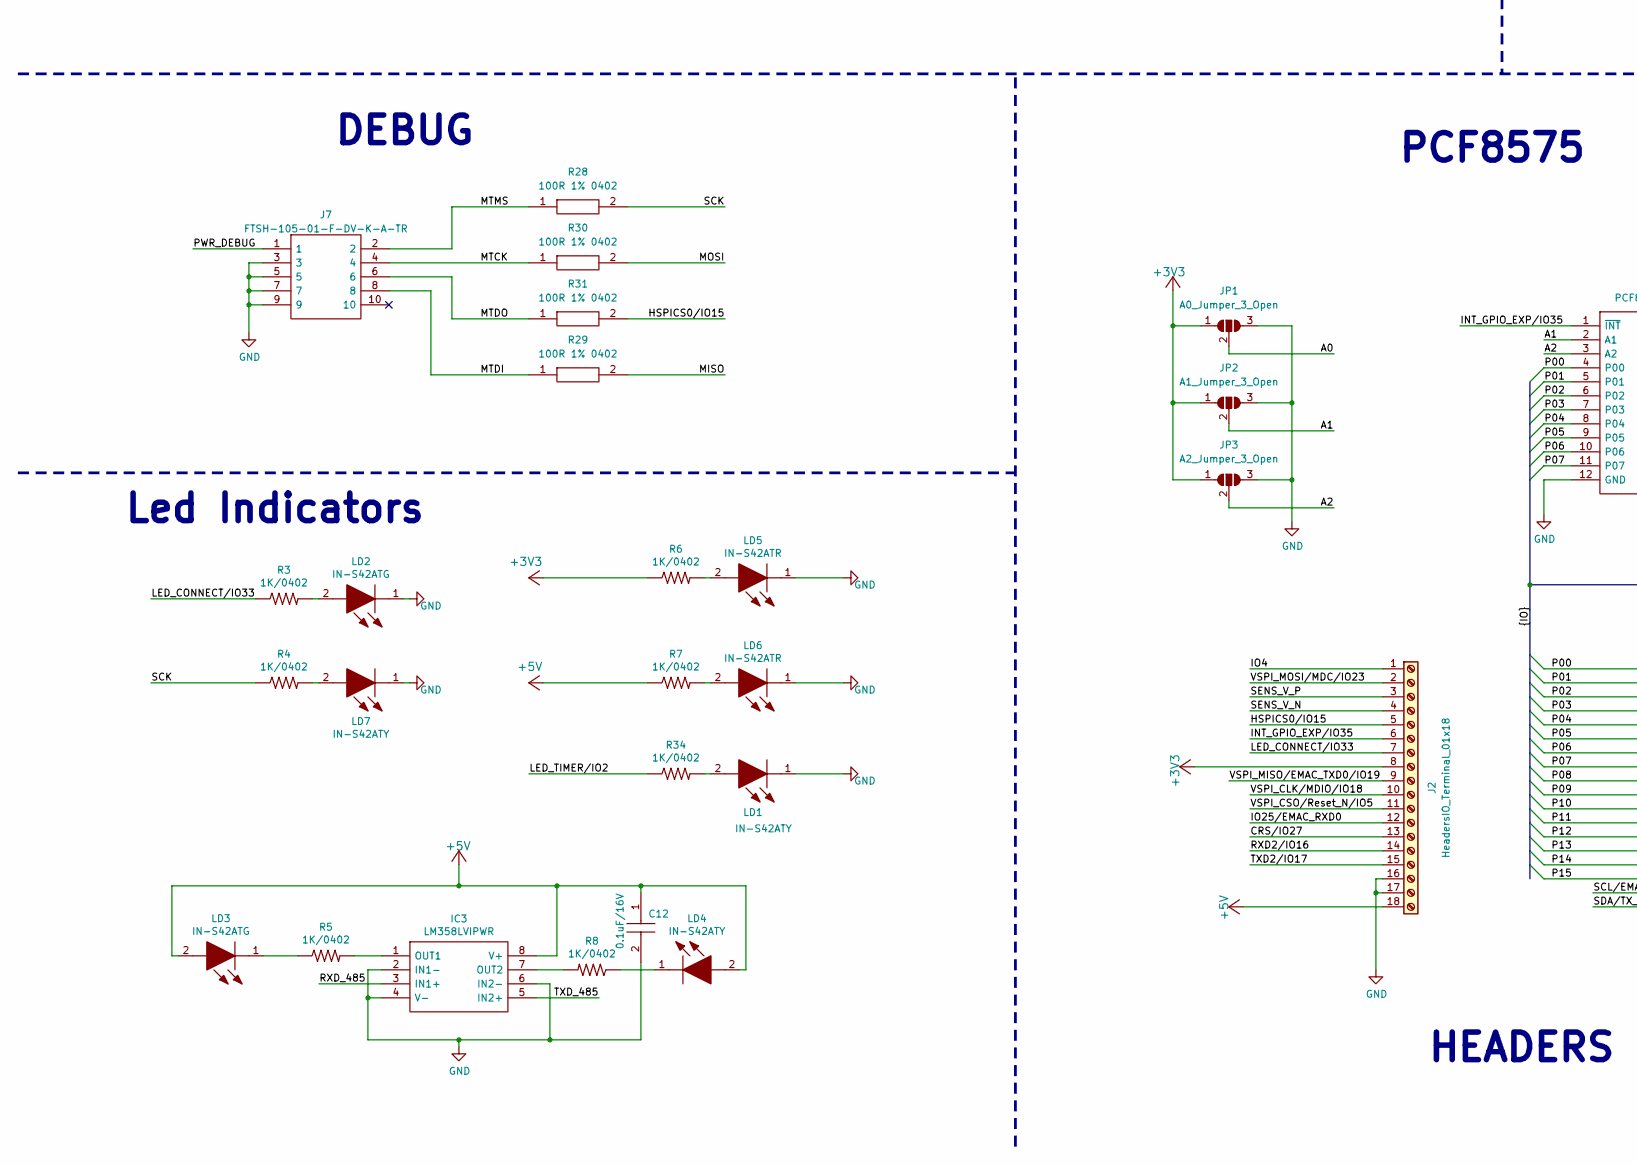
[picture p89: schematic esp_mini_open_brd.kicad_sch, ESP Open Board, part in row 2, column 1]

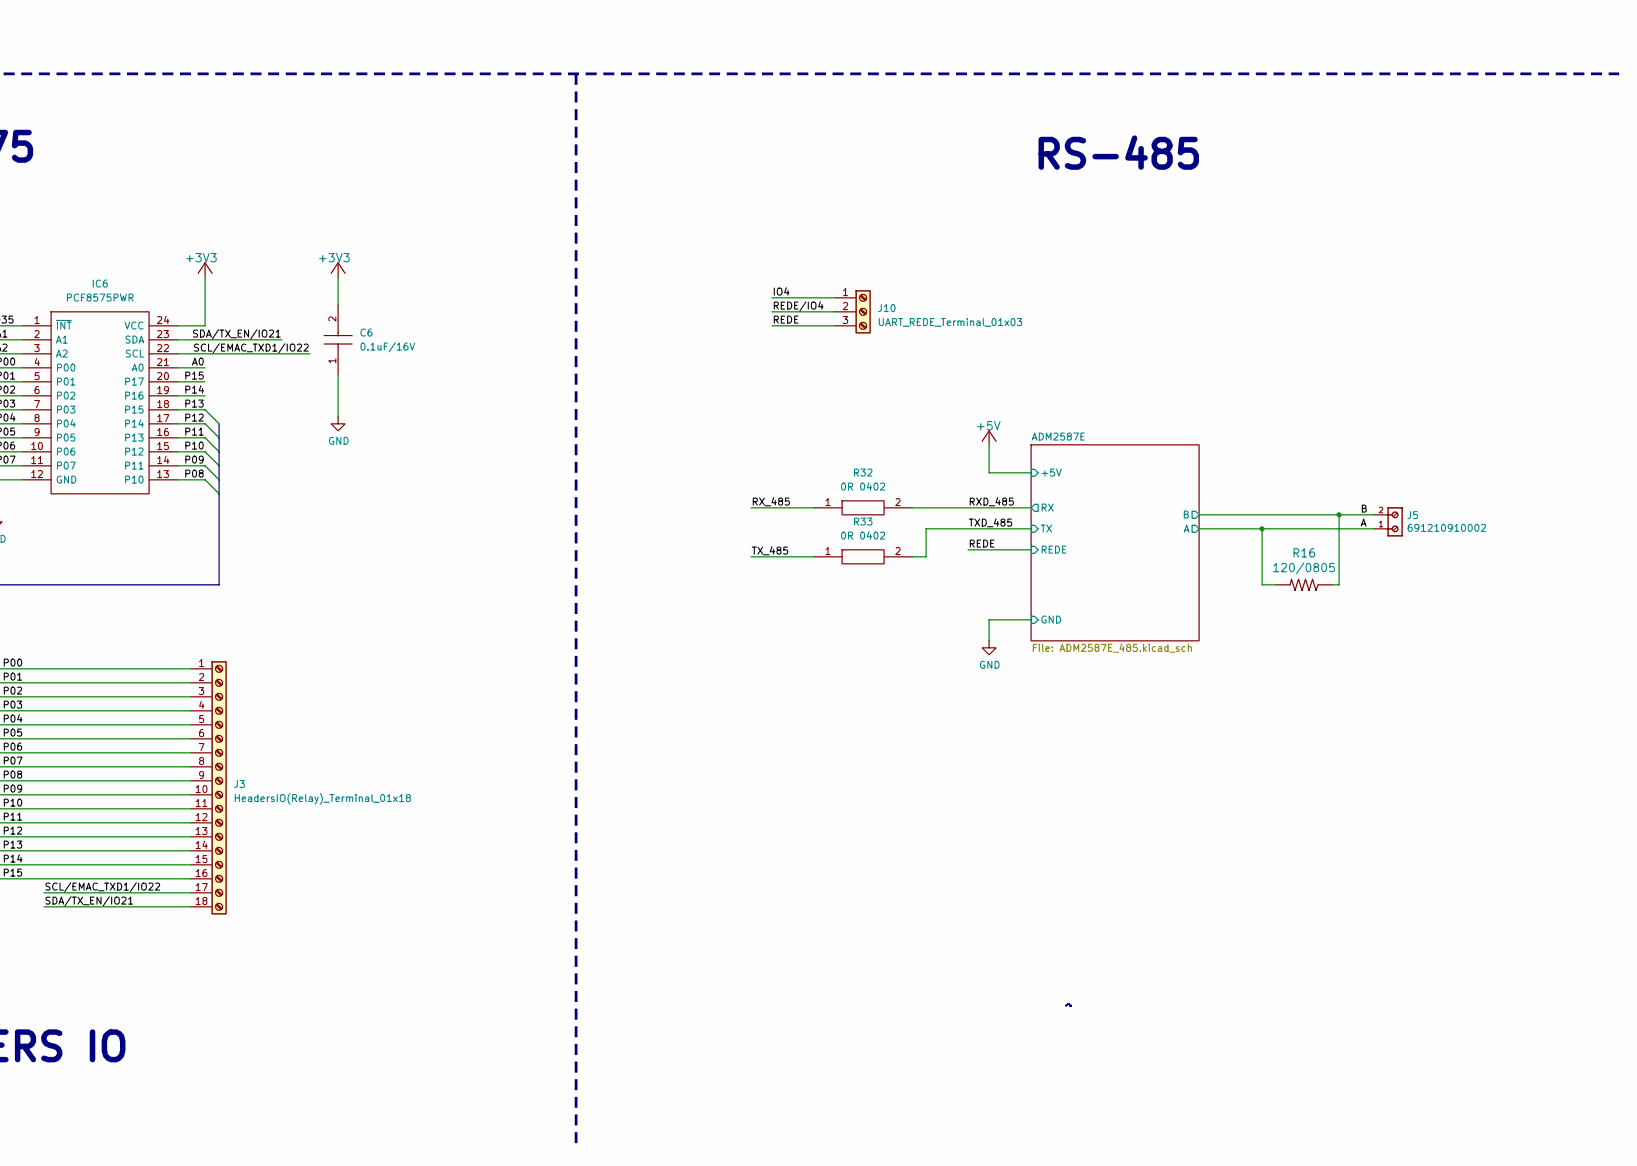
[picture p90: schematic esp_mini_open_brd.kicad_sch, ESP Open Board, part in row 2, column 2]

Parts:
C3, C12: 0.1uF/16V; C_0402_1005Metric; Manufacturer_Part_Number C0402C104K4RECTU
C6: 0.1uF/16V; C_0402_1005Metric; Manufacturer_Part_Number GRM155R71C104KA88D; Mouser Part Number N/A
IC3: LM358LVIPWR; SOP65P640X120-8N; Manufacturer_Part_Number LM358LVIPWR; Mouser Part Number 595-LM358LVIPWR
IC6: PCF8575PWR; SOP65P640X120-24N; Mouser Part Number 595-PCF8575PWR
J1: PJ-079BH; DC_PW_2.5_CUI_PJ-079BH; PARTREV LTR
J2: HeadersIO_Terminal_01x18; PinSocket_1x18_P2.54mm_Vertical
J3: HeadersIO(Relay)_Terminal_01x18; PinSocket_1x18_P2.54mm_Vertical
J4: HSPI_Terminal_01x06; PinHeader_1x06_P2.54mm_Vertical
J5: 691210910002; PART-NUMBER 691210910002
J6, J12: POWER_Terminal_01x04; PinHeader_1x04_P2.54mm_Vertical
J7: FTSH-105-01-F-DV-K-A-TR; FTSH-105-XX-YYY-DV-K-A-TR; Manufacturer_Part_Number FTSH-105-01-F-DV-K-A-TR
J8: IO_Terminal_01x18; PinSocket_1x18_P2.54mm_Vertical
J9: RMII_Terminal_01x07; PinSocket_2x07_P2.54mm_Horizontal
J10: UART_REDE_Terminal_01x03; PinHeader_1x03_P2.54mm_Vertical
J11: I2C_Terminal_01x02; PinSocket_1x02_P2.54mm_Vertical
J13: EXT_5V_Terminal_01x03; PinHeader_1x03_P2.54mm_Vertical
J14: ESP_3V_Terminal_01x03; PinHeader_1x03_P2.54mm_Vertical
J25: UART_TX_Terminal_01x03; PinHeader_1x03_P2.54mm_Vertical
J26: UART_RX_Terminal_01x03; PinHeader_1x03_P2.54mm_Vertical
JP1: A0_Jumper_3_Open; SolderJumper-3_P2.0mm_Open_TrianglePad1.0x1.5mm
JP2: A1_Jumper_3_Open; SolderJumper-3_P2.0mm_Open_TrianglePad1.0x1.5mm
JP3: A2_Jumper_3_Open; SolderJumper-3_P2.0mm_Open_TrianglePad1.0x1.5mm
LD1, LD4, LD7: IN-S42ATY; LEDC1005X45N; Manufacturer_Part_Number IN-S42ATY
LD2, LD3: IN-S42ATG; LEDC1005X45N; Manufacturer_Part_Number IN-S42ATG
LD5, LD6: IN-S42ATR; LEDC1005X55N; Manufacturer_Part_Number IN-S42ATR
R1, R2: 10K 1% 0402; R_0402_1005Metric; Manufacturer_Part_Number AC0402FR-0710KL; Mouser Part Number 603-AC0402FR-0710KL
R3, R4, R5, R6, R7, R8, R34: 1K/0402; R_0402_1005Metric; Voltage_Rating 25 V; Tolerance .1%
R16: 120/0805; RESC2012X65N
R28, R29, R30, R31: 100R 1% 0402; R_0402_1005Metric; Manufacturer_Part_Number CRCW0402100RFKEDC; Mouser Part Number 71-CRCW0402100RFKEDC
R32, R33: 0R 0402; R_0402_1005Metric; Manufacturer_Part_Number ERJ-U020R00X; Mouser Part Number 667-ERJ-U020R00X
SW1, SW2: 147873-1; SW_147873-1
U1: ESP32-DEVKITC; MODULE_ESP32-DEVKITC; PARTREV N/A

Connections:
+3V3: C6.2, IC6.24 (VCC), J2.8, J4.6, J8.11, J9.13, J9.14, J12.4, J14.1, J14.2, J14.3, JP1.1 (A), JP2.1 (A), JP3.1 (A), R1.2, R2.2, R6.1; also elsewhere on the board
+5V: C3.1, C12.1, IC3.8 (V+), J2.18, J12.2, J13.1, J13.2, J13.3, LD3.2, LD4.2, R7.1, U1.19 (EXT_5V); also elsewhere on the board
/A: J5.1, R16.2; also elsewhere on the board
/A0: IC6.21 (A0), JP1.2 (C)
/A1: IC6.2 (A1), JP2.2 (C)
/A2: IC6.3 (A2), JP3.2 (C)
/B: J5.2, R16.1; also elsewhere on the board
/CRS/IO27: J2.13, J8.6, J9.8, U1.11 (IO27)
/EMAC_RXD1/IO26: J9.6, U1.10 (IO26)
/EN: SW1.1, U1.2 (EN)
/HSPICS0/IO15: J2.5, J4.4, J8.17, R31.2, U1.23 (IO15)
/INT_GPIO_EXP/IO35: IC6.1 (~INT), J2.6, J8.13, U1.6 (IO35)
/IO4: J2.1, J8.18, J10.1
/IO25/EMAC_RXD0: J2.12, J8.7, J9.5, U1.9 (IO25)
/IO34: J8.3, U1.5 (IO34)
/LED_CONNECT/IO33: J2.7, J8.12, R3.1, U1.8 (IO33)
/LED_TIMER/IO2: J8.2, R34.1, U1.24 (IO2)
/MISO: J4.2, R29.2, U1.13 (IO12)
/MOSI: J4.3, R30.2, U1.15 (IO13)
/MTCK: J7.4, R30.1
/MTDI: J7.8, R29.1
/MTDO: J7.6, R31.1
/MTMS: J7.2, R28.1
/P00: IC6.4 (P00), J3.1
/P01: IC6.5 (P01), J3.2
/P02: IC6.6 (P02), J3.3
/P03: IC6.7 (P03), J3.4
/P04: IC6.8 (P04), J3.5
/P05: IC6.9 (P05), J3.6
/P06: IC6.10 (P06), J3.7
/P07: IC6.11 (P07), J3.8
/P08: IC6.13 (P10), J3.9
/P09: IC6.14 (P11), J3.10
/P10: IC6.15 (P12), J3.11
/P11: IC6.16 (P13), J3.12
/P12: IC6.17 (P14), J3.13
/P13: IC6.18 (P15), J3.14
/P14: IC6.19 (P16), J3.15
/P15: IC6.20 (P17), J3.16
/PWR_DEBUG: J7.1, U1.1 (3V3)
/REDE: J10.3; also elsewhere on the board
/REDE/IO4: J10.2, U1.26 (IO4)
/REF_CLK: J9.7, U1.25 (IO0)
/RST_SSID: SW2.1, U1.7 (IO32)
/RXD0: J8.14, U1.34 (RXD0)
/RXD1: J26.3, U1.16 (SD2)
/RXD2/IO16: J2.14, J8.5, J26.1, U1.27 (IO16)
/RXD_485: IC3.3 (IN1+), R32.2; also elsewhere on the board
/RX_485: J26.2, R32.1
/SCK: J4.1, R4.1, R28.2, U1.12 (IO14)
/SCL/EMAC_TXD1/IO22: IC6.22 (SCL), J3.17, J9.1, J11.1, R1.1, U1.36 (IO22)
/SDA/TX_EN/IO21: IC6.23 (SDA), J3.18, J9.3, J11.2, R2.1, U1.33 (IO21)
/SENS_V_N: J2.4, U1.4 (SENSOR_VN)
/SENS_V_P: J2.3, U1.3 (SENSOR_VP)
/TXD0: J8.15, U1.35 (TXD0)
/TXD1: J25.3, U1.17 (SD3)
/TXD2/IO17: J2.15, J8.4, J25.1, U1.28 (IO17)
/TXD_485: IC3.5 (IN2+), R33.2; also elsewhere on the board
/TX_485: J25.2, R33.1
/VSPI_CLK/MDIO/IO18: J2.10, J8.9, J9.9, U1.30 (IO18)
/VSPI_CSO/Reset_N/IO5: J2.11, J8.8, J9.2, U1.29 (IO5)
/VSPI_MISO/EMAC_TXD0/IO19: J2.9, J8.10, J9.4, U1.31 (IO19)
/VSPI_MOSI/MDC/IO23: J2.2, J8.16, J9.10, U1.37 (IO23)
GND: C3.2, C6.1, C12.2, IC3.2 (IN1-), IC3.4 (V-), IC3.6 (IN2-), IC6.12 (GND), J1.2, J1.3, J1.S1 (SHIELD), J1.S2 (SHIELD), J2.16, J2.17, J4.5, J6.4, J7.3, J7.5, J7.7, J7.9, J8.1, J9.11, J9.12, J12.1, J12.3, JP1.3 (B), JP2.3 (B), JP3.3 (B), LD1.1, LD2.1, LD5.1, LD6.1, LD7.1, SW1.2, SW2.2, U1.14 (GND1), U1.32 (GND2), U1.38 (GND3); also elsewhere on the board
unnamed: IC3.1 (OUT1), R5.2
unnamed: IC3.7 (OUT2), R8.2
unnamed: LD1.2, R34.2
unnamed: LD2.2, R3.2
unnamed: LD3.1, R5.1
unnamed: LD4.1, R8.1
unnamed: LD5.2, R6.2
unnamed: LD6.2, R7.2
unnamed: LD7.2, R4.2
V+: J1.1, J6.1; also elsewhere on the board

Notes on the sheet:
input only
DEBUG
V+ = max 18V
PCF8575
HEADERS IO
ESP32
SPI/RMII HEADERS
VSPI_CSO
Led Indicators
VSPI_MOSI
POWER
RS-485

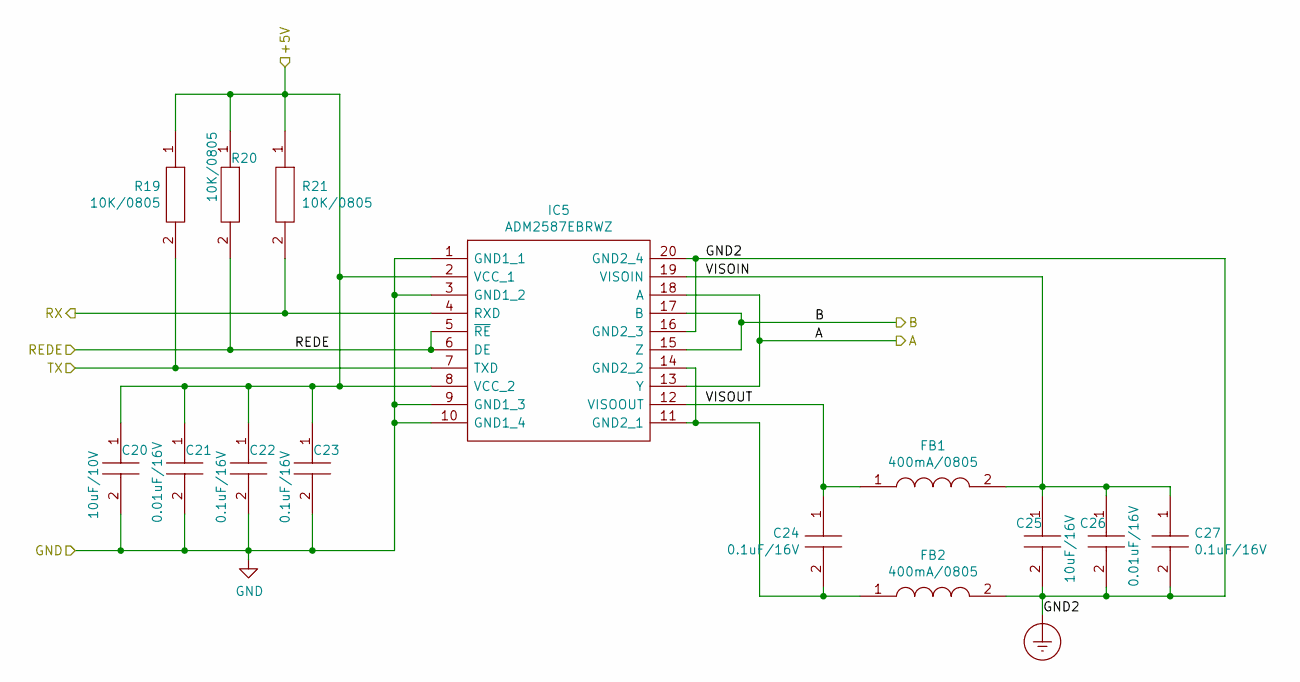
[picture p91: schematic ADM2587E_485.kicad_sch]

Parts:
C20: 10uF/10V; CAPC2012X145N; Mouser2 Part Number 810-C2012X8L106K125C
C21, C26: 0.01uF/16V; CAPC1005X56N; Manufacturer_Part_Number 0402YG103ZAT2A; Mouser Part Number 581-0402YG103ZAT2A
C22, C23, C24, C27: 0.1uF/16V; C_0402_1005Metric; Manufacturer_Part_Number C0402C104K4RECTU
C25: 10uF/16V; CAPC2012X145N; Mouser2 Part Number 810-C2012X8L106K125C
FB1, FB2: 400mA/0805; BEADC2012X105N; Manufacturer_Part_Number MMZ2012Y202BTD25; Mouser Part Number 810-MMZ2012Y202BTD25
IC5: ADM2587EBRWZ; SOIC127P1032X265-20N; Manufacturer_Part_Number ADM2587EBRWZ; Mouser Part Number 584-ADM2587EBRWZ
R19, R20, R21: 10K/0805; RESC2012X60N; Manufacturer_Part_Number RC0805JR-0710KL; Mouser Part Number 603-RC0805JR-0710KL

Connections:
+5V: C20.1, C21.1, C22.1, C23.1, IC5.2 (VCC_1), IC5.8 (VCC_2), R19.1, R20.1, R21.1; also elsewhere on the board
/ADM2587E/VISOIN: C25.1, C26.1, C27.1, FB1.2, IC5.19 (VISOIN); also elsewhere on the board
/ADM2587E/VISOUT: C24.1, FB1.1, IC5.12 (VISOOUT); also elsewhere on the board
/REDE: IC5.5 (~RE), IC5.6 (DE), R20.2; also elsewhere on the board
/RXD_485: IC5.4 (RXD), R21.2; also elsewhere on the board
/TXD_485: IC5.7 (TXD), R19.2; also elsewhere on the board
Earth_Protective: C25.2, C26.2, C27.2, FB2.2, IC5.16 (GND2_3), IC5.20 (GND2_4); also elsewhere on the board
GND: C20.2, C21.2, C22.2, C23.2, IC5.1 (GND1_1), IC5.3 (GND1_2), IC5.9 (GND1_3), IC5.10 (GND1_4); also elsewhere on the board
unnamed 76: C24.2, FB2.1, IC5.11 (GND2_1), IC5.14 (GND2_2); also elsewhere on the board
unnamed: IC5.13 (Y), IC5.18 (A)
unnamed: IC5.15 (Z), IC5.17 (B)

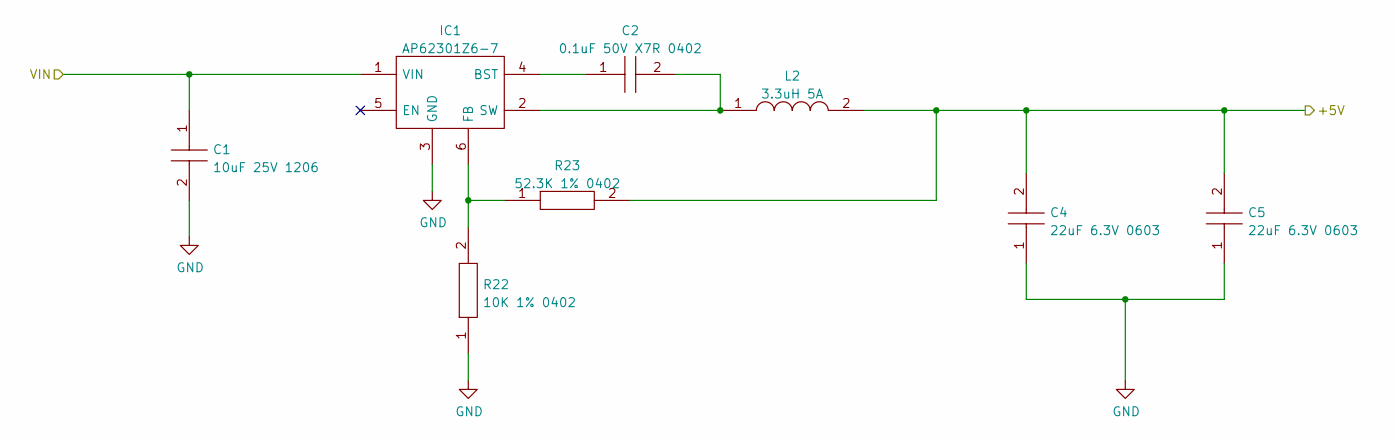
[picture p92: schematic AP62301Z6-7.kicad_sch]

Parts:
C1: 10uF 25V 1206; C_1206_3216Metric; Manufacturer_Part_Number CNC5L1X7R1E106K160AE; Mouser Part Number 810-CNC5LX7R1E106K16
C2: 0.1uF 50V X7R 0402; C_0402_1005Metric; Manufacturer_Part_Number GRM155R71H104KE14D; Mouser Part Number 81-GRM155R71H104KE4D
C4, C5: 22uF 6.3V 0603; C_0603_1608Metric; Manufacturer_Part_Number GRM188R60J226MEA0D; Mouser Part Number 81-GRM188R60J226ME0D
IC1: AP62301Z6-7; SOTFL50P162X60-6N; Manufacturer_Part_Number AP62301Z6-7; Mouser Part Number 621-AP62301Z6-7
L2: 3.3uH 5A; VLS6045; Manufacturer_Part_Number VLS6045AF-3R3N; Mouser Part Number 810-VLS6045AF-3R3N
R22: 10K 1% 0402; R_0402_1005Metric; Manufacturer_Part_Number AC0402FR-0710KL; Mouser Part Number 603-AC0402FR-0710KL
R23: 52.3K 1% 0402; R_0402_1005Metric; Manufacturer_Part_Number ERJ-2RKF5232X; Mouser Part Number 667-ERJ-2RKF5232X

Connections:
+5V: C4.2, C5.2, L2.2, R23.2; also elsewhere on the board
GND: C1.2, C4.1, C5.1, IC1.3 (GND), R22.1; also elsewhere on the board
unnamed: C2.1, IC1.4 (BST)
unnamed: IC1.6 (FB), R22.2, R23.1
unnamed: C2.2, IC1.2 (SW), L2.1
V+: C1.1, IC1.1 (VIN); also elsewhere on the board

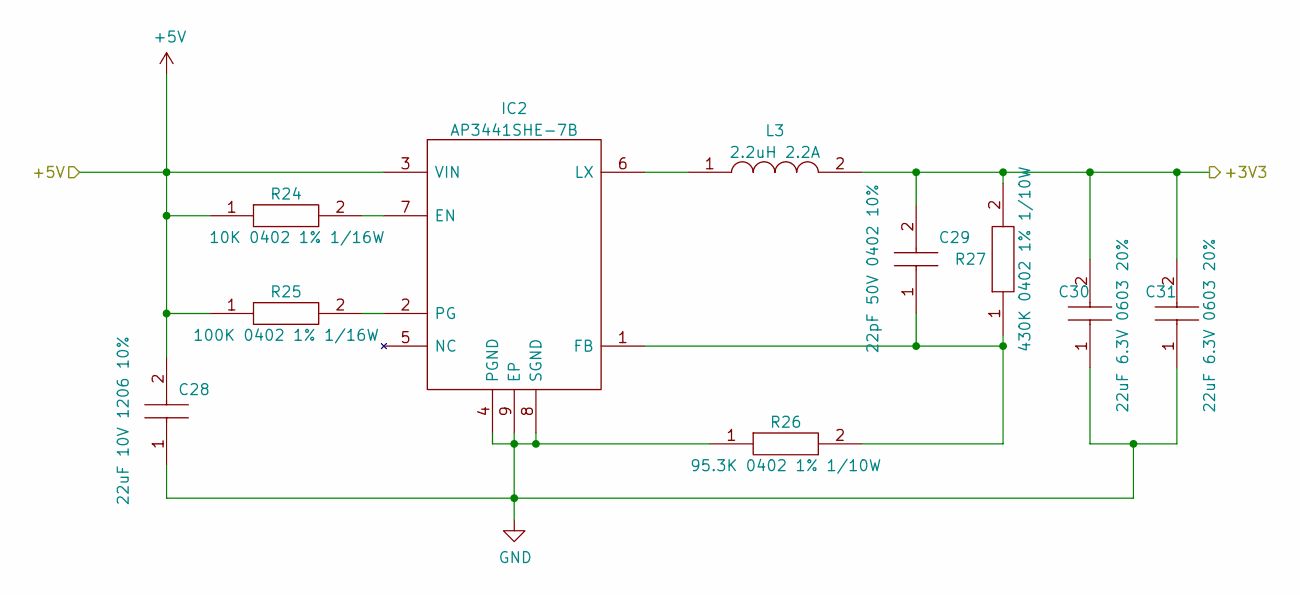
[picture p93: schematic AP3441SHE-7B.kicad_sch]

Parts:
C28: 22uF 10V 1206 10%; C_1206_3216Metric; Manufacturer_Part_Number GRM31CR71A226KE15L; Mouser Part Number 81-GRM31CR71A226K15L
C29: 22pF 50V 0402 10%; C_0402_1005Metric; Manufacturer_Part_Number C0402C220K5RACTU; Mouser Part Number 80-C0402C220K5RACTU
C30, C31: 22uF 6.3V 0603 20%; C_0603_1608Metric; Manufacturer_Part_Number GRM188R60J226MEA0D; Mouser Part Number 81-GRM188R60J226ME0D
IC2: AP3441SHE-7B; SON50P201X201X60-9N-D; Manufacturer_Part_Number AP3441SHE-7B; Mouser Part Number 621-AP3441SHE-7B
L3: 2.2uH 2.2A; DFE2HCAH1R0MJ0L; Manufacturer_Part_Number 1239AS-H-2R2M=P2; Mouser Part Number 81-1239AS-H-2R2MP2
R24: 10K 0402 1% 1/16W; R_0402_1005Metric; Manufacturer_Part_Number AC0402FR-0710KL; Mouser Part Number 603-AC0402FR-0710KL
R25: 100K 0402 1% 1/16W; R_0402_1005Metric; Manufacturer_Part_Number SFR01MZPF1003; Mouser Part Number 755-SFR01MZPF1003
R26: 95.3K 0402 1% 1/10W; R_0402_1005Metric; Manufacturer_Part_Number ERJ-U02F9532X; Mouser Part Number 667-ERJ-U02F9532X
R27: 430K 0402 1% 1/10W; R_0402_1005Metric; Manufacturer_Part_Number ERJ-U02F4303X

Connections:
+3V3: C29.2, C30.2, C31.2, L3.2, R27.2; also elsewhere on the board
+5V: C28.2, IC2.3 (VIN), R24.1, R25.1; also elsewhere on the board
GND: C28.1, C30.1, C31.1, IC2.4 (PGND), IC2.8 (SGND), IC2.9 (EP), R26.1; also elsewhere on the board
unnamed: IC2.7 (EN), R24.2
unnamed: C29.1, IC2.1 (FB), R26.2, R27.1
unnamed: IC2.6 (LX), L3.1
unnamed: IC2.2 (PG), R25.2

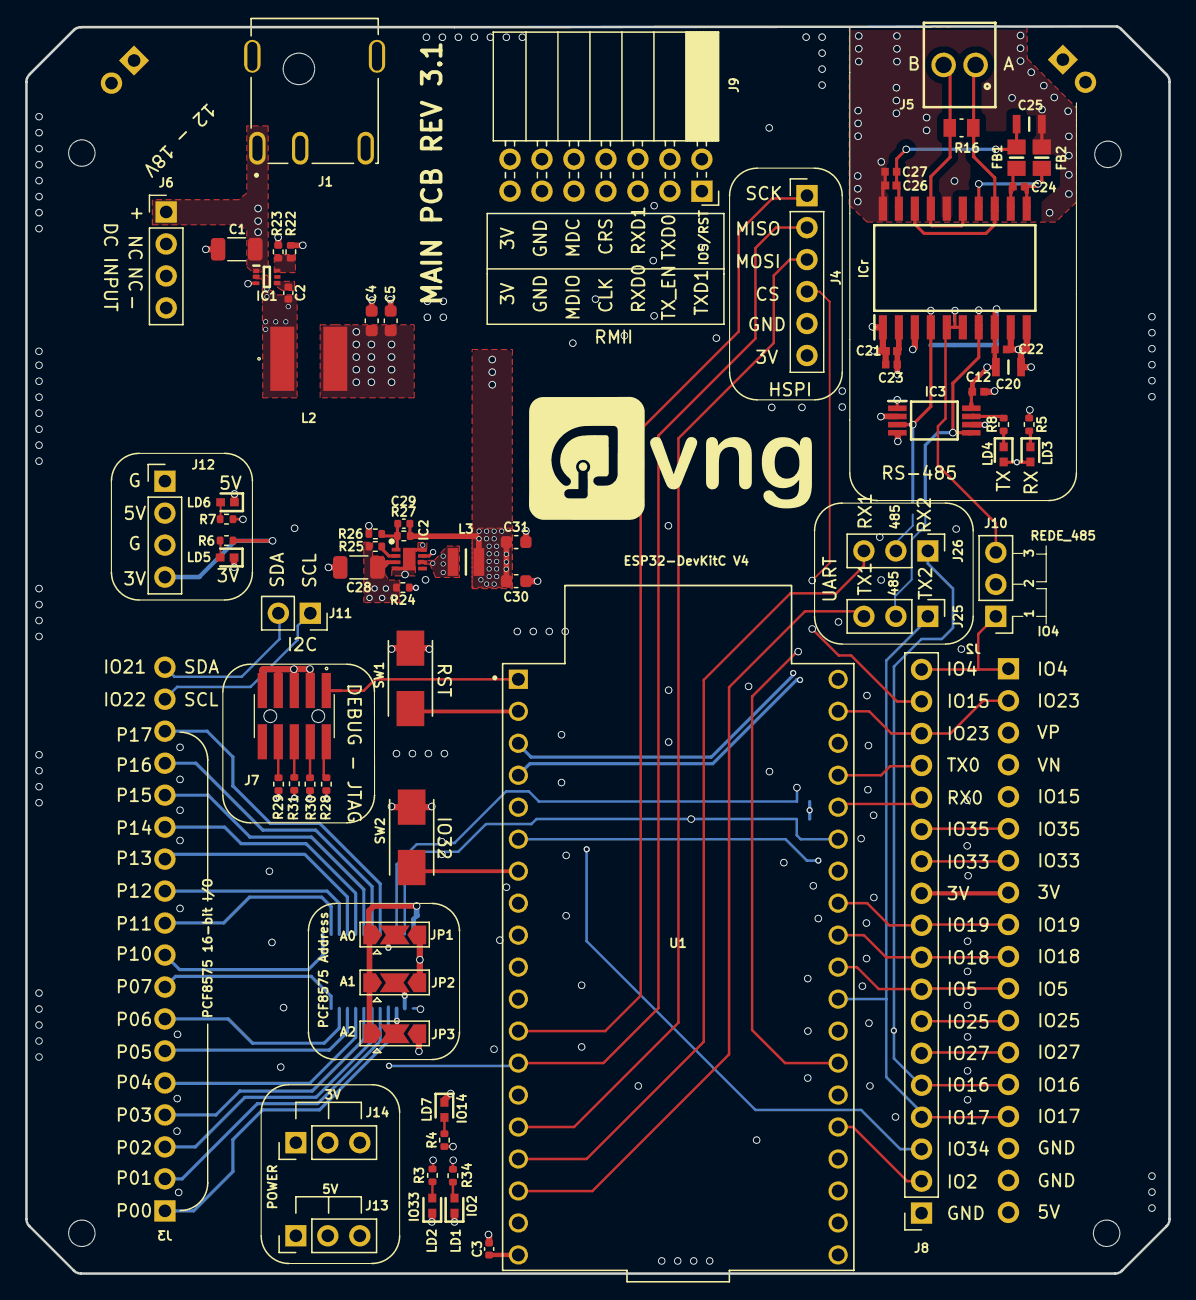
[picture p94: board esp_mini_open_brd.kicad_pcb from above]

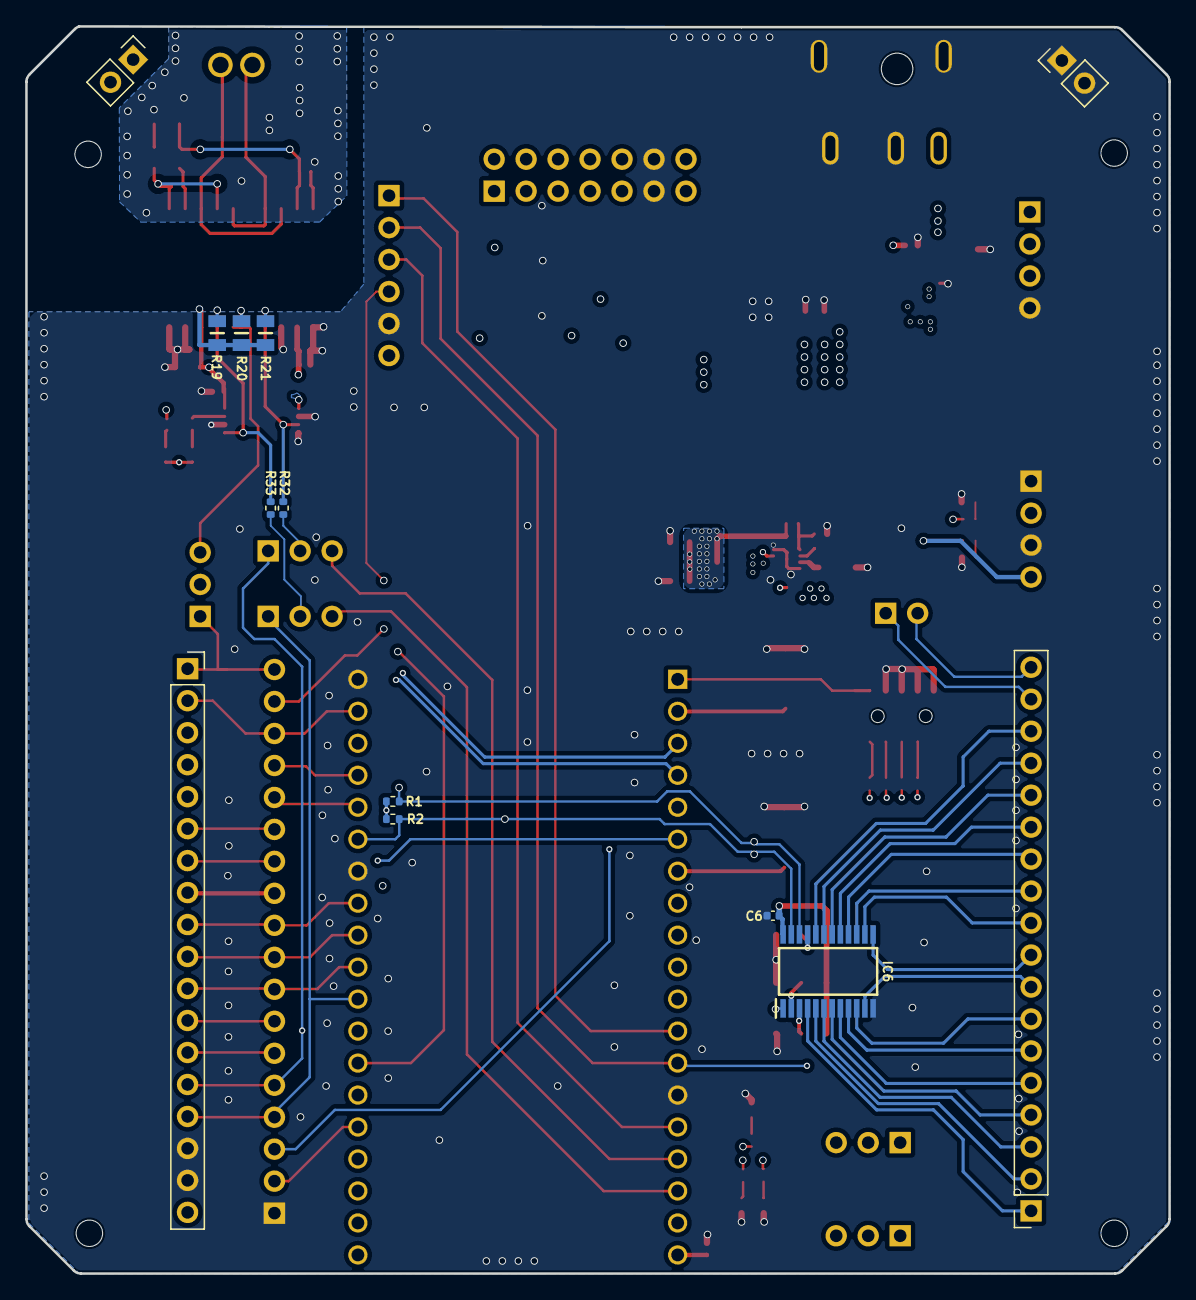
[picture p95: board esp_mini_open_brd.kicad_pcb from below]

Board: 4 copper layers, 90.8 x 99.1 mm, 82 parts (11 on the bottom side), 85 nets.

Other parts of the board:
ICr: ADM2587EBRWZ; SOIC127P1032X265-20N

Their connections:
+5V: ICr.2 (VCC_1), ICr.8 (VCC_2); also elsewhere on the board
/A: ICr.13 (Y), ICr.18 (A); also elsewhere on the board
/ADM2587E/VISOIN: ICr.19 (VISOIN); also elsewhere on the board
/ADM2587E/VISOUT: ICr.12 (VISOOUT); also elsewhere on the board
/B: ICr.15 (Z), ICr.17 (B); also elsewhere on the board
/REDE: ICr.5 (~RE), ICr.6 (DE); also elsewhere on the board
/RXD_485: ICr.4 (RXD); also elsewhere on the board
/TXD_485: ICr.7 (TXD); also elsewhere on the board
Earth_Protective: ICr.16 (GND2_3), ICr.20 (GND2_4); also elsewhere on the board
GND: ICr.1 (GND1_1), ICr.3 (GND1_2), ICr.9 (GND1_3), ICr.10 (GND1_4); also elsewhere on the board
unnamed 76: ICr.11 (GND2_1), ICr.14 (GND2_2); also elsewhere on the board
