lincvv/kicad_space/Resources/lib_kicad/kicad-mikroBUS-master/kicad-mikroBUS-master/examples/si5351-MikroBUS/si5351-MikroBUS.kicad_pcb

## KiCad design Resources/lib_kicad/kicad-mikroBUS-master/kicad-mikroBUS-master/examples/si5351-MikroBUS/si5351-MikroBUS.kicad_pcb (2024-06-23)


Board: 2 copper layers, 25.4 x 26.2 mm, 9 parts (1 on the bottom side), 9 nets.

Parts:
*: MIKROCLICK_LOGO; MIKROBUS_LOGO
C1, C2: 0.1u; C_0603_HandSoldering
CON101: MIKROBUS_MODULE_CONN
J1, J2, J3: 5-1814832-1; RF_SMA_Vertical_5-1814832-1
U1: SI5351A-B-GT; MSOP-10_W3mm
Y1: 27 MHz; Crystal_SMD_3225-4pin_3.2x2.5mm_HandSoldering

Connections:
+3V3: C1.1, C2.2, CON101.P7, U1.1, U1.7
/SCL: CON101.P12, U1.4
/SDA: CON101.P11, U1.5
GND: C1.2, C2.1, CON101.P8, CON101.P9, J1.1, J2.1, J3.1, U1.8, Y1.2, Y1.4
unnamed: J1.2, U1.10
unnamed: J2.2, U1.9
unnamed: J3.2, U1.6
unnamed: U1.2, Y1.1
unnamed: U1.3, Y1.3
