lincvv/kicad_space/Resources/lib_kicad/kicad-mikroBUS-master/kicad-mikroBUS-master/examples/stm32-mikroBUS/stm32-mikroBUS.kicad_pcb

## KiCad design Resources/lib_kicad/kicad-mikroBUS-master/kicad-mikroBUS-master/examples/stm32-mikroBUS/stm32-mikroBUS.kicad_pcb (2024-06-23)


Board: 2 copper layers, 91.4 x 78.7 mm, 9 parts (0 on the bottom side), 30 nets.

Parts:
C1: 10u/50V; CP_Tantalum_Case-C_EIA-6032-28_Hand
C2: 22u/16V; CP_Tantalum_Case-C_EIA-6032-28_Hand
CON1: 1; MIKROBUS_HOST_CONN
CON2: 2; MIKROBUS_HOST_CONN
CON3: 3; MIKROBUS_HOST_CONN
CON4: 4; MIKROBUS_HOST_CONN
J1: 6.5-32 VDC; Barrel_Jack_CUI_PJ-102AH
U1: V7805-1000; 3-SIP_Module_V7805-1000
U2: BlackPill

Connections:
+3V3: CON1.P7, CON2.P7, CON3.P7, CON4.P7, U2.33
+5V: C2.1, CON1.P10, CON2.P10, CON3.P10, CON4.P10, U1.3
/A1: CON1.P1, U2.6
/A2: CON2.P1, CON4.P16, U2.7
/A3: CON2.P16, CON3.P1, U2.14
/A4: CON3.P16, CON4.P1, U2.15
/I1: CON1.P15, U2.28
/I2: CON2.P15, U2.29
/I3: CON3.P15, U2.30
/I4: CON4.P15, U2.2
/MISO1: CON1.P5, CON2.P5, U2.12
/MISO2: CON3.P5, CON4.P5, U2.20
/MOSI1: CON1.P6, CON2.P6, U2.13
/MOSI2: CON3.P6, CON4.P6, U2.21
/PWM1: CON1.P16, U2.22
/RX1: CON1.P14, CON4.P14, U2.24
/RX2: CON2.P14, CON3.P14, U2.9
/SCK1: CON1.P4, CON2.P4, U2.11
/SCK2: CON3.P4, CON4.P4, U2.19
/SCL1: CON1.P12, CON3.P12, U2.31
/SCL2: CON2.P12, CON4.P12, U2.16
/SDA1: CON1.P11, CON3.P11, U2.32
/SDA2: CON2.P11, CON4.P11, U2.17
/SS1: CON1.P3, CON2.P3, U2.10
/SS2: CON3.P3, CON4.P3, U2.18
/TX1: CON1.P13, CON4.P13, U2.23
/TX2: CON2.P13, CON3.P13, U2.8
GND: C1.2, C2.2, CON1.P8, CON1.P9, CON2.P8, CON2.P9, CON3.P8, CON3.P9, CON4.P8, CON4.P9, J1.2, U1.2, U2.1, U2.34
unnamed: C1.1, J1.1, U1.1
unnamed: CON1.P2, CON2.P2, CON3.P2, CON4.P2, U2.5
