lincvv/kicad_space/Projects/Design/nti/dock_rs232/CP2102N.kicad_sch

## KiCad design Projects/Design/nti/dock_rs232/CP2102N.kicad_sch (2024-06-23)


Parts:
C25, C27: 0.1uF 16V 0402; C_0402_1005Metric; Manufacturer_Part_Number GRM155R71C104KA88D; Mouser Part Number N/A
C26, C28: 4.7uF 6.3V 0402; C_0402_1005Metric; Manufacturer_Part_Number GRM155R60J475ME47D; Mouser Part Number 81-GRM155R60J475ME7D
IC5: CP2102N-A02-GQFN20; CP2102NA02GQFN20; Manufacturer_Part_Number CP2102N-A02-GQFN20; Mouser Part Number 634-CP2102NA02GQFN20
R21: 1K 0402; R_0402_1005Metric; Manufacturer_Part_Number RT0402FRE071KL; Mouser Part Number 603-RT0402FRE071KL
R22: 22K6 0402; R_0402_1005Metric; Manufacturer_Part_Number CPF0402B22K6E1; Mouser Part Number 279-CPF0402B22K6E1
R23: 47K 0402 1%; R_0402_1005Metric; Manufacturer_Part_Number AT0402FRE0747KL

Connections:
CTS: IC5.15 (CTS)
GND: C25.1, C26.1, C27.1, C28.1, IC5.3 (GND_1), IC5.12 (GND_2), IC5.21 (EP_GND), R23.1
unnamed: IC5.8 (VBUS), R22.1, R23.2
RSTB: IC5.9 (RSTB), R21.1
RTS: IC5.16 (RTS)
RXD: IC5.17 (RXD)
TXD: IC5.18 (TXD)
USB_N: IC5.5 (D-)
USB_P: IC5.4 (D+)
VBUS5V: C25.2, C26.2, IC5.7 (VREGIN), R22.2
VDD: C27.2, C28.2, IC5.6 (VDD), R21.2
