lincvv/kicad_space/Projects/Design/nti/dock_rs232/LAN9500A.kicad_sch

## KiCad design Projects/Design/nti/dock_rs232/LAN9500A.kicad_sch (2024-06-23)


Parts:
C38, C39, C40, C43, C44, C45, C46, C47, C48, C49, C51, C53, C60, C61: 0.1uF 16V 0402; C_0402_1005Metric; Manufacturer_Part_Number GRM155R71C104KA88D; Mouser Part Number N/A
C41, C42: 10pF 50V 2% 0402; C_0402_1005Metric; Manufacturer_Part_Number GJM1555C1H100GB01D; Mouser Part Number 81-GJM1555C1H100GB01
C50: 1uF 0402 25V X5R; C_0402_1005Metric; Manufacturer_Part_Number GRM155R61E105KA12D; Mouser Part Number 81-GRM155R61E105KA2D
C52: 0.022uF 50V 0805; C_0805_2012Metric; Manufacturer_Part_Number AC0805KRX7R9BB223; Mouser Part Number 603-AC805KRX7R9BB223
C54: 1000pF 2kV 1206; C_1206_3216Metric; Manufacturer_Part_Number C1206C102KGRACAUTO; Mouser Part Number 80-C1206C102KGRAUTO
D1: CDDFN10-3324P; CDDFN103324P; Manufacturer_Part_Number CDDFN10-3324P; Mouser Part Number 652-CDDFN10-3324P
FL1, FL2, FL3: 120R; L_0603_1608Metric; Manufacturer_Part_Number BLM18AG121SN1D; Mouser Part Number 81-BLM11A121S
IC7: MIC803-29D4VC3-TR; SOT65P210X100-3N; Manufacturer_Part_Number MIC803-29D4VC3-TR; Mouser Part Number 998-MIC803-29D4VC3TR
IC8: LAN9500AI-ABZJ; QFN50P800X800X100-57N-D; Manufacturer_Part_Number LAN9500AI-ABZJ; Mouser Part Number 886-LAN9500AI-ABZJ
R3: 0R 0805; R_0805_2012Metric; Manufacturer_Part_Number ERJ-6GEY0R00V; Mouser Part Number 667-ERJ-6GEY0R00V
R32: 100K 0402 1% 1/16W; R_0402_1005Metric; Manufacturer_Part_Number SFR01MZPF1003; Mouser Part Number 755-SFR01MZPF1003
R34, R35: 12K 1% 0402; R_0402_1005Metric; Manufacturer_Part_Number ERJ-U02F1202X
R36, R41: 0R 0402; R_0402_1005Metric; Manufacturer_Part_Number CR0402-J/-000GLF; Mouser Part Number 652-CR0402-J/-000GLF
R37, R38, R39, R40: 49.9R 1% 0402; R_0402_1005Metric; Manufacturer_Part_Number ERJ-2RKF49R9X; Mouser Part Number 667-ERJ-2RKF49R9X
R42, R44: 75R 1% 0402; R_0402_1005Metric; Manufacturer_Part_Number ERJ-2RKF75R0X; Mouser Part Number 667-ERJ-2RKF75R0X
T1: HX0068ANL; Manufacturer_Part_Number HX0068ANL; Mouser Part Number 673-HX0068ANL
Y2: ABM8G-25.000MHZ-4Y-T3; ABM8G48000MHZ18D2YT; Manufacturer_Part_Number ABM8G-25.000MHZ-4Y-T3; Mouser Part Number 815-ABM8G-25-4YT3

Connections:
+3.3VA: C46.2, C47.2, C48.2, FL1.2, IC8.4 (VDD33A_1), IC8.9 (VDD33A_2), IC8.15 (VDD33A_3), R37.2, R38.2, R39.2, R40.2, R41.2
+3V3: C38.2, C39.2, C40.2, C43.2, C44.2, C61.2, FL1.1, IC7.3 (VCC), IC8.25 (VDD33IO_1), IC8.35 (VDD33IO_2), IC8.36 (NTRST/RXD0), IC8.38 (TCK/RXD1), IC8.39 (TMS/RXD2), IC8.40 (TDI/RXD3), IC8.48 (VDD33IO_3), IC8.49 (TEST1), IC8.51 (VDD33IO_4), IC8.52 (VDD33IO_5), R32.2, R36.2
GND: C38.1, C39.1, C40.1, C41.1, C42.1, C43.1, C44.1, C45.1, C46.1, C47.1, C48.1, C49.1, C50.1, C51.1, C52.1, C53.1, C60.1, C61.1, D1.3 (GND_1), D1.8 (GND_2), IC7.1 (GND), IC8.13 (TEST2), IC8.33 (TEST3), IC8.34 (PHY_SEL), IC8.57 (EP), R3.1, R34.1, R35.1, Y2.2 (GND_1), Y2.4 (GND_2)
GNDPWR: C54.1, R3.2
LAN_RST_N: C45.2, IC7.2 (~RESET), IC8.24 (NRESET), R32.1
unnamed: C41.2, IC8.19 (XO), Y2.1 (CRYSTAL_1)
unnamed: C42.2, IC8.18 (XI), Y2.3 (CRYSTAL_2)
unnamed: C52.2, R41.1, T1.3 (RDCT), T1.4 (TDCT)
unnamed: C54.2, R42.1, R44.1
unnamed: IC8.8 (EXRES), R34.2
unnamed: IC8.16 (USBRBIAS), R35.2
unnamed: IC8.20 (VBUS_DET), R36.1
unnamed: R42.2, T1.9 (TXCT)
unnamed: R44.2, T1.10 (RXCT)
RD_N: T1.11 (RX-)
RD_P: T1.12 (RX+)
RX_N: D1.2 (IN/OUT_2), D1.9 (NC_3), IC8.5 (RXN), R40.1, T1.2 (RD-)
RX_P: D1.1 (IN/OUT_1), D1.10 (NC_4), IC8.6 (RXP), R39.1, T1.1 (RD+)
TD_N: T1.7 (TX-)
TD_P: T1.8 (TX+)
TX_N: D1.5 (IN/OUT_4), D1.6 (NC_1), IC8.2 (TXN), R38.1, T1.6 (TD-)
TX_P: D1.4 (IN/OUT_3), D1.7 (NC_2), IC8.3 (TXP), R37.1, T1.5 (TD+)
USBD_N: IC8.11 (USBDM)
USBD_P: IC8.12 (USBDP)
VDDCORE: C49.2, C50.2, C60.2, FL2.1, FL3.1, IC8.21 (VDDCORE_1), IC8.50 (VDDCORE_2)
VDDPLL: C51.2, FL2.2, IC8.10 (VDDPLL)
VDDUSBPLL: C53.2, FL3.2, IC8.17 (VDDUSBPLL)
