lincvv/kicad_space/Projects/Design/nti/dock_rs232/LTM8055.kicad_sch

## KiCad design Projects/Design/nti/dock_rs232/LTM8055.kicad_sch (2024-06-23)


Parts:
C62, C63: 4.7uF 50V 1210; C_1210_3225Metric; Manufacturer_Part_Number CC1210KFX7R9BB475; Mouser Part Number 603-CC1210KFX7R9B475
C64: 0.1uF 16V 0402; C_0402_1005Metric; Manufacturer_Part_Number GRM155R71C104KA88D; Mouser Part Number N/A
C65, C66: 22uF 25V 0805; C_0805_2012Metric; Manufacturer_Part_Number GRT21BR61E226ME13L; Mouser Part Number 81-GRT21BR61E226ME3L
C67: 330uF 35V 20mOm; CAPPRD530W65D1000H1050; Manufacturer_Part_Number EEH-AZK1V331B; Mouser Part Number 667-EEH-AZK1V331B
C70: 150uF 25V 25mOm; CAPAE1030X800N; Mouser Part Number 661-APXG250A151MJ80G
IC9: LTM8055IY-1#PBF; BGA121C127P11X11_1500X1500X512; Manufacturer_Part_Number LTM8055IY-1#PBF; Mouser Part Number 584-LTM8055IY-1#PBF
R4, R5, R33: 0R 0603; R_0603_1608Metric; Manufacturer_Part_Number ERJ-U030R00V; Mouser Part Number 667-ERJ-U030R00V
R24: 0.008R 1% 0805; RESC2012X47N; Manufacturer_Part_Number PMR10EZPFU8L00; Mouser Part Number 755-PMR10EZPFU8L00
R25: 100K 1% 0603; R_0603_1608Metric; Manufacturer_Part_Number ERJ-PA3F1003V; Mouser Part Number 667-ERJ-PA3F1003V
R26: 6.65K 1% 0603; R_0603_1608Metric; Manufacturer_Part_Number ERJ-PA3F6651V
R27: 24.9K 1% 0603; R_0603_1608Metric; Manufacturer_Part_Number CR0603-FX-2492ELF; Mouser Part Number 652-CR0603FX-2492ELF

Connections:
8-24V: C62.2, C63.2, C67.1, IC9.F10 (SVIN_1), IC9.F11 (SVIN_2), IC9.G10 (VIN_1), IC9.G11 (VIN_2), IC9.H10 (VIN_3), IC9.H11 (VIN_4), IC9.J10 (VIN_5), IC9.J11 (VIN_6), IC9.K10 (VIN_7), IC9.K11 (VIN_8), IC9.L9 (IIN), IC9.L10 (VIN_9), IC9.L11 (VIN_10), R4.2
19V: C65.2, IC9.D1 (IOUT), R24.2
FB: IC9.J1 (FB), R25.1, R26.2
GND: C62.1, C63.1, C64.2, C65.1, C66.1, C67.2, C70.2, IC9.A7 (GND_1), IC9.A8 (GND_2), IC9.A9 (GND_3), IC9.A10 (GND_4), IC9.A11 (GND_5), IC9.B7 (GND_6), IC9.B8 (GND_7), IC9.B9 (GND_8), IC9.B10 (GND_9), IC9.B11 (GND_10), IC9.C7 (GND_11), IC9.C8 (GND_12), IC9.C9 (GND_13), IC9.C10 (GND_14), IC9.C11 (GND_15), IC9.D2 (GND_16), IC9.D3 (GND_17), IC9.D4 (GND_18), IC9.D5 (GND_19), IC9.D6 (GND_20), IC9.D7 (GND_21), IC9.D8 (GND_22), IC9.D9 (GND_23), IC9.D10 (GND_24), IC9.D11 (GND_25), IC9.E1 (GND_26), IC9.E2 (GND_27), IC9.E3 (GND_28), IC9.E4 (GND_29), IC9.E5 (GND_30), IC9.E6 (GND_31), IC9.E7 (GND_32), IC9.E8 (GND_33), IC9.E9 (GND_34), IC9.E10 (GND_35), IC9.E11 (GND_36), IC9.F2 (GND_37), IC9.F3 (GND_38), IC9.F4 (GND_39), IC9.F5 (GND_40), IC9.F6 (GND_41), IC9.F7 (GND_42), IC9.F8 (GND_43), IC9.F9 (GND_44), IC9.G3 (GND_45), IC9.G4 (GND_46), IC9.G5 (GND_47), IC9.G6 (GND_48), IC9.G7 (GND_49), IC9.G8 (GND_50), IC9.G9 (GND_51), IC9.H2 (SYNC), IC9.H3 (GND_52), IC9.H4 (GND_53), IC9.H5 (GND_54), IC9.H6 (GND_55), IC9.H7 (GND_56), IC9.H8 (GND_57), IC9.H9 (GND_58), IC9.J3 (GND_59), IC9.J4 (GND_60), IC9.J5 (GND_61), IC9.J6 (GND_62), IC9.J7 (GND_63), IC9.J8 (GND_64), IC9.J9 (GND_65), IC9.K3 (GND_66), IC9.K4 (GND_67), IC9.K5 (GND_68), IC9.K6 (GND_69), IC9.K7 (GND_70), IC9.K8 (GND_71), IC9.K9 (GND_72), IC9.L1 (GND_73), IC9.L5 (GND_74), IC9.L6 (GND_75), IC9.L7 (GND_76), IC9.L8 (GND_77), R5.1, R26.1, R27.2
LL: IC9.F1 (LL), R33.2
MODE: C64.1, IC9.G2 (MODE), R33.1
RT: IC9.H1 (RT), R27.1
RUN: IC9.L4 (RUN), R4.1, R5.2
VOUT: C66.2, C70.1, IC9.A1 (VOUT_1), IC9.A2 (VOUT_2), IC9.A3 (VOUT_3), IC9.A4 (VOUT_4), IC9.A5 (VOUT_5), IC9.A6 (VOUT_6), IC9.B1 (VOUT_7), IC9.B2 (VOUT_8), IC9.B3 (VOUT_9), IC9.B4 (VOUT_10), IC9.B5 (VOUT_11), IC9.B6 (VOUT_12), IC9.C1 (VOUT_13), IC9.C2 (VOUT_14), IC9.C3 (VOUT_15), IC9.C4 (VOUT_16), IC9.C5 (VOUT_17), IC9.C6 (VOUT_18), R24.1, R25.2
