lincvv/kicad_space/Projects/Design/nti/dock_rs232/MAX1837EUT33.kicad_sch

## KiCad design Projects/Design/nti/dock_rs232/MAX1837EUT33.kicad_sch (2024-06-23)

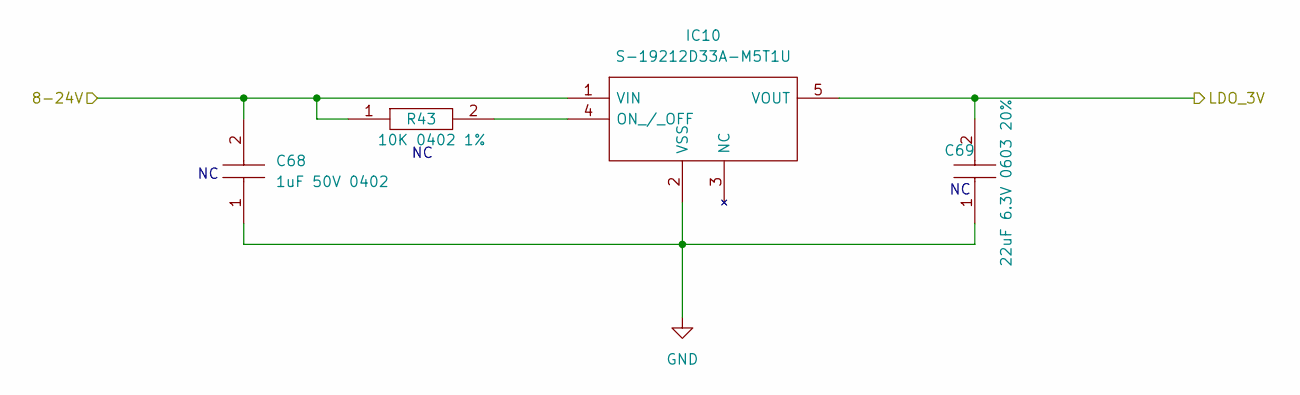
[picture p98: schematic MAX1837EUT33.kicad_sch]

Parts:
C68: 1uF 50V 0402; C_0402_1005Metric; Manufacturer_Part_Number UMK105CBJ105KV-F; Mouser Part Number 963-UMK105CBJ105KV-F
C69: 22uF 6.3V 0603 20%; C_0603_1608Metric; Manufacturer_Part_Number GRM188R60J226MEA0D; Mouser Part Number 81-GRM188R60J226ME0D
IC10: S-19212D33A-M5T1U; SOT95P275X130-5N; Manufacturer_Part_Number S-19212D33A-M5T1U; Mouser Part Number 628-S19212D33AM5T1U
R43: 10K 0402 1%; R_0402_1005Metric; Manufacturer_Part_Number AC0402FR-0710KL; Mouser Part Number 603-AC0402FR-0710KL

Connections:
8-24V: C68.2, IC10.1 (VIN), R43.1
GND: C68.1, C69.1, IC10.2 (VSS)
LDO_3V: C69.2, IC10.5 (VOUT)
unnamed: IC10.4 (ON_/_OFF), R43.2
