lincvv/kicad_space/Projects/Design/nti/dock_rs232/MAX3232_EP.kicad_sch

## KiCad design Projects/Design/nti/dock_rs232/MAX3232_EP.kicad_sch (2024-06-23)


Parts:
C55, C56, C57, C58, C59: 0.1uF 50V 0402 X7R; C_0402_1005Metric; Manufacturer_Part_Number GRM155R71H104KE14D; Mouser Part Number 81-GRM155R71H104KE4D
U2: MAX3232MDBREP

Connections:
+3V3: C56.2, U2.16 (VCC)
CTS: U2.9 (ROUT2)
GND: C56.1, C57.1, C58.1, U2.15 (GND)
unnamed: C55.1, U2.3 (C1-)
unnamed: C55.2, U2.1 (C1+)
unnamed: C57.2, U2.6 (V-)
unnamed: C58.2, U2.2 (V+)
unnamed: C59.1, U2.4 (C2+)
unnamed: C59.2, U2.5 (C2-)
RS232_CTS: U2.8 (RIN2)
RS232_RTS: U2.7 (DOUT2)
RS232_RXD: U2.13 (RIN1)
RS232_TXD: U2.14 (DOUT1)
RTS: U2.10 (DIN2)
RXD: U2.12 (ROUT1)
TXD: U2.11 (DIN1)
