lincvv/kicad_space/Projects/Design/nti/dock_rs232/TPS259460LRPWR_5V.kicad_sch

## KiCad design Projects/Design/nti/dock_rs232/TPS259460LRPWR_5V.kicad_sch (2024-06-23)

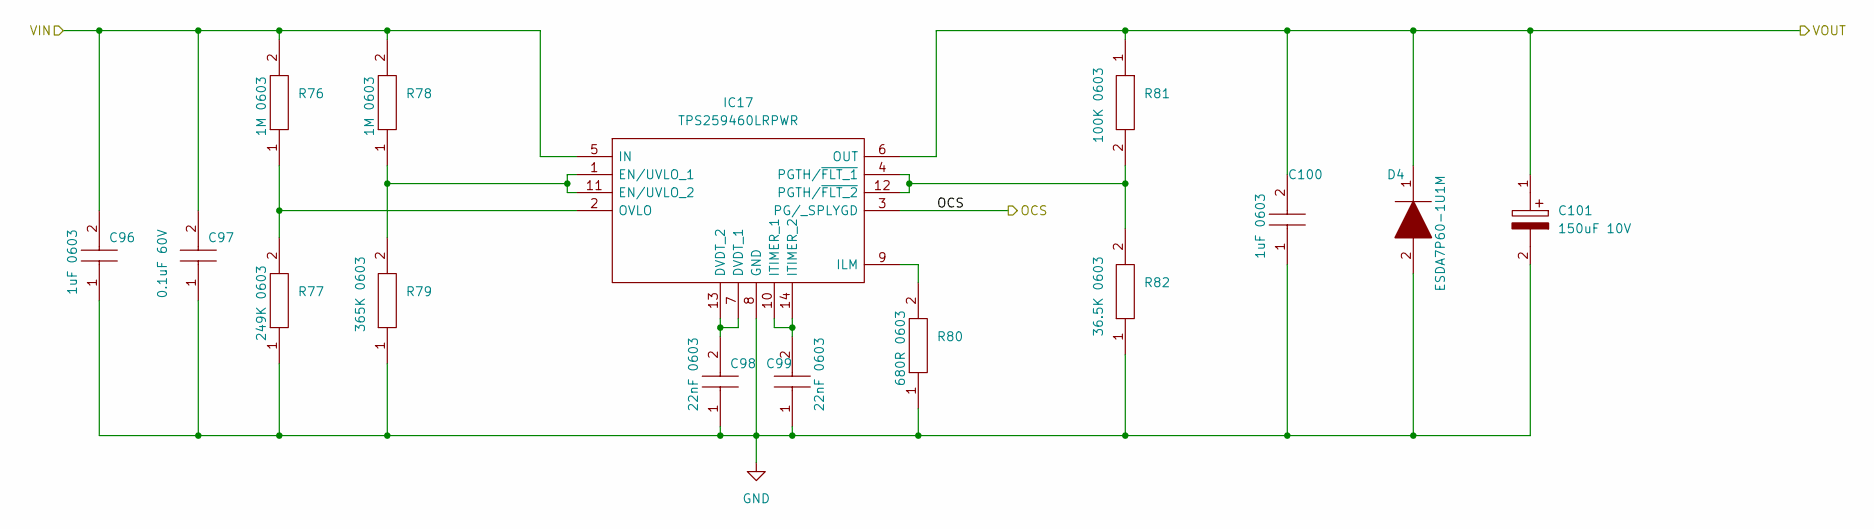
[picture p99: schematic TPS259460LRPWR_5V.kicad_sch]

Parts:
C96, C100: 1uF 0603; C_0603_1608Metric; Manufacturer_Part_Number 06035C105KAT2A; Mouser Part Number 581-06035C105KAT2A
C97: 0.1uF 60V; C_0603_1608Metric; Manufacturer_Part_Number 06035C104K4Z2A; Mouser Part Number 581-06035C104K4Z2A
C98, C99: 22nF 0603; C_0603_1608Metric; Manufacturer_Part_Number 885382206003; Mouser Part Number 710-885382206003
C101: 150uF 10V; 10TPB150MGL; Manufacturer_Part_Number 10TPB150MGL; Mouser Part Number 667-10TPB150MGL
D4: ESDA7P60-1U1M; ESDA7P601U1M; Manufacturer_Part_Number ESDA7P60-1U1M; Mouser Part Number 511-ESDA7P60-1U1M
IC17: TPS259460LRPWR; Manufacturer_Part_Number TPS259460ARPWR
R76, R78: 1M 0603; R_0603_1608Metric; Manufacturer_Part_Number RC0603FR-071ML; Mouser Part Number 603-RC0603FR-071ML
R77: 249K 0603; R_0603_1608Metric; Manufacturer_Part_Number CRCW0603249KFKEB; Mouser Part Number 71-CRCW0603249KFKEB
R79: 365K 0603; R_0603_1608Metric; Manufacturer_Part_Number CR0603-FX-3653ELF; Mouser Part Number 652-CR0603FX-3653ELF
R80: 680R 0603; R_0603_1608Metric; Manufacturer_Part_Number CRGH0603F680R
R81: 100K 0603; R_0603_1608Metric; Manufacturer_Part_Number RC0603FR-07100KL; Mouser Part Number 603-RC0603FR-07100KL
R82: 36.5K 0603; R_0603_1608Metric; Manufacturer_Part_Number CR0603-FX-3652ELF

Connections:
GND: C96.1, C97.1, C98.1, C99.1, C100.1, C101.2, D4.2, IC17.8 (GND), R77.1, R79.1, R80.1, R82.1
unnamed: C98.2, IC17.7 (DVDT_1), IC17.13 (DVDT_2)
unnamed: C99.2, IC17.10 (ITIMER_1), IC17.14 (ITIMER_2)
unnamed: IC17.1 (EN/UVLO_1), IC17.11 (EN/UVLO_2), R78.1, R79.2
unnamed: IC17.2 (OVLO), R76.1, R77.2
unnamed: IC17.9 (ILM), R80.2
unnamed: IC17.4 (PGTH/~FLT_1), IC17.12 (PGTH/~FLT_2), R81.2, R82.2
OCS: IC17.3 (PG/_SPLYGD)
VIN: C96.2, C97.2, IC17.5 (IN), R76.2, R78.2
VOUT: C100.2, C101.1, D4.1, IC17.6 (OUT), R81.1
