lincvv/kicad_space/Projects/Design/nti/dock_rs232/USB2514B_M2.kicad_sch

## KiCad design Projects/Design/nti/dock_rs232/USB2514B_M2.kicad_sch (2024-06-23)


Parts:
C5, C8, C9, C10, C11, C12, C13, C18, C19: 0.1uF 16V 0402; C_0402_1005Metric; Manufacturer_Part_Number GRM155R71C104KA88D; Mouser Part Number N/A
C6, C7: 10pF 50V 2% 0402; C_0402_1005Metric; Manufacturer_Part_Number GJM1555C1H100GB01D; Mouser Part Number 81-GJM1555C1H100GB01
C14, C20: 4.7uF 6.3V 0402; C_0402_1005Metric; Manufacturer_Part_Number GRM155R60J475ME47D; Mouser Part Number 81-GRM155R60J475ME7D
C15, C16: 0.01uF 10V 0402; C_0402_1005Metric; Manufacturer_Part_Number 0402ZC103MAT2A; Mouser Part Number 581-0402ZC103MAT2A
C17: 1uF 0402 25V X5R; C_0402_1005Metric; Manufacturer_Part_Number GRM155R61E105KA12D; Mouser Part Number 81-GRM155R61E105KA2D
FB1: BLM15PG100SZ1D; NFZ15SG152SN10B; Manufacturer_Part_Number BLM15PG100SZ1D; Mouser Part Number 81-BLM15PG100SZ1D
IC2: MIC803-29D4VC3-TR; SOT65P210X100-3N; Manufacturer_Part_Number MIC803-29D4VC3-TR; Mouser Part Number 998-MIC803-29D4VC3TR
IC3: USB2514B_M2; QFN50P600X600X100-37N-D; Manufacturer_Part_Number USB2514B/M2; Mouser Part Number 579-USB2514B/M2
R2, R6, R7, R9, R10, R11: 10K 0402 1%; R_0402_1005Metric; Manufacturer_Part_Number AC0402FR-0710KL; Mouser Part Number 603-AC0402FR-0710KL
R8, R12, R13, R14, R16, R17: 100K 0402 1% 1/16W; R_0402_1005Metric; Manufacturer_Part_Number SFR01MZPF1003; Mouser Part Number 755-SFR01MZPF1003
R15: 12K 1% 0402; R_0402_1005Metric; Manufacturer_Part_Number ERJ-U02F1202X
Y1: ABM8G-24.000MHZ-4Y-T3; ABM8G48000MHZ18D2YT; Manufacturer_Part_Number ABM8G-24.000MHZ-4Y-T3; Mouser Part Number 815-ABM8G-24-4YT3

Connections:
+3V3: C12.2, C13.2, C20.2, FB1.2, IC2.3 (VCC), IC3.15 (VDD33_1), IC3.23 (VDD33_2), R2.2, R6.2, R7.2, R8.2, R9.2, R10.2, R11.2, R13.1
BC_EN4: IC3.20 (PRTPWR4/BC_EN4), R2.1
CFG_SEL0: IC3.24 (SCL/SMBCLK/CFG_SEL0), R13.2, R14.1
CFG_SEL1: IC3.25 (HS_IND/CFG_SEL1), R11.1, R12.1
CRFILT: C16.2, C19.2, IC3.14 (CRFILT)
GND: C5.1, C6.1, C7.1, C8.1, C9.1, C10.1, C11.1, C12.1, C13.1, C14.1, C15.1, C16.1, C17.1, C18.1, C19.1, C20.1, IC2.1 (GND), IC3.11 (TEST), IC3.37 (EP), R12.2, R14.2, R15.1, R16.2, Y1.2 (GND_1), Y1.4 (GND_2)
HUB_RST_N: C5.2, IC2.2 (~RESET), IC3.26 (RESET_N), R8.1
NON_REM0: IC3.28 (SUSP_IND/LOCAL_PWR/NON_REM0), R6.1
NON_REM1: IC3.22 (SDA/SMBDATA/NONREM1), R7.1
unnamed: C6.2, IC3.32 (XTALOUT), Y1.1 (CRYSTAL_1)
unnamed: C7.2, IC3.33 (XTALIN/CLKIN), Y1.3 (CRYSTAL_2)
PLLFILT: C15.2, C18.2, IC3.34 (PLLFILT)
RBIAS: IC3.35 (RBIAS), R15.2
USBDN1_N: IC3.1 (USBDM_DN1/PRT_DIS_M1)
USBDN1_P: IC3.2 (USBDP_DN1/PRT_DIS_P1)
USBDN2_N: IC3.3 (USBDM_DN2/PRT_DIS_M2)
USBDN2_P: IC3.4 (USBDP_DN2/PRT_DIS_P2)
USBDN3_N: IC3.6 (USBDM_DN3/PRT_DIS_M3)
USBDN3_P: IC3.7 (USBDP_DN3/PRT_DIS_P3)
USBDN4_N: IC3.8 (USBDM_DN4/PRT_DIS_M4), R10.1
USBDN4_P: IC3.9 (USBDP_DN4/PRT_DIS_P4), R9.1
USBUP_N: IC3.30 (USBDM_UP)
USBUP_P: IC3.31 (USBDP_UP)
VBUS_DET: IC3.27 (VBUS_DET), R16.1, R17.2
VBUS_UP: C17.2, R17.1
VDDA33: C8.2, C9.2, C10.2, C11.2, C14.2, FB1.1, IC3.5 (VDDA33_1), IC3.10 (VDDA33_2), IC3.29 (VDDA33_3), IC3.36 (VDDA33_4)

Notes on the sheet:
CONFIGURING THE STRAP PINS
