lincvv/kicad_space/Projects/Design/nti/dock_rs232/dock_T800_v3.kicad_sch

## KiCad design Projects/Design/nti/dock_rs232/dock_T800_v3.kicad_sch (2024-06-23)


Parts:
C1, C3: 10nF 50V 0603; C_0603_1608Metric; Manufacturer_Part_Number 885012206089; Mouser Part Number 710-885012206089
C2, C4: 0.1uF 50V 0603; C_0603_1608Metric; Manufacturer_Part_Number 06035C104MAT2A; Mouser Part Number 581-06035C104MAT2A
D2: DF2S6P2FU,H3F; SOD2513X115N; Mouser Part Number 757-DF2S6P2FUH3F
F1: 5A 0603; Fuse_0603_1608Metric; Manufacturer_Part_Number 0ABB-5000-TM; Mouser Part Number 530-0ABB-5000-TM
IC1: ECMF02-2AMX6; SON50P150X170X55-6N-D; Manufacturer_Part_Number ECMF02-2AMX6; Mouser Part Number 511-ECMF02-2AMX6
P1: P16_GPIO; TestPoint_THTPad_D1.0mm_Drill0.5mm
P2, P3, P5, P6, P8, P9, P10, P11, P12: NC; TestPoint_THTPad_D1.0mm_Drill0.5mm
P4: P24_GND; TestPoint_THTPad_D1.0mm_Drill0.5mm
P7: NC'; TestPoint_THTPad_D1.0mm_Drill0.5mm
P13: P13_GND; TestPoint_THTPad_D1.0mm_Drill0.5mm
P14: P12_GND; TestPoint_THTPad_D1.0mm_Drill0.5mm
P15: P21_5V_DOCK; TestPoint_THTPad_D1.0mm_Drill0.5mm
P16: P14_USB2_N; TestPoint_THTPad_D1.0mm_Drill0.5mm
P17: P15_USB2_P; TestPoint_THTPad_D1.0mm_Drill0.5mm
P18: P22_DOCK_IN_DET; TestPoint_THTPad_D1.0mm_Drill0.5mm
P19: P17_19V_IN; TestPoint_THTPad_D1.0mm_Drill0.5mm
P20: P18_19V_IN; TestPoint_THTPad_D1.0mm_Drill0.5mm
P21: P1_USB3_TX_N; TestPoint_THTPad_D1.0mm_Drill0.5mm
P22: P2_USB3_TX_P; TestPoint_THTPad_D1.0mm_Drill0.5mm
P23: P3_USB3_RX_P; TestPoint_THTPad_D1.0mm_Drill0.5mm
P24: P4_USB3_RX_N; TestPoint_THTPad_D1.0mm_Drill0.5mm
TP1: 8-24V; TestPoint_THTPad_2.5x2.5mm_Drill1.2mm
TP2: RS-232-1; PinHeader_1x04_P2.54mm_Vertical
TP3: RS-232-2; PinHeader_1x05_P2.54mm_Vertical
TP4: LAN; PinHeader_1x05_P2.00mm_Vertical
TP5: GND; TestPoint_THTPad_2.5x2.5mm_Drill1.2mm
TP6: 19V; TestPoint_THTPad_2.5x2.5mm_Drill1.2mm

Connections:
5V_UP: C3.2, C4.2, D2.1, F1.1, P15.1
8-24V: TP1.1
19V: TP6.1
19V_CHARGE: C1.2, C2.2, P19.1, P20.1
DOCK_IN: P18.1
GND: C1.1, C2.1, C3.1, C4.1, D2.2, IC1.3 (GND), P4.1, P13.1, P14.1, TP3.5, TP5.1
GND_LAN: TP4.5
RD_N: TP4.2
RD_P: TP4.1
RS232_P1_CTS: TP2.4
RS232_P1_RTS: TP2.3
RS232_P1_RXD: TP2.1
RS232_P1_TXD: TP2.2
RS232_P2_CTS: TP3.3
RS232_P2_RTS: TP3.4
RS232_P2_RXD: TP3.2
RS232_P2_TXD: TP3.1
TD_N: TP4.4
TD_P: TP4.3
USB2UP_N: IC1.5 (D-), P16.1
USB2UP_P: IC1.6 (D+), P17.1
USBUP_N: IC1.2 (D_2)
USBUP_P: IC1.1 (D_1)
VBUS_UP: F1.2
