lincvv/kicad_space/Projects/Design/nti/dock_rs232/dock_rs232_prt.kicad_sch

## KiCad design Projects/Design/nti/dock_rs232/dock_rs232_prt.kicad_sch (2024-06-23)

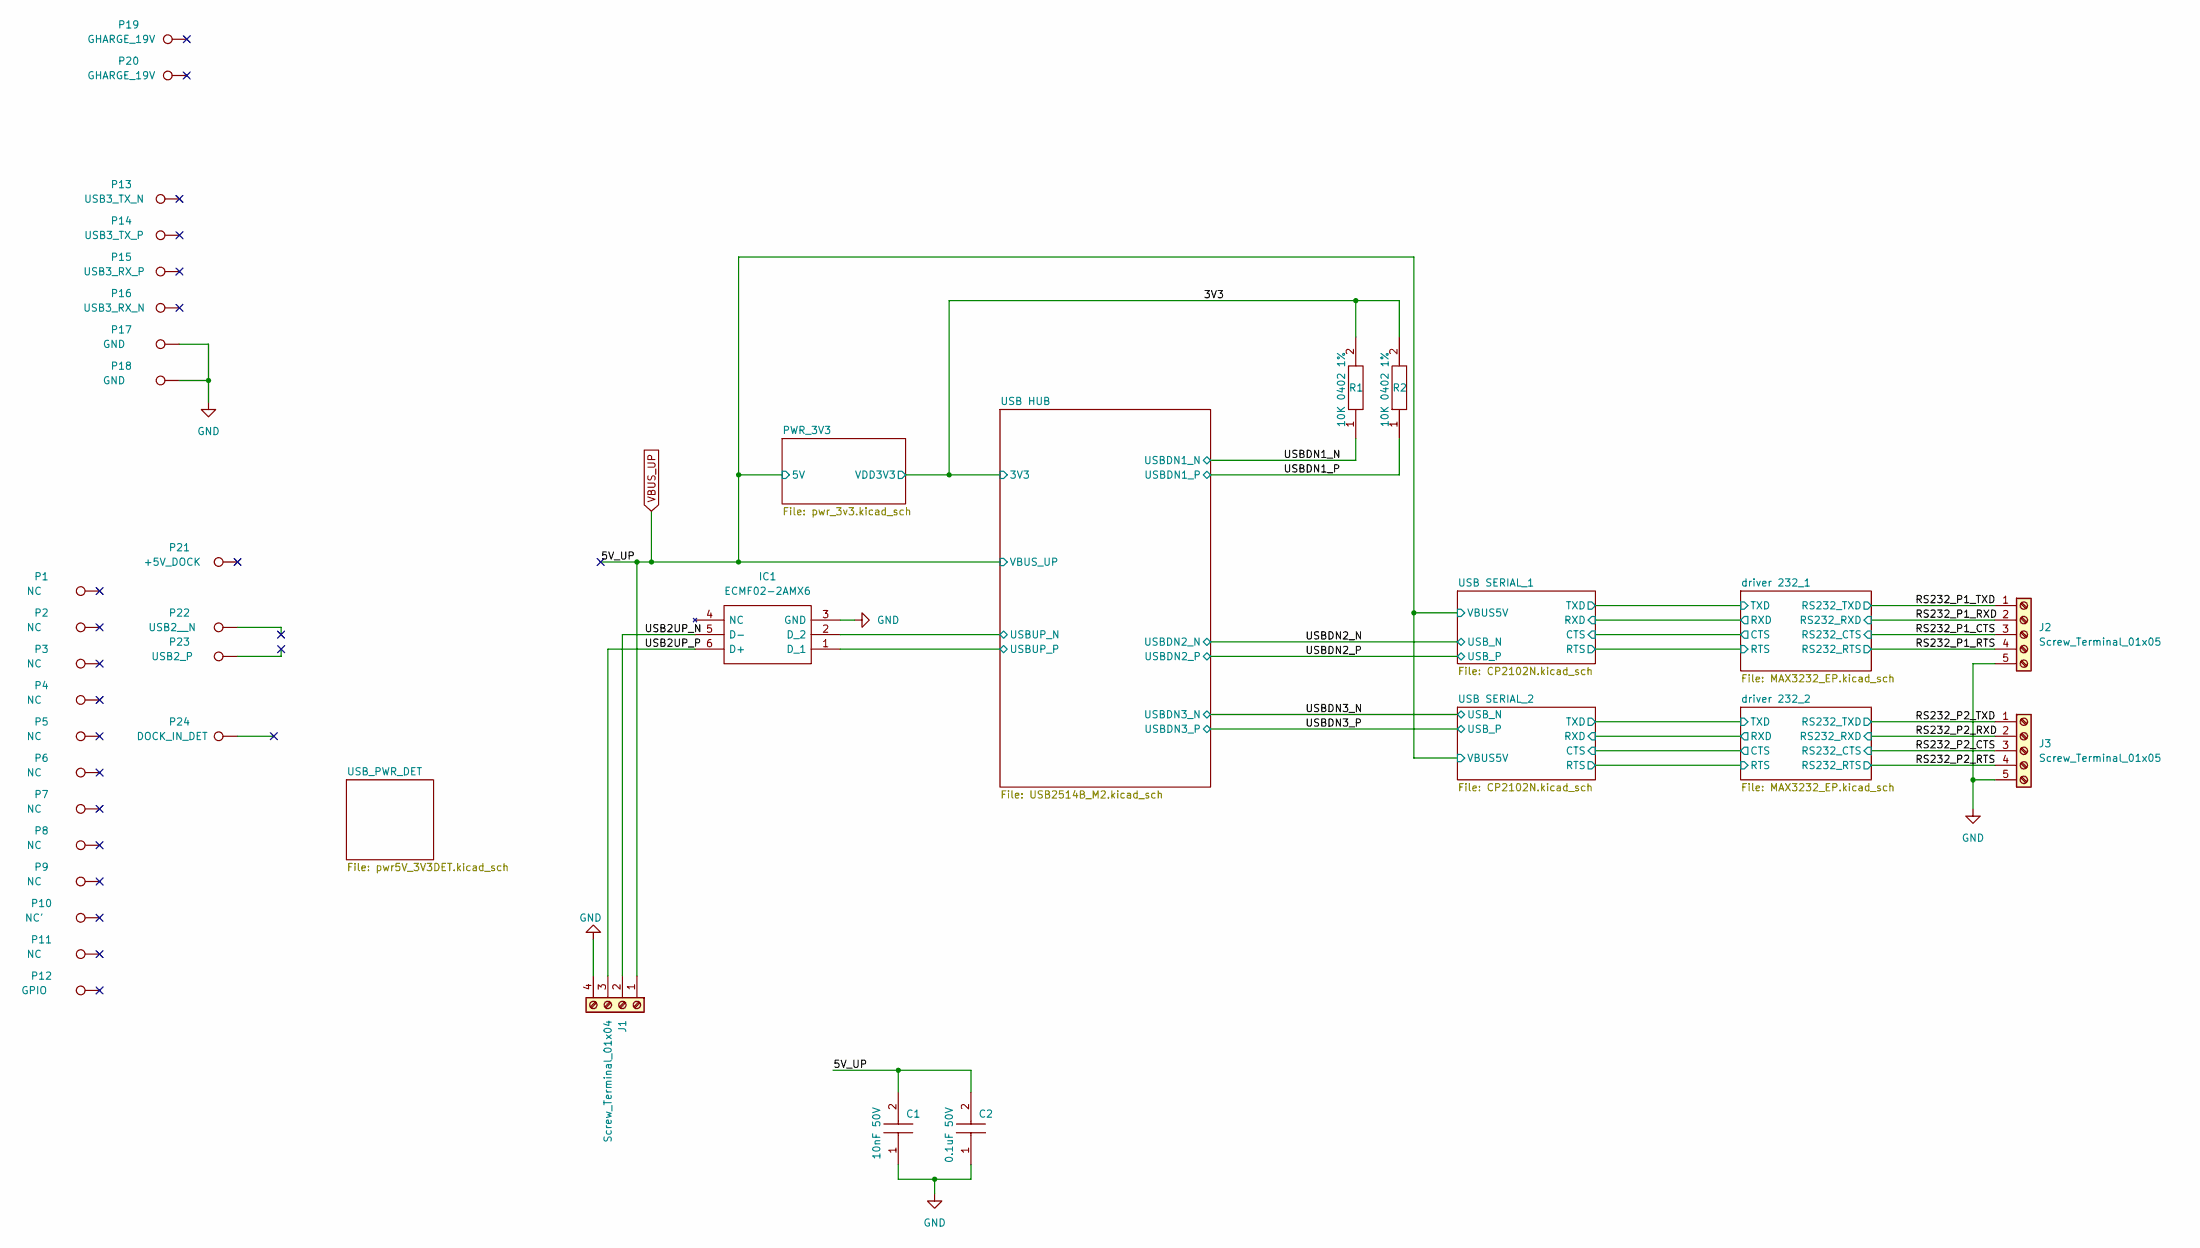
[picture p100: schematic dock_rs232_prt.kicad_sch]

Parts:
C1: 10nF 50V; C_0603_1608Metric; Manufacturer_Part_Number 885012206089; Mouser Part Number 710-885012206089
C2: 0.1uF 50V; C_0603_1608Metric; Manufacturer_Part_Number 06035C104MAT2A; Mouser Part Number 581-06035C104MAT2A
IC1: ECMF02-2AMX6; SON50P150X170X55-6N-D; Manufacturer_Part_Number ECMF02-2AMX6; Mouser Part Number 511-ECMF02-2AMX6
J1: Screw_Terminal_01x04; PinHeader_1x04_P2.00mm_Vertical
J2, J3: Screw_Terminal_01x05; PinHeader_1x05_P2.00mm_Vertical
P1, P2, P3, P4, P5, P6, P7, P8, P9, P11: NC; TestPoint_Pad_1.5x1.5mm
P10: NC'; TestPoint_Pad_1.5x1.5mm
P12: GPIO; TestPoint_Pad_1.5x1.5mm
P13: USB3_TX_N; TestPoint_Pad_1.5x1.5mm
P14: USB3_TX_P; TestPoint_Pad_1.5x1.5mm
P15: USB3_RX_P; TestPoint_Pad_1.5x1.5mm
P16: USB3_RX_N; TestPoint_Pad_1.5x1.5mm
P17, P18: GND; TestPoint_Pad_1.5x1.5mm
P19, P20: GHARGE_19V; TestPoint_Pad_1.5x1.5mm
P21: +5V_DOCK; TestPoint_Pad_1.5x1.5mm
P22: USB2__N; TestPoint_Pad_1.5x1.5mm
P23: USB2_P; TestPoint_Pad_1.5x1.5mm
P24: DOCK_IN_DET; TestPoint_Pad_1.5x1.5mm
R1, R2: 10K 0402 1%; R_0402_1005Metric; Manufacturer_Part_Number AC0402FR-0710KL; Mouser Part Number 603-AC0402FR-0710KL

Connections:
3V3: R1.2, R2.2
GND: C1.1, C2.1, IC1.3 (GND), J1.4, J2.5, J3.5, P17.1, P18.1
RS232_P1_CTS: J2.3
RS232_P1_RTS: J2.4
RS232_P1_RXD: J2.2
RS232_P1_TXD: J2.1
RS232_P2_CTS: J3.3
RS232_P2_RTS: J3.4
RS232_P2_RXD: J3.2
RS232_P2_TXD: J3.1
USB2UP_N: IC1.5 (D-), J1.2
USB2UP_P: IC1.6 (D+), J1.3
USBDN1_N: R1.1
USBDN1_P: R2.1
USBUP_N: IC1.2 (D_2)
USBUP_P: IC1.1 (D_1)
VBUS_UP: C1.2, C2.2, J1.1
