lincvv/kicad_space/Projects/Design/nti/dock_rs232/pwr5V_3V3DET.kicad_sch

## KiCad design Projects/Design/nti/dock_rs232/pwr5V_3V3DET.kicad_sch (2024-06-23)

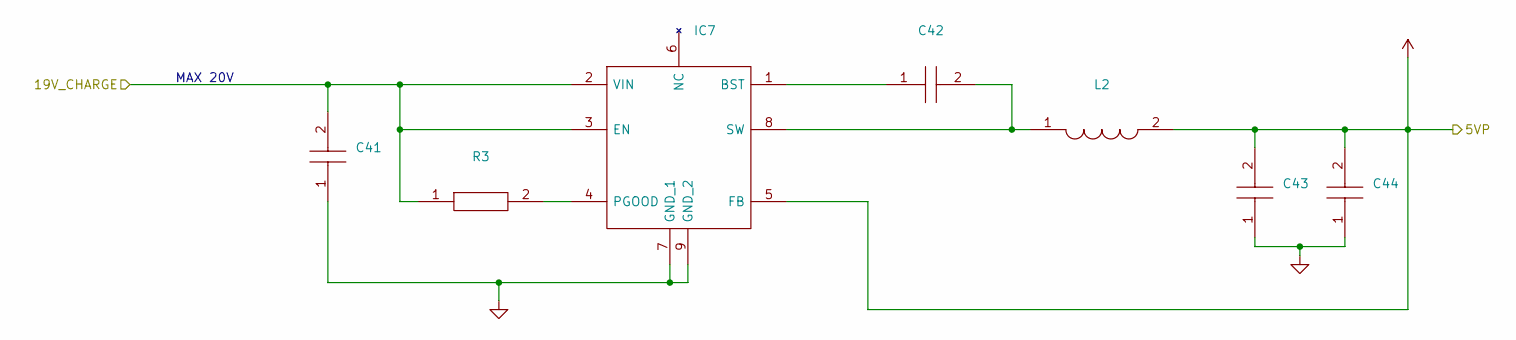
[picture p101: schematic pwr5V_3V3DET.kicad_sch]

Parts:
C41: Manufacturer_Part_Number CNC5L1X7R1E106K160AE; Mouser Part Number 810-CNC5LX7R1E106K16
C42: Manufacturer_Part_Number 06035C104MAT2A; Mouser Part Number 581-06035C104MAT2A
C43: Manufacturer_Part_Number GRM21BC81C226ME44L; Mouser Part Number 81-GRM21BC81C226ME4L
C44: Manufacturer_Part_Number GRM21BC81C226ME44L; Mouser Part Number 81-GRM21BC81C226ME4L
IC7: Manufacturer_Part_Number ADP2303ARDZ-5.0-R7; Mouser Part Number 584-ADP2303ARDZ5.0R7
L2: Manufacturer_Part_Number NS10155T6R8NNA; Mouser Part Number 963-NS10155T6R8NNA
R3: Manufacturer_Part_Number ERJ-3GEYJ104V; Mouser Part Number 667-ERJ-3GEYJ104V

Connections:
19V_CHARGE: C41.2, IC7.2 (VIN), IC7.3 (EN), R3.1
unnamed: C42.1, IC7.1 (BST)
unnamed: C42.2, IC7.8 (SW), L2.1
unnamed: IC7.4 (PGOOD), R3.2
~: C41.1, C43.1, C43.2, C44.1, C44.2, IC7.5 (FB), IC7.7 (GND_1), IC7.9 (GND_2), L2.2

Notes on the sheet:
MAX 20V
