lincvv/kicad_space/Projects/Design/nti/dock_rs232/pwr_3v3.kicad_sch

## KiCad design Projects/Design/nti/dock_rs232/pwr_3v3.kicad_sch (2024-06-23)


Parts:
C34: 10uF 10V 0805; C_0805_2012Metric; Manufacturer_Part_Number LMK212ABJ106KG8T; Mouser Part Number 963-LMK212ABJ106KG8T
C35: 22pF 50V 0402 10%; C_0402_1005Metric; Manufacturer_Part_Number C0402C220K5RACTU; Mouser Part Number 80-C0402C220K5RACTU
C36, C37: 22uF 6.3V 0603 20%; C_0603_1608Metric; Manufacturer_Part_Number GRM188R60J226MEA0D; Mouser Part Number 81-GRM188R60J226ME0D
IC6: AP3441SHE-7B; SON50P201X201X60-9N-D; Manufacturer_Part_Number AP3441SHE-7B; Mouser Part Number 621-AP3441SHE-7B
L1: 2.2uH 2.2A; DFE2HCAH1R0MJ0L; Manufacturer_Part_Number 1239AS-H-2R2M=P2; Mouser Part Number 81-1239AS-H-2R2MP2
R28: 10K 0402 1%; R_0402_1005Metric; Manufacturer_Part_Number AC0402FR-0710KL; Mouser Part Number 603-AC0402FR-0710KL
R29: 100K 0402 1% 1/16W; R_0402_1005Metric; Manufacturer_Part_Number SFR01MZPF1003; Mouser Part Number 755-SFR01MZPF1003
R30: 95.3K 0402 1% 1/10W; R_0402_1005Metric; Manufacturer_Part_Number ERJ-U02F9532X; Mouser Part Number 667-ERJ-U02F9532X
R31: 430K 0402 1% 1/10W; R_0402_1005Metric; Manufacturer_Part_Number ERJ-U02F4303X

Connections:
+3V3: C35.2, C36.2, C37.2, L1.2, R31.2
+5V: C34.2, IC6.3 (VIN), R28.1, R29.1
FB: C35.1, IC6.1 (FB), R30.2, R31.1
GND: C34.1, C36.1, C37.1, IC6.4 (PGND), IC6.8 (SGND), IC6.9 (EP), R30.1
LX: IC6.6 (LX), L1.1
unnamed: IC6.2 (PG), R29.2
unnamed: IC6.7 (EN), R28.2
