lincvv/kicad_space/Projects/Design/nti/dock_rs232/pwr_sys16.kicad_sch

## KiCad design Projects/Design/nti/dock_rs232/pwr_sys16.kicad_sch (2024-06-23)

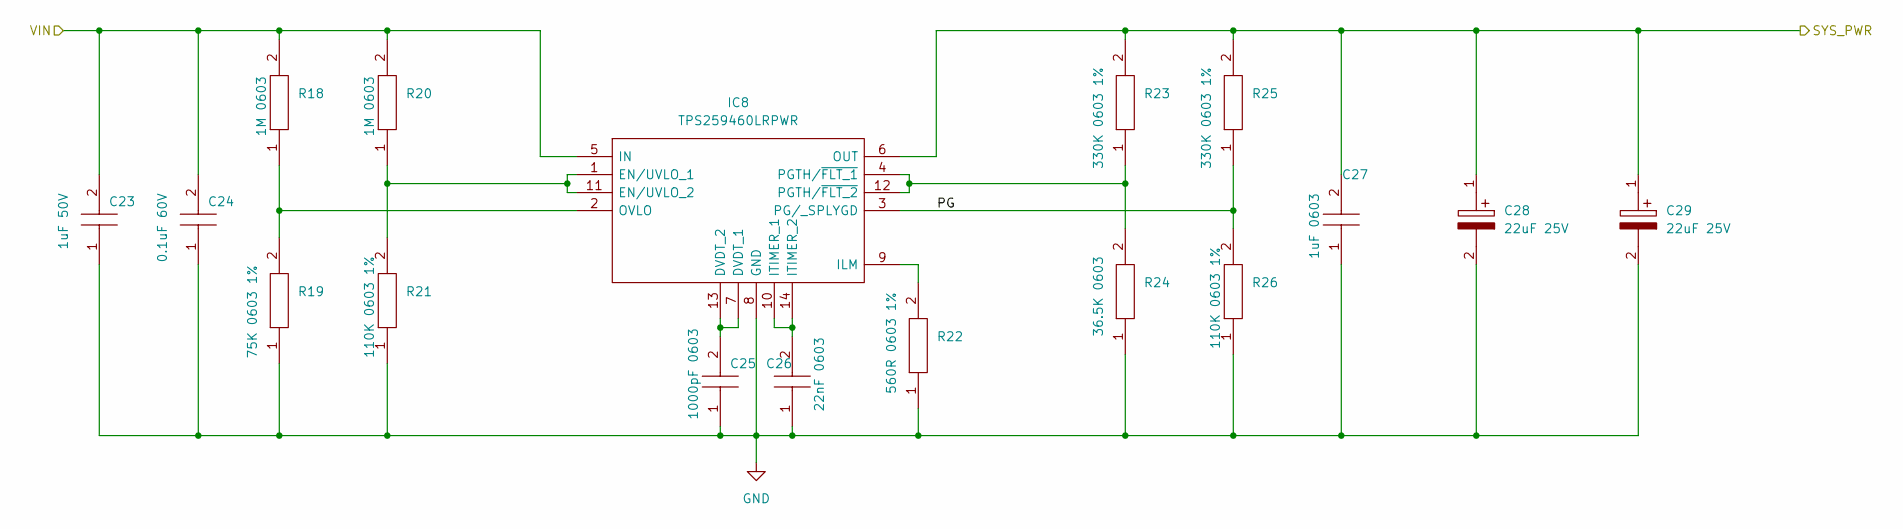
[picture p102: schematic pwr_sys16.kicad_sch]

Parts:
C23: 1uF 50V; C_0603_1608Metric; Manufacturer_Part_Number 06035C105KAT2A; Mouser Part Number 581-06035C105KAT2A
C24: 0.1uF 60V; C_0603_1608Metric; Manufacturer_Part_Number 06035C104K4Z2A; Mouser Part Number 581-06035C104K4Z2A
C25: 1000pF 0603; C_0603_1608Metric; Manufacturer_Part_Number VJ0603Y102KXAAP; Mouser Part Number 77-VJ0603Y102KXAAP
C26: 22nF 0603; C_0603_1608Metric; Manufacturer_Part_Number 885382206003; Mouser Part Number 710-885382206003
C27: 1uF 0603; C_0603_1608Metric; Manufacturer_Part_Number 06035C105KAT2A; Mouser Part Number 581-06035C105KAT2A
C28, C29: 22uF 25V; CAPPM3528X200N; Manufacturer_Part_Number T521B226M025ATE1007280; Mouser Part Number 80-T521B226M25E100LR
IC8: TPS259460LRPWR; Manufacturer_Part_Number TPS259460ARPWR
R18, R20: 1M 0603; R_0603_1608Metric; Manufacturer_Part_Number RC0603FR-071ML; Mouser Part Number 603-RC0603FR-071ML
R19: 75K 0603 1%; R_0603_1608Metric; Manufacturer_Part_Number CR0603-FX-7502ELF; Mouser Part Number 652-CR0603FX-7502ELF
R21, R26: 110K 0603 1%; R_0603_1608Metric; Manufacturer_Part_Number ERJ-3EKF1103V; Mouser Part Number 667-ERJ-3EKF1103V
R22: 560R 0603 1%; R_0603_1608Metric; Manufacturer_Part_Number CR0603-FX-5600ELF; Mouser Part Number 652-CR0603FX-5600ELF
R23, R25: 330K 0603 1%; R_0603_1608Metric; Manufacturer_Part_Number CR0603-FX-3303ELF; Mouser Part Number 652-CR0603FX-3303ELF
R24: 36.5K 0603; R_0603_1608Metric; Manufacturer_Part_Number CR0603-FX-3652ELF

Connections:
GND: C23.1, C24.1, C25.1, C26.1, C27.1, C28.2, C29.2, IC8.8 (GND), R19.1, R21.1, R22.1, R24.1, R26.1
unnamed: C25.2, IC8.7 (DVDT_1), IC8.13 (DVDT_2)
unnamed: C26.2, IC8.10 (ITIMER_1), IC8.14 (ITIMER_2)
unnamed: IC8.1 (EN/UVLO_1), IC8.11 (EN/UVLO_2), R20.1, R21.2
unnamed: IC8.2 (OVLO), R18.1, R19.2
unnamed: IC8.9 (ILM), R22.2
unnamed: IC8.4 (PGTH/~FLT_1), IC8.12 (PGTH/~FLT_2), R23.1, R24.2
PG: IC8.3 (PG/_SPLYGD), R25.1, R26.2
SYS_PWR: C27.2, C28.1, C29.1, IC8.6 (OUT), R23.2, R25.2
VIN: C23.2, C24.2, IC8.5 (IN), R18.2, R20.2
