lincvv/kicad_space/Projects/Design/nti/dock_rs232/pwr_usb.kicad_sch

## KiCad design Projects/Design/nti/dock_rs232/pwr_usb.kicad_sch (2024-06-23)

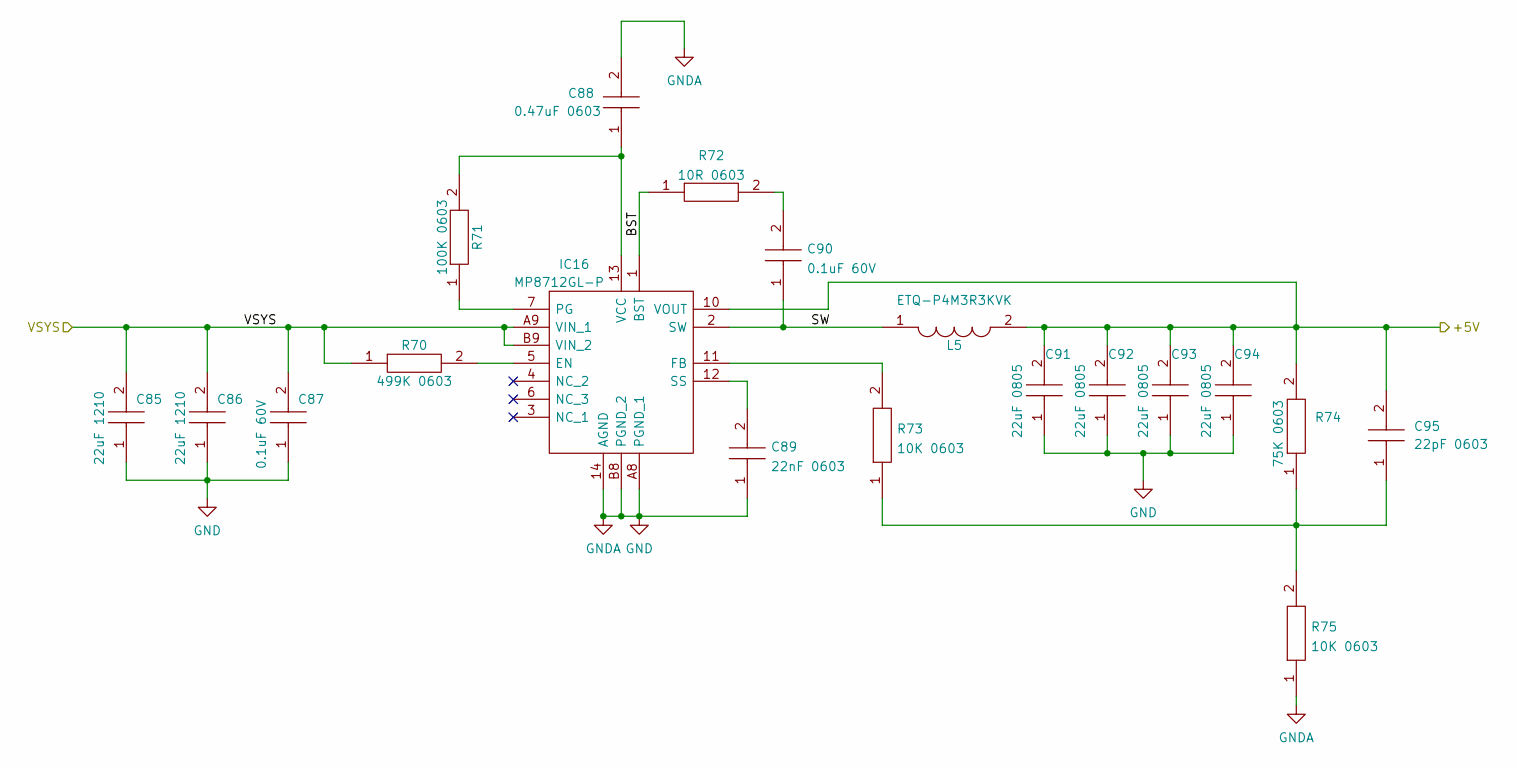
[picture p103: schematic pwr_usb.kicad_sch]

Parts:
C85, C86: 22uF 1210; C_1210_3225Metric; Manufacturer_Part_Number CNC6P1X7R1E226M250AE; Mouser Part Number 810-CNC6PX7R1E226M25
C87, C90: 0.1uF 60V; C_0603_1608Metric; Manufacturer_Part_Number 06035C104K4Z2A; Mouser Part Number 581-06035C104K4Z2A
C88: 0.47uF 0603; C_0603_1608Metric; Manufacturer_Part_Number 06035C474KAT2A; Mouser Part Number 581-06035C474KAT2A
C89: 22nF 0603; C_0603_1608Metric; Manufacturer_Part_Number 885382206003; Mouser Part Number 710-885382206003
C91, C92, C93, C94: 22uF 0805; C_0805_2012Metric; Manufacturer_Part_Number GRM21BR61E226ME44L; Mouser Part Number 81-GRM21BR61E226ME4L
C95: 22pF 0603; C_0603_1608Metric; Manufacturer_Part_Number 06035C220JAT2A; Mouser Part Number 581-06035C220JAT2A
IC16: MP8712GL-P; MP8712GLP; Manufacturer_Part_Number MP8712GL-P; Mouser Part Number 946-MP8712GL-P
L5: ETQ-P4M3R3KVK; ETQ-P4M_KVK; Manufacturer_Part_Number ETQ-P4M3R3KVK; Mouser Part Number 667-ETQ-P4M3R3KVK
R70: 499K 0603; R_0603_1608Metric; Manufacturer_Part_Number CRCW0603499KFKTA; Mouser Part Number 71-CRCW0603-499K
R71: 100K 0603; R_0603_1608Metric; Manufacturer_Part_Number ERJ-H3ED1003V
R72: 10R 0603; R_0603_1608Metric; Manufacturer_Part_Number CRGCQ0603F10R; Mouser Part Number 279-CRGCQ0603F10R
R73, R75: 10K 0603; R_0603_1608Metric; Manufacturer_Part_Number CRCW060310K0FKEAC; Mouser Part Number 71-CRCW060310K0FKEAC
R74: 75K 0603; R_0603_1608Metric; Manufacturer_Part_Number RCS060375K0FKEA; Mouser Part Number 71-RCS060375K0FKEA

Connections:
+5V: C91.2, C92.2, C93.2, C94.2, C95.2, IC16.10 (VOUT), L5.2, R74.2
BST: IC16.1 (BST), R72.1
GND: C85.1, C86.1, C87.1, C88.2, C89.1, C91.1, C92.1, C93.1, C94.1, IC16.14 (AGND), IC16.A8 (PGND_1), IC16.B8 (PGND_2), R75.1
unnamed: C88.1, IC16.13 (VCC), R71.2
unnamed: C89.2, IC16.12 (SS)
unnamed: C90.2, R72.2
unnamed: C95.1, R73.1, R74.1, R75.2
unnamed: IC16.5 (EN), R70.2
unnamed: IC16.7 (PG), R71.1
unnamed: IC16.11 (FB), R73.2
SW: C90.1, IC16.2 (SW), L5.1
VSYS: C85.2, C86.2, C87.2, IC16.A9 (VIN_1), IC16.B9 (VIN_2), R70.1
