lincvv/kicad_space/Projects/Design/nti/dock_rs232/usb_cn.kicad_sch

## KiCad design Projects/Design/nti/dock_rs232/usb_cn.kicad_sch (2024-06-23)

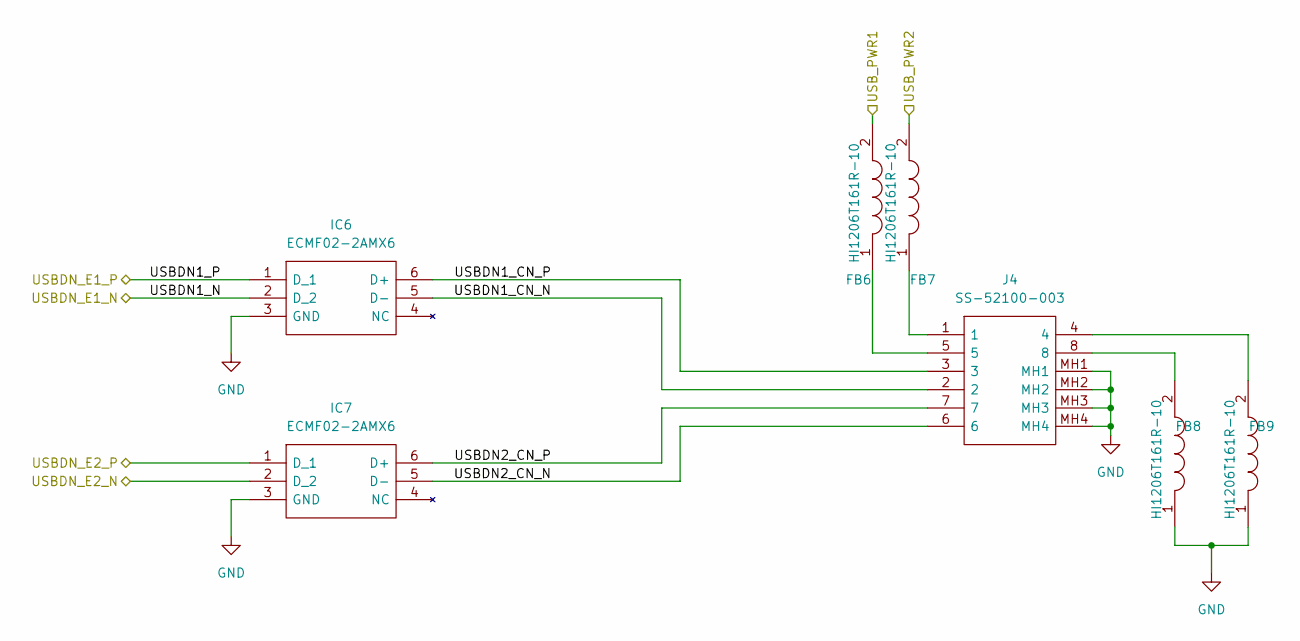
[picture p104: schematic usb_cn.kicad_sch]

Parts:
FB6, FB7, FB8, FB9: HI1206T161R-10; BEADC3216X180N; Manufacturer_Part_Number HI1206T161R-10
IC6, IC7: ECMF02-2AMX6; SON50P150X170X55-6N-D; Manufacturer_Part_Number ECMF02-2AMX6; Mouser Part Number 511-ECMF02-2AMX6
J4: SS-52100-003; SS52100003; Manufacturer_Part_Number SS-52100-003; Mouser Part Number 530-SS-52100-003

Connections:
GND: FB8.1, FB9.1, IC6.3 (GND), IC7.3 (GND), J4.MH1, J4.MH2, J4.MH3, J4.MH4
unnamed: FB6.1, J4.5
unnamed: FB7.1, J4.1
unnamed: FB8.2, J4.8
unnamed: FB9.2, J4.4
USBDN1_CN_N: IC6.5 (D-), J4.2
USBDN1_CN_P: IC6.6 (D+), J4.3
USBDN1_N: IC6.2 (D_2)
USBDN1_P: IC6.1 (D_1)
USBDN2_CN_N: IC7.5 (D-), J4.6
USBDN2_CN_P: IC7.6 (D+), J4.7
USBDN_E2_N: IC7.2 (D_2)
USBDN_E2_P: IC7.1 (D_1)
USB_PWR1: FB6.2
USB_PWR2: FB7.2
