lincvv/kicad_space/Resources/lib_kicad/M.2-Card-Footprints-main/M.2-Card-Footprints-main/M.2-Templates (# Name clash 2023-07-30 df2uigC #).sch

## EAGLE design Resources/lib_kicad/M.2-Card-Footprints-main/M.2-Card-Footprints-main/M.2-Templates (# Name clash 2023-07-30 df2uigC #).sch (2024-06-23)

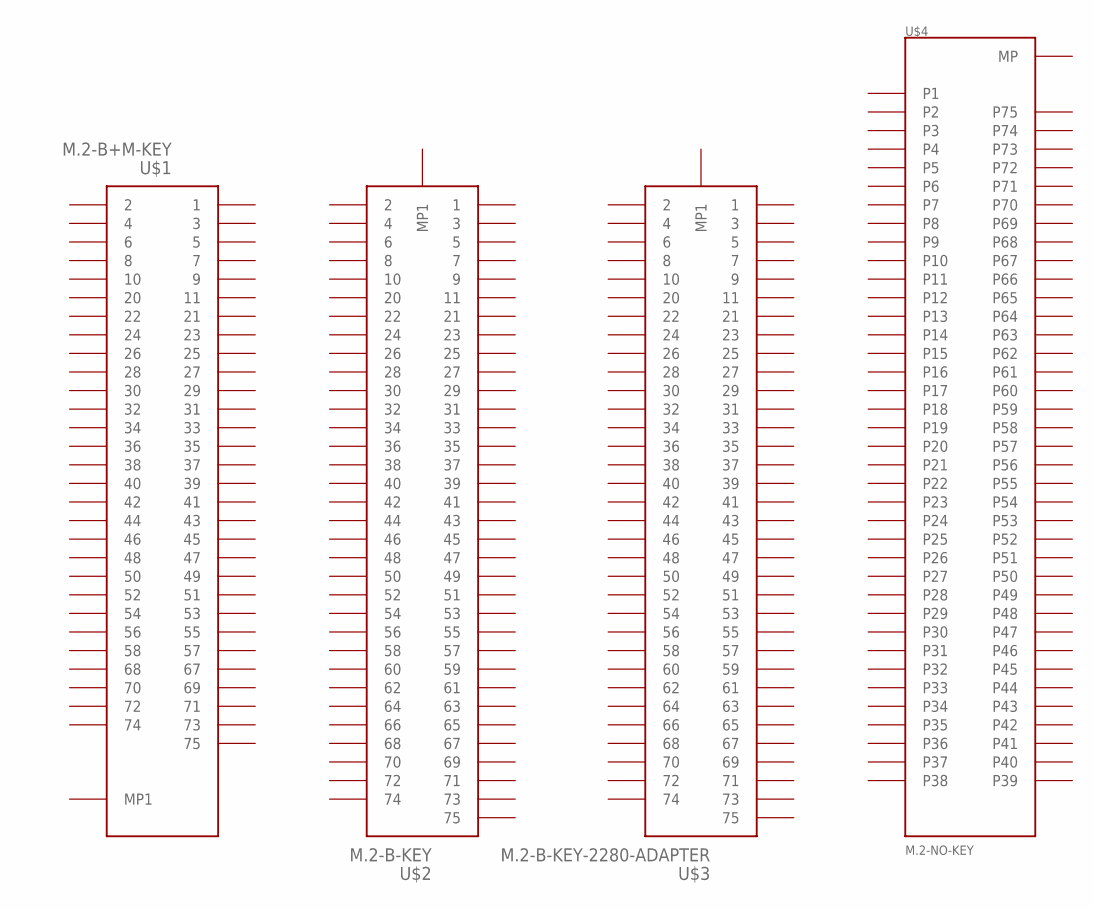
[picture p105: schematic M.2-Templates (# Name clash 2023-07-30 df2uigC #).sch]

Parts:
U$1: M.2-B+M-KEY
U$2: M.2-B-KEY
U$3: M.2-B-KEY-2280-ADAPTER
U$4: M.2-NO-KEY; M.2-KEY-BLANK
